Kevin-Kaiyo/open-microled-driver-asic/docs/design.md

# 单像素电路与 PWM：从教学基线到 v0.4 联合信号模型

更新：2026-10-05。当前尺寸为 mirror 20/4 µm、registered PWM。本页解释 synthetic LED 基本回归，同时指向逐级增强的模型：真实静态负载、reference/mismatch、模拟／数字physical、v0.3共同macro top，及v0.4[联合signal PEX](research/joint-pex.md)与[电气边界](research/robustness.md)。分层解释见[研究报告](research/research-report.md)，实物目标见[bench计划](research/bench-validation-plan.md)，方向见[实验方法与研究价值](research/technical-value-market.md)。

基本回归已经建立可重复执行的链：**真实RTL输出 → 电压波形桥接 → pre-layout PDK driver → synthetic LED → 波形与电流积分**。v0.4进一步用共同GDS提取的输出级／像素联合模型检查signal路径。两者仍是feed-forward coupled simulation；模拟结果没有反馈改变RTL状态。“完整链路”表示数字控制确实驱动电路，不表示feedback或双向mixed-signal co-simulation。

## v0.4 为什么用一份联合模型

实际共同GDS中，PWM从模拟macro的M3右侧接入；standalone analog RC的formal `pwm`位于左侧。若继续把右侧跨宏线接到旧左侧cut boundary，可能把同一段metal重复串联。v0.4从真实geometry重新提取末级`output12/buf_2`六MOS及像素六MOS，导出单个`output_pixel_pex`：nominal为12MOS、45 signal R、77显式C、34个邻居端口；另有四种actual RCstyle。

Post只实例化这份joint model，**不再叠加旧buf schematic、SPEF、link RC或analog RC**。输出级实际AD／AS／PD／PS交给MOS model计算junction charge；导体R/C按实际端点及重数记录。重现按端口、数值与拓扑的语义一致性判断，工具排序不同不应伪称字节一致。[提取与投影说明](research/joint-pex.md)保留完整原始网表与ledger。

该模型将所有PG／body电阻及PG-only电容投影到理想VDD/VSS，保留signal↔PG电容。邻居的stiff clamp等截断是实验条件，未包含其完整driver阻抗。因此startup源能量只覆盖声明的selected signal-path十二MOS与外部R/C假设，不是完整芯片供电、well/substrate、decap或preceding logic能量。实reference、真实LED动态／温度、实际PG与邻居仍是进入4×4前的工作。

设计参数以仓库代码为主来源：[`pixel_driver.spice`](../analog/driver/pixel_driver.spice)、[`microled.spice`](../analog/models/microled.spice)、[`pixel_pwm.v`](../rtl/pixel_pwm.v) 和 [`run_phase1.py`](../scripts/run_phase1.py)。当前运行证据见 [`summary.json`](../evidence/phase1/summary.json)，具体条件、检查及工具版本从该文件读取，不由此文档另行维护通过数量。模型适用条件、计算复核和后续研究门槛见 [全面检阅](review/README.md)。

## 教学 baseline 的系统

```mermaid
flowchart LR
    subgraph D[已实现：数字域]
        C[1 MHz clock / reset / duty / enable]
        R[Verilog 1-pixel PWM]
        E[执行 RTL 后的 edge CSV]
        C --> R --> E
    end
    subgraph B[已实现：testbench 桥接]
        P[0 / 3.3 V PWL<br/>10 ns finite edge]
        REF[外部 ideal IREF<br/>100 µA]
        SUP[ideal rails<br/>VLED 5 V / Vlogic 3.3 V]
        E --> P
    end
    subgraph A[已实现：pre-layout analog]
        G[6-MOS pixel cell<br/>GF180MCU 6 V models]
        L[Synthetic MicroLED<br/>diode / Rs / junction charge]
        I[LED branch current<br/>gate / bias / cathode voltage]
        P --> G
        REF --> G
        SUP --> G
        SUP --> L
        G --> L --> I
    end
    M[exact-window integration<br/>checks / CSV / plots / JSON]
    I --> M
```

图中的箭头表达功能依赖，电气 netlist 的电流路径为 `VLED → VSENSE → LED anode → LED cathode → MOUT → ground`。RTL edge timestamp 被保留；桥接在每个 timestamp 开始 10 ns ramp，表示数字输出电压的 testbench 抽象。此 ideal PWL voltage source 具有理想驱动能力，不是已实现的数字输出级；实际 standard-cell buffer、level shifter、IO pad、输出阻抗和电源 impedance 尚未进入该模型。

### 长期概念，尚未实现

```mermaid
flowchart LR
    H[Host] --> F[独立 FPGA controller repo]
    F --> S[独立设计的 serial interface]
    subgraph ASIC[长期 ASIC 目标]
        S --> DEC[Command decoder]
        DEC --> REG[Register bank / pixel memory]
        REG --> PWM[PWM / grayscale / frame timing]
        PWM --> PIX[Pixel driver cells]
        BIAS[On-chip reference / current programming] --> PIX
        DET[Current sense / diagnostics] -.未来反馈.-> REG
        PIX -.未来监测.-> DET
    end
    PIX --> ARR[MicroLED array<br/>1 pixel → 4×4 → 8×8 → 16×16]
```

当前单像素仍没有serial receiver、command decoder、register map、pixel memory、current DAC或阵列扫描。[方向报告](research/technical-value-market.md)中的4×4存储、packet、面积和共享reference只是可复算预算，不能称完成的阵列。后续协议由本项目按实验问题独立定义，记录电气条件、时序、事务语义和register map。FPGA与ASIC保持独立仓库，未来再共同定义接口。

## 1-Pixel 电路：逐器件解释

[`pixel_driver.spice`](../analog/driver/pixel_driver.spice) 使用原始 GF180MCU model 名 `nmos_6p0`、`pmos_6p0`，共六个 MOS。W/L 单位按原始模型以米表达，例如 `10u` 为 10 µm；不要与某些 open_pdks wrapper 的 µm 参数约定混用。模型 commit 和 SHA-256 由 [`pdk-lock.json`](../analog/models/pdk-lock.json) 固定。

| Instance | W / L | 连接与功能 |
|---|---|---|
| `XREF` | 20 µm / 4 µm | drain 与 gate 都接 `bias`，source / bulk 接 ground；diode-connected reference device 将外部 IREF 转成 VGS |
| `XOUT` | 20 µm / 4 µm | drain 接 `led_k`，gate 接 `gate`，source / bulk 接 ground；输出 current sink，与 XREF 构成 nominal 1:1 mirror |
| `XPASS` | 2 µm / 1 µm | gate 由 `pwm` 控制；PWM 高时在 `bias` 与输出 `gate` 之间建立通路 |
| `XCLAMP` | 2 µm / 1 µm | gate 由 `pwm_b` 控制；PWM 低时把输出 `gate` 接到 ground，释放 gate charge |
| `XINV_N` | 2 µm / 1 µm | CMOS inverter 的 NMOS，PWM 高时将 `pwm_b` 拉低 |
| `XINV_P` | 4 µm / 1 µm | CMOS inverter 的 PMOS，source / bulk 接 `vlogic`；PWM 低时将 `pwm_b` 拉到 3.3 V |

`IREF vlogic bias DC 100u` 是 **外部 ideal current source**，由 runner 写入 testbench；不能将其描述成已完成的片上精密电流 reference。默认 `VLED=5 V`、`Vlogic=3.3 V`，ground 也是 ideal。使用 6 V MOS model 不表示已有 6 V digital standard-cell flow，也不代表任意器件端电压和未来 pad 条件均已验证。

PWM off只关闭LED输出支路，当前IREF仍持续取用100µA；按3.3V logic rail计，reference支路供电为**330µW**，尚未计其他支路或数字动态功耗。低LED off current不等于低standby power。本页基本回归从正常DC operating point开始，rails与IREF已建立；v0.4另做[电源／reference初态探针](research/robustness.md)，仍没有实现真实reference generator或供电监测／POR，不能由这些模型探针保证系统安全上电。

PWM 高时，XINV_N 导通、XCLAMP 关断、XPASS 传递 bias，XOUT 导通。PWM 低时，XINV_P 导通、XPASS 关断、XCLAMP 把 gate 拉低，XOUT 关断。只放 XPASS 而没有 clamp 会把输出 gate 留成 charge-storage node，不能保证整个 off interval 内保持关断。

Gate selection 不在 LED 电流路径中串联额外 PWM MOS，因此保留 headroom。它仍会有 inverter delay、短暂 switch overlap、reference droop、charge injection 和 Cgd/Cgs coupling；边沿波形中的 gate、bias、`pwm_b` 与 branch current 应一起检查。实际 pass-transistor 的 bias 传递能力也依赖 `Vlogic - Vbias`、threshold 和 body effect，不能把理想 PWM high 当成完整传递任意 bias 的保证。

### 电流为什么不严格等于 IREF

Simple mirror 是低复杂度 baseline。在匹配器件、饱和区、忽略 channel-length modulation 的近似下，相同 W/L 产生相近电流；真实 PDK model 会反映输出和 reference 的 VDS 不相等等效应。这里没有 cascode、feedback amplifier 或 calibration loop，`IREF=100 µA` 不表示输出一定正好 100 µA。

LED Vf 提高会降低 XOUT 的 VDS：

```text
VDS,out = VLED - Vf(actual current)
```

VDS 足够时，current mirror 对 Vf 变化较不敏感；失去 saturation margin 后，电流会下降。本阶段既保留 5 V 的 Vf sweep，也保留 2.9 / 3.0 / 3.3 V LED supply cases。**2.9 V 是刻意的 headroom negative control**：要求电流明显下降，说明仿真能够暴露 compliance 限制，而不是只挑足够 headroom 的结果。

降低电流时 LED 的实际 Vf 也跟着改变；“synthetic Vf=2.8 V”表示在规定 reference current 上的锚定值，不能在低供电案例中把 LED 当成永远固定 2.8 V 的 voltage source。结果里的 `on_led_vf_v` 和 `on_vds_v` 给出实际工作点。

## Synthetic MicroLED 电气模型

[`microled.spice`](../analog/models/microled.spice) 使用 SPICE diode 模型。它包含 exponential I-V、串联电阻、junction charge 和 transit-time 假设；**没有拟合真实 MicroLED，也没有定义颜色、尺寸、current density 或 optical efficiency**。

| 参数 | 值 / 主来源 | 含义与限制 |
|---|---|---|
| `N` | 3 | synthetic ideality factor；教育和数值建模假设，不是器件物理提取结果 |
| `RS` | 50 Ω | 电气串联压降；没有独立 package / bond / array routing 参数 |
| `CJO` | 2 pF | 零偏置 junction-capacitance 参数；不能称 forward-bias capacitance 恒为 2 pF |
| `VJ`, `M` | 2.5 V、0.33 | junction-capacitance 模型参数 |
| `TT` | 1 ns | SPICE charge-storage / transit-time 参数，不是已验证的光学 rise time |
| `EG` | 2.6 eV | 温度方程的 synthetic 参数；未验证实际材料或颜色 |
| `TNOM` | 27 °C | diode nominal-temperature 定义 |
| `IS` | runner 的 `led_is(vf)` | 为目标 Vf 计算，每个 synthetic variant 可不同 |

在 27 °C、100 µA 上，用以下关系锚定 Vf：

```text
VT = (k/q) × 300.15 K
IS = 100 µA / expm1[(Vf_target - 100 µA × 50 Ω) / (3 × VT)]
```

默认 target Vf 为 2.8 V，另外设置 2.4 V 和 3.2 V。`calibrate_led()` 先用 **独立 100 µA DC source、无需 mirror 的 testbench**，检查 simulator 实际解出的 Vf 是否与目标一致；0.1 mV 是这一数值校准的容差。该检查能发现模型解析、极小 IS 或数值限制导致的意外结果；它不是对实物样品的 calibration。

之后在完整 driver 中检查 full-on 的实际 Vf，避免仅凭输入标签推断 LED 工作点。27 °C 的单点校准没有验证完整 I-V、reverse leakage、breakdown、自热、aging 或温度响应；0 °C / 85 °C cases 是这组 synthetic 参数下的观察，不能当成真实 MicroLED 的温度预测。

## PWM 时序与测量定义

[`pixel_pwm.v`](../rtl/pixel_pwm.v) 的 8-bit counter 每帧覆盖 256 个 clock slot。`duty[8:0]` 表示高电平 slot 数，合法值 0–256，因此有 **257 个有效 duty 状态**；增加第九位是为了表示 exact full-on，不是 9-bit 灰阶。257–511 饱和到 256。

| 请求 | 结果 |
|---|---|
| `duty=0` | exact off |
| `duty=1` | 一帧 1 个高电平 slot |
| `duty=64 / 128 / 192` | duty 25% / 50% / 75% |
| `duty=255` | 255/256，保留 1 个 off slot |
| `duty=256` | exact full-on；不会在 frame boundary 人为产生 low pulse |
| `enable=0` | 在下一个 frame boundary 提交整帧 off |

默认 clock 是 1 MHz，frame period 为 256 µs，PWM frequency 为 3906.25 Hz。`duty`、`enable` 只在 frame boundary 锁存；输入帧中变化不截断当前脉冲。`rst` 为高有效同步 reset，下一 rising edge 将输出清零；释放后的第一个 rising edge 从 slot 0 开始完整新帧。输入属于同一个 clock domain，尚未实现异步 interface 的 CDC / handshake。完整时序说明在 [`pwm.md`](pwm.md)。

v0.2 的 PWM 已改为 output flip-flop 驱动。普通 slot 注册 `next_counter < active_duty`，frame 边界注册新输入对应的 slot 0，保持原有 frame 时序。这样把 counter/comparator 路径隔在 D-input，减少组合路径直接驱动像素的毛刺风险；D-input 的 setup/hold 仍需实际 STA。exhaustive RTL、GF180 mapped gate simulation 与输出结构检查已通过，详见 [digital](digital/README.md)；实际 CTS/routing、STA 和 SDF 的范围另见 [physical](digital/physical.md)。基本 coupled regression 的 PWL 仍来自实际 RTL，10 ns slew 是电气桥接假设。

RTL testbench 实际执行后导出 `time_ns,pwm` event CSV。第一条已知输出来自 500 ns 的 reset low；桥接将该已知 low 向前延伸到 SPICE 的 0 ns，是明确的 startup assumption。之后每个切换时刻来自 RTL，Python 不另算一套理想 PWM 替代它。10 ns PWL slew 只描述桥接电压，不是数字 cell timing 的测量。

第一帧从 2500 ns 开始。跳过两帧后，测量区间严格取 **514.5–1538.5 µs，四个完整 frame**：

```text
Iavg = integral(Ibranch(t), t_start, t_end) / (t_end - t_start)
```

Runner 对 adaptive timestep 数据在边界插值，再做 trapezoidal integration；不能对样本直接取算术平均。它同时核对 testbench 报告的 frame timing 和测量窗口，避免版本变化后测量只覆盖半帧或 startup。默认 maximum timestep 为 200 ns；最小非零 duty 和 25% duty 另外与 20 ns 比较 **average-current convergence**。这不能推广为所有边沿峰值、全部角点或 PEX 都已收敛。

## Branch current 与 optical brightness

电流通过 zero-volt `VSENSE` 的 branch current 读取。它含 diode 的 conduction 与 charge/displacement 成分；有限边沿可能出现短暂 overshoot 或负电流。`peak_branch_current_uA` 和 `minimum_branch_current_uA` 是电气量，不是光强峰值。当前 runner 没有把 conduction current 从 total branch current 单独分解。

独立数值检阅支持当前 frame 平均电流的计算与稳定性，但发现小纹波随积分方法、容差和步长改变；尚不能把 peak / ripple 解释成已收敛的物理指标，也不能据此推出 bandwidth。约 3.6 pA 的 nominal off current 同样明显依赖 GMIN，应仅保留为指定数值设置下的结果；真实器件 leakage 仍未确认，详见 [数值检阅](review/numeric-audit.md)。

`on_plateau_current_uA` 使用窗口内的 on-state 样本，并排除每个 PWM edge 后 100 ns 后取 median；它帮助解释 pulse amplitude，但不能把 plateau 值代替整个 frame 积分。公开波形 CSV 的 uniform sample view 是插值后的 derived view；边沿 CSV 保留 solver 数据，完整原始输出和 testbench 保留在重新生成的 build 目录。

平均 branch current 目前仅作为 **electrical brightness proxy**。在固定 pulse amplitude、充分 settle、off leakage 很小、光电效率近似不变时，才预期相对亮度随 duty 近似线性。项目没有 optical power / EQE / spectrum / photometric measurement，因此不能把图中的电流称为真实 luminance、cd/m²、optical efficiency 或 gamma calibration。

PWM linearity check 对照的是 `measured duty × measured full-on average`，**不是** `duty × ideal 100 µA`。它证明本模型条件下的调制关系，不证明 reference accuracy。Vf regulation 和 off-current thresholds 是本阶段教育性验收标准；精确判据见 runner 与 summary，不是商业精度规格。

同理，pre/post-layout 电流变化很小，不能代替对 100 µA 目标的绝对误差检查；reference 偏差、输出 VDS、模型和 mismatch 都需要分别评估。当前 paired transient 同时包含 diffusion area / perimeter 参数变化与 wire RC 的影响，不能将全部差异归为布线寄生；评估纯 wire RC 时应先对齐两套网表的 diffusion geometry。

## 证据与尚未完成的步骤

[`evidence/phase1/summary.json`](../evidence/phase1/summary.json) 是当前 compact evidence 入口，记录 host、工具版本、PDK lock、LED 校准、case conditions、检查和结果；[`source-hashes.json`](../evidence/phase1/source-hashes.json) 将运行证据关联到源文件。结果可以结合 [`waveforms.png`](../evidence/phase1/waveforms.png)、[`duty-current.png`](../evidence/phase1/duty-current.png) 和 [`vf-current.png`](../evidence/phase1/vf-current.png) 解释。修改源文件后应重新执行验证并生成匹配证据。

本页 Phase1 baseline 证据是 **RTL + pre-layout PDK transistor simulation**；其 FF / SS 和 0 °C / 85 °C 是少量 pilot cases，统计开关关闭。独立 v0.2 研究另做了1080点 reference/PVT 与五组各256 actual RC Monte Carlo，见 [matching](research/reference-and-matching.md)。这两组证据不可混算，也不能把条件样本称为 full signoff 或 manufacturing yield。

六MOS cell已有独立analog layout／GDS／严格DRC-LVS／RC与配对仿真，见[physical summary](../evidence/layout/summary.json)。完整PDK用于配对，避免model subset与抽取结果混算。数字macro见[digital physical](digital/physical.md)；v0.3共同top的PWM／PG routing、full-GDS LVS与所声明physical checks保留原证据。v0.4增加actual output-stage junction与联合signal RC，仍没有完整PG／邻居驱动网络、pad ring／ESD／package或实物测量。真实LED公开静态曲线不建立动态／温度／光学模型；双向feedback仍需current sense／comparator改变后续RTL状态，本次replay未建立。

公开调研和 baseline trade-offs 另见 [`driver-evidence.md`](research/driver-evidence.md)；PDK 与工具选择另见 [`pdk-and-tools.md`](research/pdk-and-tools.md)。
