Kevin-Kaiyo/open-microled-driver-asic/evidence/reference-v2-audit/independent-design-review.md

# 参考源 V2 独立设计评审（中途快照）

评审日期：2026-10-24。只读审查对象为当前新目录中的 NRZ 19 MOS 参考/供电模块、首轮实际 RC、PWM 严格启动诊断。结论对应当前快照，不是最终实现验收。未修改电气或版图代理的源文件。

## 1. 首要结论：当前 AC 相位数字不能作为稳定性通过证据

`evidence/nrz-reference-v2/ac-base-r1.json` 的单电压串联注入在 TT DATA=0/1 得到不一致的低频相位分支：LDO 为约 +179.8° / −0.44°，VI 也出现同类现象。当前脚本直接以 `180 + unwrap(phase)` 报出约 357° 等数值，不具备可直接解释的相位裕量意义。

独立验证只执行四个小型 AC deck，保持原实际 RC、同一工作点/全部外部 R/C、另一个环路闭合。路径为 `build/reference-v2-audit/tian-r1/`；执行脚本保留于 `evidence/reference-v2-audit/tian-review-diagnostic.py`。这是诊断，不是所选电路的回归。

两次注入使用以下定义（必须保留方向，不能只抄公式）：

- 电压：`VLOOP regfbamp regfb DC 0 AC 1`；`Tv = -V(regfb)/V(regfbamp)`。
- 电流：`VRETURN inject regfb 0`，`VFORWARD inject regfbamp 0`，`IINJECT 0 inject DC 0 AC 1`；`Ti = I(VRETURN)/I(VFORWARD)`。
- 双注入返回比：`T = (Tv*Ti - 1)/(Tv + Ti + 2)`。

| 条件 | 双注入低频 T（1 Hz） | 首次降穿 0 dB | 交越处展开相位 | 与原单电压结果相比 |
|---|---:|---:|---:|---|
| TT / DATA=0 | −2749.45 + j8.60 | 36.162 kHz | +177.055° | 原约 20.9 MHz 二次升穿消失 |
| TT / DATA=1 | +13725.86 − j105.47 | 29.763 kHz | −179.589° | 原约 20.9 MHz 二次升穿消失 |

因此，高频第二交越确有注入端加载影响；但低频符号异常没有被双注入消除。不得把“改用 Tian”写成问题已经解决。还需检查原工作点对应的局部导数、另一个闭环影响以及 ngspice 的 AC 重新求工作点/gmin 路径。建议断开反馈输入，保留返回分压对 VREG 的真实负载，以原反馈电压及 ±1 µV 的固定输入比较 `dVREG/dVinput`，并保存源电流与工作点差异；需要对 PVT/两种负载验证稳定性。

## 2. Cc 增大不是已验证修复

`ldo-compensation-30p.json` 已显示：仅将 LDO 补偿 3 pF 改为 30 pF，100 µs 启动 VREG 峰值约 4.111 V、末值约 3.901 V；比 3 pF 反例更差。它证明当前单变量改动不满足条件，不能证明该电路只需“再增大电容”。

按原理图极性分析：REGFB 增高使对应 PMOS 差分支路电流减小，LN2 下降，第二级 NMOS 下拉变弱，LCTRL 上升，PMOS pass 电流减小；预期为负反馈。必须以工作点/导数检验确认这一推理。输入级高阻节点、第二级二极管 PMOS 负载、pass 管、10 nF 外部输出电容和两环路耦合都参与动态过程。不能单凭“有 Miller 电容”认定补偿正确，也不能在当前 AC 异常未解释前报可靠相位裕量。

## 3. 真实版图供电电阻应作为主要设计问题处理

`evidence/reference-v2-layout/nrz-summary.json` 中，VIN 端口到最远器件端的电阻约 182.86 Ω，VSS 约 171.47 Ω。外部 VIN 的 0.25 Ω 不是器件处的完整供电阻抗。

这些电阻来自实际导出网络，不能为美化结果删掉。需由物理代理辨认金属、接触、扩散或回流占比，在真实 GDS 中改善供电/体接触与路径；然后重新 DRC/LVS/PEX，并以新提取重新比较电流、启动和功耗。当前证据能说明网络导出一致，不能单独证明电源网络合理或 EM/IR 签核。

## 4. 启动钳位不等于 ready/POR

`clamp-dc-r1.json` 的三 MOS 候选中，BIAS 达到已释放状态 90% 对应 VREG：TT≈2.10 V、SS≈2.14 V、FF≈1.99 V；上/下扫一致，没有设计好的迟滞。释放电压明显早于 3.3 V 稳压输出进入 ±2% 窗口，故只能称“阈值钳位候选”，不能称“电源已准备好”。

后续至少需确认：释放后的 VI 电流尖峰、慢供电上升、VREG 阈值附近扰动、VIN 掉电但 10 nF 仍储电的快速重启、晚到的外部参考。特别是 VREG 残留电压可能使钳位保持释放，而参考环路已重新启动。现有 DC 上下扫不足以关闭这个问题。

## 5. 功耗与架构选择

同 W/L 的 LPLOAD 与 LPREG 会使控制支路电流与 pass 支路电流同量级，这是首轮 VIN 约 0.30–0.47 mA 静态取能的重要机制之一。需要用实际支路电流确认贡献，不能把新真实参考/供电能耗与旧理想 VDUMMY 的能耗直接混称“驱动器效率没有变化”。

外部 2.5 V 锚仍是独立端口模型；其端口功率已经可以积分，内部静态电流/上游损耗仍须单列。`25 µA ≈ 0.5 V / 20 kΩ` 只建立参考支路，LED 最终精度还取决于镜像、compliance、寄生压降、负载/温度和器件失配。

可供团队权衡的后备架构（**未仿真，不是推荐成品**）：电流转向的 dummy 支路主要需要足够且有界的 compliance，未必必须由独立 3.3 V LDO 供电。若原 3.3 V、28 kΩ 在 75 µA 时得到约 1.2 V dummy，可研究直接从真实 5 V 输入经约 50.7 kΩ 形成相近导通电平。这样改变供电电路而不改变 MicroLED/RX；但 DATA=1 时 dummy 可能接近 5 V，必须重测各 MOS 端压、开关瞬态、PVT、电阻容差和供电扰动。不得以这条推理替代仿真。

## 6. PWM 数值收敛边界

当前 `startup_diagnostic_strict_r10_fullmesh.json` 在 10 Ω 有限 GPIO 输出阻抗、原完整局部网格、严格容差下完成 40 µs；保持电流峰值约 20.62 pA、恢复约 100.913 µA。这是有价值的真实输入边界修正证据。

但它不是单独的“数值闭合”：仍需同一 10 Ω 物理电路在独立积分阶次/网格下满足已声明的电流/电荷一致性。不能拿有限阻抗案例与理想源案例的差异当求解器误差，也不能把原 `vpermit#branch` 错误节点当作根因已证明。原失败发生在 PERMIT 恒为零的早期，必须保留。

供电前馈 60 pF 和 1000 pF 均应根据同一阶跃、环路响应与峰值/恢复全窗口决定；不改变 MicroLED、PWM 时序或既定研究门槛来通过。受控启动对外部 START/FAULT 序列的依赖必须在报告中可见。

## 7. 证据边界与后续复审入口

- 本次独立审查未完成 NRZ 或 PWM 设计验收。
- 已读取并核对实际模块的证据范围；19 MOS 的 DRC/LVS/PEX 通过不代表整个 ASIC、封装、pad/ESD 或光学链路通过。
- 此次新 AC 诊断属于小型只读对照；没有改变任何原案例或代理源文件。
- 最终复审应使用冻结电路、真实最终集成 GDS/PEX、完整矩阵与报告源哈希，重新核对失败统计、功耗边界、相位方法和启动窗口。
