Kevin-Kaiyo/open-microled-driver-asic/docs/superpowers/specs/2026-10-25-fair-driver-v1.md

# A/B/C公平晶体管比较：执行规格

用户已明确要求按既有公平比较合同推进；本规格具体化已授权工作，不重新请求相同批准。基线5950e5816d93ed9f0a7a6b1a2242f3e8deb625c0。暂不预选架构。

## 目标与层次

比较新的SCHEM级A电压输出+真实辅助轨、B真实V-to-I参考+NRZ、C真实译码+三单位电流DAC/PAM4。全部使用同GF180模型与统一结几何估计，不混用旧A/B PEX和新C SCHEM。没有本轮layout/DRC/LVS/PEX或实际光学/硅证据。

- LED冻结：公开Lin2026 yellow20静态I–V、200fF、1Ω/0.5nH；光学代理200ps、接收LPF1GHz。静态曲线温度未知，MOS角落不代表LED热/光性能。
- 输出目标：NRZ25/100µA，C25/50/75/100µA；仅TT27°C名义校准一次，A的RH/RL、B的RSET/WTAIL、C的RSET/WUNIT各两个自由度；C中间档不另调。目标±1%初始DC，角落不得逐点重调。PVT电流目标±5%独立于RX通过。
- 共同端口：VIN5V、VDD3.3V、VREF2.5V，各含声明有限源/封装阻抗及去耦；记录三个电源、D0/D1、DISABLE端口正向/返回/净能量。A不得直接使用理想VH/VL；所有辅助MOS与片外R/C计入。外部RAW/精密基准IC自身损耗及实体Rx不在该端口边界，统一明列而不称完整光链路能耗。
- 统一输入：20ps边沿、有限100Ω数据输出；RIN8µm×1µm PDK电阻为新候选初值，58µm只作单因素控制，原旧证据保留。MOS统一AD/AS=W×0.44µm、PD/PS=2(W+0.44µm)，是原理级估计。
- 公共测试帧：64warm＋512training＋4096validation＋64tail=4736bits；η=4096/4736。净吞吐=4096有用bits/整个测试帧时间。Rline=Rnet/η；NRZ符号率Rline，PAM4为Rline/2。测试帧不是已实现产品协议/FEC。
- C Gray映射D1D0=00/01/11/10→0/1/2/3；T1=D1∨D0,T2=D1,T3=D1∧¬D0由MOS实现，不用理想温度计码源隐藏译码能耗。验证12有向转换、两bit变化和skew。
- RX：NRZ62.5µA单阈值，C37.5/62.5/87.5µA三阈值；以训练段选相位后冻结到验证，最小决策距离7.5µA、最小时序余量100ps；同时保存ps、symbolUI和bitUI。无噪声0/4096不作真实BER。等效电流Gaussian噪声仅条件敏感性，不作测量或误码认证。
- 器件筛查：03v3六端对3.63V、06v0保守6V；体结正偏单列，不用接收通过掩盖应力。启动诊断与正常已建立OP通信分开。

## 矩阵与资源

先完成DC/短瞬态和校准，再冻结输入与计划。净速率0.1/0.25/0.5/1/2Gb/s；TT27°C3.3V、SS125°C2.95V、FF−40°C3.65V，三路线共45基础瞬态。必要的独立电阻/参考容差、供电与C输入skew、数值控制选点另列，不假称全笛卡尔覆盖。失败继续定位并保留修改前版本；更改共同条件须三路线联动回归。

新增压缩raw目标≤2GiB；每次运行保留可用空间≥5GiB。只无损压缩并核对新raw后移除未压缩副本；不动旧数据。按已验证阶段Git/Release回读和小输入恢复规则交付。

## 执行后公开的方法修订（保留上方v1原合同）

原来0.5–2symbol的RX窗口对NRZ/PAM4不是相同绝对时延预算。最终v2改为所有路线0–8ns、5ps，448bits评分＋64bits训练guard，真实激励/η/能量分母不变。对所有原生波形统一重分析而不选取v1/v2较好者；原电路结果、v1算法与v2预跑均保留。详见evidence/fair-driver-v1/rx-equal-latency-v2-contract.md。

存储方案改为保留完整native时间/LED导电电流两列，能量/应力仍用全部native网格；0.5G完整B端口波形独立对照一致。初始300s计算超时只延长到900s，不改电路或精度；空间保护触发后核验并offload已备份旧成功波形、降低并发，未降低5GiB保留门槛。
