Kevin-Kaiyo/open-microled-driver-asic/evidence/driver-methods-20261111/micro-mechanisms.md

# MicroLED A/B：两种不同物理机制的有限对照

本轮保持发光器件 I–V、200 fF 负载电容、1 Ω / 0.5 nH 封装、200 ps 光学一阶响应与 1 GHz 接收器不变。A/B 的 LED 稳态目标均为 25/100 µA，所有候选先通过 ±1% DC 门槛。变化来自驱动器原理图，不来自更换接收判据。

## 1. A：在主开关动作前，补偿输出节点的反向初始跃变

电路新增 `N1 → XRF → FF → CFF → OUT`。XRF 是 PDK 高阻多晶硅电阻，4 µm × 4 µm、约一方；CFF 是 31.275 fF 的理想集总电容。N1 为第一级反相信号，CTRL 为第二级主输出控制信号。原有 20 只 MOS、RH/RL 和真实 VH/VL 供电电路保持不变。

- 数据从 0 变 1，LED 应变亮：N1 先下降，通过 CFF 把 LED 阴极 OUT 向下拉；稍后 CTRL 上升，主输出 NMOS 接通低电位轨。
- 数据从 1 变 0，LED 应变暗：N1 先上升，通过 CFF 把 OUT 向上推；稍后 CTRL 下降，主输出 PMOS 接通高电位轨。
- 串联电阻使电容充放电不再是直接的电压跳变。电容在 DC 时开路，因此两态 DC 目标没有被改变。

原版在变亮前先出现电流下冲、变暗前先出现过冲，与输出 MOS 栅漏耦合导致的反向初始跃变相符。本次没有单独关闭/提取 Cgd，因此不把改善定量归因于某一个寄生参数。可以直接确认的是：增加前馈支路后，原生 OUT 和 LED 电流的初始变化方向变得正确，完整帧电流范围由 17.19–129.89 缩小为 24.58–101.86 µA。

在相同净 1.6 Gb/s 下，时间余量由 216.92 提高到 241.15 ps，幅度余量由 17.49 变为 17.35 µAeq；E+ 从 1.05783 增加到 1.14188 pJ/bit。新增支路消耗数字驱动能量：VDD 端 +0.13541 pJ/bit，VLED 端 −0.05123 pJ/bit。平均导通电流由 64.643 降至 62.944 µA；保持的是 DC 电流目标，并非逐帧平均光子数。

以连续四个相同比特后的示意边沿为例，0→1 前 200 ps，电容 FF 极板电荷变化约 −67.62 fC；1→0 前 200 ps，约 +50.43 fC。它们与 `CLED × ΔVOUT ≈ 200 fF × 0.4 V = 80 fC` 在同一数量级。这里的电荷主要用于节点充放电，不能把它全部当成 LED 导通电流，更不能当成光子数。电荷由 `Q=CFF(VFF−VOUT)` 从原生节点数据计算；没有把数值微分的尖峰当成已验证峰值电流。

整帧 CFF 储能从 0.02373538 变为 0.02348003 pJ，变化 −0.00025535 pJ，折合 −6.23×10⁻⁸ pJ/bit。该数值远小于供能源端的变化；这只是新增 CFF 的储能审计，不代表完成全电路储能审计。

## 2. B：降低参考源和虚支路电源，同时保留顺应电压

原版 VIN=5 V，给晶体管级参考源与虚支路供电；VDD=3.3 V 负责逻辑，VLED=5 V 给发光支路。参考源仍需要外部 VREF=2.5 V，且 VREF 端能量已计入七源边界；没有新增片上带隙或把它宣称为完全自给式基准。新候选仅把 VIN 降为 3.3 V，并将理想集总虚负载电阻 RDUMMY 从 50 kΩ 改为 27.6 kΩ。仍保留两个独立的 VIN/VDD 源及各自原有 R/L/C 供电网络；没有因为电压相同就声称两条物理电源已经合并。

电阻调整来自顺应电压预算：虚支路约 75 µA，目标 DUMMY 约 1.23 V，故 `R≈(3.3−1.23)V/75µA≈27.6kΩ`。模拟得到低电平 DUMMY=1.2256 V、VX=1.0362 V、虚支路约75.16 µA，接近原版的 DUMMY=1.2397 V、VX=1.0476 V、75.20 µA。

为了区分供电与虚支路的作用，保留了只降 VIN、RDUMMY 仍为 50 kΩ 的单因素控制。它的 LED DC 两态仍达标，但低电平 DUMMY=0.3140 V、VX=0.2335 V，虚支路只有约59.72 µA，说明 LED DC 达标并不等于内部电流转向工作点正确。

| 净 1.6 Gb/s | E+ pJ/bit | 时间余量 ps | 高于时间门槛 ps | 峰值电流 µA |
|---|---:|---:|---:|---:|
| 原版 5 V / 50 kΩ | 1.09443 | 233.01 | 33.01 | 112.32 |
| 只降压 3.3 V / 50 kΩ | 0.84394 | 201.88 | 1.88 | 123.90 |
| 降压并匹配 3.3 V / 27.6 kΩ | 0.84759 | 229.80 | 29.80 | 113.36 |

主要节能来自 VIN 端，正向能量从 0.54628 降到 0.29871 pJ/bit。调整 RDUMMY 仅比只降压控制增加约0.00365 pJ/bit，却恢复约27.93 ps时间余量并抑制过冲。新候选的平均导通电流65.028 µA，原版64.676 µA；该小幅变化也已保留。

源端节能还要与电源实现分开看。以下只是由已测源端能量推算的敏感性示例，不是新增仿真或整机测量：若新增3.3 V VIN由现有5 V经过理想零静态电流LDO产生，其上游支路能量约为`0.29871×5/3.3`，总比较量从0.84759变为约1.00147 pJ/bit，较原版节省由22.55%缩小到约8.49%。若这条支路的转换效率假设为90%，对应比较量约0.88078 pJ/bit、节省19.52%。真实转换器静态电流、其他电源损耗、共享供电耦合和温度尚未验证。

在净2.0 Gb/s，低压 B 出现零错误但时间余量不足：157.52 ps <160 ps，E+=0.74203 pJ/bit。这是功耗与速率/余量的真实取舍；不能把失败点的 pJ/bit 当成已实现的可靠有效吞吐。需要最高已测试名义速度时仍应保留旧5 V候选；低压版用于较低速度的节能工作点。后续未继续扫描 VIN。

## 3. 验证与证据边界

固定候选的验证收束如下；“最高”仅指本次离散测试点与给定仿真条件，不是连续频率扫描的物理极限。

| 候选 | 最高开发帧通过点 | 下一已测失败点 | S80 | 新留出片段 |
|---|---:|---:|---|---|
| A 阻尼前馈 | 2.0 Gb/s | 2.4 Gb/s | 2.0通过 | 2.0通过：161.577 ps、10.036 µAeq |
| B 低压并匹配虚支路 | 1.8 Gb/s | 2.0 Gb/s | 1.8通过 | 1.8通过：190.812 ps、16.712 µAeq |

A 2.0的留出时间余量只比160 ps门槛多1.577 ps，因此仍是边界点；不能靠数值步长收敛就称产品余量充分。低压B 1.8在留出中比177.778 ps门槛多13.034 ps，也尚未经历PVT或PEX。

3.2 Gb/s目标诊断显示两种不同限制：A新候选完整接收650/4096错误，电气-only虽然零错误，但时间95.432 ps低于100 ps门槛，幅度仅12.029 µAeq；旧A电气-only曾有111.278 ps与24.015 µAeq。因此该前馈不是全频段提升：在低于2.0 Gb/s的改善，并未延伸到3.2，新增负载与脉冲整形的高频取舍需要重新设计；本次未将这两项贡献独立分离。B低压新候选在3.2完整接收259错，而电气-only仍以120.193 ps、29.550 µAeq通过，主要失败在加入既定光学/RX响应后出现。

两个3.2失败点的E+分别为A 0.81778、B 0.57682 pJ/尝试净载荷bit，不能把这些数当成成功实现3.2 Gb/s的能效。A的新方法有较低瞬态LED峰值与2.0以内的时序收益，也有高频电气余量变差与同速能耗增加；B降压法有同速节能，也失去原版5 V时2.0的名义通过点。应该保留按目标工作点选择的方法集合，而不是把本轮任一候选当成所有条件下的赢家。

“这帧没有错位”不是选型的充分依据。本轮 B 只降压控制在1.6 Gb/s没有错误，却只比时间门槛多1.88 ps；调好虚支路后几乎相同能量可以得到多约28 ps余量。A在2.4 Gb/s也没有错误，但幅度和时间均未过预定门槛。因此应在相同净吞吐下同时比较源端能量、幅度/时间余量、峰值/体结应力和工作点；不能把短帧零错误直接解释为产品BER很低或结构已经可靠。

- 最新逐帧结果、同点旧基线、正向/回流/净能量、端压与体结筛查、S80 半步长、留出结果和来源 SHA：`micro-summary.json`。不要只看“零错位”；同时检查幅度≥7.5 µAeq、单侧时间≥0.37 line-bit UI、器件/模型域条件。
- 留出为固定电路后的新 PRBS15 片段0x4c2d。对应全周期[27081,31817)，与开发片段[0,4736)和上一阶段留出[16749,21485)不重叠。它不是随机独立 BER 认证。
- 波形与 DC 因果数据：`micro-causal.json`、`micro-edge-extract.csv`。插值仅用于作图，完整接收、应力、能量来自全帧原生点。
- 图：`../../docs/research/driver-methods-20261111/assets/micro-a-waveforms.svg`、`micro-a-ff-nodes.svg`、`micro-b-waveforms.svg`、`micro-energy-by-source.svg`。

本轮都是新的原理图级候选，尚无新布局、DRC/LVS/PEX、启动/关断、PVT、随机失配或硬件测量。31.275 fF 只是与已记录 PDK 标称 MIM 规模对应的理想值，尚未实例化并验证真实 MIM 的电压/温度/工艺角及底板寄生；RDUMMY 仍为理想集总器件，板上或片上实现需要独立确认。A 新前馈与 B 原有 CFF 都可能在主电流源关断后仍传递数据边沿电荷，不能继承独立保护关断的结论。

进入新版图前，需要固定供电与外接/片上元件边界，实例化电阻/电容的实际选项，检查输出与前馈支路的 ESD/过压/独立关断，在相同负载与 RX 下做 PVT、供电扰动和新 PEX 回归。较低电压降低单源能量，并不自动等于系统电源效率提升：上游稳压转换器、接收器、时钟/主机、封装热设计均未计入这里的七源能量边界。
