Kevin-Kaiyo/open-microled-driver-asic/evidence/vcsel-robustness-20261029/independent-review.md

# VCSEL 参考与供电改进：独立数值复核

日期：2026-10-29。当前状态：本轮独立审查已完成。旧 baseline、中间版本、最终 r10 的非连续 NRZ 帧、三角落连续启动接帧、DC、同步启动、能量和确认控制均已复算。20 ns 快速上电端压失败和单电压注入法不能用于稳定性验收的限制均保留。完成审查不等于完成同器件电光校准、稳定性签核、物理实现或 BER 试验。

## 1．保持不变的比较契约

- 净速率 3.2 Gb/s，人工实验帧效率 4096/4736=32/37，NRZ 线路速率 3.7 Gb/s，UI=270.27027 ps，完整帧 1.28 µs。
- 训练评分位 [64,512)，保护 [512,576)，验证 [576,4672)；4096 个验证位不参与采样相位选择。
- v3 源 SHA-256 为 `1f47a36f24379b58fb3094303d17d678e0aba7328ddbd58eb601c7b966e0c962`。遍历 0–8 ns、5 ps 网格；最大化 `min(训练最小幅度距离/7.5 µAeq, 训练最小单侧时间/100 ps)`，完全并列时选最早相位。
- 固定阈值 62.5 µAeq、光学代理、3/7 mA 归一化与 5 GHz 接收极点，不通过修改门槛掩盖偏置错误。
- 功率按每个外部源端口 `−V·I` 计算，分别积分正向、回送与净能量。正向积分对每个原生功率线性段的过零点分割；其“精确”针对该分段线性功率定义，不表示真实连续模拟功率零误差。
- MOS 温度/工艺角变化时，VCSEL I–V/P–I 仍固定为 25°C 图读代理。不能把它称为真实 VCSEL 全温度验证。

## 2．旧结果的独立复算

`audit_recheck.py` 从旧原生波形重算：沿用冻结的物理光学代理，但接收极点的均匀网格递推、NRZ 阈值交叉/训练评分、原生端口功率的三角形面积积分及端子应力独立编写。三角落结果与发布值一致；见 `audit-baseline-recheck.json`。

| 原条件 | 错误/4096 | 最小幅度距离 µAeq | 单侧时间 ps | 正向 pJ/尝试 payload bit | 最大 MOS 端压 V |
|---|---:|---:|---:|---:|---:|
| TT | 0 | 35.07544 | 127.75688 | 8.55485165 | 3.47974164 |
| SS | 2061 | −4.92260 | 0 | 5.52582586 | 3.18254221 |
| FF | 0 | 20.21348 | 115.88695 | 11.95259132 | 3.82156353 |

这些是固定代理和确定性短帧结果。SS 失败点不能凭较小 pJ/bit 被称为更高有效能效；FF 的接收通过不能覆盖端压和负载模型域失败。

## 3．根因应分开表述

旧 SS 的参考电流由 TT 246.786 µA 降到 183.924 µA；高态尾电流由 3.99603 mA 降到 2.49695 mA。高态尾电流/参考比也由 16.1923 降到 13.5759，说明参考下降与输出级顺从电压/有限输出电阻两层均需调查。上述代数分解尚不能单独区分 MOS 角、温度和供电的因果贡献；需实施者的单因素对照。数据见 `audit-baseline-dc.json`。

FF 最大端压出现在 dummy 支路 XDUMP 的 VDB，而非只在缓冲栅端。其 0.35294 ns 峰值为 3.82156 V。旧波形没有直接保存本地 `vlaser` 节点，因此以 `v(vc_k)+V_IV(I_conduction)` 按同一 SPICE 代理逆关系重建，得到 3.6278231 V；从源电压减串联 R/L 压降独立重建得到 3.6278233 V。此时 GN 正在上升，dummy 比本地轨高约 193.74 mV；整个帧重建激光轨仅约 0.51 mV 摆动。这支持局部切换过冲的判断，与开关耦合一致；尚未通过独立实验分解 Cgd 馈通、沟道电荷与换流的贡献，不能指定其中一项为已证实主因。该重建仅解释既定数学模型，不提高 VCSEL 图外工作的物理可信度。见 `audit-ff-peak.json`。

## 4．新确认序列

遍历完整 PRBS15 周期，确认 32767 个非零状态唯一。新 offset16384 对应 seed `0x7B43`；完整窗口 [16384,21120)、验证 [16960,21056)，与此前 offset0、8192、30253 的完整窗口均无周期位置重叠。见 `audit-seed-window.json`。应在电路、模型和接收器冻结后用于确认；这是同一确定性周期的另一窗口，不是随机独立 BER 样本。

## 5．新实现仍须检查

新供电器件与 OTA 的 D/G/S/B 必须纳入应力清单；端口能量应覆盖参考、调节器与输入信号。外部精密 VSET 的引脚供能不等于基准内部静态耗电，未建模部分须明确列出。OP 初始状态的帧通过也不证明上电成功；需要有限斜率供电启动与控制环扰动检查，分别报告建立时间及是否有振荡/过冲。

### r6 启动检查发现的问题（保留为失败证据）

`audit-startup-r6.json` 从原生波形对照同角落、同设定的 DC 目标，同时检查电流、激光轨 VL 和缓冲轨 DR。2 µs 的 TT/FF 电流接近 7 mA，并不代表稳压器已建立：FF 末值 VL=3.60138 V、DR=3.62982 V，分别高于约 2.85 V DC 目标 26.36%/27.36%。TT 的两轨仍高约 14.32%/15.77%。SS 延长到 5 µs 后电流接近 DC，但两轨仍高约 1.83%/4.19%。这些窗口内两轨均没有进入并保持 DC 目标 ±1% 的诊断带。

FF 上电最坏端压 3.629833 V 来自缓冲器 XBN2P 的 VDS/VDB，距 3.63 V 筛查线仅 0.1667 mV。原因与“稳态内部轨已经约 2.85 V”的工作点不同；不能把稳态约 147 mV 余量用于整个上电阶段。当前启动实验数据固定为逻辑 1，不代表在稳压器未建立时已经安全承受 3.7 GBd 连续切换。实现者已收到反馈，需继续检查更长建立过程、补偿/软启动或显式发送使能条件。

上述 ±1%/±5% 是独立复核的诊断量，用于揭示尚未建立的状态；没有将它们追溯伪装为原先已冻结的通过标准。

## 6．新 runner 的 baseline 与 reference-only 对照

新 runner 保持同一 4736-bit 帧、原负载、固定 v3 接收和所有源端口能量。`audit-new-baseline-recheck.json` 确认重新运行的 baseline 复现旧结论，微小数值差不改变判定。`audit-reference-frame-recheck.json` 则从原生波形独立核对 33 个 MOS 的网表库存/端子、电流模型域、接收与六端口能量：

| 仅加入电流伺服 | 错误/4096 | 单侧时间 ps | 正向 pJ/尝试 payload bit | 最大端压 V | 联合筛查 |
|---|---:|---:|---:|---:|---|
| TT | 0 | 129.71785 | 8.61402065 | 3.52804277 | 通过 |
| SS | 0 | 121.36242 | 7.64687411 | 3.18232474 | 通过 |
| FF | 0 | 130.88409 | 9.62384775 | 3.93072786 | 未通过 |

该中间对照支持“参考/电流控制改进消除了本模型下 SS 的电流不足”，同时显示 FF 端压风险没有随电流校准自动消失。通过均指当前端口、原理图、研究代理和固定短帧的条件性筛查。

## 7．r6 稳压中间版本：端压改善不等于联合通过

`audit-regulated-r6-frame-recheck.json` 独立复算完整帧，包含全部新增 MOS、原生极值、七个源端口能量以及固定接收规则。

| r6 regulated | 错误/4096 | 单侧时间 ps | 正向 pJ/尝试 payload bit | 最大端压 V | 联合筛查 |
|---|---:|---:|---:|---:|---|
| TT | 0 | 85.44900 | 8.87265319 | 3.16003390 | 未通过 |
| SS | 0 | 39.06370 | 7.66831830 | 3.04879897 | 未通过 |
| FF | 0 | 109.86444 | 10.00551912 | 3.48445979 | 通过 |

这里的帧从已求出的 DC 工作点开始。TT/SS 时间余量未达 100 ps，即使零观测错误也不通过；FF 的帧筛查通过也不能替代前述实际启动整改。两条供电轨、驱动摆幅、参考电流与高速接收必须联合验证。

## 8．MicroLED 动态证据契约的交叉审查

`audit_microled_contract.py` 不导入提取脚本，直接按 OOXML workbook relationships 读取公开数据 ZIP。5 条曲线各 2001 点与导出 CSV 完全一致，48 行 P–I 完全一致；−3/−6 dB 截止点通过独立线性插值复核。对 `rd || C` 电路直接写节点 KCL，分别求理想电流和有源阻抗电压输入的复数传递函数，与报告的 `rd C`、`(Rs || rd) C` 公式在浮点精度内一致。见 `audit-microled-contract.json`。

新契约明确保留同像素身份、温度、相位、去嵌和大信号响应缺口；200 fF 与 50 Ω 是计算假设，整链 S21 不再次叠加已经计算过的电学和接收极点。本审查未发现需要阻止该证据章节交付的数值问题，但它不建立新的瞬态模型或 3.2 Gb/s 性能。论文文字、测量校准和许可在此仅核对现有来源账本，没有将其称为本审查重新完成的独立测量或全文核验。

## 9．r8 当前可独立确认的 DC 与有限斜率启动

`audit-dc-r8-recheck.json` 核对六个 DC 点的原生数据、sense 电阻电流、支路电流、七源端口功率及源文件哈希。TT/SS/FF 的低态为 2.999752/2.999555/2.999914 mA，高态为 6.999471/6.999021/6.999839 mA。相对目标的最大误差约 0.01482%，**仅代表理想 VSET、理想电阻和关闭失配模型时的环路误差，不是生产芯片精度**。

`audit-startup-r8-recheck.json` 从原生波形独立对照对应 DC，三组同步 100 ns 上电斜坡、逻辑 1 固定、60 µs 窗口通过电流 ±5%、两轨 ±1% 和末 20% 波动的研究筛查：

| 角落 | 电流进入 DC ±5% / µs | 两轨均进入各自 DC ±1% / µs | 启动最坏端压 / V | 距 3.63 V / mV |
|---|---:|---:|---:|---:|
| TT | 0.702 | 38.148 | 3.295727 | 334.273 |
| SS | 1.298 | 0.303 | 2.966287 | 663.713 |
| FF | 0.468 | 15.772 | 3.626759 | 3.241 |

SS 处于 dropout：DC 激光轨约 2.917624 V、缓冲轨约 2.965754 V，未达到 3.10 V 标称调节目标。因此表中的“建立”是达到该供电下实际 DC 状态，不能称为仍保持 3.10 V 稳压。FF 的 3.241 mV 启动余量很薄，也不等于充分可靠性余量。

启动经过 0–2 mA 未校准区，特别是 0–0.4 mA 为负载的人工数值延拓；这里验证控制电路在既定数学负载下能否建立，不是 VCSEL 实物启动规格。没有验证异步 VSET/VREGSET 顺序、自动 POR 或启动期间连续高速数据。连续启动后接完整帧仍待独立复核。

## 10．r8 从 DC 工作点开始的完整帧

`audit-regulated-r8-TT-SS-recheck.json` 与 `audit-regulated-r8-FF-recheck.json` 独立核对全部 MOS 库存/端子、原生负载域、七端口能量和固定 v3 训练/验证。

| r8 regulated | 错误/4096 | 最小幅度 µAeq | 单侧时间 ps | 正向 pJ/尝试 payload bit | 最大端压 V | 联合筛查 |
|---|---:|---:|---:|---:|---:|---|
| TT | 0 | 34.10440 | 130.71961 | 11.16194364 | 3.29959926 | 通过 |
| SS | 0 | 33.20511 | 115.04651 | 9.87352074 | 3.16290052 | 通过 |
| FF | 0 | 33.36931 | 133.56861 | 12.48721287 | 3.48476571 | 通过 |

这一改进有可见能耗代价。TT 相比原 baseline 的 8.55485 pJ/尝试 payload bit 上升至 11.16194；不应把更完整的电流控制和供电成本隐藏在“理想参考”外。SS 原 baseline 不通过，因此不能将其 5.52583 pJ 用作成功传输的有效能效。表中既不是完整收发链路能耗，也不是量产 BER 结论。

## 11．连续启动接帧与供电扰动控制

`audit-continuous-TT-r8-recheck.json` 直接读取完整父仿真轨迹，独立重建 60 µs 之后的帧切片。确认没有 OP 重置、帧长 1.28 µs、帧内原生最大步长约 6.76 ps，精确端点裁切原生功率，另保留 20 ns 前史传播光学和 RX 滤波状态。TT 结果为 0/4096、幅度 34.10164 µAeq、单侧时间 130.73324 ps、11.16179004 pJ/尝试 payload bit、帧最大端压 3.30063343 V，与 OP 初始化对照接近。启动能量另记，没有悄悄摊入或隐藏在该帧数值中。

`audit-control-TT-minus-r8-recheck.json` 确认 **TT −5% 供电扰动仍失败**：源电压从 537.6 ns 开始下降，588.8 ns 到低值，896 ns 开始恢复，947.2 ns 回标称。接收为 0/4096、时间 109.92510 ps、幅度 14.77874 µAeq，端压筛查也通过；但原生峰值电流 7.727009 mA 超过 P–I 可信域 7.5 mA，联合筛查失败。

失败峰在 1035.520 ns 的恢复阶段，此时原始源已为 3.3 V，VL≈3.065814 V、SBASE≈155.956 mV、STAIL≈165.629 mV，两个 sense 电压未回 150 mV 目标。此前约 900 ns 的 VL 仅约 2.514 V。这支持继续检查供电轨大信号欠冲和控制环恢复，不能仅按静态 DC 点宣称供电扰动已经解决。暂不将任一控制环的单独因果贡献视为已证明。

## 12．冻结的 r10 及供电扰动整改

`audit-r10-freeze.json` 确认冻结文件及全部声明源文件哈希。最终改动为激光轨外部输出电容 1→10 nF、对应补偿电阻 10→100 kΩ；没有采用 r9 的参考轨 RC 候选，VCSEL 负载、接收器、3/7 mA 目标和门槛保持不变。`audit-r10-ac-recheck.json` 确认六个实际 AC 网表在移除注入源后精确恢复冻结 r10 网表，并重算所保存的电压比。**后续全交越审查发现该单电压注入比不具备已验证的返回比意义，不能用其首个相角指标作稳定性验收**；该方法限制及完整数据见第 14 节，优先于早期仅列下降交越的描述。

`audit-dc-r10-recheck.json`、`audit-startup-r10-recheck.json` 核对最终六 DC 点与三组同步启动。电流达到各自 DC ±5% 的 TT/SS/FF 时间为 0.692/1.277/0.458 µs；两轨均进入各自 DC ±1% 的最晚时间为 41.334/0.513/15.792 µs。FF 启动最大端压 3.627853 V，距研究筛查线仅 2.147 mV，不能与后续稳态帧余量混用。同步排序、固定数据、人工低电流延拓等边界同前。

四组完整帧控制均经原生接收、功率与端子应力独立复核。`audit-r10-cap-energy-controls.json` 另从原生首末节点电压独立计算八只显式供电/补偿电容的 ΔU：

| r10 控制 | 错误/4096 | 单侧时间 ps | 最小幅度 µAeq | 正向端口 pJ/尝试 payload bit | 显式 ΔU/尝试 payload bit，pJ | 联合筛查 |
|---|---:|---:|---:|---:|---:|---|
| TT −5% 原始供电 | 0 | 127.07072 | 32.46016 | 10.94629203 | −0.192475 | 通过 |
| TT +5% 原始供电 | 0 | 125.35856 | 33.92821 | 11.65606773 | +0.133898 | 通过 |
| SS −2% 原始供电 | 0 | 112.16871 | 31.59091 | 9.81062603 | −0.009912 | 通过 |
| TT −5% + 输出去耦 0.5 nH ESL | 0 | 126.59016 | 32.41488 | 10.94591697 | −0.192506 | 通过 |

负 ΔU 表示电路内的部分既有储能在该窗口释放，正值表示充电。此处仅列显式电容，未覆盖 MOS 内部电荷与负载/封装储能，不是完整能量守恒校验，也没有暗中将其变成所谓“全链路修正能耗”。这是单个 1.28 µs 实验帧，不宣称长期连续多帧稳态。

TT −5% 对照的原生峰值电流由 r8 的 7.727009 降至 r10 的 7.244443 mA；激光轨最低由 2.512404 升至 2.967614 V。供电和补偿改动的组合消除了本次已观测的模型域失败，不由此推断所有频率/幅度供电扰动均已覆盖。`audit-supply-transient-r8.npz` 与 `audit-supply-transient-r10.npz` 保留每 0.5 ns 分箱各通道原生极值、全部全局极值及精确供电折点；只用于可视化，不据降采样数据重算指标。

## 13．r10 最终主帧、确认控制与仍失败的快速上电

最终三角落均经独立接收、原生端口功率、原生负载模型域、73 只 MOS 的 D/G/S/B 库存及应力复核：

| r10 主帧 | 错误/4096 | 最小幅度 µAeq | 单侧时间 ps | 正向端口 pJ/尝试 payload bit | 显式 ΔU/尝试 payload bit，pJ | 最大端压 V |
|---|---:|---:|---:|---:|---:|---:|
| TT | 0 | 34.10528 | 130.72242 | 11.16199677 | −0.038317 | 3.29963621 |
| SS | 0 | 33.20361 | 115.05570 | 9.87394590 | −0.005293 | 3.16290052 |
| FF | 0 | 33.36010 | 133.56213 | 12.48736019 | −0.021065 | 3.48477871 |

SS 的两 sense 电阻共同 +1%、FF 共同 −1% 的完整帧通过，单侧时间分别 113.94396/132.33941 ps。这两个条件不是全面独立电阻失配统计。冻结后的 `0x7B43` 非重叠周期窗口通过，时间 130.77836 ps；原生 UI/80 步长通过，130.72482 ps；光学/RX 网格 1.25 ps 通过，130.36444 ps。网格细化相对名义值约 −0.358 ps，应保留数值变化，不能称结果完全不变。

`audit-r10-cap-energy-index.json` 汇总 11 个非连续实验的完整端口能量和显式电容 ΔU，并绑定其独立复核文件哈希；这些值均来自原生波形，不来自绘图降采样。

**快速上电仍有失败。** `audit-r10-startup-peak-windows.json` 复核两个 0.5 µs 短窗：100 ns 同步供电斜坡、约 50 ps 原生步长时，最坏端压 3.627852634 V，与约 1 ns 步长相差仅 0.406 µV，确认 2.147 mV 薄余量不是粗步伪影；20 ns 更快斜坡时，XBP1 的 VGB 在 20.3155 ns 达到 3.630878890 V，越过 3.63 V 筛查线 0.878890 mV。两条短窗均不用于完整稳态建立验收。后者的端压越线需要保留，不能被主帧或 100 ns 上电通过覆盖。

当前没有实现保证供电斜率/参考排序的自主 POR 或限压措施。允许使用“指定同步 100 ns 上电条件下建立、指定 NRZ/扰动窗口通过”，不允许使用“所有快速上电和真实全温条件均已安全”。

## 14．AC 方法审查：保留全部交越，撤回相位裕量验收含义

`audit-ac-all-crossings.json` 对完整 1 Hz–1 GHz 复数数据逐段检查，未截去高频。原助手只枚举向下穿越 0 dB；最终 r10 六条曲线都还存在向上交越：

| 角落/轨 | 向下交越 MHz | 向上交越 MHz | 向上交越主值相角约 ° |
|---|---:|---:|---:|
| TT / L | 0.101513 | 8.832630 | +94.828 |
| TT / D | 1.227807 | 9.023443 | +100.942 |
| SS / L | 无 | 10.447765 | +81.269 |
| SS / D | 无 | 10.332515 | +81.891 |
| FF / L | 0.854250 | 9.222518 | +100.418 |
| FF / D | 1.956504 | 9.421222 | +106.006 |

1 GHz 处该比值约 +40 dB，相角主值约 +87°。这是需要解释的数据，不能隐藏。现在计算的是 `−Vfb/Vgate`，注入点的一侧是有限阻抗分压器，另一侧是具有电容和反向耦合的 MOS 输入。电压注入近似需要相应阻抗条件；通用电路还需处理反向传输，不能只因节点在低频近似高阻就推断全频成立。[Middlebrook 1975，pp.489/498](https://www.venableinstruments.com/hubfs/Middlebrook_Measurement%20of%20loop%20gain%20in%20feedback%20systems.pdf)、[Tian 等 2001，pp.31–32及两端口方法](https://kenkundert.com/docs/cd2001-01.pdf)。

本审查另给出不需要晶体管仿真的反例：完全移除有源反馈，只保留反馈侧 `Rth` 对交流地、输入侧 `Cin` 对地，以及两侧之间的串联测试源。由超节点 KCL，`Vfb/Rth + s Cin Vgate = 0`，同一测量比仍为 `−Vfb/Vgate = s Rth Cin`。取分压器示意 `Rth=85kΩ||10kΩ≈8.947kΩ`、**仅作反例而非器件提取的** `Cin=2pF`，没有任何有源环路，也会在约 8.894 MHz 向上跨 0 dB。这证明此电压比本身不是一般适用的稳定性量；实际高频形状与电容加载项一致，但本审查未唯一分解实际 MOS 网络中的各项贡献。

因此，先前的 82.44°、136.45°等数值只是在首个下降交越处执行 `180°+相角` 的算术结果，近似的阻抗/单向条件尚未建立，不能称为独立验证的相位裕量。也不能反向由高频上升交越就宣称芯片一定振荡。当前两路电压数据不足以完成 Nyquist 环绕判定或闭环极点证明。

报告建议措辞：**“电压注入曲线用于补偿调试，但尚未得到可用于稳定性判定的返回比。本轮稳定性只保留指定启动和扰动窗口的瞬态证据；下一步需采用验证过的双注入/两端口或器件增益归零方法，并检查全部相关回路、工作点与负载状态。”** 有限瞬态通过仍不等于无条件稳定。

## 15．最终连续轨迹复核与本轮结论

`audit-r10-continuous-index.json` 汇总三组独立复核；每组从未经裁切的父原生波形重新构建帧，核验 60 µs 同步启动后直接接入 4736-bit 帧，期间没有重新求 OP。精确帧端点功率积分、20 ns 滤波前史、帧内原生最大步长、模型域及端子应力均与保存结果吻合。

| 连续启动后 r10 帧 | 错误/4096 | 最小幅度 µAeq | 单侧时间 ps | 正向端口 pJ/尝试 payload bit | 显式 ΔU/尝试 payload bit，pJ | 帧最大端压 V |
|---|---:|---:|---:|---:|---:|---:|
| TT | 0 | 34.11194 | 130.73378 | 11.15936290 | −0.040838 | 3.30235199 |
| SS | 0 | 33.20396 | 115.08041 | 9.87377911 | −0.005197 | 3.16292751 |
| FF | 0 | 33.35621 | 133.56239 | 12.48728565 | −0.021064 | 3.48477994 |

源端能量与显式电容能量逐项列于各角落的 `audit-continuous-*-r10-cap-energy.json`。原 360 s 执行超时保留为执行失败证据；恢复实验延长执行时限并另建 case，未改变电路或电学条件。`audit-r10-stimulus-freeze-check.json` 另外独立重生成 14 组最终实验各 4736 个 PRBS 位，并核对冻结网表；唯一明确电路差分为预先标注的输出去耦 0.5 nH ESL 控制。

本轮可交付的结论是：**在冻结的 25°C VCSEL 图读代理、指定 MOS 角/供电、固定 5 GHz 接收器和人工帧规则下，r10 通过已列 NRZ 主帧、连续启动接帧和供电/电阻/数值确认窗口；旧慢热电流不足与指定供电恢复过冲得到了可复算的改善。** 这一结论有明确端口能耗成本，也不把有限帧零观测错误提升为 BER 资格。

仍需持续研究的三个优先事项是：

1. 修复或在硬件中约束 20 ns 快速上电、参考时序和负向 sense 节点，补上自主保护/使能；当前 100 ns 同步上电通过不能覆盖该失败。
2. 建立可用于稳定性判定的返回比/闭环分析，覆盖真实负载和供电范围；保留高频交越，不能使用首个“PM”算术值签核。
3. 获取同器件复数电学/电光和温度数据，补齐真实参考源内部功耗、长帧/噪声/抖动、器件失配及版图/封装寄生。MicroLED 的新幅频证据也须按正确参考面联合拟合，暂不据这些研究代理预选技术路线。

以上为本轮独立审查的最终状态。历史失败、方法限制和原生证据均予保留。
