Kevin-Kaiyo/open-microled-driver-asic/evidence/reference-v2-audit/review-final.md

# 最终独立复审

2026-10-24。本轮只读工程源、报告和已冻结波形；仅写本审计目录，没有调用
ngspice、占用仿真锁、修改电路或修改验收门槛。物理 123 文件由父级另行
独立复核；本审计不把物理实现者自己的结果当作新的独立物理验收。

**结论：最终 PWM 15 nF 的 27 个选定案例、144 个明确限定复用的 DC 点和
3 个局部 AC 工作点，来源身份与独立数值复算一致；本轮限定判据通过。
NRZ 的 112 DC、11 启动、5 慢响应、10 通信、7 AC 及 6 个 DC 功耗诊断
也已完成独立回读，报告与原始证据一致，但保留 4 个电流精度失败、
early-release 的 ready/03v3 过压失败，以及残余供电重启的体结正偏风险。
这是一轮证据与限定实验的复核完成，不是全条件电气、可靠性或流片签核。**

## 一、冻结 NRZ 数据与来源身份

独立脚本 `review-final-nrz-check.py` 不导入工程 runner/analyzer。它核对
manifest 的全部输入 SHA、计划与实际 case、实际 runner 源字节、deck、日志、
候选 RC 身份、分析器身份及 result 绑定；逐条解压并验证原始波形 SHA/长度，
从波形重新计算电流、六对 MOS 端差、保持、ready、晚期波动和慢时标指标。
机器可读结果为 `review-final-nrz-check.json`。

- 112 + 11 + 5 = **128** 个冻结案例均完成深度压缩回读和来源身份核对。
  runner `3d1c6a296af7dd813540a97aceb20436b2802cdf93f4ae4dbb2949c30d0f5dec`
  与该 manifest 的 `pipeline/run.py` 相等；计划源与冻结 `final_v2.py` 相等。
- 全部使用最终 21-MOS/RIN RC
  `925b0e98ede116b7d3dc0c0f326aa1704fd08b84dd8cabe39cf03ae4ac4f3d6a`。
  不混用 19-MOS LDO、20-MOS 恒定 keeper 或 pre-layout 结果。
- 7 AC 保存的 executed vi_loop 源与冻结 pipeline 相等；三份实际 core/deck/log
  SHA 均匹配，closed core 除空白外与最终 RC 完全一致。独立从电压/电流注入
  原始复数数据重算返回比、全频率升穿/降穿和 OP 差异。AC 保存的是自身
  executed vi_loop 与实际 deck 身份，并未给 helper run.py 另存执行 SHA 字段；
  本审计不将其表述为超出实际留存范围的完整 Python 运行时追踪。
- 通信阶段发生资源预算修订；旧 manifest runner 与新 budget runner 的
  差异没有误称电气改变。最终 10 点、`budget-amendment.json` 与行政中断
  记录的独立复核已完成，见第四节。

## 二、工程判据的独立结果

| 冻结阶段 | 独立复算 | 实际失败 |
|---|---:|---|
| DC | 112/112；器件端压全部通过 | 电流 ±5% 目标 4 项失败 |
| 启动/重启 | 11/11 | early-release 负控同时 ready 和 03v3 过压失败；其余 10 项通过 |
| 慢响应 | 5/5 | 无；采用各转换后 2 µs blanking 的声明窗口 |
| 局部双注入 AC | 7/7 | 均为单次下降交越，未发现漏报上穿 |

DC 电流失败为：

| 条件 | 相对目标误差 |
|---|---:|
| FF，RSET −1%、+100 ppm/°C，bit1 | +5.074739% |
| TT，RSET −5%，bit0 负控制 | +5.840797% |
| TT，RSET −5%，bit1 负控制 | +5.594171% |
| FF 宽容差联合条件，bit1 | +5.246549% |

不能把这四项端压通过写成电流精度通过。名义 TT/SS/FF 的 I0 为
25.15410 / 25.06540 / 25.26136 µA；I1 为 100.39516 / 97.44752 /
103.37196 µA。20 个 precision 选型相关 DC 点误差范围 −3.19556% 至
+3.81115%，均在 ±5% 内。这仍是有限确定性条件，非统计良率或任意联合容差。

正常启动的最大导电峰值 103.83501 µA、最大保持峰值 1.290107 µA；最慢
release-to-last-outside 为 93.5905 ns，最小型号端压余量 0.997903 V。
“last outside” 是最后一个带外采样时刻，不是插值后的精确连续时间交越。
这里明确是非零保持电流与外部 DISABLE 时序合同，不是显示 PWM 的 1 nA
关断要求，也不是自主 POR。

**early-release 最终负控必须完整保留：**anchor 30 µs 才开始，而 20 µs 已
释放 DISABLE；到约 33.52971 µs 才最后离开带外区，释放后延迟 13.52971 µs。
同时提取 MOS `x11`（原 `XC_BASE`）最大栅端差 **4.86194088 V**，相对
03v3 的 3.63 V 项目筛查超出 **1.23194088 V**。提取网表 D/S 对调，因此
该量在提取器命名为 VGS、在原 BASE 对应栅漏差；不可据名称误定位原源端。
峰值电流仍只有 100.39519 µA，进一步证明峰流正常不能替代端压筛查。

局部 AC：TT 约 450.414–450.416 kHz / 72.956°；SS 约
283.489 kHz / 78.335°；FF 约 668.674–668.676 kHz / 66.250°。
FF bit1 加补偿脚 1 Ω/5 nH/0.5 Ω 后约 668.671 kHz / 66.305°。
最大闭环/注入 OP 差约 3.60e−11 V。公式与第二轮审查一致，只支持相应工作点
的 Middlebrook 型局部双注入估计，不升级为 Tian 全多环路或硅上稳定性签核。

## 三、报告与图的发现

1. **需在最终发布前修正：**审计时 NRZ `electrical-notes.md:53` 仍写
   early-release “没有峰流或端压失败”，这是旧阶段结论。最终实际 RC 已有
   上述 ready + 03v3 栅端过压双失败。已立即通知父级；最终文本应区分历史
   pre-layout 控制与实际 21-MOS RC，并更新重启等阶段性数字。
   **核心发现已关闭：**回读该文件第 55–57 行，旧恒定 keeper 无端压失败
   已明确限于 11-MOS pre-layout；最终 21-MOS 的 4.86194 V / 13.5297 µs
   已另列。后续回读确认旧重启 104.355 µA / 85.54 ns 也已明确属于旧
   11-MOS pre-layout 恒定 keeper 阶段，不再与最终 21-MOS 混用。
2. **需同步图像副本：**审计时 PWM `external-network.svg` 与 manifest 已是
   47 nF + 10 Ω 阻尼，而同名 PNG 仍画 100 nF、无 10 Ω。正文引用 SVG，
   当前 SVG 逻辑正确；最终打包需重生 PNG 或明确其历史身份。
   **本阶段已关闭：**父级重新生成后，已只读复核
   `schematic-raster-identity.json` 的全部 7 组 SVG/PNG SHA，均与当前文件
   一致。最终若再次改 SVG，仍需相应刷新这份配对身份。
3. `review-final-figures-check.py/json` 核对 7 份 SVG 与 manifest / 来源
   SHA；另外独立解析 SPICE，核对 NRZ 10 个 VI 器件和总图 7 个核心/保护
   器件的 D/G/S/B 元数据，全部一致。总图省略的四只反相器 MOS明确注明；
   MK 受 DISABLE 控制、RKEEP OUT→KRET、VIN/VDD 分离和 150 pF 板地返回
   均与冻结连接一致。元数据检查不冒充完整图形连接提取，另已目视查看总图。
4. 物理草稿正确区分同一 10-MOS 供电布线对照与不同 19/21-MOS 电路；面积
   使用 macro bounding box，明确外部元件、pad/ESD、衬底场解与片内 bandgap
   未完成。物理通过没有被用于替代电气接受。
5. 早期 PWM 文档曾夹有“固定候选 100 nF”及“最终 47 nF”描述。
   **已关闭：**最终报告明确选定 15 nF，并保留 100 nF 慢角启动失败及
   47 nF 两项恢复超时，诊断图明确标注历史阶段，见第七节。
6. 报告术语统一采用“电压基准”。NRZ 工作记录仍有“电压锚/锚的输出端”，
   已通知作者修正；后续回读确认该两处已关闭。代码中的 `anchor` 和历史
   文件名保持身份不变。

### 汇总生成器补查

只读审查 `scripts/reference_v2_report/summarize_nrz.py`，本次 SHA 为
`5898dcd877d90f5784f4fc83dc40bafbe9cabab582b0f5ad6cda9a666b507f06`。
生成器要求 112/11/5/10 完整记录，独立计算 DC ±5% 误差，不用端压布尔值
代替电流精度；通信计数采用接收/端压联合字段。能量对照使用同 corner、
temperature、VDD，且保留首版 LDO 启动失败身份。旧高电流范围
−8.0553%～+7.7141% 与原结果一致。新正文已明确写 4.862 V、13.53 µs 与
4 个 DC 精度失败。本审计未执行生成器；最终生成报告的独立核对见第六节。

NRZ 预算修订前后的 executed runner 已逐行比较，唯一差异是
`MAX_INCREMENTAL_BYTES` 从 2 GiB 改为 3.5 GiB，未改 deck、模型、接收
判据或数值设置；其正式新执行身份已逐条绑定，见第四节。

## 四、最终 NRZ 通信和功耗独立回读

`review-final-nrz-communication-check.py/json` 不导入工程 runner/analyzer，
不运行 SPICE。10 个 case 均核对计划、实际 executed runner、模型、最终
RC、deck/log、result/analysis 的 SHA；对压缩波形及解压字节 SHA/长度做完整
回读。结果为 **10/10 已完成，缺失 0**。3 条使用原冻结 runner，7 条使用
获准的 3.5 GiB 预算 runner；两份源逐字比较仅预算常数不同。保留的等待锁
行政中断记录与预算修订的 SHA 一致，不混算为电路求解失败。

独立重算包含：两级 PWL 一阶响应、仅用 249 个有效训练位选择固定采样点、
511 位验证、129 点时序诊断、全部 21 MOS 六对端压，以及五个电源和 DATA
端口的实际 `−v(t)i(t)`。正负能量使用各线性区间的三角形/梯形解析面积，
与工程分析器插入零交越的实现分开。所有原始指标与汇总一致；10 条都通过
既有接收与型号端压联合筛查。0/511 是有限确定性观察，不能升级为 BER。

名义 TT/SS/FF 的全端口正向能量分别为 **2.688271 / 2.519358 /
2.917437 pJ/bit**。FF RAW 脉冲行正向/返还/净能量分别为
**786.670185 / 741.947590 / 44.722595 pJ/bit**。该行重复给 100 nF
输入去耦充放电，不能当正常通信能耗；理想源端口的返还也不等于上游可免费
回收。当前汇总生成器对此有明确说明。

FF 数值对照用 trap、80 steps/UI、reltol=2e−6 对比原 Gear、40 steps/UI、
reltol=1e−5，电气连接不变：阈值归一化余量变化 −0.0000858820，时序余量
均为 0.3203125 UI，正向能量相对差约 7.246e−6，均保持 0/511。该有限
对照不证明所有角点和波形的数值误差已有界。

六个功耗诊断的实际 deck 在 `.control` 之前与原名义 DC deck 完全相同，
LED 电流逐点差 0 A；原实例到实际提取 MOS 的映射及 D/S 互换均核对。
源端口电流减去 dummy 得到 VI 总预算，模型通道电流分配后的剩余为
**17.883–34.156 nA（0.0894–0.1708 µW）**，明确留在数据中。
这支持 DC 电源预算分配，不是各 MOS 热耗散，也不代表高速瞬态分支功率。
旧 `power-dc-r1` 的 10 nA 强制闭合假设失败保留，没有修改电路验收条件。

最终 compact 数据发布后，`review-final-summary-check.py/json` 已将全部
**138 条**结果和分析 SHA 与独立 raw 审计记录逐条关联，再核对四阶段摘要
与最终 summary 的所有共享字段。计数为 112 DC、11 启动、5 慢响应、10
通信；4 个电流失败、1 个端压/启动负控失败以及 1 个行政中断均保留。
最新 summary 的 `qualification_limits` 也明确记录 0.746649 V 正向体结边界。

## 五、残余电源重启的体结正向偏置边界

`review-final-body-bias-check.py/json` 独立读取已存 11 条启动波形，按型号
计算有方向的扩散区—体电压：PMOS 为 diffusion−body，NMOS 为
body−diffusion。0.5/0.7 V 仅用作描述性探针，未新增或放宽判据。

11 条中只有残余 LED/基准供电重启出现超过 0.5 V 的正向差。最坏为实际
`x7`，映射到原 `XR_IPD2`：因提取 D/S 互换，它是提取源端、原电路漏端，
在 **21.173660 µs**，扩散区约 **0.749006 V**、nwell 约
**0.002357 V**，正向差 **0.746648765 V**。超过 0.7 V 的已保存样点从
21.035148 µs 到 22.431684 µs；此为样点时间范围，不声称连续交越精度。

因此该重启的“功能和六对绝对端压筛查通过”不能扩写成无体注入、可靠性
闭合、任意掉电安全。这里没有独立量测体电流、注入电荷、衬底扩散或 latch-up，
也不能仅凭电压宣称已经发生击穿或锁存。最终报告应与 early-release 负控
的 03v3 过压分开保留这一风险；该发现已通知父级与电气作者。

## 六、NRZ 当前报告与中文实际版图图复审

按父级明确授权，仅修订 `render_power_comparison.py`、`render_joint.py`
及公共字体辅助脚本的读者说明。两图使用中文，保留 MOS、VIN、VSS、VSET、
IOUT/BIAS、M5 等实际标识；原“copper/vias”改为“金属与通孔”，不据金属
颜色暗示 GF180 的材料。两图均从原 GDS 读取原多边形，没有改几何、电路
或冻结物理摘要。19/21-MOS 的不同电路明确不能作为纯布线面积优化对照。

PNG 与 SVG 使用同一 Noto Sans CJK SC 字体；SVG 字形轮廓化，避免读者系统
缺字。87 / 52 个实际可见文本对象均在画布内，两张 PNG 已目视检查，没有
缺字、裁切或说明覆盖。绘图源、字体、GDS、图像和画布检查身份保存在
`evidence/reference-v2-layout/visuals/presentation-identity.json`。
`nrz-switched-keeper-delivery-manifest.json` 仅更新四个已有视觉条目，并增加
字体辅助脚本依赖；其余原条目 SHA/字节数逐项保持且校验通过。前后修订审计
为 `layout-visual-revision-20261024.json`。

`review-final-nrz-report-visual-check.json` 核对当前正文的 10 条通信表、11
条启动表和 4 个保留 DC 精度失败；引用数据与生成器 SHA 一致。报告显著区分
原功能/绝对端压满足、early-release 过压失败、残余供电重启体结尚未闭合，
并分开正常通信能量与 RAW 脉冲充放电能量。未发现把这些边界隐藏为全通过。

新增体结图与实际映射一致：IN2.t1 为原 IPD2 漏端、提取源端，p+ 为 PN 结
阳极，VIN.t6 的 nwell 为阴极；150 pF 支路是局部等效解释。图中箭头明确
写为可能路径，未当作已经量测的结电流。峰值节点电压与前述独立 raw 审计
完全一致；另从其源 CSV 独立分段线性计算，超过 0.7 V 的时长为
**1.400133973 µs**，和正文一致。该阈值仅描述波形，不是新验收门槛。

体结 PNG 先前“ΔV”缺字的展示项已关闭：最新 PNG 已改为“结压”，目视
确认文字完整。`review-final-report-check.py/json` 核对两个报告全部输入、
图像、完整 Markdown/HTML 及生成器 SHA，均与当前 provenance 一致；
14 组 SVG/PNG 配对身份也全部通过。本审计未修改父级报告源。

## 七、最终 PWM 15 nF 的独立审计

`review-final-pwm-check.py/json` 不导入工程 runner、analyzer 或报告生成器，
未调用 SPICE。它核对不可变 manifest、实际 executed runner、冻结 PDK 输入、
deck/log/result 绑定，并逐条解压验证原始波形 SHA 与字节数。共 **178 份**
raw：27 个最终选定案例、144 个历史 DC 复用案例、4 个历史控制及 3 个
DC 等效对应控制。三个最终 `frozen2` 双注入工作点另行从原始复数表重算。

最终芯片仍为原 39 MOS / 345 R / 288 C 实际 PEX，DUT SHA 为
`d6ebc340c5f2096c43e1358b851d68590fefddbf47b5cc6e746ffc3c12851424`。
变化属于外部网络：100 Ω / 15 nF、N2 到板地 150 pF、引脚 1 Ω/5 nH、
0.5 Ω ESR 与 10 Ω 阻尼，以及 VRAW/VFAULT/VPERMIT 各 10 Ω 输出阻抗。
未新增片内 MOS，未把这些板级器件计入 GDS 或片内 PEX。

27 个最终案例全部完成且满足原声明判据：7 个核心/DC/阶跃/故障/PWM/AC
案例、4 个启动案例、4 个 DC 等效/外部基准控制和 12 个动态容差案例。
其中一般 AC case 的有限数值通过不替代反馈稳定性结论；局部双注入单独列出。
最终 summary SHA 为
`a5300ce2b6e1d7a55ffa000d789d2b8cf3525b45296085b2163d107c5be16049`，
validation SHA 为
`3226fd1e88de301860ee6459c2048a51c3c2a1056654e08d7cf46337f45e4072`。

### 来源与历史排除

最终主执行 runner 为 `dca36f92884d3c6ab335c9b44d2c0a00f7c0dbb0ab63ce992b404b6af301b668`；
启动使用保留的 `72bcca9dadd58ad4cfc9c5c69d1d85450a788aa6cf701c1d6c4ac694270794b2`。
二者差别仅为 CLI 选择/案例调度，建模和分析函数未改变；每个结果均与其
实际 runner 和对应不可变 manifest 绑定，未要求旧结果冒认后来源文件。
局部 AC 的实际 loop.py 及 helper run.py 身份也与冻结记录一致。

两个旧 manifest 索引关联异常原样保留，且均不参与最终验收：
`pcb150_board100n_ac` 和 `startup_diagnostic_strict_r10_gear1_fullmesh`。
实际执行源、deck/log/input 身份仍可核对；后者属于超时诊断记录。
最终 27 个案例及 3 个局部 AC 不包含这两个异常，没有用改写旧身份消除问题。

### 完整窗口与数值一致性

| 指标 | 独立复算 |
|---|---:|
| TT 名义 DC | 99.7335114 µA；−0.266489% |
| TT 10%/10 ns 阶跃，完整 100 µs | 最大偏差 0.74564399%；恢复 2.28456649 µs |
| 12 个动态角落 | 最大偏差 8.87333947%；最长恢复 2.52041558 µs |
| TT Gear2 / trapezoidal 启动保持峰 | 46.387927 / 46.457928 pA |
| FF 快角启动保持峰 | 58.763649 pA |
| SS 慢热启动 30–40 µs 平均 | 96.7972815 µA |
| 独立故障到安全 | 205.776802 ns |
| 故障第一微秒正 / 负电荷 | +0.504896 / −7.363469 pC |
| 最低 PWM 码，258.5–514.5 µs 完整帧 | 99.6332535 pC；相对匹配 DC 电流×1 µs 为 −0.1005258% |

恢复判定使用末尾 5 µs 平均值的 ±0.5% 带，返回最后带外样点之后的第一个
保存点；没有把采样精度升级为连续时间精确交越。TT 前后基线在数值上相等。
故障于 50.125 µs 施加，时钟 47.7 µs 已停止；正负电荷分别积分，未省略
负脉冲或只按脉冲宽度验收最低码。

严格启动完整覆盖 0–40 µs，Gear2 最大步长 2 ns 与 trapezoidal 1 ns；
电源边沿的 0.1 ps PWL 细网格完整性已逐段核对。两方法保持峰差
**0.0700012 pA**、保持电荷最大差 **1.32665e−19 C**、恢复电流相对差
**8.46608e−11**，均满足既定数值一致性预算。阶跃 2 ns/1 ns 对照的极值
相对差 1.04431e−8、正负扰动电荷相对差 4.22339e−7、恢复时刻差
0.84002 ns。没有延长窗口或放宽容差来隐藏历史失败。

这里的 pA 是模拟支路数值，不是 pA 硅片漏电预测。安全、缓冲及 LED 电源
预先建立，仅参考轨按 100 ns 上升；FAULT 在 20 µs 释放、PERMIT 在
21.5 µs 建立。这支持该外部时序合同，不是自主 POR 或任意同时上电安全。
所有 39 MOS 的 234 条六对端差表达式在指定阶跃/故障日志中与冻结端子映射
核对；紧凑 raw 没有保存全部内部节点，因此本审计不声称从波形重新算过
每只 MOS 的端压极值，也不将留存端差峰值当作 foundry 可靠性判定。

### DC 复用与局部 AC 的范围

144 点覆盖 3 MOS 角 × 3 温度 × 16 个独立电阻顶点，独立读取原始 DC
波形后误差范围为 **−4.436141%～+1.985125%**。电容 DC 开路，孤立补偿
串联支路无 DC 电流；名义及两极端 deck 去除这些支路后其余文本完全一致。
重新测得的极值差仅约 −1.69e−14 A / +4.18e−14 A。因而复用有明确等效
依据，但不称为 144 个新的 15 nF 瞬态案例。外部 VSET ±0.2% / 100 Ω
源阻抗两控制为 −4.596651% / +2.187454%，不代表指定商业基准芯片验证。

三个最终局部双注入工作点全部只有一个下降交越、没有漏报上穿：

| 工作点 | 交越频率 | 局部相位裕量 |
|---|---:|---:|
| TT，150 pF / 15 nF / 100 Ω | 158.407829 kHz | 79.261023° |
| SS，165 pF / 16.5 nF / 105 Ω | 86.511422 kHz | 84.059666° |
| FF，135 pF / 13.5 nF / 95 Ω | 244.558303 kHz | 73.645637° |

闭环与注入 OP 最大差约 8.31e−11 V。采用既定 Middlebrook 型双注入关系，
不扩写为 Tian 全多环路或硅上稳定性签核。

### 历史失败和最终报告

独立复算保留 100 nF 慢角启动恢复 **91.7024 µA** 失败，以及 47 nF
SS 快/慢 RC 恢复 **8.056972 / 10.988932 µs** 超时。47 nF 慢角启动
96.7453 µA 虽通过，不抵消其动态失败。报告明确标出 100→47 nF 图属于
历史单因素诊断，最终选型为 15 nF。

`review-final-report-check.py/json` 将正文 15 个显示数值与独立 raw 复算
逐项核对；主表已明确 TT 名义供电、TT 名义恢复和 TT 名义保持窗，避免把
46.458 pA 误作全矩阵最大值。已目视查看最终外部网络、100 µs 阶跃对照、
40 µs 启动及 NRZ 体结 PNG，文字可读且无裁切，图中没有隐藏负脉冲。

## 八、交付状态

本轮独立审计已完成，所有发现的身份、显示数值和图像同步问题均已核对关闭；
工程失败和资格边界继续显式保留。未新增仿真、改写旧电路证据或改变门槛。
审计者停止写入工程和审计输出，无自身 EDA/仿真/审计写入进程继续运行。

`review-final-report-check.json` 记录本次审查时两个报告的完整 provenance
快照；本文件随后更新属于预期的最后依赖变化。父级最终打包应重建报告一次，
使 provenance 绑定本审计最终 SHA。该机械刷新不应修改已冻结电气、物理或
视觉证据，也不需要重新运行仿真矩阵。
