Kevin-Kaiyo/open-microled-driver-asic/evidence/reference-v2-audit/review-round2.md

# 第二轮独立审查：方法、统计窗口与来源身份

2026-10-24；开发中快照，不是最终回归验收。未运行新的 SPICE 仿真，未修改电气/版图代理文件。补充机器可读结果：`review-round2-pwm-identities.json`、`review-round2-crossings.json`。

## 1. 局部双注入公式与名称

现有 `vi_loop.py` 和 PWM `loop.py` 计算：

- 电压注入：`Tv = -V(return)/V(forward)`。
- 电流注入：INJECT 节点向两侧各经 0 V 电流探针，注入源方向为 GND→INJECT；`Ti = I(return_probe)/I(forward_probe)`。
- `T_est = (Tv*Ti - 1)/(Tv + Ti + 2)`。

在上述探针方向下，公式实现一致，可称 **Middlebrook 型局部双注入返回比估计**。不得直接称为“严格 Tian 全多环路稳定性验证”。Tian 等人的原文区分单向与双向传输，并以四个参数构建 Eq. (30)；其环路法也需要能够切断相关返回环的关键导线。本项目的 MOS 内部寄生反馈、供电/体回路并未由单个 SENSE gate 断点全部切断。[原始论文，pp.34–36、Eq.(30)](https://kenkundert.com/docs/cd2001-01.pdf)，DOI 10.1109/101.900125。

第一轮独立诊断目录历史命名 `tian-r1` 和脚本名 `tian-review-diagnostic.py` 仅是旧路径标识；实际执行的是上面的 Tv/Ti 公式，不应根据文件名升级方法证据。既有文件和 SHA 保留不动，本文作为明确勘误。

闭环与注入后的 DC 工作点一致是必要检查，但不是全部小信号极点、反向传输或时变系统稳定性证明。现有相位裕量宜写“该工作点的局部估计”。在 DC 相位不在预期分支、存在多次交越或未知开环右半平面极点时，不能只用 `180 + phase` 判稳定。

## 2. 新 VI 曲线复算

直接读取原 loop.csv，全频范围查找所有升穿和降穿，不运行仿真：

| FF / −40°C / DATA=1 | 降穿频率 | 局部相位裕量估计 | 所有交越 |
|---|---:|---:|---|
| Miller 3 pF | 4.616418 MHz | −0.225684° | 1 次降穿 |
| N2 对地 15 pF | 3.386560 MHz | −3.088569° | 1 次降穿 |
| N2 对地 150 pF | 0.676813 MHz | 66.312870° | 1 次降穿 |

与报告 JSON 一致，未发现被下穿筛选器漏掉的上穿；但源代码目前仅输出下穿，后续建议保留所有交越方向，避免其他条件出现漏报。150 pF 工作点一致性约 1.29e−11 V 支持该次注入没有显著改变所观察 DC 节点。它不替代最终真实 PEX、其他角落/负载、补偿容差和非线性启动验证。

PWM 已有局部曲线同样只有一个降穿。原 PCB150 版本约 79.12° 的局部估计尚未包含新 N2 引脚 1 Ω/5 nH 及 0.5 Ω ESR。评审通知后代理已加入 `--n2rl`；最终应引用新冻结结果，而非沿用旧曲线作为最终封装证据。

## 3. 来源身份：存在两个已知关联异常

本轮快照独立核对了 **180 个 PWM result**：

- 180 个对应 manifest 均存在，manifest 内容 SHA 与 result 记录一致。
- 所有被引用的冻结输入、executed runner 源文件和 testbench 内容 SHA 均匹配。
- 其中 **2 个 result 内的 executed_runner_sha256 与其 manifest 所列 runner 不一致**：

| 案例 | 状态 | case runner 前缀 | manifest runner 前缀 |
|---|---|---|---|
| `startup_diagnostic_strict_r10_gear1_fullmesh` | timeout / 未通过 | `5ca1b92d` | `02a3a3b8` |
| `pcb150_board100n_ac` | 有限 AC 运算通过 | `a76dca9f` | `d0f3225f` |

因此不能只声明“一个失败案例有身份异常”。第二项为通过案例。旧源码、deck 和 raw 尚在，允许诊断但应排除出最终无异常证据集合，或用新身份重跑；不得改写旧 result 使其看起来原本一致。代理已确认保留第二项并在最终 `n2rl_ac` 使用新 immutable manifest。

重建早期 manifest 的精确 SHA 命中说明可以恢复原记录字节，不能单独证明原执行时 runner/index 关联本来正确。`manifest-recovery-audit.json` 的恢复过程与本次关联检查承担不同职责。最终备份还需包含所有实际使用的 executed source、manifest、deck 和 raw；本轮没有重新读取全部大波形验证其内容。

## 4. PWM 统计窗口检查

现有源代码与实际 PWL 一致：

- 启动保持总支路电流检查为 0–20 µs；20–21.5 µs 另外检查 **导电电流**，不等于该段总支路电流已满足 1 nA。
- 恢复用 30–40 µs 平均电流与 100 µA 比较。应表述为这一窗口的恢复结果；峰值和残余振铃需另读全波形/稳定时刻。
- Fault 在 50.125 µs 开始，10 ns 输入沿。关断稳定时间观察到 +3 µs，正负电荷观察前 1 µs，保持电流观察 +1 至 +2 µs。故障释放而时钟仍停的导电电流检查 +3 至 +5 µs。实际 PWL 的 FAULT/PERMIT/RAW 时序符合这些窗口。
- duty=1 电荷使用 258.5–514.5 µs 的完整 256 µs 帧，分母为匹配 DC 电流×1 µs。实际 RAW 的相邻起始沿正是 258.5 和 514.5 µs；未看到截取只保留有利半脉冲的问题。结果是电气支路电荷代理，不能改称测得光学亮度。
- 供电阶跃恢复采用回落沿结束 25.01 µs 起、相对最后 5 µs 平均电流的 ±0.5% 带宽，并检查至完整 100 µs 末端。`settle_s=0` 代表回落后一直在此容差带内，不代表物理电路具有零响应时间。

当前新 N2 引脚模型的启动粗/细网格验证正在执行，不能把旧理想 GPIO 与新有限阻抗的差异当作同电路数值误差。只有最终相同物理条件的独立数值配置才能建立一致性。

## 5. NRZ 启动判定仍需补齐名称/窗口

当前 `direct_raw.analyze_start` 的 `startup_passed` 仅要求全程导电峰值≤125 µA、100 µs 末值 95–105 µA、最后 10 µs 波动<1 µA以及端压筛查。它没有把 DISABLE 释放前漏电、释放后恢复期限纳入这个布尔值。

新增 10 MΩ OUT keeper 是真实 LED 电流路径，不能称“完全关断”。应保存释放前导电峰/均值和释放到稳定的时间，明确 NRZ 自己的保持电流预算；不强行套用显示 PWM 的 1 nA 标准。原 20 µs 启动失败也应继续保留，不能因 100 µs 末值通过而称其已在 20 µs 内完成启动。以上建议已发 NRZ 代理。

DISABLE 为外部 3.3 V GPIO 时序输入；实际预充电、掉电、anchor 晚到及外部控制失序必须分别记录。真实 NMOS 钳位不等于已经实现自主 POR 或掉电检测。最终实际 PEX 证据还未冻结，11 MOS 参考/钳位不能提前按版图通过宣传。

## 6. 最终复审所需资料

最终物理冻结后的所有计划身份、完成/失败/缺失统计、DC 与稳态 NRZ 波形、启动与控制失序负控、数值一致性、补偿/电阻容差、所有实际电源端口能量、最终 GDS/DRC/LVS/PEX 以及完整来源哈希。报告应分别呈现 PWM 与 NRZ，不将一支的通过条件迁移到另一支。

### 代理反馈（本轮结束时，尚未独立复算）

NRZ 代理通知其后续 `clamped-r2` 使用了 **1.8 MΩ keeper**，并从已保存波形量测保持峰约 1.278–1.291 µA；拟在最终计划预声明保持≤2 µA及释放后 2 µs 内进入 95–105 µA并持续。提前释放、晚到 anchor 的负控将按 ready 期限失败保留。本文第5节审查的 10 MΩ 是较早 `clamped-r1` 源码，不能与新版混用；这些反馈数值留待第三轮冻结后的独立验证。
