Kevin-Kaiyo/open-microled-driver-asic/analog/circuits/vcsel_robustness_20261029/engineering-notes.md

# VCSEL 参考与供电实验：电路解释及证据边界

> 历史 r8 阶段说明。当前候选为 r10，见[最终工程说明](../../../evidence/vcsel-robustness-20261029/engineer-notes.md)和[研究报告](../../../docs/research/vcsel-reference-microled-dynamics-20261029/index.html)。下文 r8 数值保留其原条件；AC 方法的稳定性解释已被后续独立审查撤回，不能作为最终验证结论。

本轮只验证晶体管级研究电路，不涉及实测激光器、接收芯片、版图寄生、工艺签核或产品架构选型。输入仍为单通道 NRZ，线速 3.7 GBd，4736 bit 帧中有 4096 bit 人工有效载荷，对应 3.2 Gb/s 净吞吐。

## 参考电流为什么不再直接依赖电阻馈电的二极管 MOS

旧电路中，电源减去二极管连接 MOS 的栅源电压后，剩余电压落在参考电阻上。MOS 的阈值、迁移率、供电及温度变化，都会改变参考电流；输出镜像还受到漏源电压和顺从电压影响。单一镜像尺寸比不能消除两种误差。

新电路使用两条独立源极电阻感测伺服。真实 PMOS 输入两级运放比较源极感测电压与外部 VSET，并驱动实际 NMOS 栅极。误差增加时栅压按负反馈方向改变，使感测电压接近 VSET：

- 基础支路：Ibase ≈ VSET / 50 Ω = 3 mA。
- 调制尾支路：Itail ≈ VSET / 37.5 Ω = 4 mA。
- NRZ 为 1 时，转向管把 Itail 接到 VCSEL 阴极，发光支路约 7 mA；为 0 时，尾电流流入 dummy 电阻支路，VCSEL 保留约 3 mA 基础偏置。

这些近似依赖有限开环增益、输出摆幅和 NMOS 顺从电压。电阻误差直接变成电流误差：一阶近似 ΔI/I ≈ ΔVSET/VSET − ΔR/R。匹配的标称 BSIM 仿真中出现的几十至几百 nA 误差，不能当作硅片绝对精度。运放失调、1/f 噪声、随机失配、实际电阻温漂和外部基准误差尚未统计验证。

早期单级 OTA 的输出摆幅不足；加入第二增益级后基础支路恢复，但 SS 下尾源顺从仍不足。后续把尾管 L 从 1 µm 改为 0.28 µm，并把转向对宽度从 20 µm 增至 40 µm，才使三组标称 DC 电流均接近 3/7 mA。各版失败及网表均保留，不能把这些变化归功于一个笼统的“高精度电流镜”。

## 快冷过压的来源

旧 FF 最大约 3.82156 V 发生在 dummy 节点对应 MOS 的 VDB。该瞬间实际激光供电约 3.62782 V，dummy 高出本地轨约 193.74 mV，并伴随 GN 上升。这支持局部切换过冲、与开关耦合一致的解释；尚未独立分解 Cgd 馈通、沟道电荷及换流贡献，不能指定其中一种为已证实主因。激光供电轨本身并未出现约 0.2 V 的振铃。缓冲器中间节点的过冲还会提高后级 VGS。只限制一个输出节点或只看供电波形都不够。

新电路把激光轨 VL 与缓冲轨 DR 经过各自实际 PMOS 通过管和反馈运放。外部 VREGSET = 3.1 / 9.5 V，85 kΩ / 10 kΩ 分压，目标约 3.10 V。SS 的原始 2.97 V 输入不足以维持 3.10 V，因此明确处于 dropout：DC 激光轨约 2.91762 V，缓冲轨约 2.96575 V。这里没有声称 SS 仍稳压到 3.10 V。

输入源 D/DB 电压仍随原始电源变化。原有 50 Ω 源阻抗之后加入 200 Ω 串联电阻和 2.5 kΩ 下拉，形成实际衰减并计入静态功耗，不假设免费电平转换。高电平引脚耗电约 Vraw² / 2750 Ω；差分 NRZ 中通常有一条为高电平。

## 为什么 r6 被保留为失败版本

r6 把内部轨设为 2.85 V。虽然它消除了稳态 FF 应力超限，却损失了 SS 顺从电压和缓冲速度。完整帧 TT/SS 的固定接收时间余量约 85.45/39.06 ps，低于 100 ps 门槛。此外，静态逻辑上电中，电流可先稳定而两条电源轨尚未建立；FF 30 µs 的激光轨仍有约 0.638 V 峰峰变化。

不能用“电流进入自己的最终值 ±5%”代替启动验证。新的启动验收对照独立 DC 目标：电流 ±5%、两条轨各 ±1%，并检查末段峰峰变化和所有 MOS 的六种端压。

## r8 的补偿和能耗代价

冻结 r8 采用同一组跨角落参数：

- 激光 LDO：Miller 电容 30 pF，串联零点电阻 10 kΩ。
- 缓冲 LDO：Miller 电容 30 pF，串联零点电阻 100 kΩ。
- 两路输出各有 1 nF / 0.1 Ω 去耦和 5 kΩ 最小负载。
- 两个电流伺服的 Miller 电容仍各为 5 pF；基础/尾管和转向尺寸沿用 r6。

恒定逻辑时缓冲器动态负载几乎消失，和约 7 mA 的激光/转向负载不同。最小负载避免缓冲轨仅靠很小分压电流泄放；串联电阻调整 Miller 补偿零点。两路不必使用相同补偿。

历史脚本以反馈 MOS 栅端串联电压注入比 −Vfb/Vfb_test 的第一个下降交越计算 180°+相角，得到 r8 TT 激光/缓冲约 92.84°/79.34°，FF 约 66.85°/74.19°。**后续方法审查已撤回将这些算术量解释为已验证相位裕量的结论**：完整频段还有输入电容加载造成的向上交越，尚未证明该比值满足环路返回比的适用条件。SS dropout 没有下降交越也不能表示稳定。详见[独立审查 §14](../../../evidence/vcsel-robustness-20261029/independent-review.md)；不能据此做 Nyquist、无条件稳定或工艺签核判断。

5 kΩ 最小负载在 3.10 V 时每条耗散约 1.922 mW，两条合计约 3.844 mW。仅这个输出功耗折算到 3.2 Gb/s 就约 1.20 pJ/bit，原始供电端实际代价还包含通过管压差。电流精度与耐压改善有明确能耗代价；后续可以研究受控泄放、动态偏置或更快的通过管驱动，不能把这版作为能耗最优方案。

## 必须保留的边界

1. VSET、VREGSET 是带 100 Ω 源电阻的外部理想精密电压端口，不是已经实现的 bandgap。七个外部端口的正向、回流和净能量全部统计；外部参考芯片内部静态耗电未知，未包含。若外部器件另耗 1 mW，应额外加约 0.3125 pJ/bit。
2. 电阻、电容、封装 R/L 和 VCSEL 曲线代理保持明确理想/简化边界。VCSEL 模型固定 25 °C；SS/FF 是 MOS、电源、仿真温度角，不能声称完整激光器光电温度验证。
3. r8 从零上电至电流和两轨建立的数值检查通过规定的同步斜坡，但 FF 20 ns 快斜坡最大端压约 3.62944 V，仅低于 3.63 V 筛查线约 0.561 mV。该近满额端压出现在参考 OTA 的 VGB，需要下一步限制原始参考电源、验证时序或使用合适耐压器件；不是宽裕的上电耐压设计。
4. 启动会经过 0–2 mA，使用了负载模型低电流人工延拓，所以启动时间不是实测 VCSEL 上电规格。完整通信帧另检查原生电流极值位于 2–7.5 mA 的证据域。
5. 连续启动接帧采用明确的外部 60 µs 等待，尚未实现片上 POR/PGOOD。启动与等待能量 J、通信帧 pJ/bit 分开，不把 60 µs 总能量只除 4096 伪装成通信能效。
6. 0/4096 是有限确定性序列结果，不是实测 BER；输入、VCSEL、光路、接收器、时钟恢复及长时间数据负载仍需扩大验证。最终网表没有新版图/DRC/LVS/PEX。
