Kevin-Kaiyo/open-microled-driver-asic/docs/research/nrz-b-reference-power-20261024/architecture.md

## 从数据到光：本轮改的是偏置与供电

数据通路仍然是 **DATA → 反相器及缓冲 → 两只转向 MOS → LED / dummy 支路**。尾电流决定高、低电平的差，基础电流使 LED 在低电平时仍有电流。数据每 2 ns 换一位，这是本轮的 0.5 Gb/s 测试点；不是 PWM 显示的灰度周期。

本轮保持 Lin 等 2026 年公开数据中的 20 µm 方形黄色 InGaN MicroLED 静态 I–V 曲线（Zenodo `10.5281/zenodo.20034288`，`I-V.xlsx` 的 Sheet1 A3:B102）。其测量温度未注明；100 µA 附近约 3.77 V。200 fF 电容、200 ps 光学一阶时间常数和接收器仍是另行声明的假设。SS/125°C、FF/−40°C 是所扫 MOS/电路条件，不能据此声称已验证该 LED 的温度相关光电性能。启动时低于首个实测点的模型延伸也不当作测量证据。

参考源不需要逐位跟随数据。它要在较慢时间尺度上稳定电流，并在启动、供电变化和温度改变时保持受控。稳压器同样不能用“一个微秒内接收正确”证明稳定：输出电容和反馈环路的变化可以持续几十至几百微秒。因此本轮把通信测试与长时间启动、负载阶跃测试分开，分别判定。

通信窗口从已经建立的工作点运行；100 µs 启动测试使用固定数据电平。两者通过不等于已经在同一条全晶体管波形中验证“上电→第一包数据→接收重新训练”，该联动应随实际 ready 控制一起补齐。

### 1. 电压基准如何变成参考电流

外部 2.5 V 精密电压输入经过 200 kΩ / 50 kΩ 分压，得到约 0.5 V 的 VSET。误差放大器比较 VSET 与 SENSE，调节 PMOS IPREG 的栅极，使 RSET 上的电压逼近 VSET。

> ISET ≈ VSENSE / RSET ≈ 0.5 V / 20 kΩ = 25 µA。

这里的 25 µA 是设计目标，不是写进理想电流源的保证。差分对失调、有限环路增益、RSET 误差都会改变它。IPOUT 与 IPREG 同尺寸、同栅极，把电流送到原 B 核心的 BIAS 二极管连接 MOS；两支路漏源电压不同，又会产生镜像误差。之后原核心再按镜像比例建立基础电流和转向电流。**稳定了 ISET，也必须重新测量 LED 的实际高低电流。**

<figure><a href="figures/vi-servo-selected.svg">参考电流反馈及镜像的十只 MOS 原理图</a><figcaption>选定电路的 10 MOS 电流参考部分。器件连接、W/L 与源网表逐只对应；新增两只保护 MOS 在前面的总图展开。图中同名网络相连，PMOS 体端接 VIN，NMOS 体端接 VSS。</figcaption></figure>

正常负反馈可以逐步理解：SENSE 升高 → 右侧 PMOS 输入支路电流减小 → IN2 降低 → INSTAGE 下拉减弱 → ICTRL 升高 → IPREG 的 VSG 减小 → 电流下降。这个方向检查是必要条件；是否振铃，还取决于每一级的增益、寄生电容和补偿。

### 2. 第一版 LDO 为什么需要单独验证

原设计由理想 3.3 V 的 VDUMMY 同时供给 RREF 和 RDUMMY。它能瞬间提供或吸收仿真需要的电流，但没有稳压器的静态损耗、充电时间和输出阻抗。本轮首先尝试独立的 5 V VIN，经 9 MOS 误差放大器及 PMOS 调整管产生 VREG，给 RDUMMY 供电。这一方案后来因启动和长时间振铃未通过而未被采用，保留为设计对照。逻辑 VDD 继续采用原来的 TT 3.3 V、慢热 2.95 V、快冷 3.65 V。

反馈电阻是 56 kΩ / 10 kΩ，因此目标为 `VREG ≈ VSET × (1 + 56/10) = 3.3 V`。给 LDO 独立 5 V 输入，是为了保留调节压差；没有假定 2.95 V 电源能经过普通 LDO 产生 3.3 V。

<figure><a href="figures/ldo-r1.svg">Dummy 电源九只 MOS 低压差稳压电路</a><figcaption>第一版 LDO 的实际 MOS 连接。输出电容、ESR 和补偿值按各实验网表记录，不能把初版电路图当成最终启动或稳定性验收。</figcaption></figure>

输出 10 nF 电容升到 3.3 V，需要充入 `Q = CΔV = 33 nC`。如果要求在 20 µs 内建立，仅电容充电就需要平均 1.65 mA，还没有加负载电流。这个计算解释了为什么需要明确启动预算，并不能代替对调整管瞬态电流的仿真。

### 3. “真实参考源”的完成边界

<figure><a href="figures/board-power-circuit.svg">高速参考源的实际片外供电去耦分压补偿和启动控制连接</a><figcaption>供电与基准分压按最终 TT 网表逐项核对。RAW、2.5 V 电压基准、GPIO 仍是外部接口；“真实参考”指宏内的晶体管反馈与电流镜，未包含完整电源 IC。</figcaption></figure>

本轮的 MOS 放大器、电流镜和禁止 MOS 是所选电路的晶体管实现；早期 LDO 也完成过独立版图提取，但未满足电气验收。外部精密电压输入仍是带明确误差条件的端口模型。没有完成片内 bandgap，也没有把这个通用电压输入称为某款产品的验证过的 SPICE 宏模型。

RSET、参考分压、LDO 分压、偏置电阻和补偿/去耦电容目前按片外器件建模。它们可以支持电路方法验证，但不是“已经全部集成到 ASIC”。最终整片面积还需要 pad、ESD、供电、测试及物理集成约束。

## 电阻容差为什么必须独立检查

对于单一电阻，`ΔI/I ≈ ΔVSET/VSET − ΔRSET/RSET` 是一阶估计。对分压器，设 VSET = VREF × Rbottom / (Rtop + Rbottom)，则分压误差不仅由电阻的绝对值决定，还由上下两只的相对误差决定。同向变化可能抵消，相反方向变化会放大误差。因此不能让所有电阻共用一个比例系数，就声称覆盖了参考电阻容差。

本轮将 RSET、RDUMMY、参考分压及偏置电阻区分；失败 LDO 的稳压分压只属于历史对照。独立工艺角与板级容差也不是同一件事。确定性 ±1% / ±100 ppm/°C 扫描用于暴露敏感性，±5% 是较大的偏差对照。最终选定 RSET 的研究规格收紧为 **±0.1% / ±25 ppm/°C**，标称仍为 20 kΩ，没有为不同工艺角逐点调值。它们不是统计良率或量产保证，也不代替实际器件规格和匹配数据。

## 能耗如何算，才不会把新增电路的代价漏掉

对全部电源和 DATA 驱动端口计算实际 `v(t) × i(t)`。正向取能与净取能分别保留；再除以相同统计窗口内发送的 gross bits。静态参考与稳压器持续耗电，速率降低时摊到每位的能耗会升高。DATA 端口的驱动功耗也不能忽略。

外部电压参考端口对电路交付的能量已经可以积分，但参考芯片内部的静态电流及其上游转换损耗没有包含在通用理想端口内，必须另外列预算。这里不把“晶体管电路输入端口能耗”冒充完整光链路的系统能耗；接收器、时钟、编码及光学效率仍有独立边界。
