Kevin-Kaiyo/open-microled-driver-asic/docs/research/nrz-b-reference-power-20261024/report-complete.md

# 高速 MicroLED B 路线：真实参考、电源与启动保护

<p class="lead">这轮把理想偏置边界换成可检查的晶体管参考与供电网络。高速数据路径、MicroLED 负载和接收算法保持；新增电路必须同时回答启动是否受控、参考电阻误差怎样传到 LED，以及增加了多少功耗。</p>

## 本轮结论与决策

**晶体管参考、受控启动和真实联通版图已经接上原 B 数据通路。** 0.5 Gb/s 是本轮固定验证点；本轮没有重新搜索最大速率。采用 10 MOS 电流反馈参考、两只受外部 DISABLE 控制的保护管与 RAW 5 V dummy 供电。外部精密电压基准尚未片内实现。

112 个 DC 点全部求解，器件端压筛查全部通过，但 **4 个电流精度点失败**，包括宽容差联合角和 ±5% 负控制。11 个启动/重启点中 10 个满足原功能与绝对端压条件；其中残余电源重启仍有 **0.747 V 体结正向偏置，尚未闭合**。提前解除关断负控制同时违反准备时间与 03v3 端压条件；5 个慢时标控制通过。10 个固定速率通信测试点中 **10 个通过** 接收与端压联合筛查。详细数据如下，失败没有从分母中删除。

目前的工程决策是：保留 RAW 供电与 150 pF 补偿作为正常启动及通信研究基线，RSET 采用 ±0.1% / ±25 ppm/°C 的研究规格，外部控制必须在参考建立后才解除 DISABLE。下一步优先实现参考就绪检测、掉电时内部补偿节点的复位/隔离并检查结电流；当前不能宣布残余电源重启已经可靠。

[TOC]

## 先读当前采用的连接

<figure><a href="figures/selected-b-circuit.svg">真实参考加禁止MOS及raw5V电流转向输出电路</a><figcaption>10 MOS 电流参考加 MDIS、MK，与原 9 MOS 高速核心连接。MDIS 钳位 BIAS，MK 使 RKEEP 仅在禁止期间泄放；正常通信时断开该支路。两者解决不同问题，泄漏及寄生仍在完整模型中。</figcaption></figure>

主供电 VIN 为 5 V，经有限供电阻抗与去耦进入电路，RDUMMY 改为 50 kΩ。原来理想 3.3 V VDUMMY 的任务是提供 dummy 支路的电压余量；它不是接收器规定的电平，也不是必须保留的片内稳压电源。本轮先尝试过真实 LDO，但长时间稳定性未通过，因此改用更直接的供电路径，并重新检查 5 V 带来的器件端压。

原核心的[四 MOS 数字缓冲、输入电阻及转向管详细原理图](../driver-robustness-20261024/figures/steering-schematic.svg)可作连接说明；其中旧 RREF / VDUMMY 部分已由本报告新参考电路替代，不能同时接入。

## 从数据到光：本轮改的是偏置与供电

数据通路仍然是 **DATA → 反相器及缓冲 → 两只转向 MOS → LED / dummy 支路**。尾电流决定高、低电平的差，基础电流使 LED 在低电平时仍有电流。数据每 2 ns 换一位，这是本轮的 0.5 Gb/s 测试点；不是 PWM 显示的灰度周期。

本轮保持 Lin 等 2026 年公开数据中的 20 µm 方形黄色 InGaN MicroLED 静态 I–V 曲线（Zenodo `10.5281/zenodo.20034288`，`I-V.xlsx` 的 Sheet1 A3:B102）。其测量温度未注明；100 µA 附近约 3.77 V。200 fF 电容、200 ps 光学一阶时间常数和接收器仍是另行声明的假设。SS/125°C、FF/−40°C 是所扫 MOS/电路条件，不能据此声称已验证该 LED 的温度相关光电性能。启动时低于首个实测点的模型延伸也不当作测量证据。

参考源不需要逐位跟随数据。它要在较慢时间尺度上稳定电流，并在启动、供电变化和温度改变时保持受控。稳压器同样不能用“一个微秒内接收正确”证明稳定：输出电容和反馈环路的变化可以持续几十至几百微秒。因此本轮把通信测试与长时间启动、负载阶跃测试分开，分别判定。

通信窗口从已经建立的工作点运行；100 µs 启动测试使用固定数据电平。两者通过不等于已经在同一条全晶体管波形中验证“上电→第一包数据→接收重新训练”，该联动应随实际 ready 控制一起补齐。

### 1. 电压基准如何变成参考电流

外部 2.5 V 精密电压输入经过 200 kΩ / 50 kΩ 分压，得到约 0.5 V 的 VSET。误差放大器比较 VSET 与 SENSE，调节 PMOS IPREG 的栅极，使 RSET 上的电压逼近 VSET。

> ISET ≈ VSENSE / RSET ≈ 0.5 V / 20 kΩ = 25 µA。

这里的 25 µA 是设计目标，不是写进理想电流源的保证。差分对失调、有限环路增益、RSET 误差都会改变它。IPOUT 与 IPREG 同尺寸、同栅极，把电流送到原 B 核心的 BIAS 二极管连接 MOS；两支路漏源电压不同，又会产生镜像误差。之后原核心再按镜像比例建立基础电流和转向电流。**稳定了 ISET，也必须重新测量 LED 的实际高低电流。**

<figure><a href="figures/vi-servo-selected.svg">参考电流反馈及镜像的十只 MOS 原理图</a><figcaption>选定电路的 10 MOS 电流参考部分。器件连接、W/L 与源网表逐只对应；新增两只保护 MOS 在前面的总图展开。图中同名网络相连，PMOS 体端接 VIN，NMOS 体端接 VSS。</figcaption></figure>

正常负反馈可以逐步理解：SENSE 升高 → 右侧 PMOS 输入支路电流减小 → IN2 降低 → INSTAGE 下拉减弱 → ICTRL 升高 → IPREG 的 VSG 减小 → 电流下降。这个方向检查是必要条件；是否振铃，还取决于每一级的增益、寄生电容和补偿。

### 2. 第一版 LDO 为什么需要单独验证

原设计由理想 3.3 V 的 VDUMMY 同时供给 RREF 和 RDUMMY。它能瞬间提供或吸收仿真需要的电流，但没有稳压器的静态损耗、充电时间和输出阻抗。本轮首先尝试独立的 5 V VIN，经 9 MOS 误差放大器及 PMOS 调整管产生 VREG，给 RDUMMY 供电。这一方案后来因启动和长时间振铃未通过而未被采用，保留为设计对照。逻辑 VDD 继续采用原来的 TT 3.3 V、慢热 2.95 V、快冷 3.65 V。

反馈电阻是 56 kΩ / 10 kΩ，因此目标为 `VREG ≈ VSET × (1 + 56/10) = 3.3 V`。给 LDO 独立 5 V 输入，是为了保留调节压差；没有假定 2.95 V 电源能经过普通 LDO 产生 3.3 V。

<figure><a href="figures/ldo-r1.svg">Dummy 电源九只 MOS 低压差稳压电路</a><figcaption>第一版 LDO 的实际 MOS 连接。输出电容、ESR 和补偿值按各实验网表记录，不能把初版电路图当成最终启动或稳定性验收。</figcaption></figure>

输出 10 nF 电容升到 3.3 V，需要充入 `Q = CΔV = 33 nC`。如果要求在 20 µs 内建立，仅电容充电就需要平均 1.65 mA，还没有加负载电流。这个计算解释了为什么需要明确启动预算，并不能代替对调整管瞬态电流的仿真。

### 3. “真实参考源”的完成边界

<figure><a href="figures/board-power-circuit.svg">高速参考源的实际片外供电去耦分压补偿和启动控制连接</a><figcaption>供电与基准分压按最终 TT 网表逐项核对。RAW、2.5 V 电压基准、GPIO 仍是外部接口；“真实参考”指宏内的晶体管反馈与电流镜，未包含完整电源 IC。</figcaption></figure>

本轮的 MOS 放大器、电流镜和禁止 MOS 是所选电路的晶体管实现；早期 LDO 也完成过独立版图提取，但未满足电气验收。外部精密电压输入仍是带明确误差条件的端口模型。没有完成片内 bandgap，也没有把这个通用电压输入称为某款产品的验证过的 SPICE 宏模型。

RSET、参考分压、LDO 分压、偏置电阻和补偿/去耦电容目前按片外器件建模。它们可以支持电路方法验证，但不是“已经全部集成到 ASIC”。最终整片面积还需要 pad、ESD、供电、测试及物理集成约束。

## 电阻容差为什么必须独立检查

对于单一电阻，`ΔI/I ≈ ΔVSET/VSET − ΔRSET/RSET` 是一阶估计。对分压器，设 VSET = VREF × Rbottom / (Rtop + Rbottom)，则分压误差不仅由电阻的绝对值决定，还由上下两只的相对误差决定。同向变化可能抵消，相反方向变化会放大误差。因此不能让所有电阻共用一个比例系数，就声称覆盖了参考电阻容差。

本轮将 RSET、RDUMMY、参考分压及偏置电阻区分；失败 LDO 的稳压分压只属于历史对照。独立工艺角与板级容差也不是同一件事。确定性 ±1% / ±100 ppm/°C 扫描用于暴露敏感性，±5% 是较大的偏差对照。最终选定 RSET 的研究规格收紧为 **±0.1% / ±25 ppm/°C**，标称仍为 20 kΩ，没有为不同工艺角逐点调值。它们不是统计良率或量产保证，也不代替实际器件规格和匹配数据。

## 能耗如何算，才不会把新增电路的代价漏掉

对全部电源和 DATA 驱动端口计算实际 `v(t) × i(t)`。正向取能与净取能分别保留；再除以相同统计窗口内发送的 gross bits。静态参考与稳压器持续耗电，速率降低时摊到每位的能耗会升高。DATA 端口的驱动功耗也不能忽略。

外部电压参考端口对电路交付的能量已经可以积分，但参考芯片内部的静态电流及其上游转换损耗没有包含在通用理想端口内，必须另外列预算。这里不把“晶体管电路输入端口能耗”冒充完整光链路的系统能耗；接收器、时钟、编码及光学效率仍有独立边界。

## DC：电阻规格如何改变实际 LED 电流

先看参考架构修改的实际收益：旧参考电阻从理想 3.3 V 供电，电流随 BIAS MOS 的 VGS 改变；新参考对 RSET 电压闭环控制。下面保持对应 MOS 角、温度、数字电源与 LED 负载。三条件下，高电流的误差范围由约 −8.06%～+7.71%，缩小到 −2.55%～+3.37%，代价是后文所列真实参考静态功耗。

| 同条件 | 旧理想 VDUMMY + RREF，I0 / I1 µA | 新实际参考，I0 / I1 µA |
|---|---|---|
| TT | 24.986 / 99.707 | 25.154 / 100.395 |
| SS | 23.656 / 91.945 | 25.065 / 97.448 |
| FF | 26.343 / 107.714 | 25.261 / 103.372 |

目标 I0/I1 为 25/100 µA，误差预算均为 ±5%。联合条件同时改变 RSET、RDUMMY、外部基准与 RAW；SS/FF 是指定组合，不是完整笛卡尔积。VSET 分压误差、100 Ω 源阻抗等另作独立控制，未声称全部极值已经同时叠加。

| 条件 | I0 µA | I1 µA | 相对目标误差 I0 / I1 | ±5% 判定 |
|---|---|---|---|---|
| TT / 27°C | 25.154 | 100.395 | +0.616% / +0.395% | 通过 |
| SS / 125°C | 25.065 | 97.448 | +0.262% / -2.552% | 通过 |
| FF / −40°C | 25.261 | 103.372 | +1.045% / +3.372% | 通过 |
| SS 宽容差联合 | 24.504 | 95.263 | -1.985% / -4.737% | 通过 |
| FF 宽容差联合 | 25.725 | 105.247 | +2.900% / +5.247% | 未通过 |
| SS 精密 RSET 联合 | 24.900 | 96.804 | -0.400% / -3.196% | 通过 |
| FF 精密 RSET 联合 | 25.370 | 103.811 | +1.480% / +3.811% | 通过 |

<figure><a href="figures/rset-tolerance.svg">精密与宽容差设定电阻下的高低电流误差</a><figcaption>阴影是 ±5% 研究预算。FF 宽容差联合点越界；收紧 RSET 后回到预算内。各角点使用同一标称 20 kΩ，没有逐点校准。</figcaption></figure>

<details><summary>查看全部 4 个未通过电流精度的 DC 点</summary>

| 失败 DC 条件 | 逻辑位 | 电流误差 |
|---|---|---|
| DC_FF_RSET_-0.01_100 | 1 | +5.0747% |
| DC_NEG5_RSET_-0.05 | 0 | +5.8408% |
| DC_NEG5_RSET_-0.05 | 1 | +5.5942% |
| DC_FF_joint | 1 | +5.2465% |

</details>

完整数据：[112 点 DC](../../../evidence/nrz-reference-v2/selected-final-r2-dc.json)。旧分析字段 `combined_screen_passed` 在 DC 中只代表器件端压；本报告另算电流误差，避免把两个判据混淆。

## 启动：保护作用、代价与失败边界

DISABLE 高时，MDIS 把 BIAS 钳到地，MK 接通 1.8 MΩ 泄放，避免 OUT 悬空；低时，两管关闭，正常低电平不再附加约 1 µA 的 keeper 电流。启动保持仍有约 1.3 µA 电流，合同为 ≤2 µA，**不是零电流关断**。正常释放后须在 2 µs 内进入 100 µA ±5%，完整峰值须 ≤125 µA。

正常冷启动：外部电源与参考用 1 µs 斜坡建立，20 µs 后释放。迟到参考在 30 µs 开始时，释放也推迟到 50 µs。若仍在 20 µs 提前释放，实际 21 MOS PEX 中最大 03v3 端差约 **4.862 V**，超过 3.63 V 项目筛查，并延迟约 13.53 µs 才进入目标带。这是尚未实现自主 POR/ready 检测的实际风险，不能写成任意上电顺序安全。

| 启动条件 | 保持峰值 µA | 完整峰值 µA | 释放到稳定 ns | 型号端压余量 V | 原判据及补充检查 |
|---|---|---|---|---|---|
| TT 正常启动 | 1.2765 | 100.670 | 89.06 | 0.9995 | 原判据通过 |
| SS 正常启动 | 1.2753 | 97.657 | 93.59 | 0.9998 | 原判据通过 |
| FF 正常启动 | 1.2901 | 103.710 | 88.75 | 0.9993 | 原判据通过 |
| 基准迟到，正确延迟释放 | 1.2764 | 100.670 | 89.05 | 0.9995 | 原判据通过 |
| 基准迟到，错误提前释放 | 1.2764 | 100.395 | 13529.71 | -1.2319 | 失败：负控制 |
| FF：补偿 -20% | 1.2901 | 103.752 | 88.83 | 0.9991 | 原判据通过 |
| FF：补偿 +20% | 1.2901 | 103.680 | 88.87 | 0.9994 | 原判据通过 |
| FF：去耦与 keeper 应力 | 1.2705 | 103.709 | 88.80 | 0.9993 | 原判据通过 |
| FF：保留 LED 电源的重启 | 1.2681 | 103.835 | 88.78 | 0.9979 | 功能/绝对端压满足，体结未闭合 |
| FF：更紧数值配置 | 1.2891 | 103.708 | 88.88 | 0.9993 | 原判据通过 |
| FF：补偿外引 R/L | 1.2900 | 103.709 | 88.79 | 0.9993 | 原判据通过 |

<figure>最终21MOS实际PEX的三个角点完整启动及释放局部波形<figcaption>上图为 100 µs 完整窗口，下图放大释放附近。波形来自全分辨率结果；本轮的 20 µs 外部等待是一项明确接口条件。</figcaption></figure>

<figure>参考迟到时正确延迟释放和错误提前释放的端电压及电流<figcaption>左：参考 30 µs 到、50 µs 释放；右：参考仍在 30 µs 到，却提前于 20 µs 释放。右图 OUT 悬空期间 03v3 端压越界。图中 anchor 为外部电压基准，DISABLE 为外部禁止信号；这两种时序故意不同。</figcaption></figure>

最后两行分别检查更紧数值配置、补偿外引 1 Ω / 5 nH 与 0.5 Ω ESR；不能外推为全部启动与通信矩阵都覆盖了补偿引脚寄生。完整数据：[启动/重启](../../../evidence/nrz-reference-v2/selected-final-r2-startup.json)。
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
