Kevin-Kaiyo/open-microled-driver-asic/docs/research/pwm-reference-startup-20261024/architecture.md

## 先把显示 PWM 与高速通信分开

显示 PWM 的问题是：在每个灰度周期内，LED 打开时的电流是否准确，最短脉冲的电荷是否准确，关闭和故障时能否及时停止。本轮仍保持单像素 100 µA、1 MHz 时钟、256 µs 帧周期和原来的 MicroLED 合成模型。

该显示负载在 27°C 以约 2.8 V / 100 µA 校准，理想因子 N=3、串联电阻 50 Ω、CJO=2 pF、TT=1 ns，属于教学合成模型。PWM、FAULT、PERMIT 来自实际执行的 RTL 事件回放；模拟宏内的缓冲和保护按晶体管建模，但本轮未把完整数字许可宏全部替换为晶体管后与启动同仿。

高速 B 的问题则是：在每个 2 ns 的数据位内，高低电平是否能被固定接收器区分。它有基础电流和转向电流，低电平仍然耗电；不能把显示 PWM 的关断标准、合成 LED 或灰度积分结果直接换成它的接收条件。[高速参考与供电报告](../nrz-b-reference-power-20261024/index.html)单独记录这条路线。

## 参考电流怎样控制 LED

显示路径的电压设定为 VSET = 0.5 V，检测电阻为 RSET = 5 kΩ，因此参考目标约为 `ISET = VSET / RSET = 100 µA`。误差放大器调节 PMOS 栅极，使检测电压跟随 VSET；镜像和输出开关再把电流传到 LED 支路。实际 LED 电流仍受镜像误差、输出压差、温度、供电和寄生参数影响。
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
