Kevin-Kaiyo/open-microled-driver-asic/docs/research/blender-layout-20261018/02-device.png

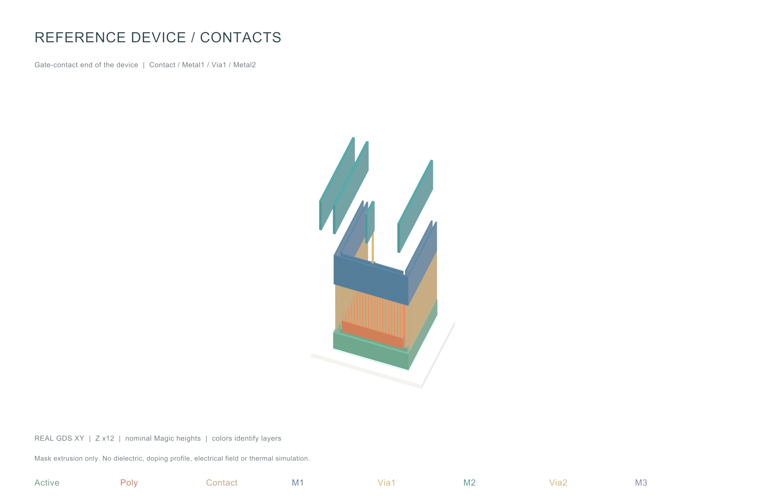
docs/research/blender-layout-20261018/02-device.png
