Kevin-Kaiyo/open-microled-driver-asic/docs/research/blender-layout-20261018/03-vias.png

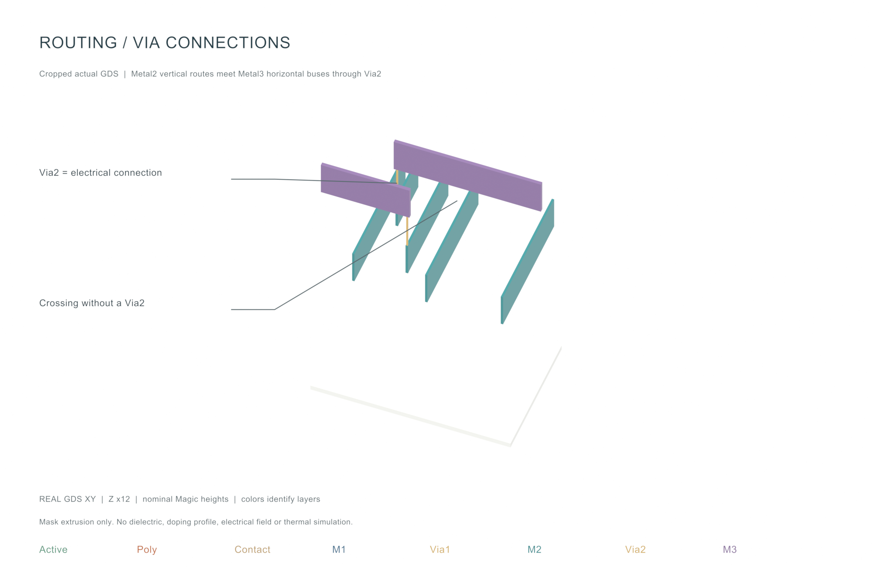
docs/research/blender-layout-20261018/03-vias.png
