Kevin-Kaiyo/open-microled-driver-asic/docs/research/blender-pwm-animation-20261018/figures/pwm-low.png

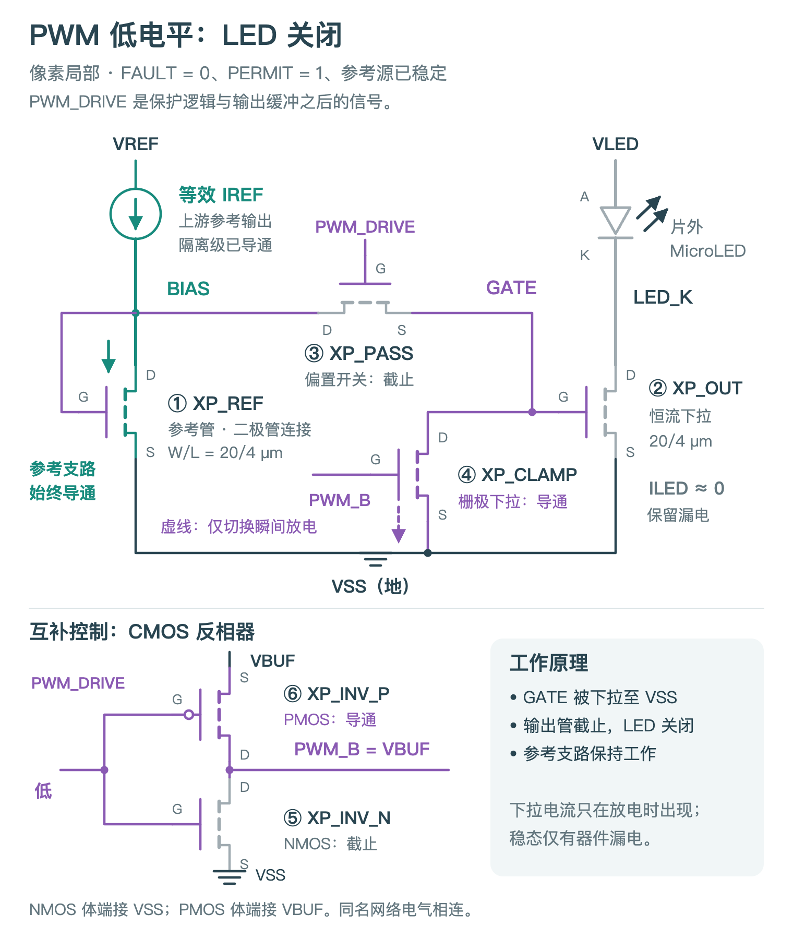
docs/research/blender-pwm-animation-20261018/figures/pwm-low.png
