Kevin-Kaiyo/open-microled-driver-asic/docs/research/blue-emitter-speed-review-20261110/assets/load-envelope.png

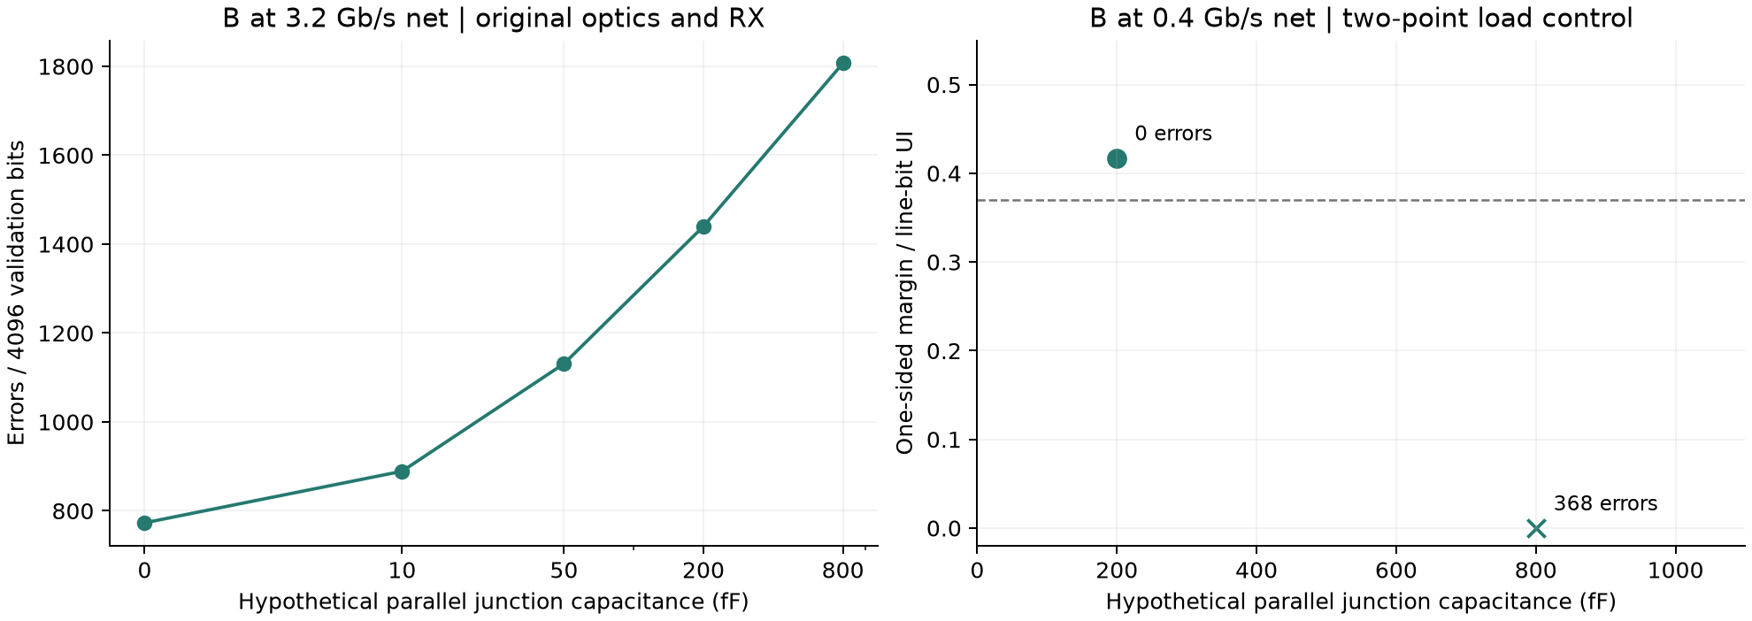
docs/research/blue-emitter-speed-review-20261110/assets/load-envelope.png
