Kevin-Kaiyo/open-microled-driver-asic/docs/research/driver-improvement-20261111/assets/vcsel-causal-bars.png

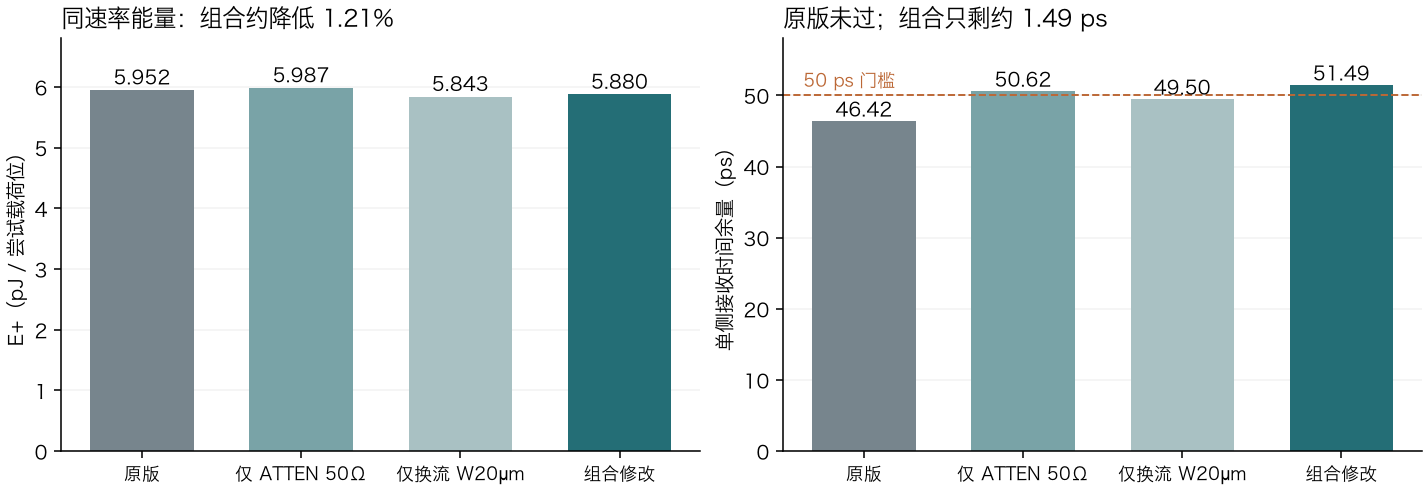
docs/research/driver-improvement-20261111/assets/vcsel-causal-bars.png
