Kevin-Kaiyo/open-microled-driver-asic/docs/research/driver-methods-20261111/assets/micro-energy-by-source.png

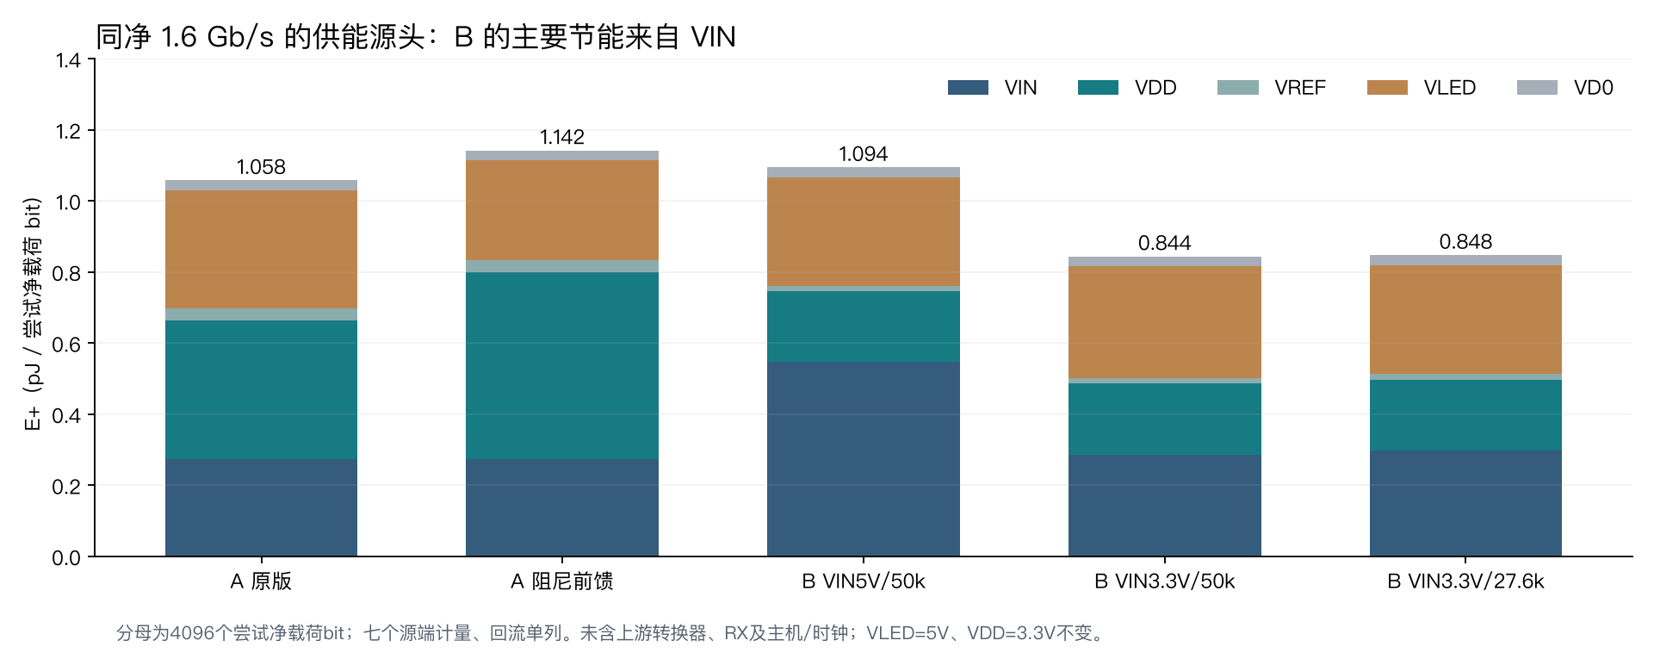
docs/research/driver-methods-20261111/assets/micro-energy-by-source.png
