Kevin-Kaiyo/open-microled-driver-asic/docs/research/driver-robustness-20261024/figures/nrz-common-energy.png

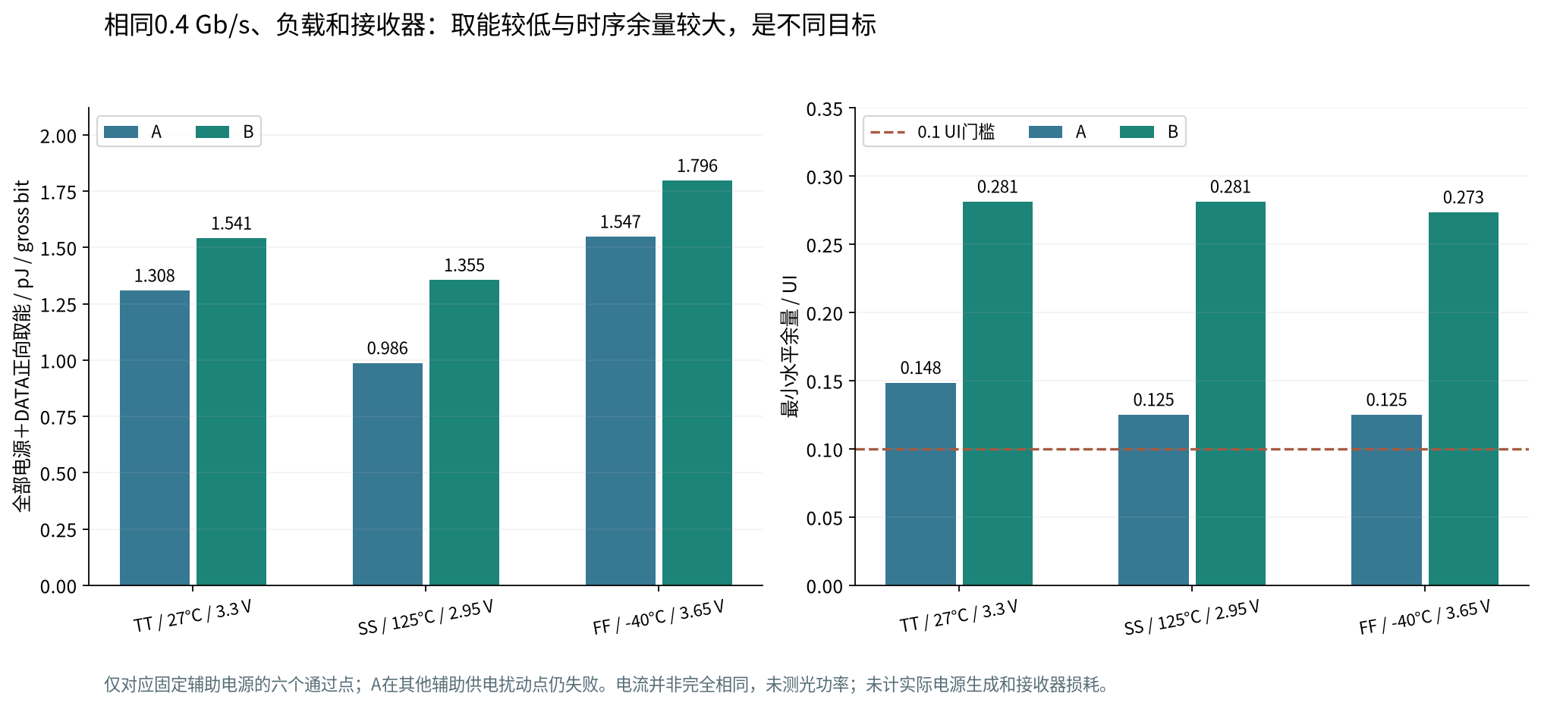
docs/research/driver-robustness-20261024/figures/nrz-common-energy.png
