Kevin-Kaiyo/open-microled-driver-asic/docs/research/driver-robustness-20261024/figures/nrz-voltage-budget.png

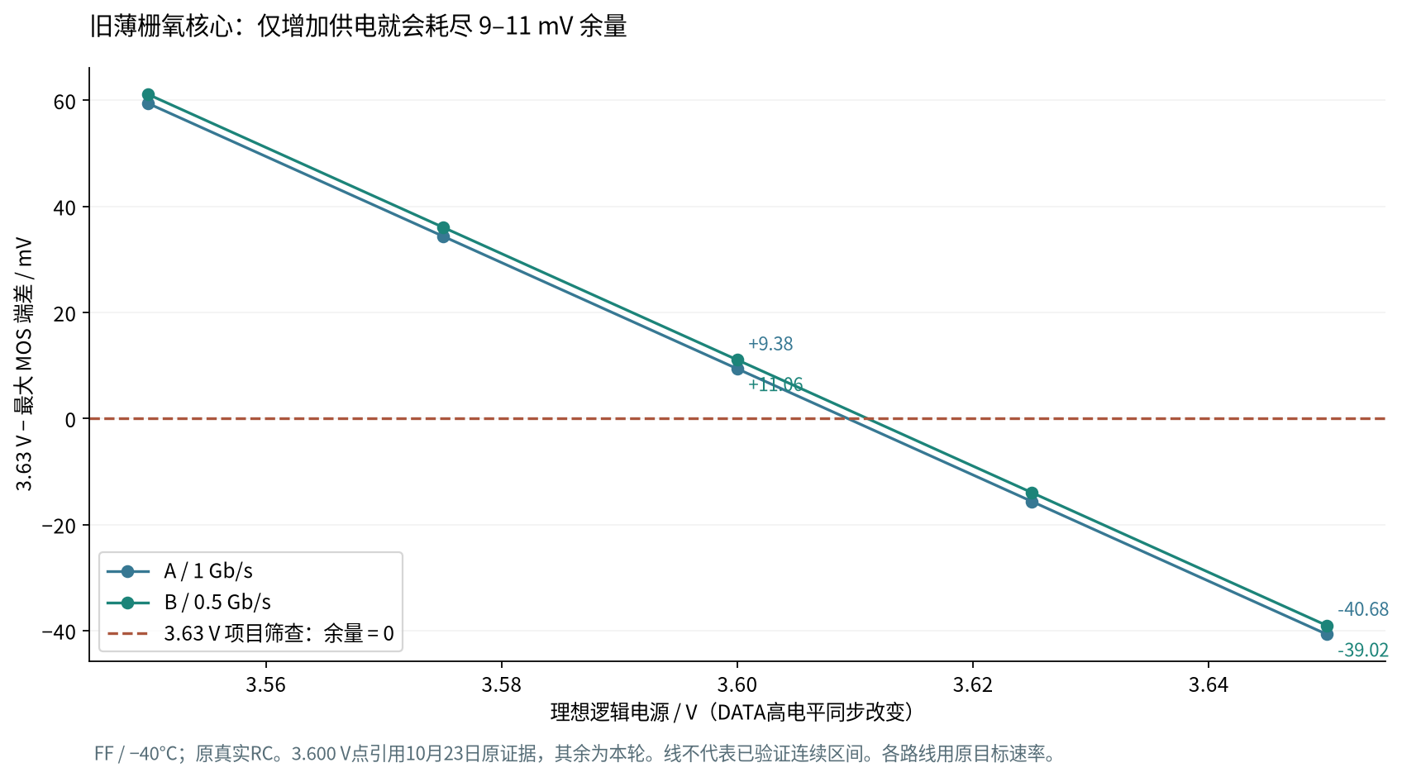
docs/research/driver-robustness-20261024/figures/nrz-voltage-budget.png
