Kevin-Kaiyo/open-microled-driver-asic/docs/research/driver-robustness-20261024/figures/sampler-discrete-points.png

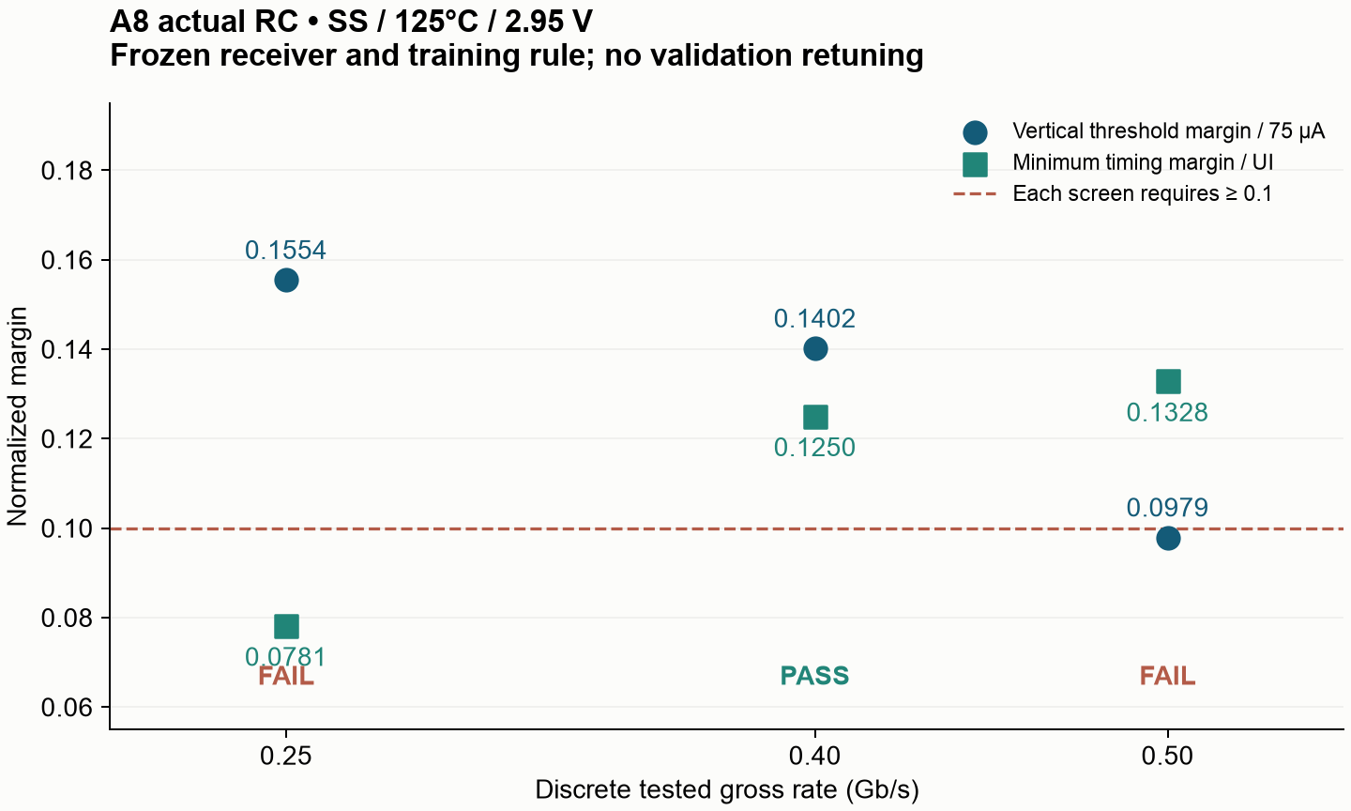
docs/research/driver-robustness-20261024/figures/sampler-discrete-points.png
