Kevin-Kaiyo/open-microled-driver-asic/docs/research/driver-robustness-20261024/figures/steering-schematic.png

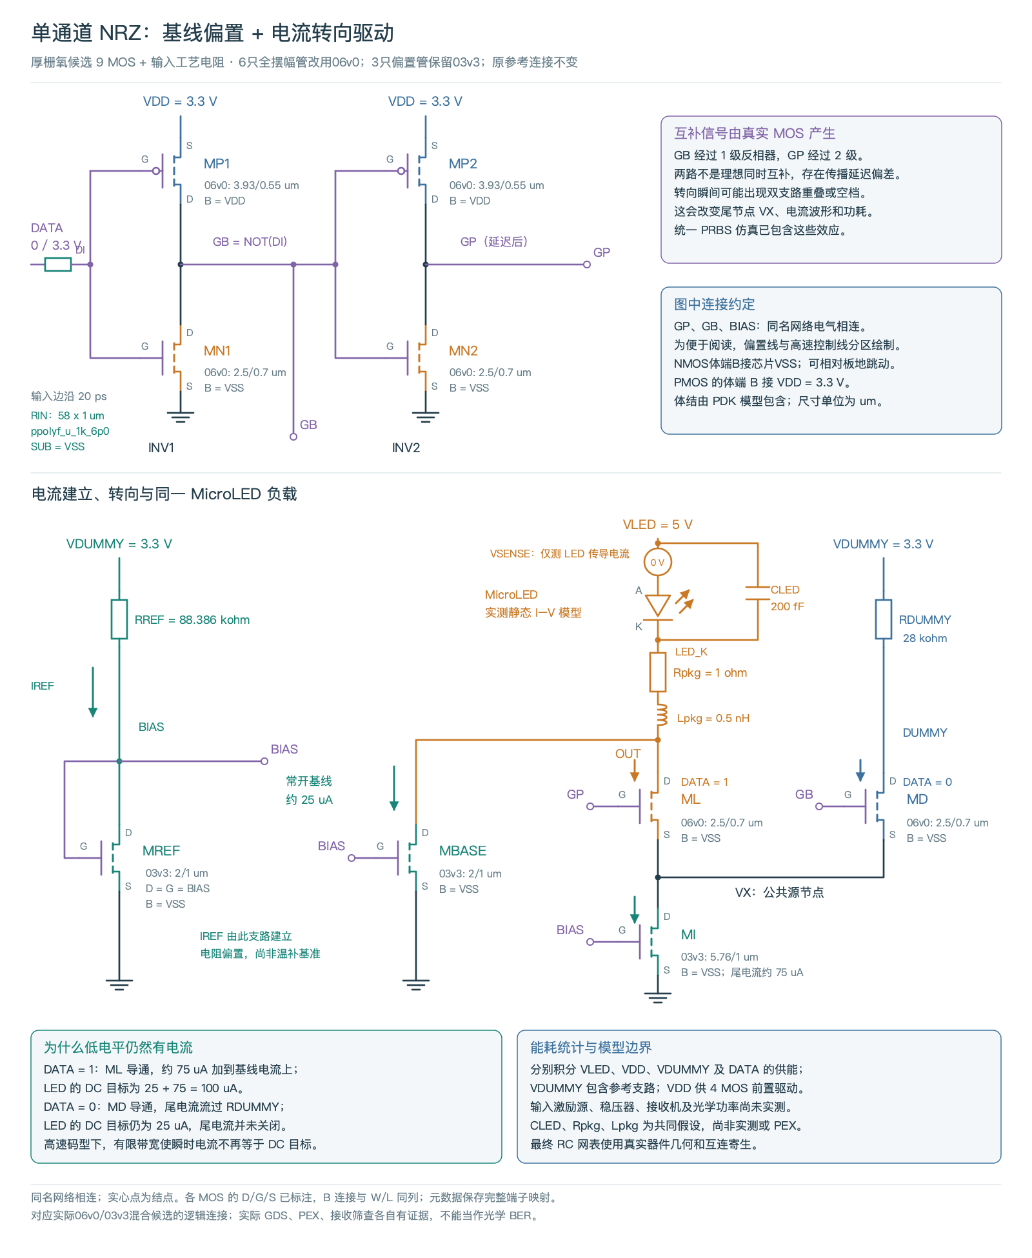
docs/research/driver-robustness-20261024/figures/steering-schematic.png
