Kevin-Kaiyo/open-microled-driver-asic/docs/research/driver-robustness-20261024/figures/supply-return-circuit.png

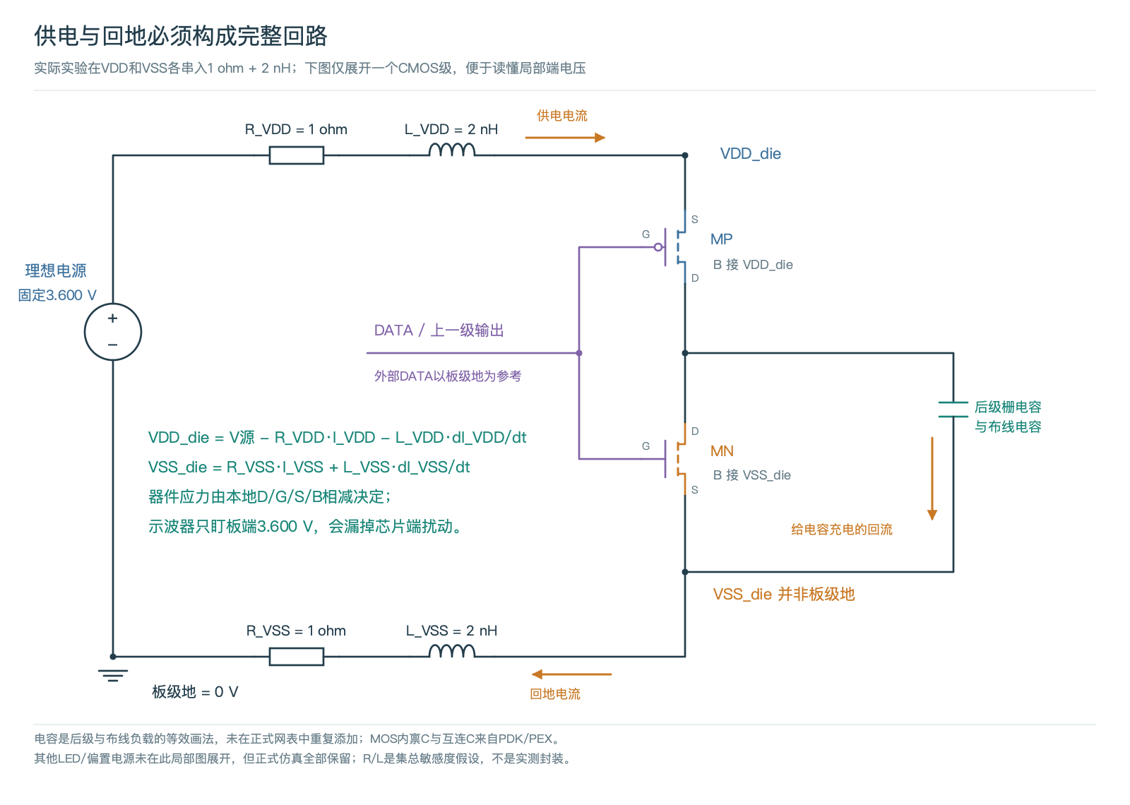
docs/research/driver-robustness-20261024/figures/supply-return-circuit.png
