Kevin-Kaiyo/open-microled-driver-asic/docs/research/driver-robustness-20261024/pwm-figures/pwm-independent-resistor.png

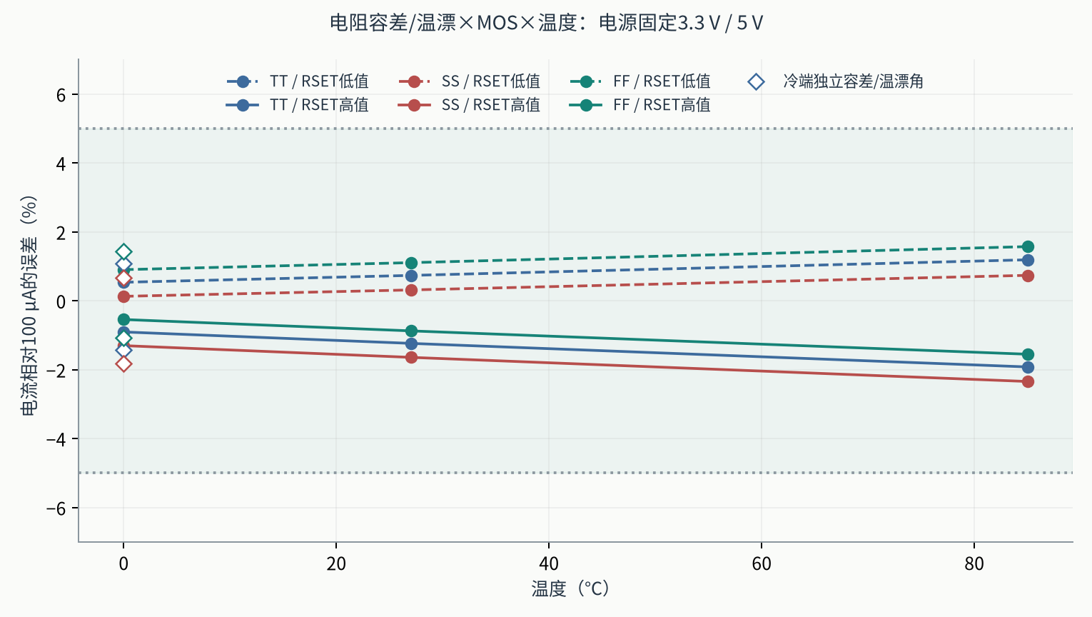
docs/research/driver-robustness-20261024/pwm-figures/pwm-independent-resistor.png
