Kevin-Kaiyo/open-microled-driver-asic/docs/research/fair-driver-comparison-20261025/figures/a-rails.png

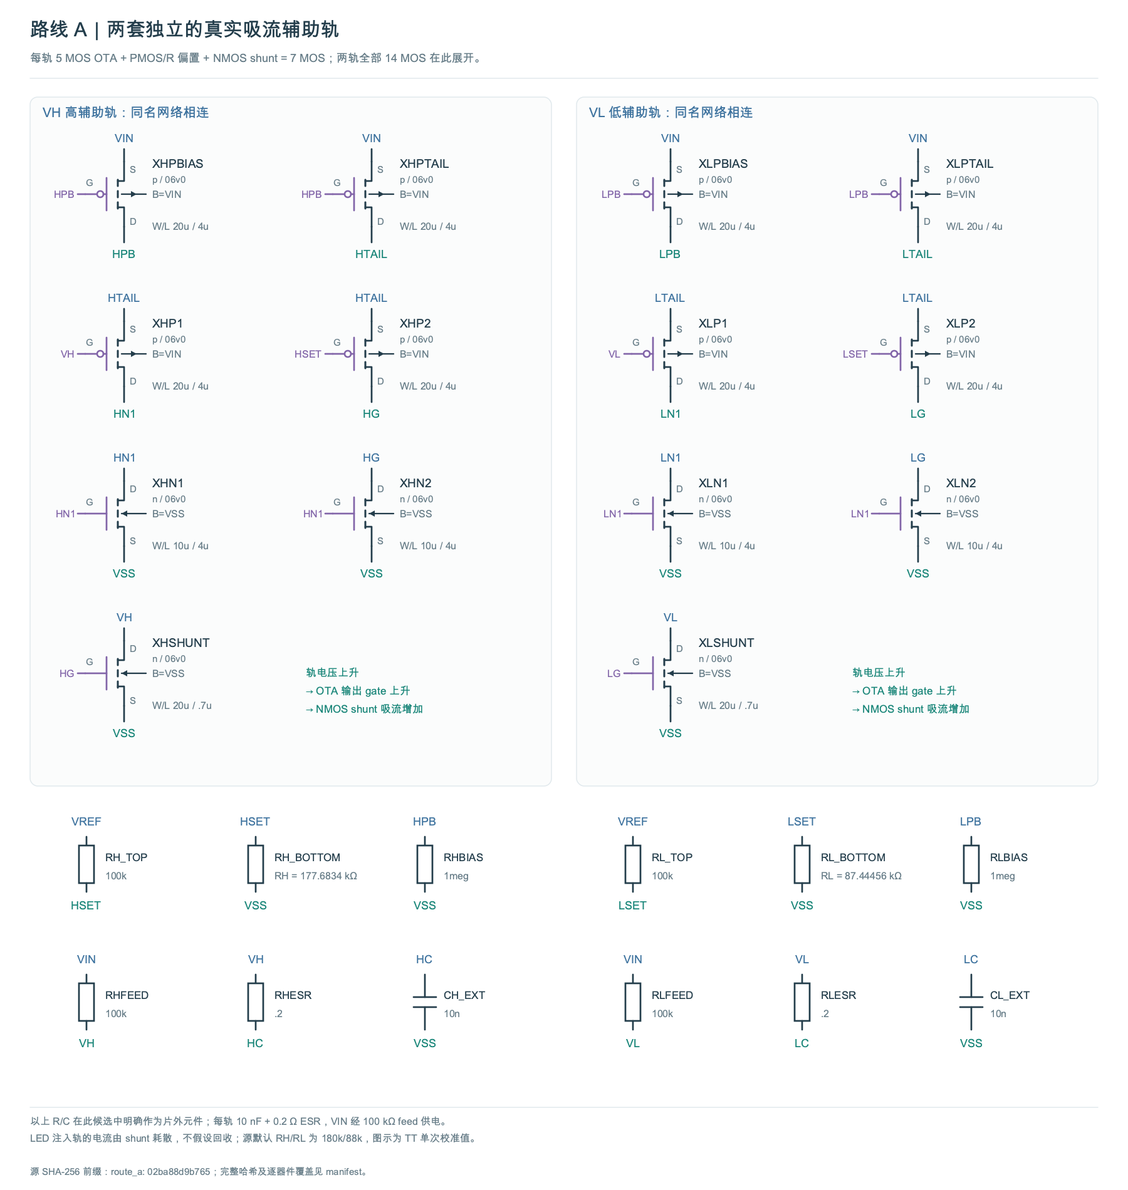
docs/research/fair-driver-comparison-20261025/figures/a-rails.png
