Kevin-Kaiyo/open-microled-driver-asic/docs/research/fair-driver-comparison-20261025/figures/energy-ports.png

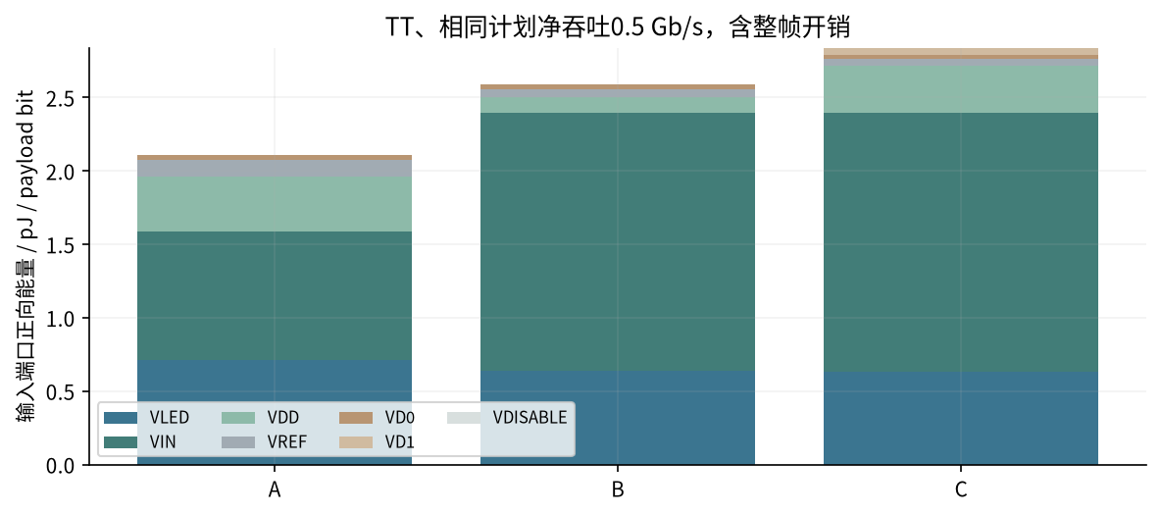
docs/research/fair-driver-comparison-20261025/figures/energy-ports.png
