Kevin-Kaiyo/open-microled-driver-asic/docs/research/fair-driver-comparison-20261025/figures/eyes-tt-0p5G.png

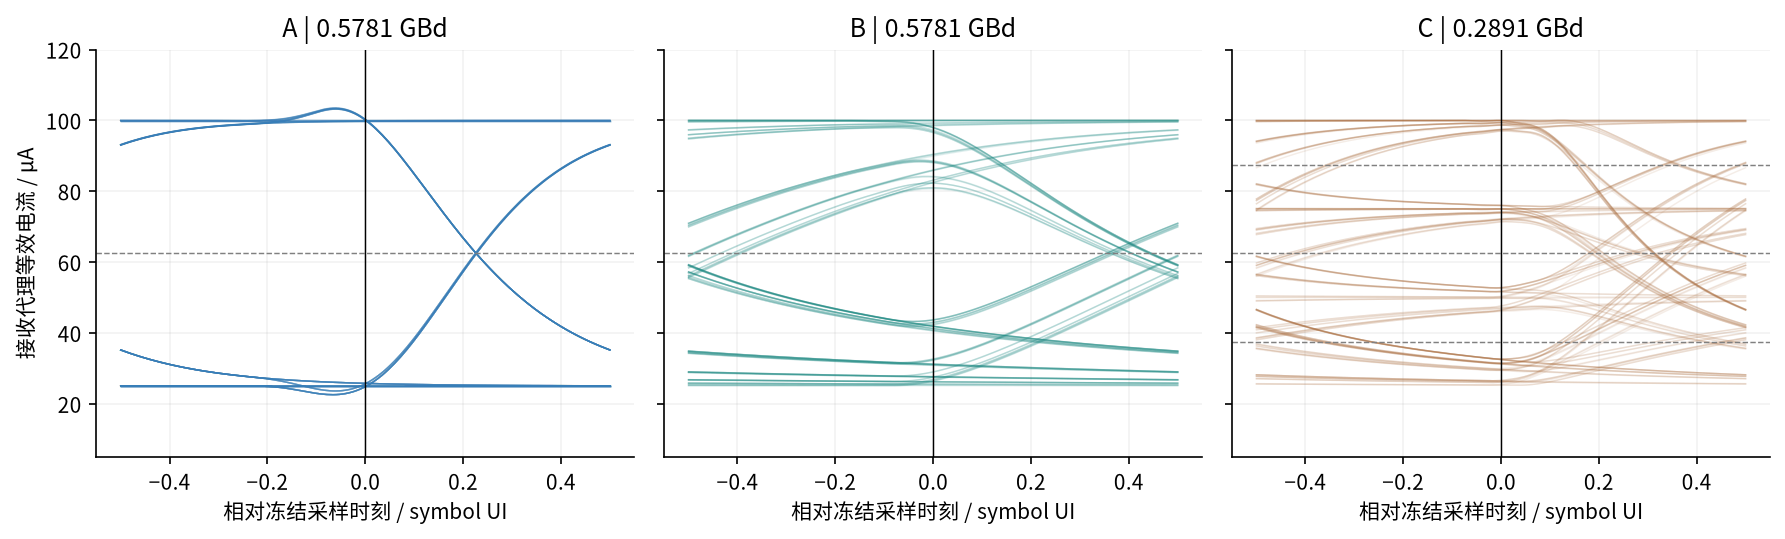
docs/research/fair-driver-comparison-20261025/figures/eyes-tt-0p5G.png
