Kevin-Kaiyo/open-microled-driver-asic/docs/research/highspeed-driver-routes-20261019/figures/package-concept.png

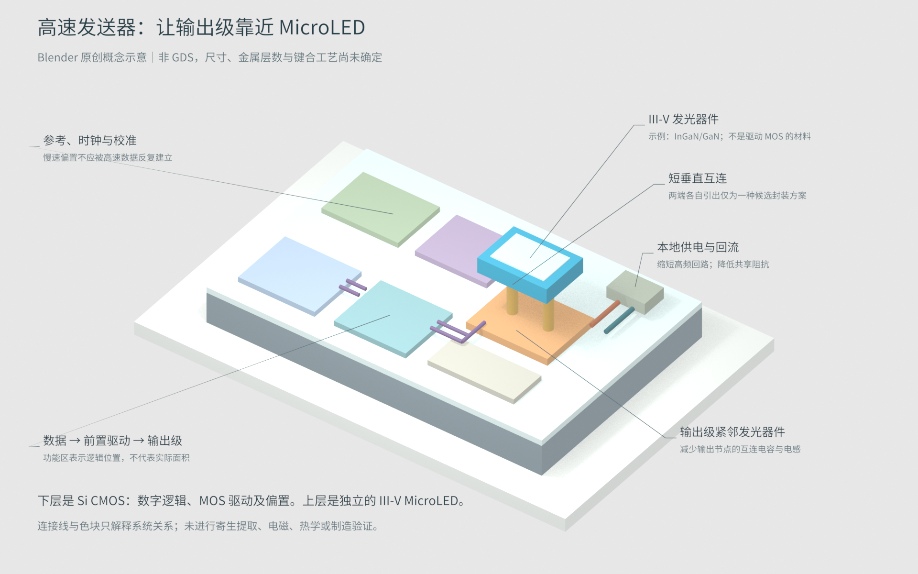
docs/research/highspeed-driver-routes-20261019/figures/package-concept.png
