Kevin-Kaiyo/open-microled-driver-asic/docs/research/highspeed-driver-routes-20261019/figures/route-a.png

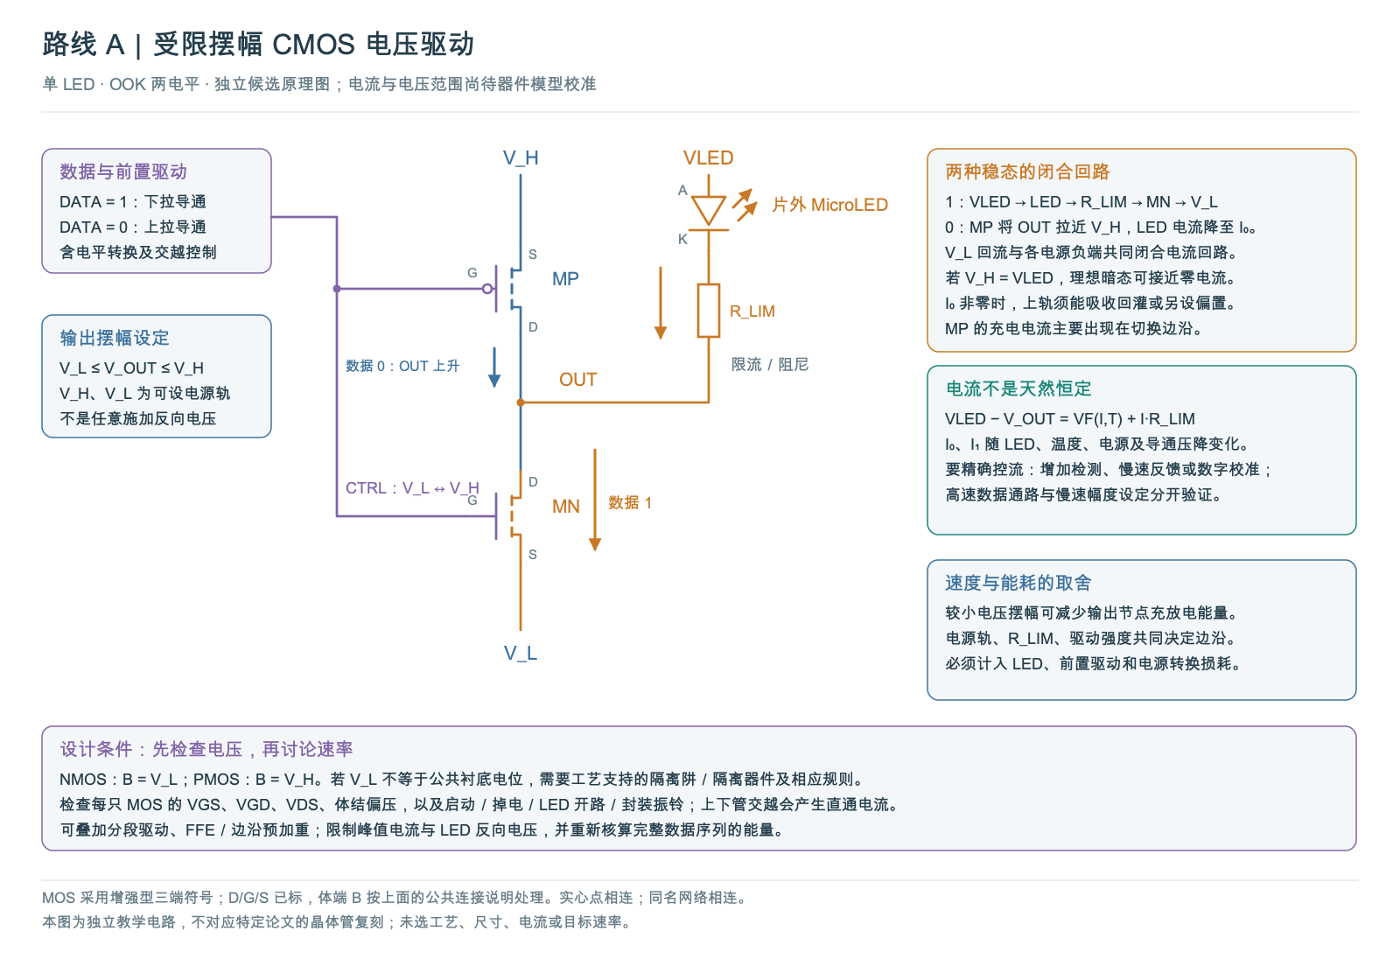
docs/research/highspeed-driver-routes-20261019/figures/route-a.png
