Kevin-Kaiyo/open-microled-driver-asic/docs/research/highspeed-driver-routes-20261019/figures/route-b.png

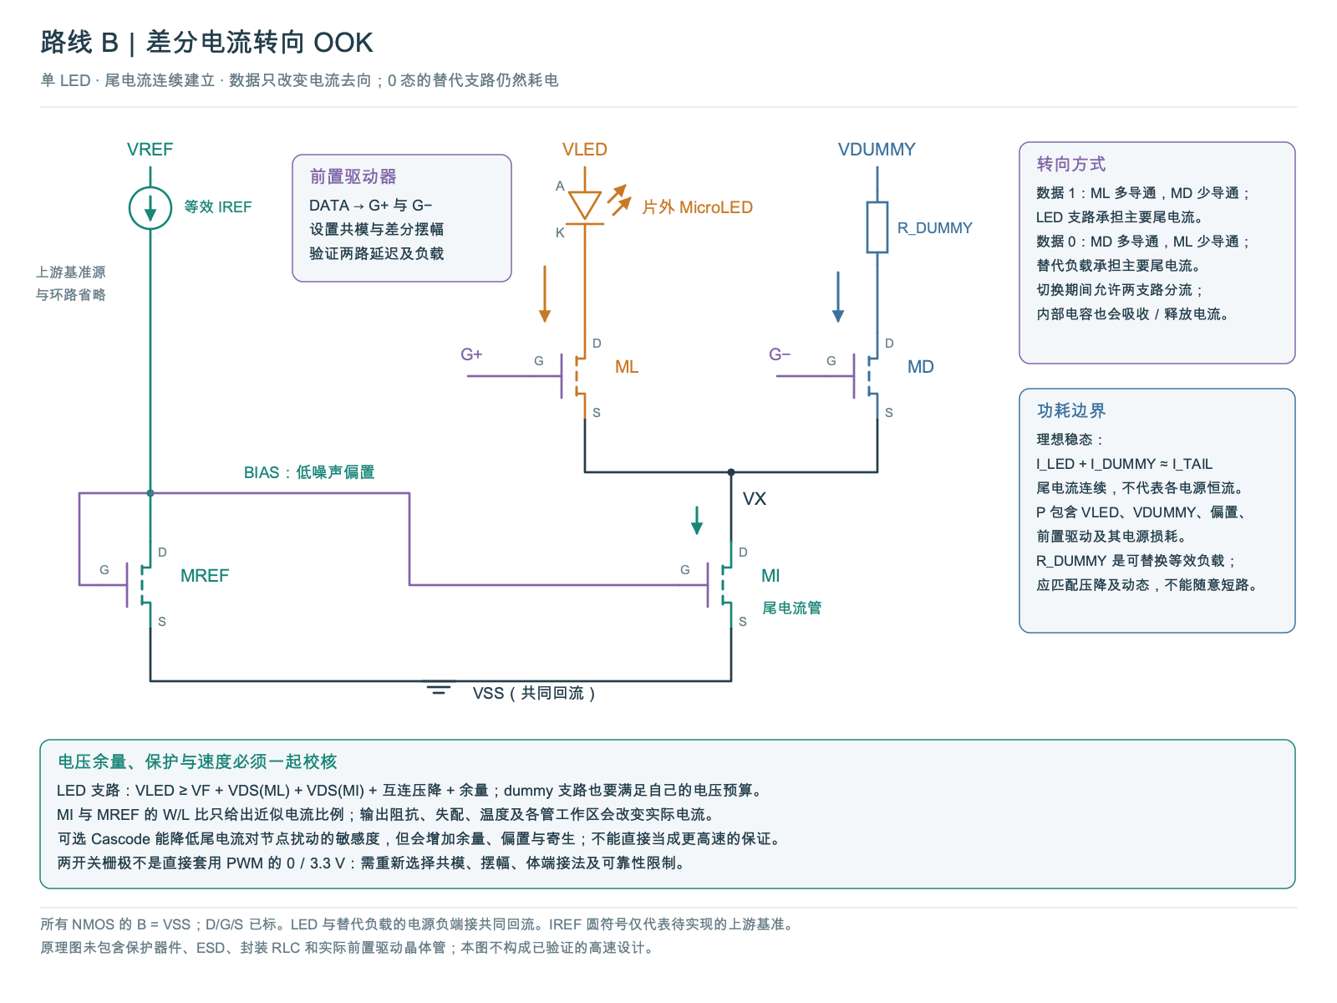
docs/research/highspeed-driver-routes-20261019/figures/route-b.png
