Kevin-Kaiyo/open-microled-driver-asic/docs/research/highspeed-nrz-20261019/figures/capacitance.png

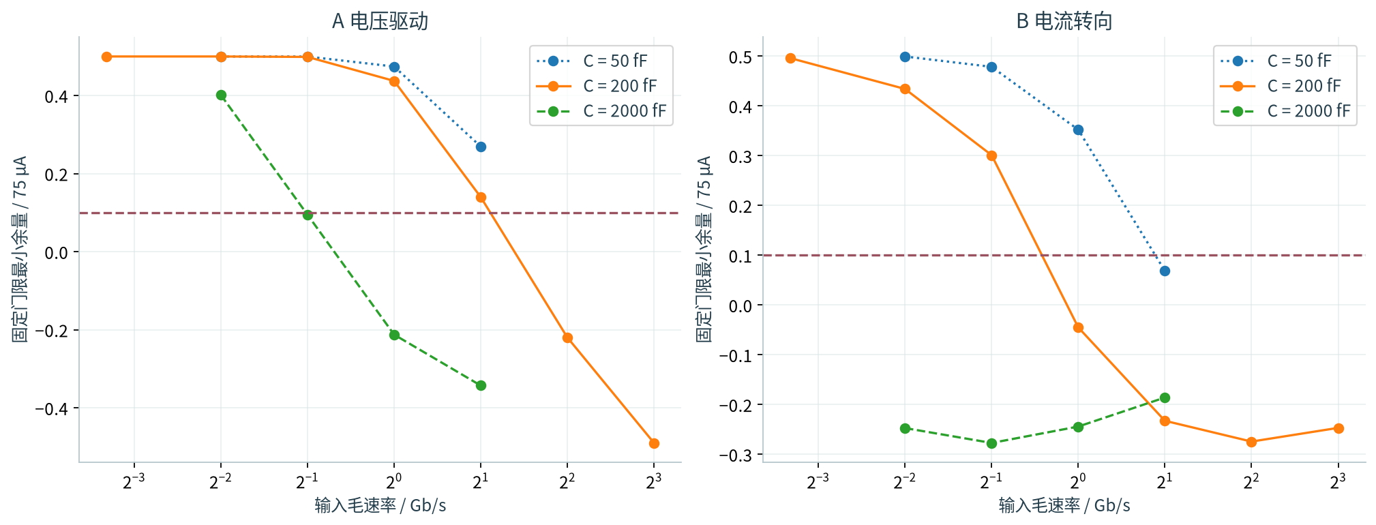
docs/research/highspeed-nrz-20261019/figures/capacitance.png
