Kevin-Kaiyo/open-microled-driver-asic/docs/research/highspeed-nrz-20261019/figures/energy-ports.png

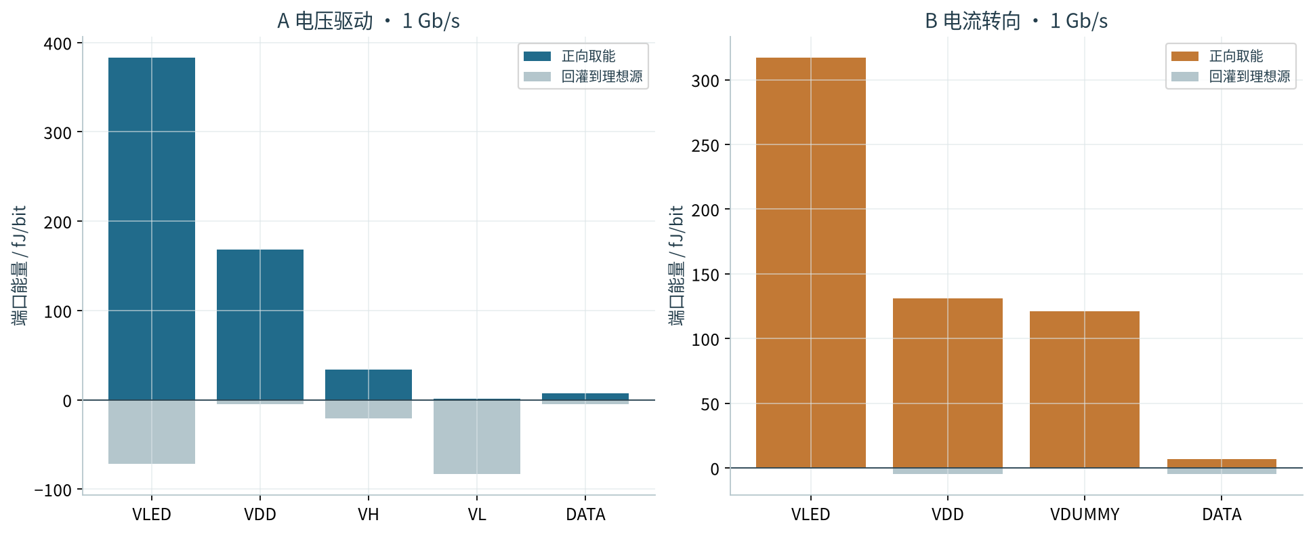
docs/research/highspeed-nrz-20261019/figures/energy-ports.png
