Kevin-Kaiyo/open-microled-driver-asic/docs/research/highspeed-nrz-20261019/figures/eyes.png

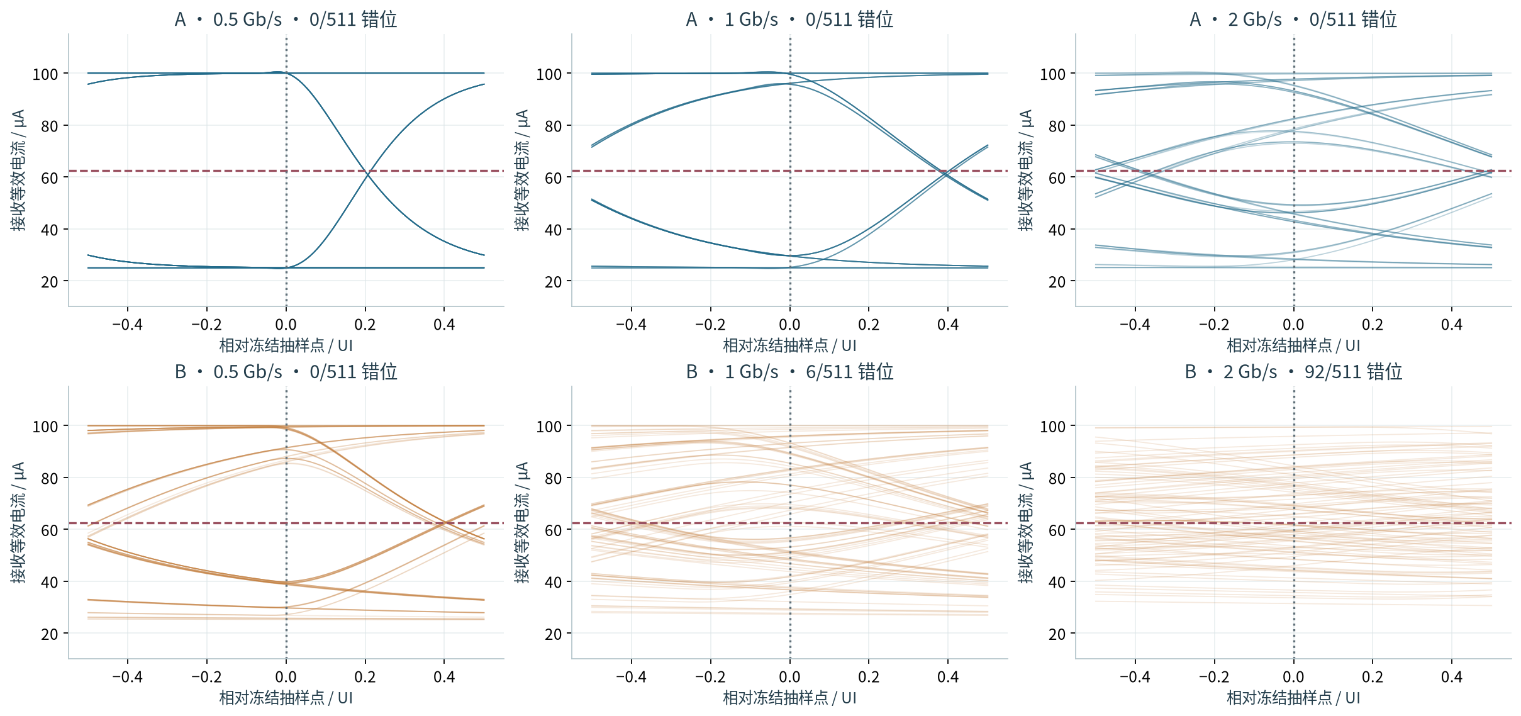
docs/research/highspeed-nrz-20261019/figures/eyes.png
