Kevin-Kaiyo/open-microled-driver-asic/docs/research/highspeed-nrz-20261019/figures/receiver-sensitivity.png

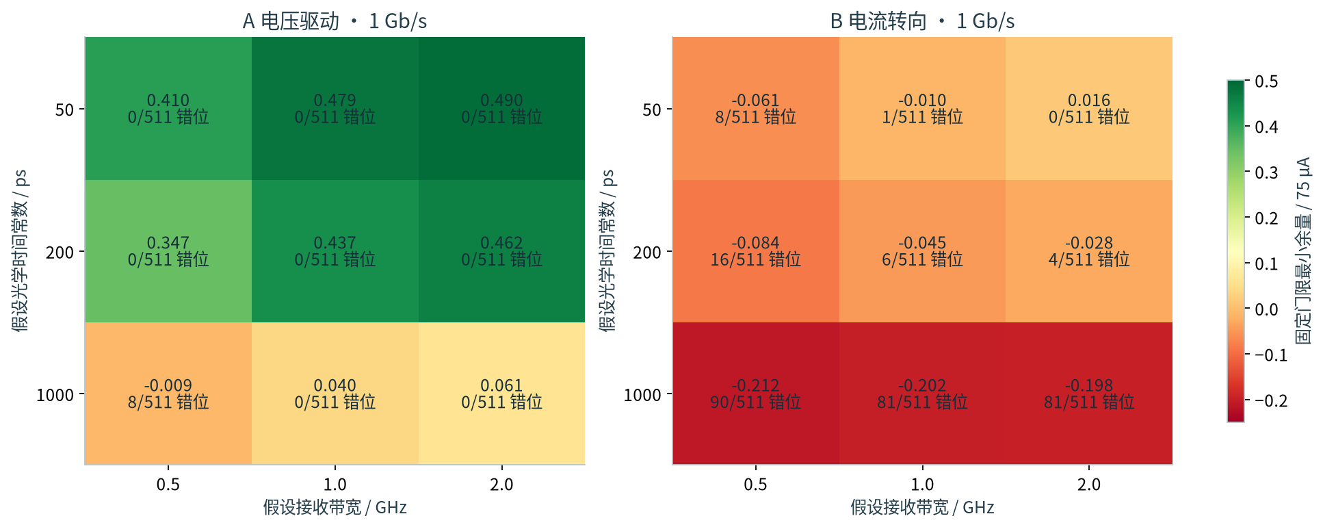
docs/research/highspeed-nrz-20261019/figures/receiver-sensitivity.png
