Kevin-Kaiyo/open-microled-driver-asic/docs/research/highspeed-nrz-20261019/figures/waveforms-1G.png

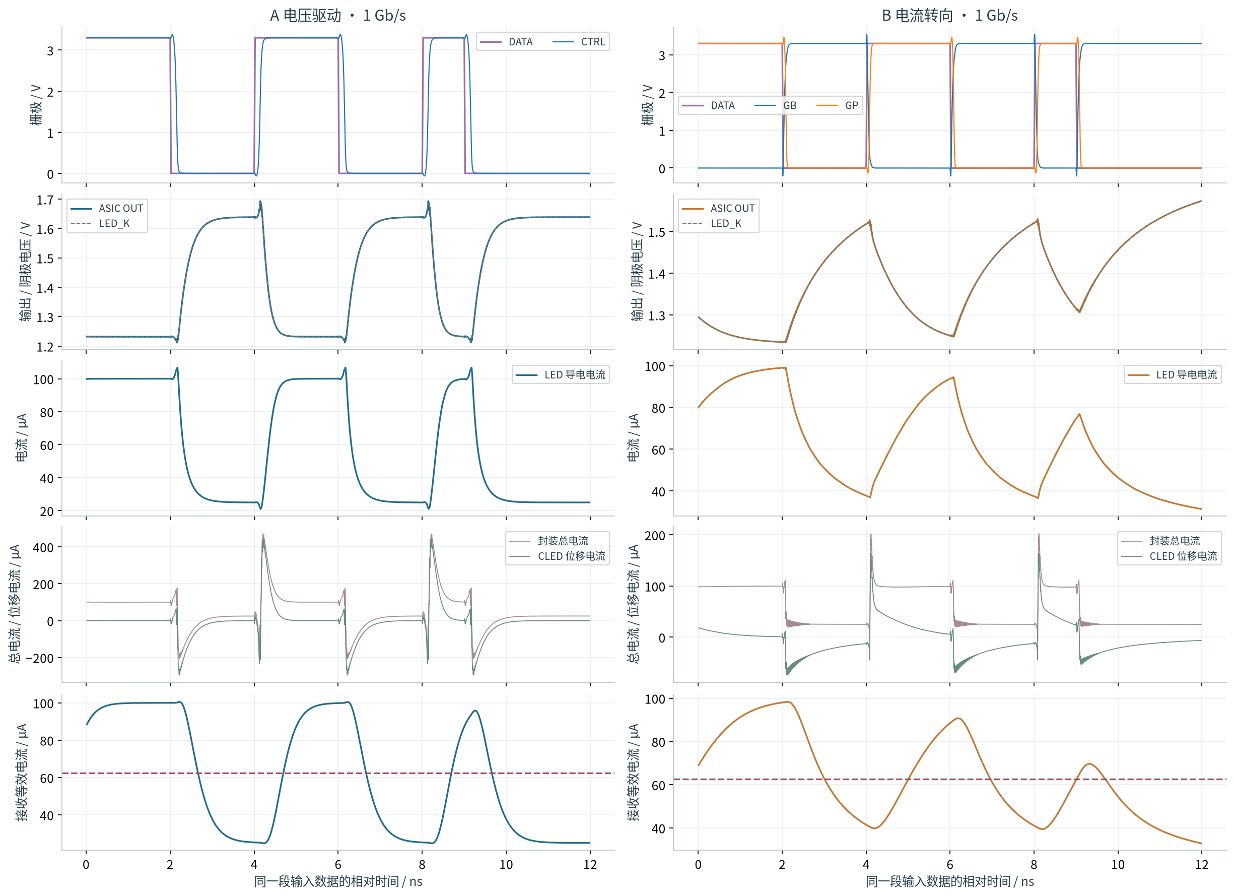
docs/research/highspeed-nrz-20261019/figures/waveforms-1G.png
