Kevin-Kaiyo/open-microled-driver-asic/docs/research/highspeed-nrz-20261019/figures/waveforms-2G.png

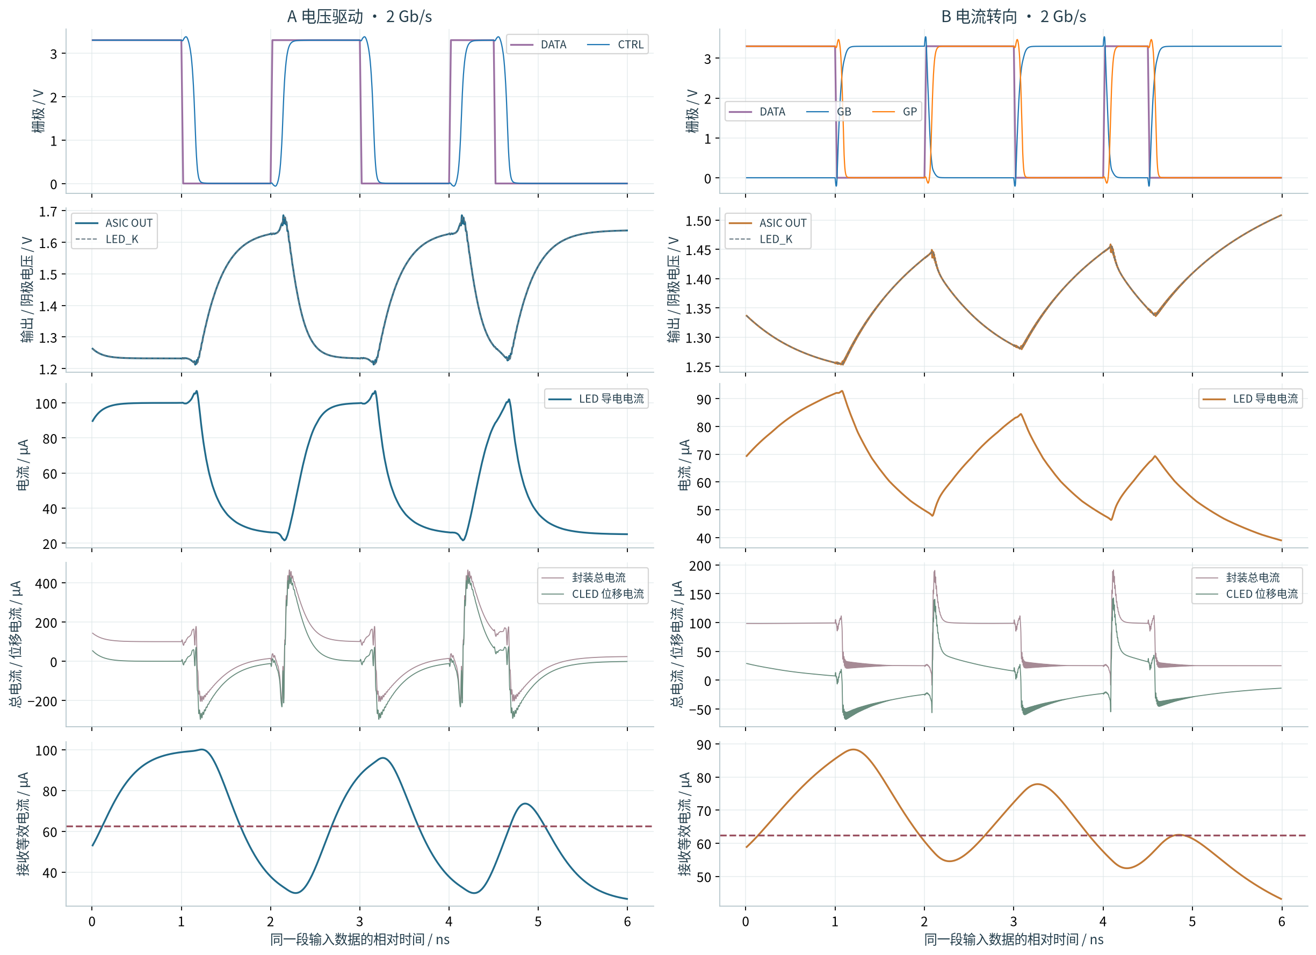
docs/research/highspeed-nrz-20261019/figures/waveforms-2G.png
