Kevin-Kaiyo/open-microled-driver-asic/docs/research/highspeed-nrz-pex-20261020/figures/energy-ports-rc.png

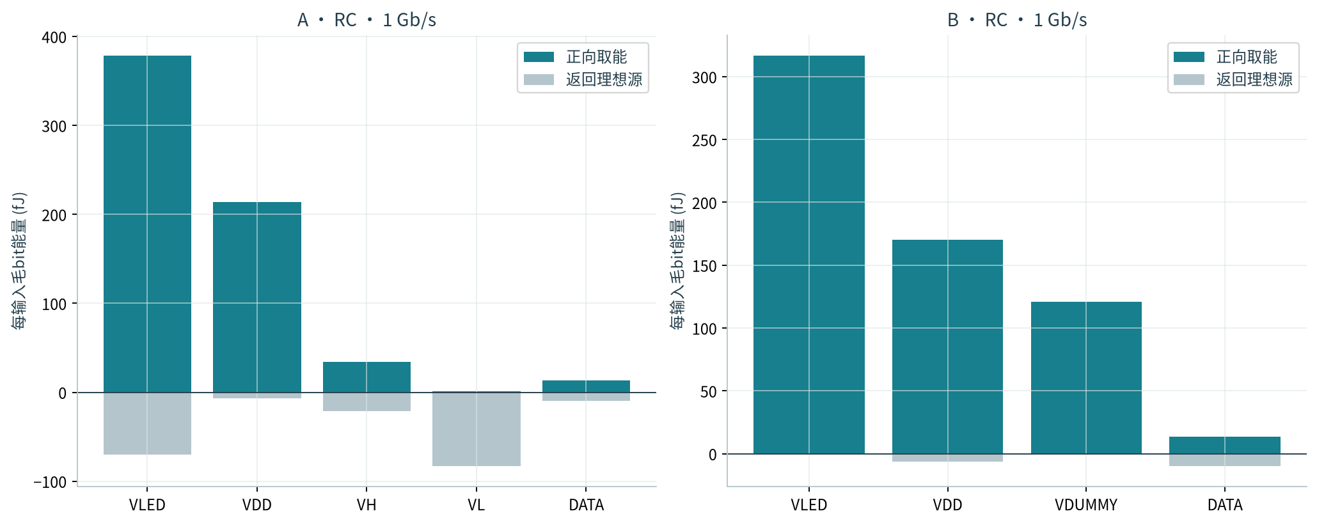
docs/research/highspeed-nrz-pex-20261020/figures/energy-ports-rc.png
