Kevin-Kaiyo/open-microled-driver-asic/docs/research/highspeed-nrz-pex-20261020/figures/rate-energy.png

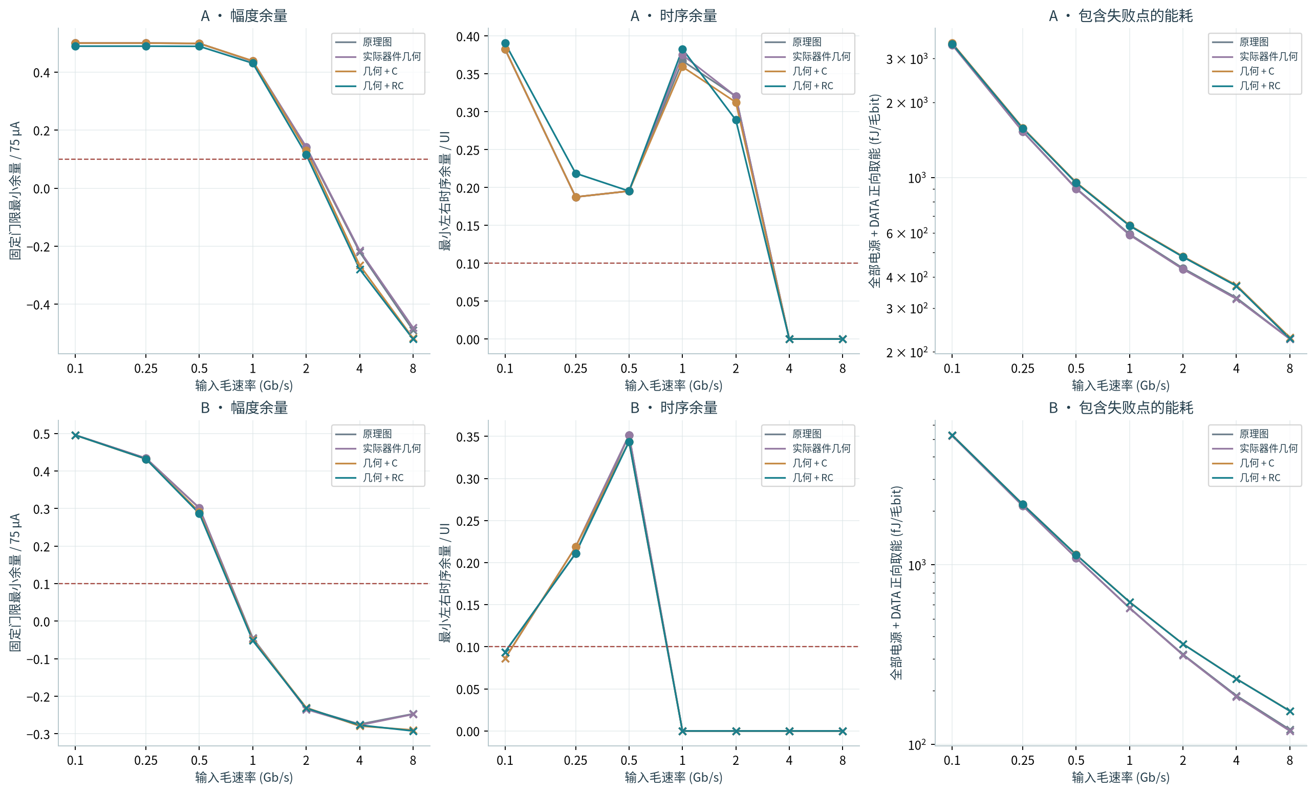
docs/research/highspeed-nrz-pex-20261020/figures/rate-energy.png
