Kevin-Kaiyo/open-microled-driver-asic/docs/research/highspeed-nrz-pex-20261020/figures/waveforms-0.5G.png

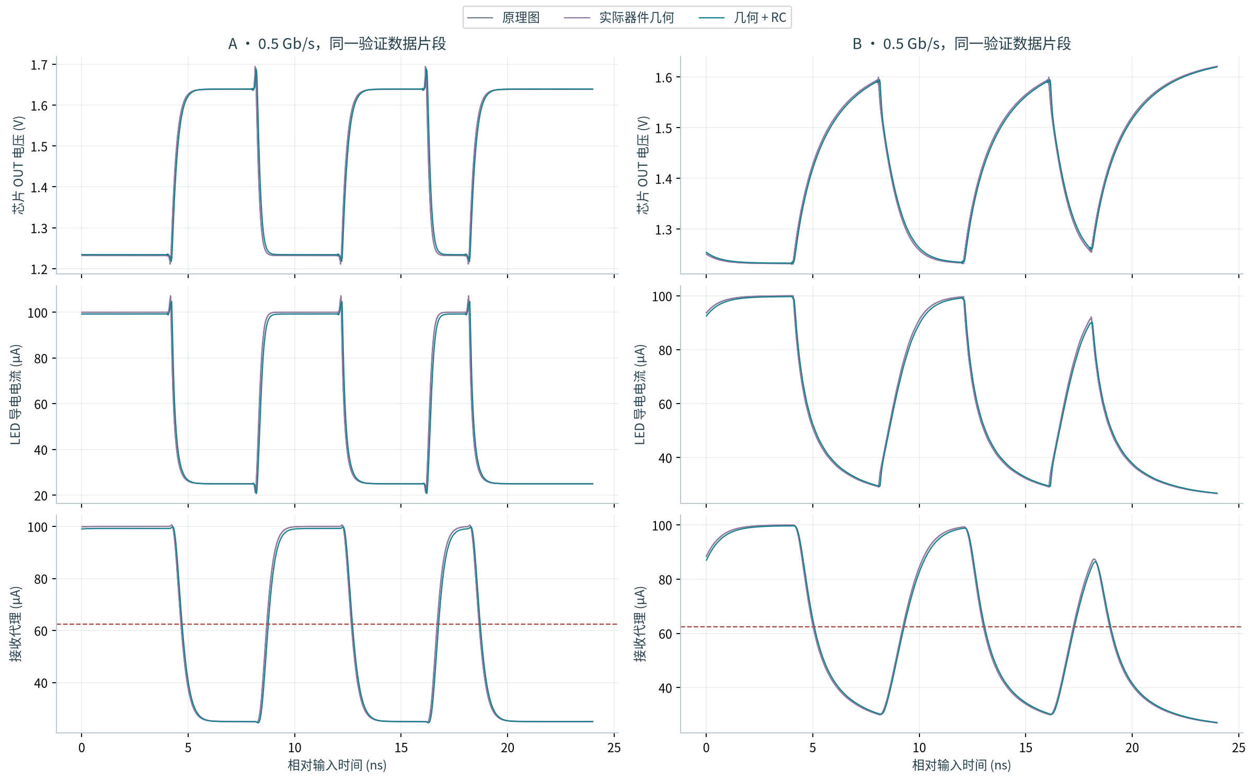
docs/research/highspeed-nrz-pex-20261020/figures/waveforms-0.5G.png
