Kevin-Kaiyo/open-microled-driver-asic/docs/research/highspeed-nrz-pex-20261020/figures/waveforms-2G.png

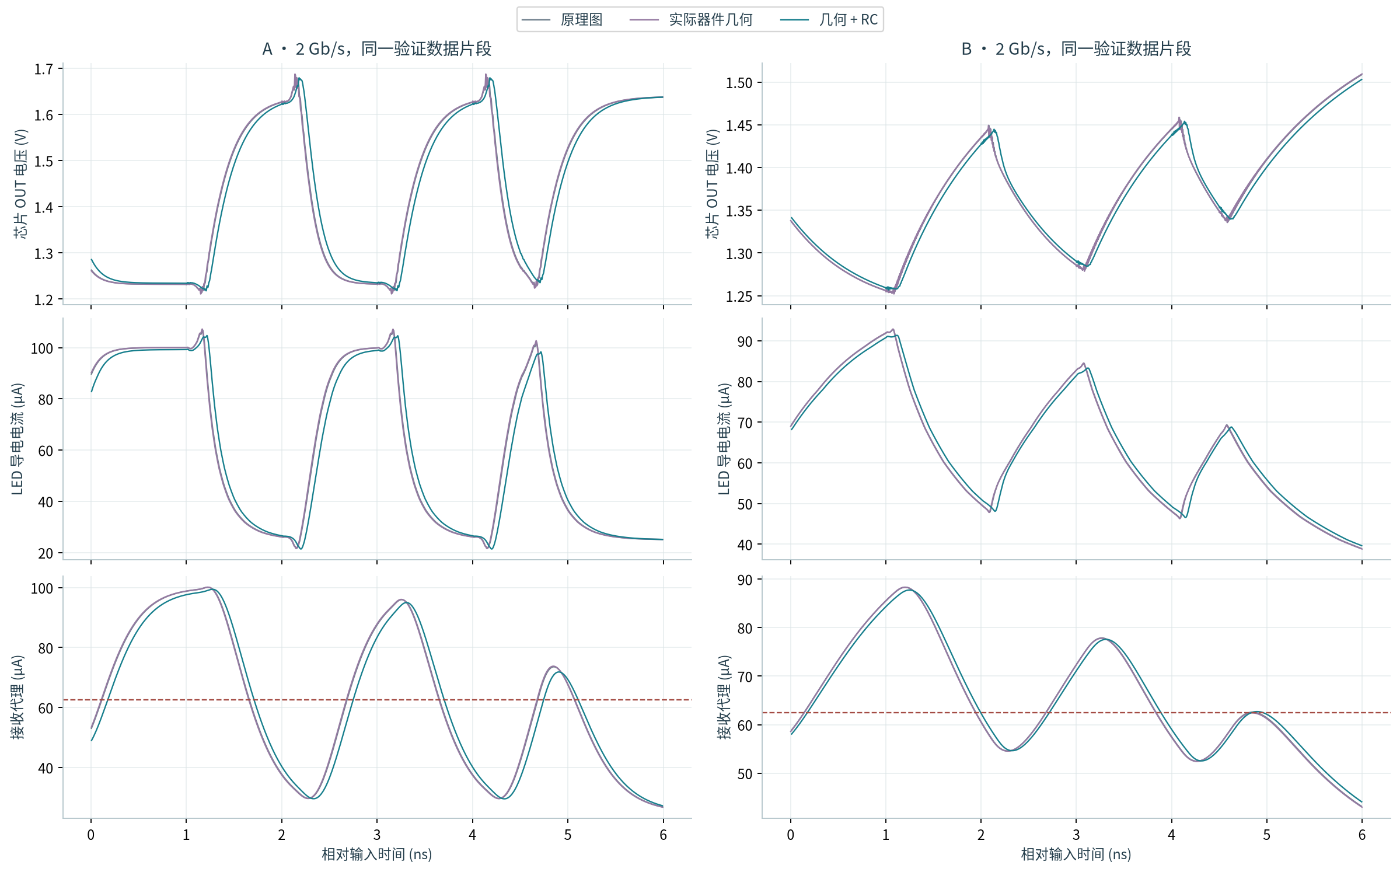
docs/research/highspeed-nrz-pex-20261020/figures/waveforms-2G.png
