Kevin-Kaiyo/open-microled-driver-asic/docs/research/highspeed-nrz-pvt-20261023/figures/baseline-fast-cold-feedthrough.png

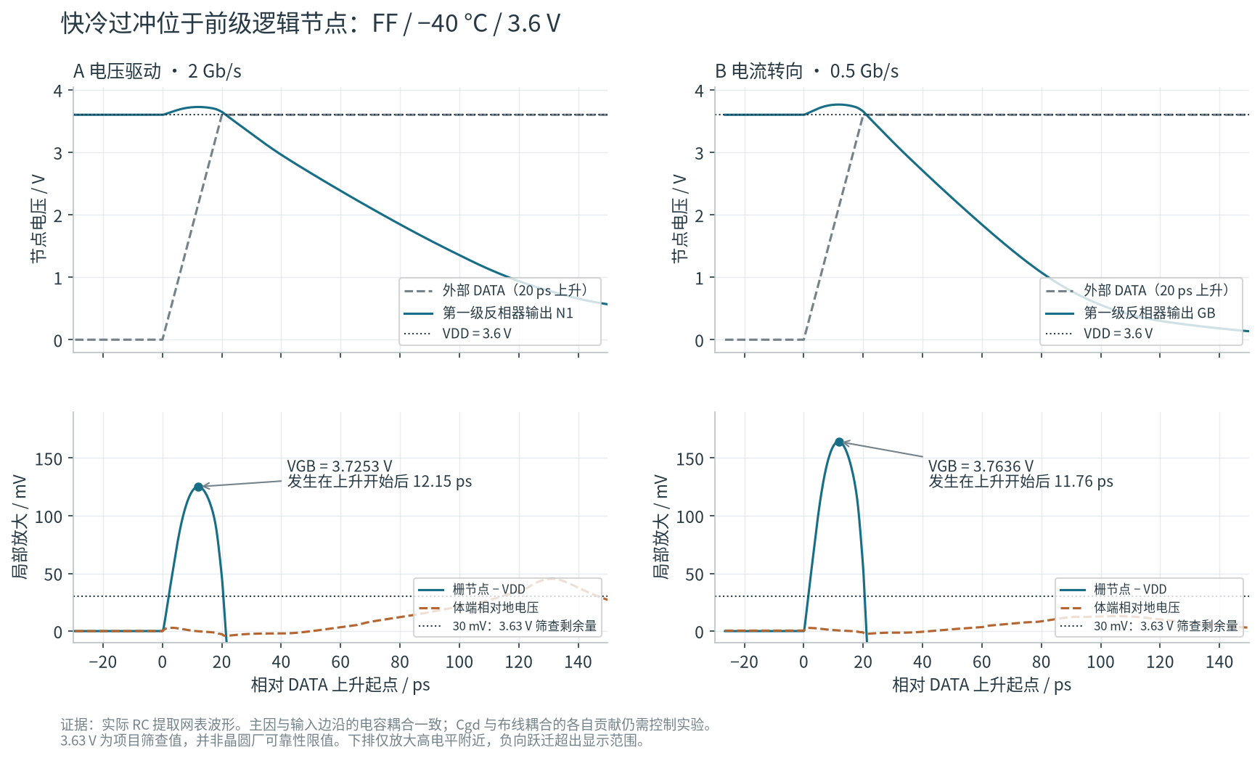
docs/research/highspeed-nrz-pvt-20261023/figures/baseline-fast-cold-feedthrough.png
