Kevin-Kaiyo/open-microled-driver-asic/docs/research/highspeed-nrz-pvt-20261023/figures/baseline-slow-hot-isolated-one.png

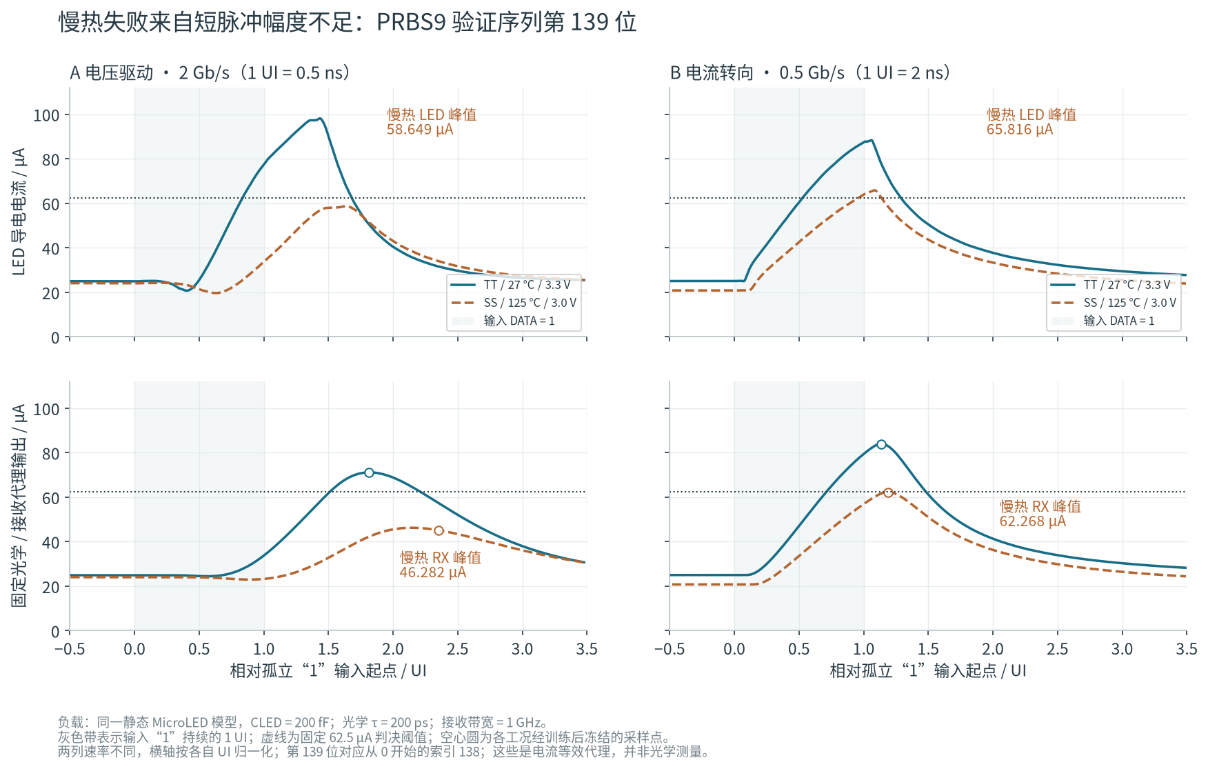
docs/research/highspeed-nrz-pvt-20261023/figures/baseline-slow-hot-isolated-one.png
