Kevin-Kaiyo/open-microled-driver-asic/docs/research/highspeed-nrz-pvt-20261023/figures/layout-B.png

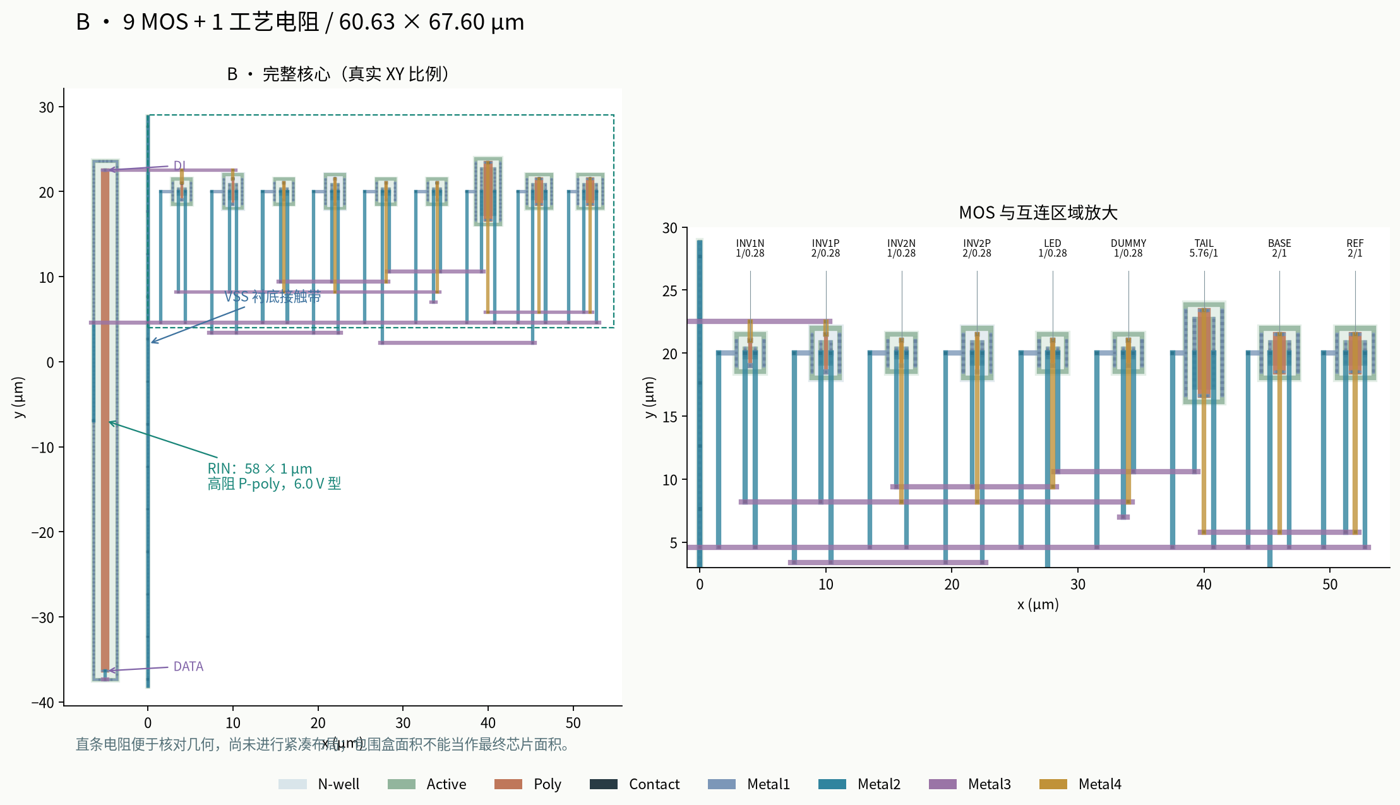
docs/research/highspeed-nrz-pvt-20261023/figures/layout-B.png
