Kevin-Kaiyo/open-microled-driver-asic/docs/research/highspeed-nrz-pvt-20261023/figures/layout-r1-body-bounce.png

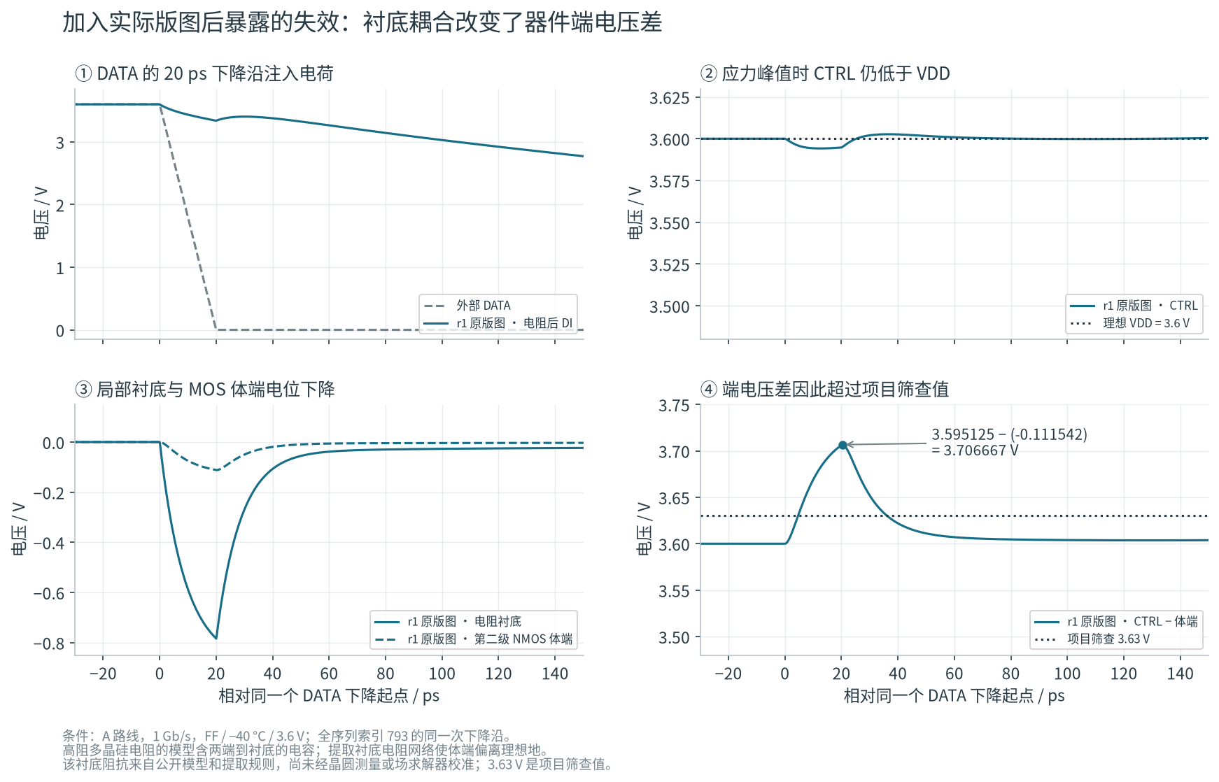
docs/research/highspeed-nrz-pvt-20261023/figures/layout-r1-body-bounce.png
