Kevin-Kaiyo/open-microled-driver-asic/docs/research/highspeed-nrz-pvt-20261023/figures/same-rate-comparison.png

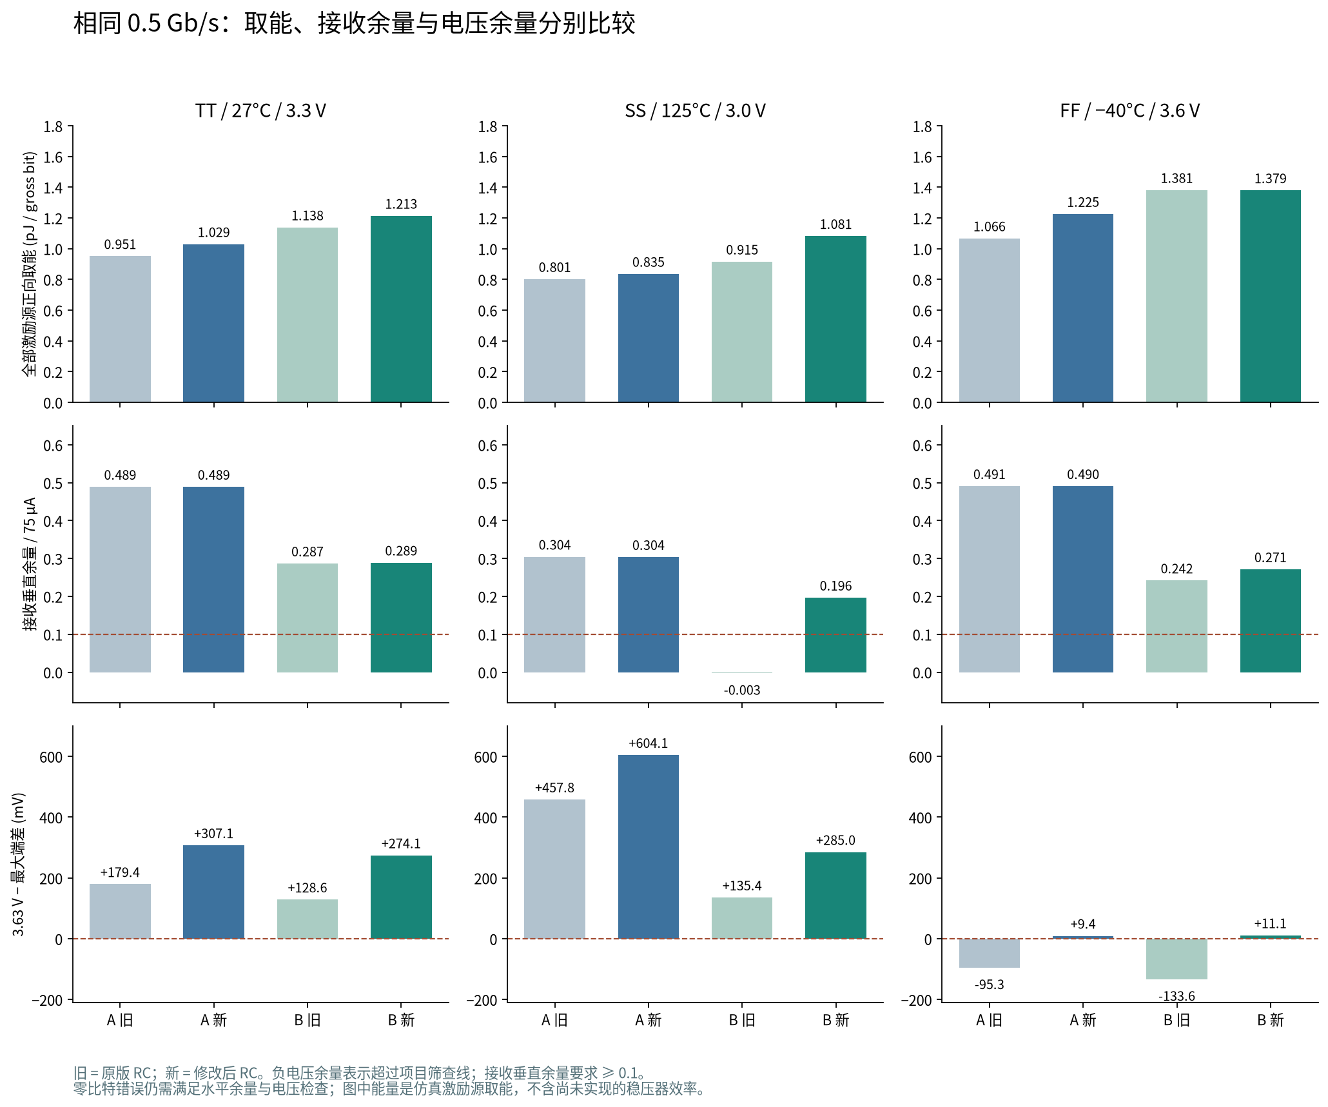
docs/research/highspeed-nrz-pvt-20261023/figures/same-rate-comparison.png
