Kevin-Kaiyo/open-microled-driver-asic/docs/research/highspeed-workbench-20261110/microled-error-controls.png

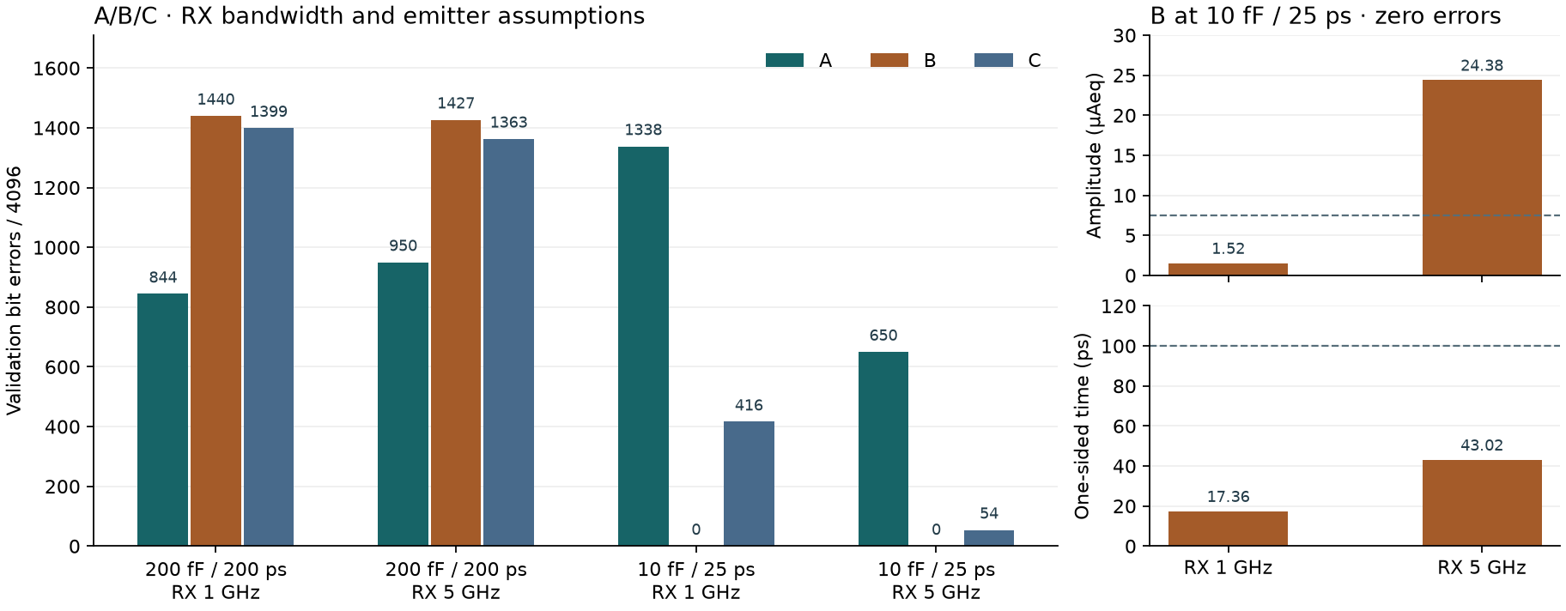
docs/research/highspeed-workbench-20261110/microled-error-controls.png
