Kevin-Kaiyo/open-microled-driver-asic/docs/research/highspeed-workbench-20261110/physical/core-a-3d.png

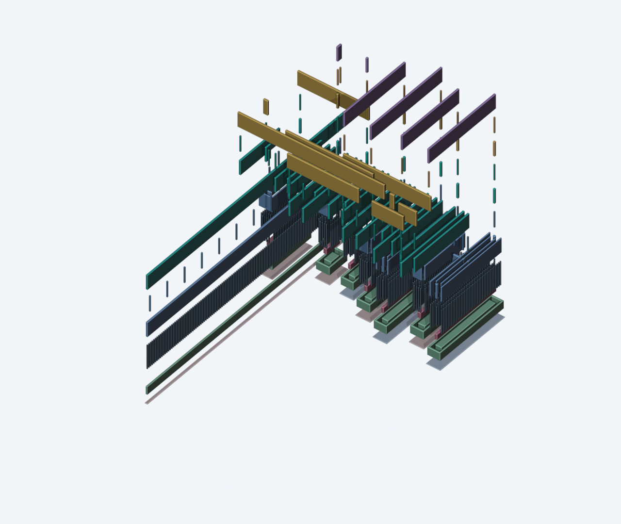
docs/research/highspeed-workbench-20261110/physical/core-a-3d.png
