Kevin-Kaiyo/open-microled-driver-asic/docs/research/highspeed-workbench-20261110/predriver-waveforms.png

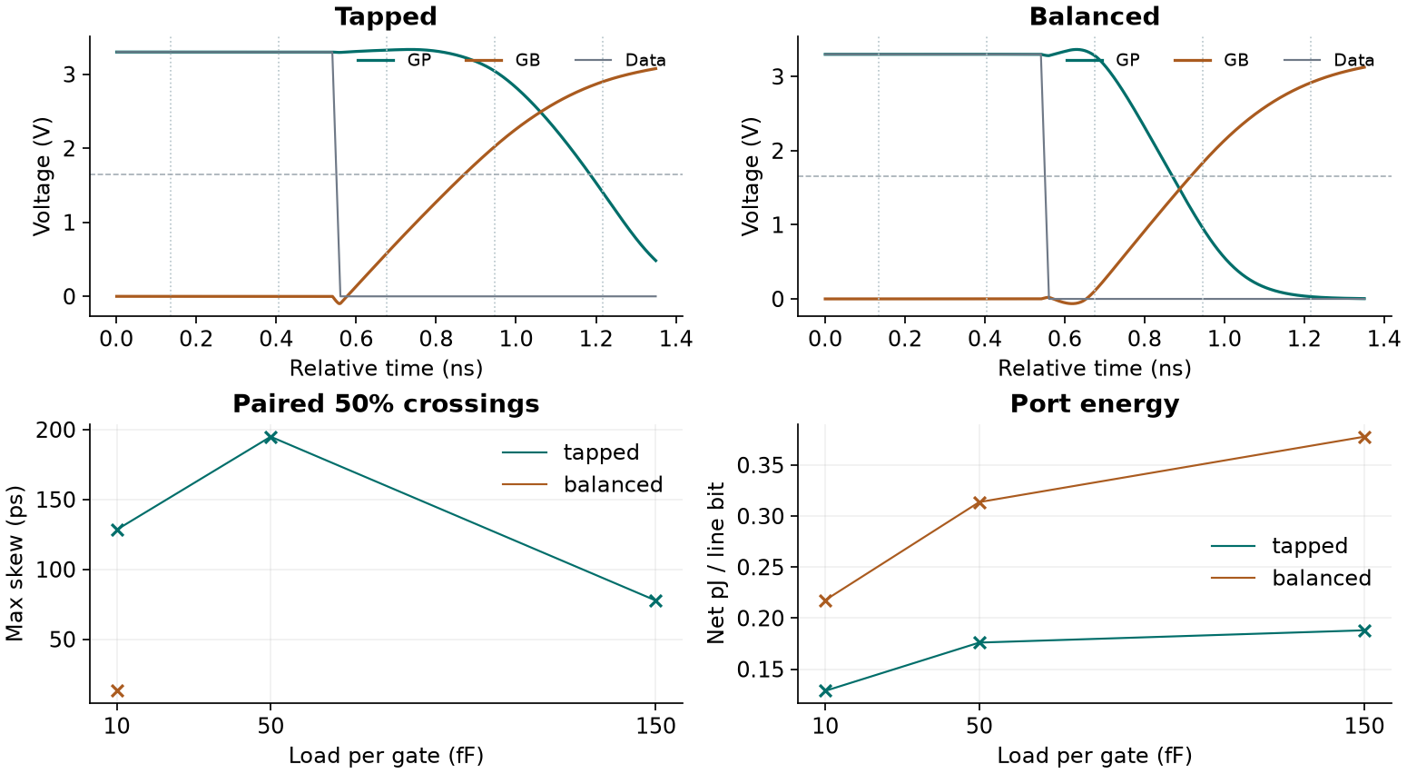
docs/research/highspeed-workbench-20261110/predriver-waveforms.png
