Kevin-Kaiyo/open-microled-driver-asic/docs/research/highspeed-workbench-20261110/vcsel-x10-waveforms.png

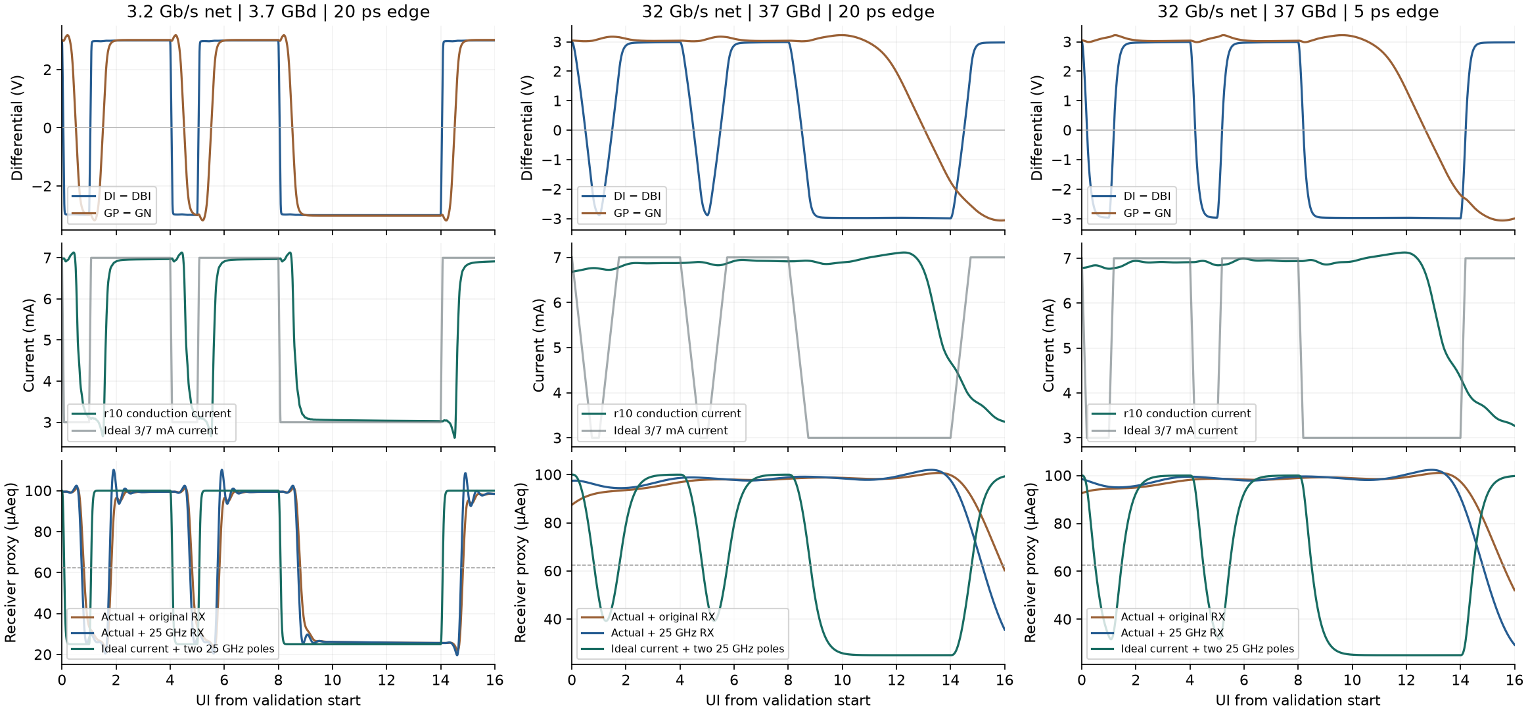
docs/research/highspeed-workbench-20261110/vcsel-x10-waveforms.png
