Kevin-Kaiyo/open-microled-driver-asic/docs/research/microled-device-codesign-20261029/figures/01-device-cross-section.png

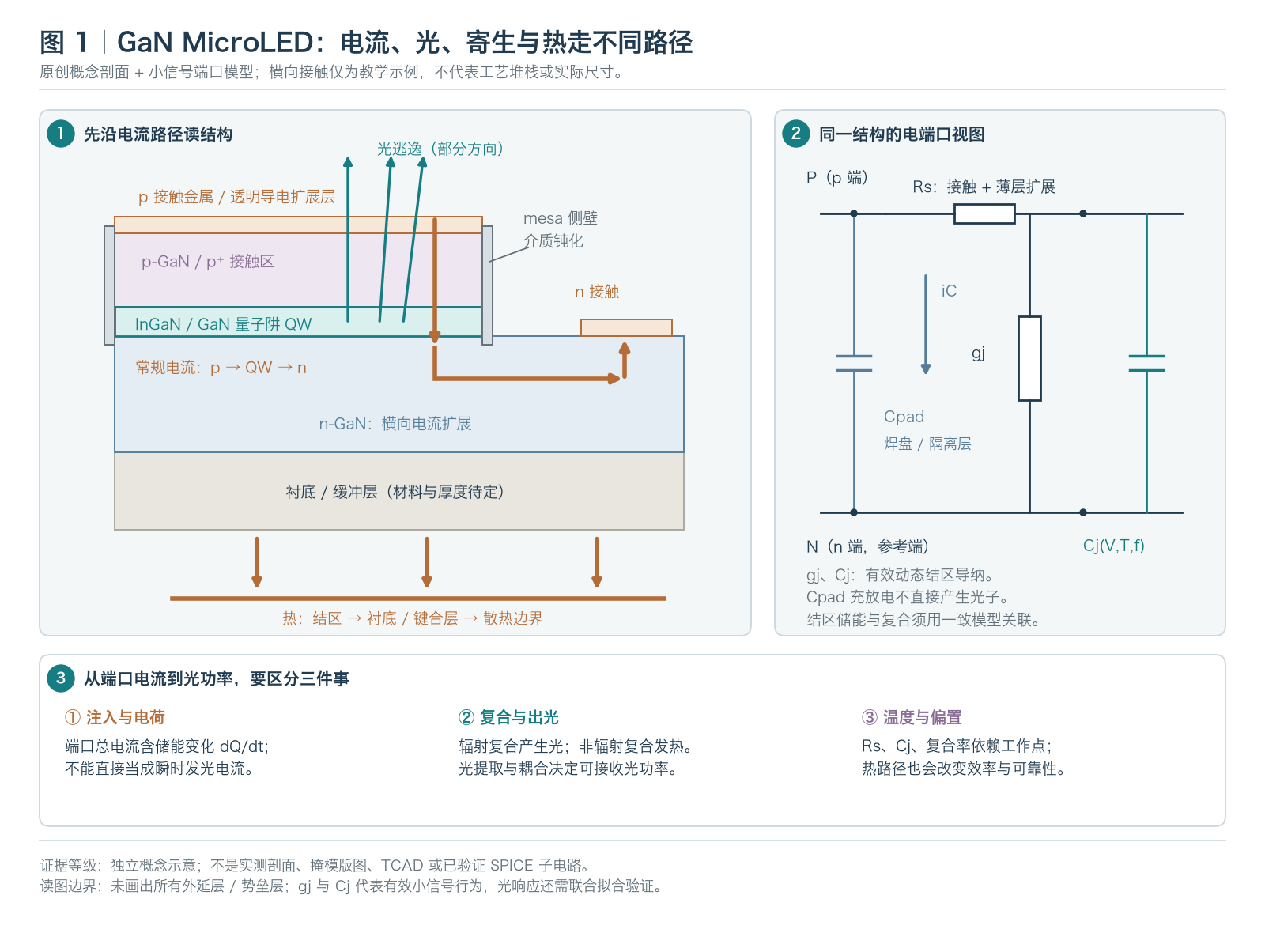
docs/research/microled-device-codesign-20261029/figures/01-device-cross-section.png
