Kevin-Kaiyo/open-microled-driver-asic/docs/research/microled-device-codesign-20261029/figures/02-orientation-quantum-wells.png

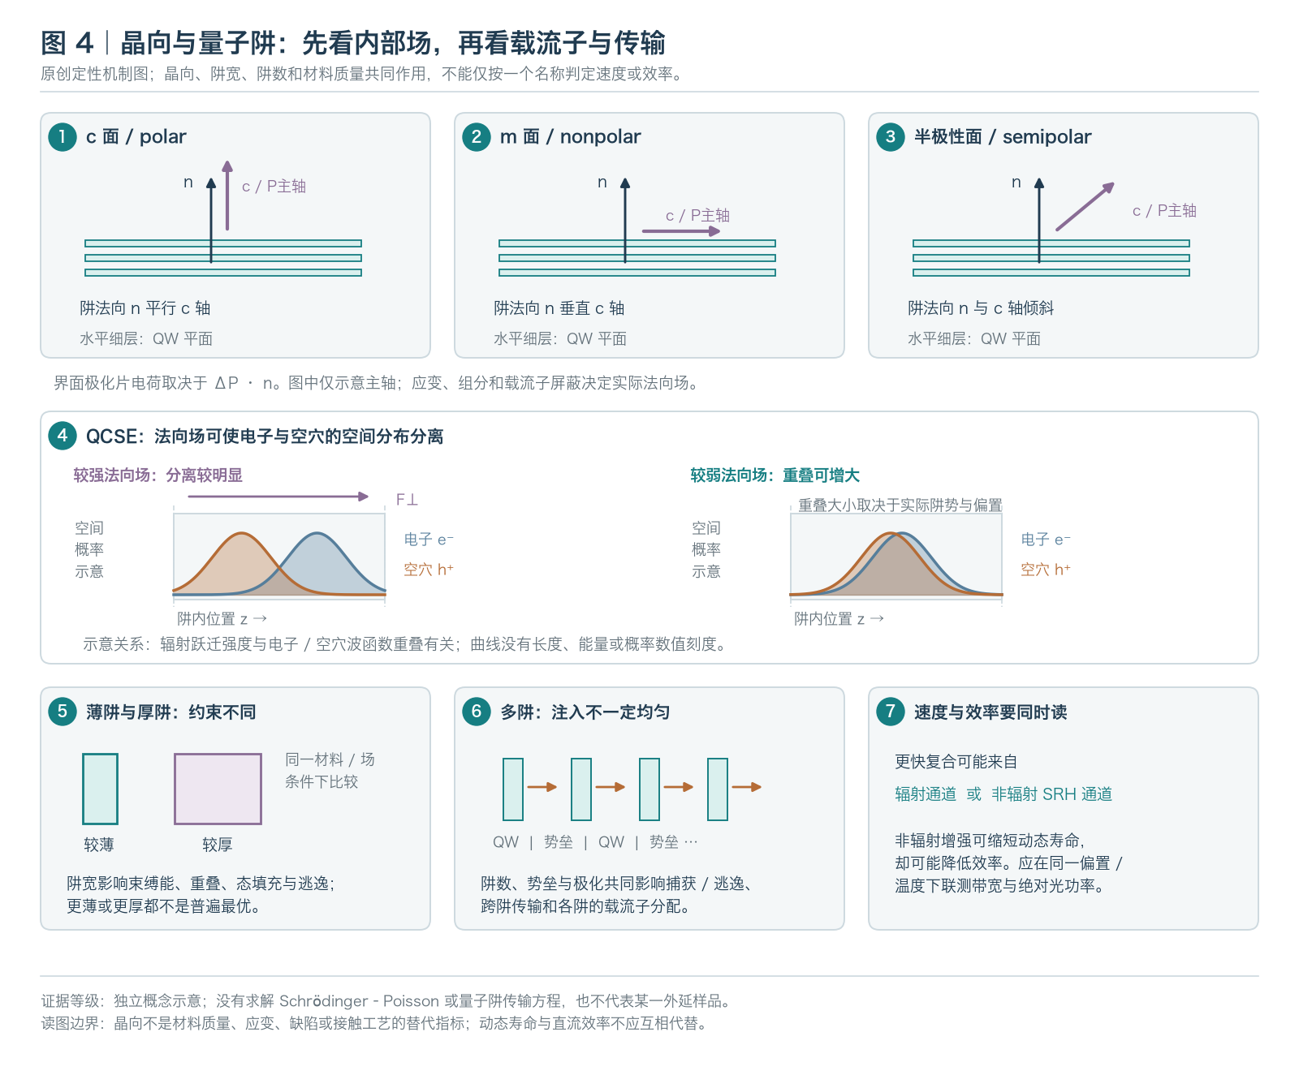
docs/research/microled-device-codesign-20261029/figures/02-orientation-quantum-wells.png
