Kevin-Kaiyo/open-microled-driver-asic/docs/research/microled-device-codesign-20261029/figures/03-size-electrode-tradeoffs.png

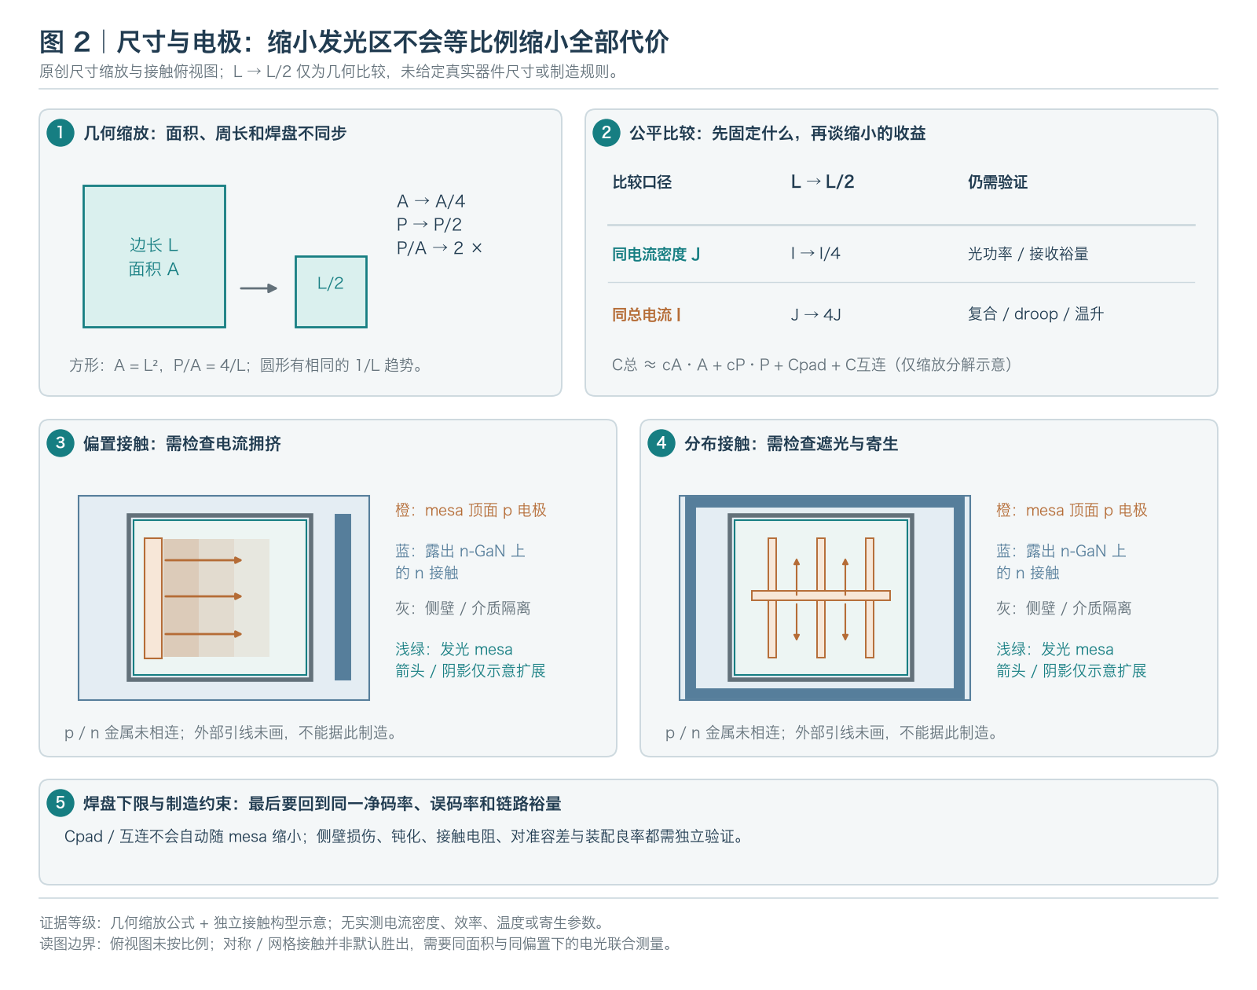
docs/research/microled-device-codesign-20261029/figures/03-size-electrode-tradeoffs.png
