Kevin-Kaiyo/open-microled-driver-asic/docs/research/microled-device-codesign-20261029/figures/04-codesign-reference-planes.png

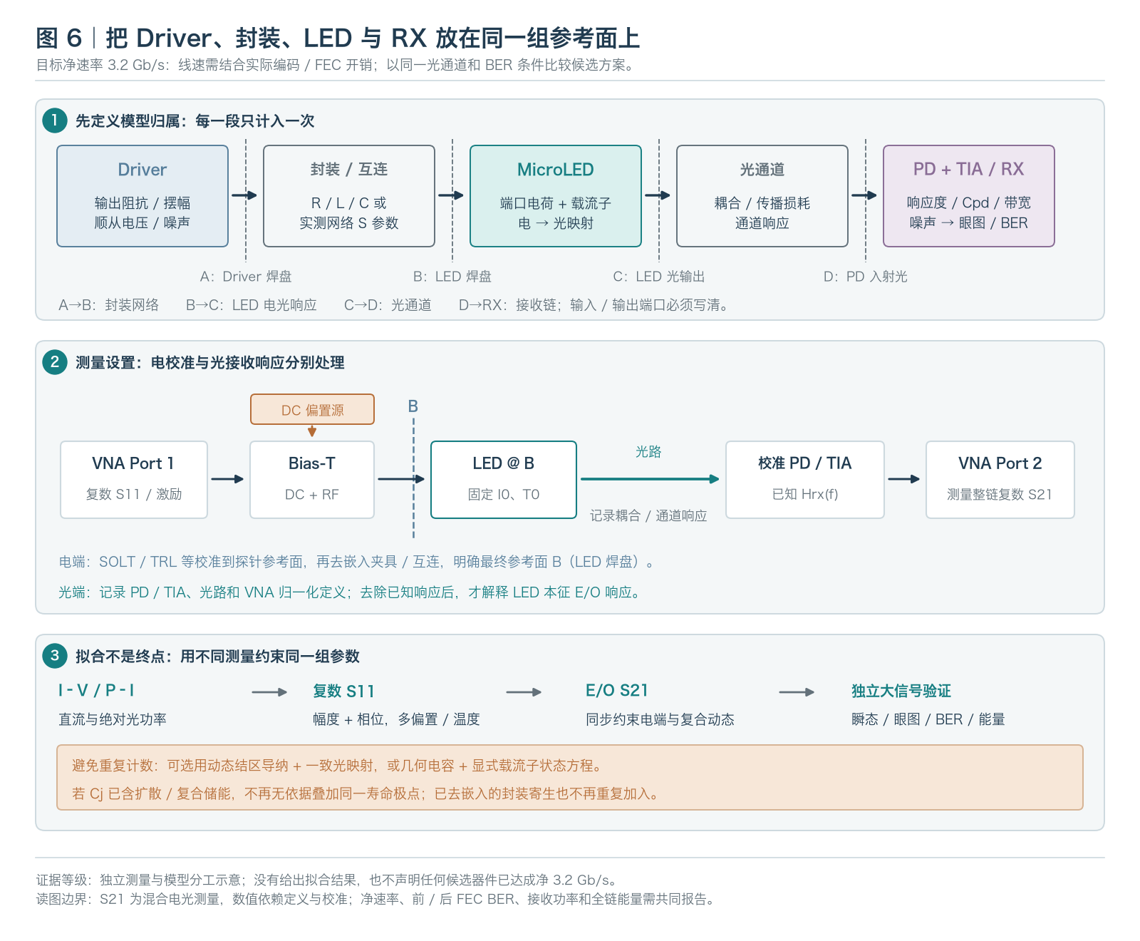
docs/research/microled-device-codesign-20261029/figures/04-codesign-reference-planes.png
