Kevin-Kaiyo/open-microled-driver-asic/docs/research/microled-device-codesign-20261029/figures/05-within-study-bandwidth.png

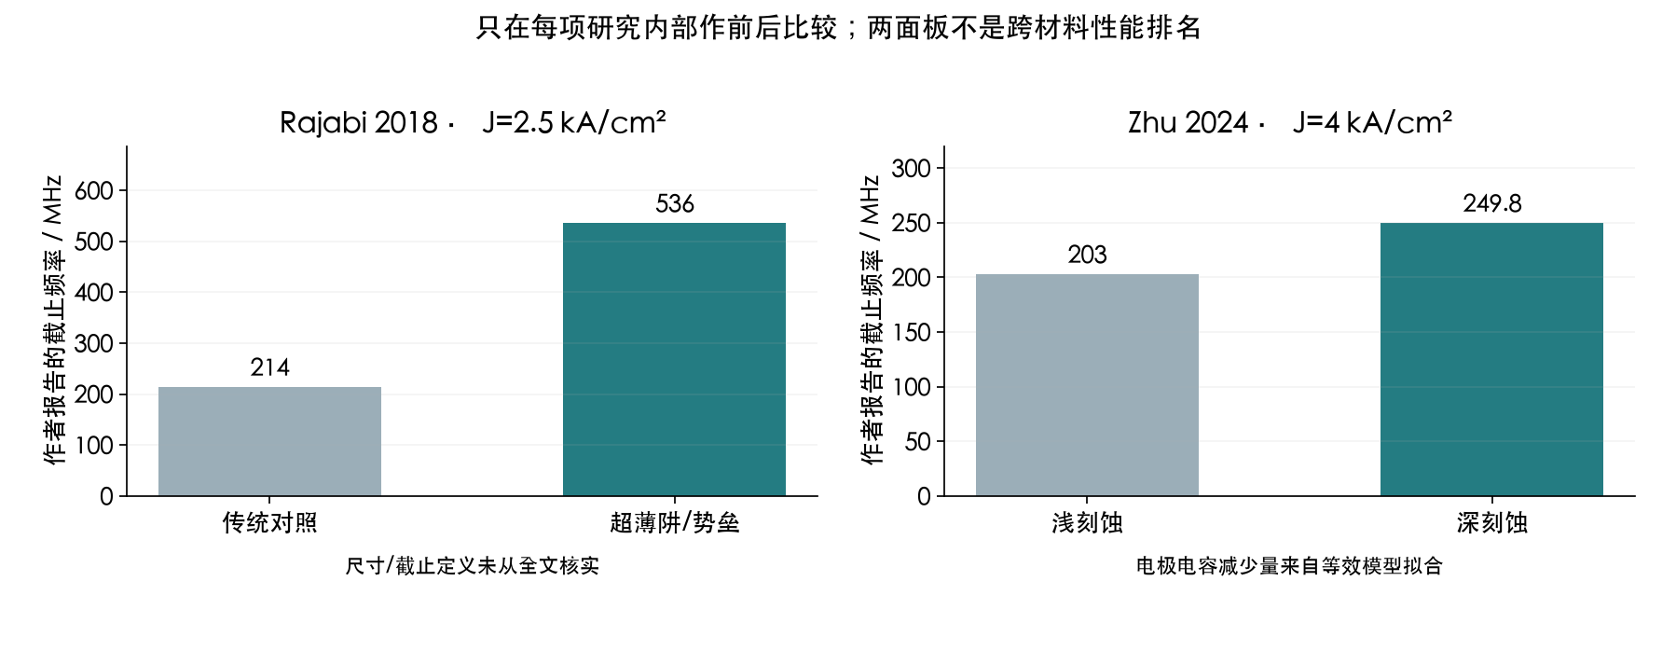
docs/research/microled-device-codesign-20261029/figures/05-within-study-bandwidth.png
