Kevin-Kaiyo/open-microled-driver-asic/docs/research/microled-device-codesign-20261029/figures/06-size-rc-illustration.png

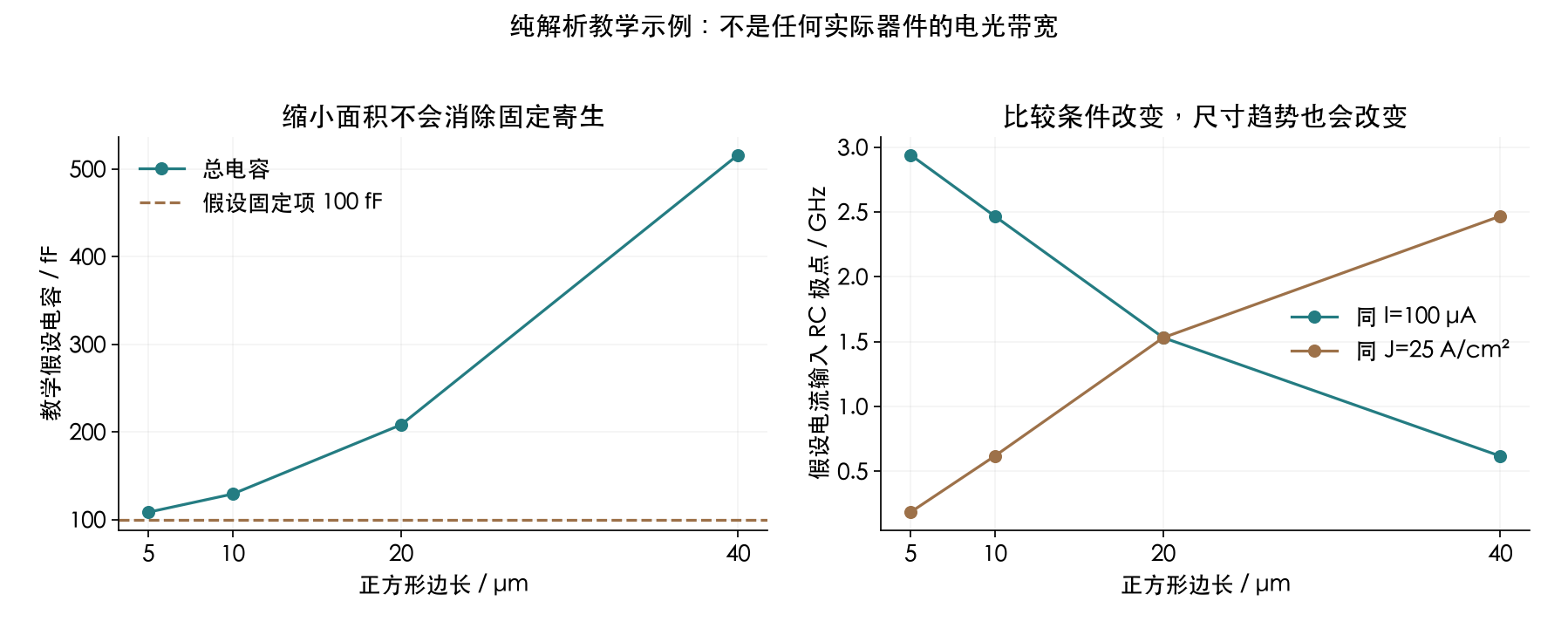
docs/research/microled-device-codesign-20261029/figures/06-size-rc-illustration.png
