Kevin-Kaiyo/open-microled-driver-asic/docs/research/nrz-b-reference-power-20261024/electrical-figures/selected-startup.png

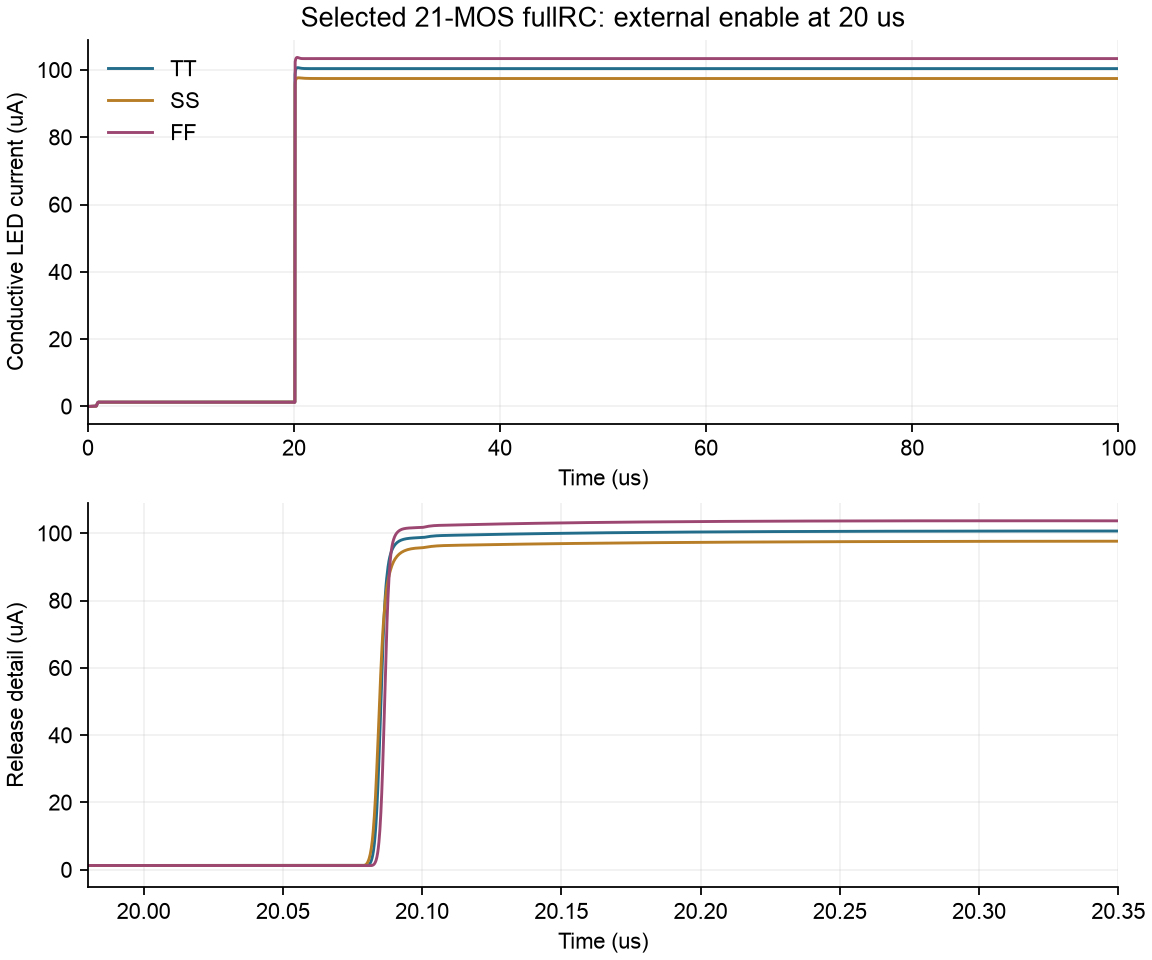
docs/research/nrz-b-reference-power-20261024/electrical-figures/selected-startup.png
