Kevin-Kaiyo/open-microled-driver-asic/docs/research/nrz-b-reference-power-20261024/figures/board-power-circuit.png

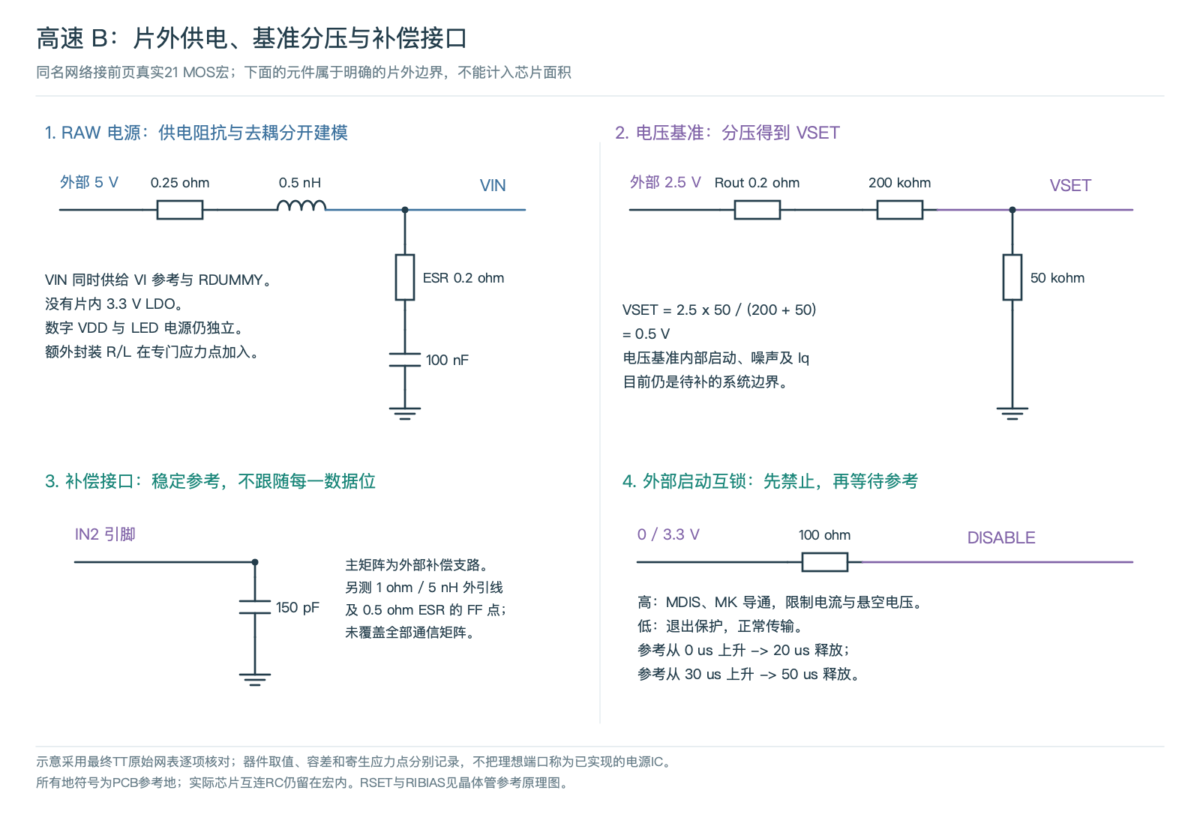
docs/research/nrz-b-reference-power-20261024/figures/board-power-circuit.png
