Kevin-Kaiyo/open-microled-driver-asic/docs/research/nrz-b-reference-power-20261024/figures/body-junction-powerdown.png

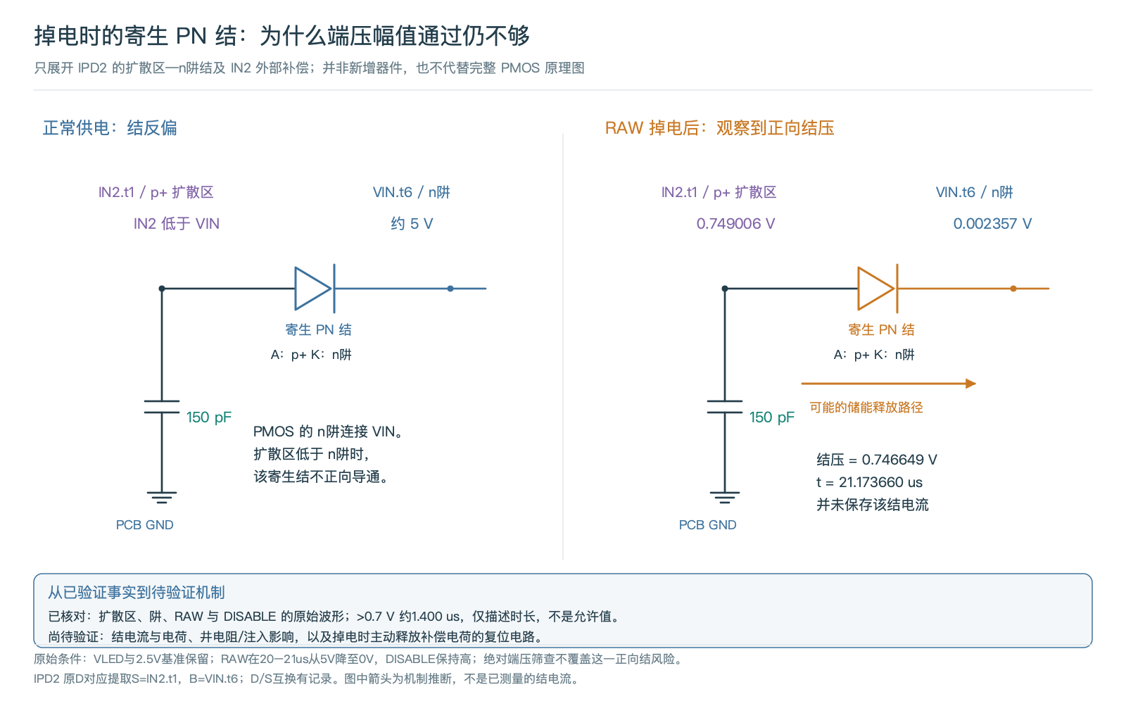
docs/research/nrz-b-reference-power-20261024/figures/body-junction-powerdown.png
