Kevin-Kaiyo/open-microled-driver-asic/docs/research/nrz-b-reference-power-20261024/figures/nrz-r1-comparison.png

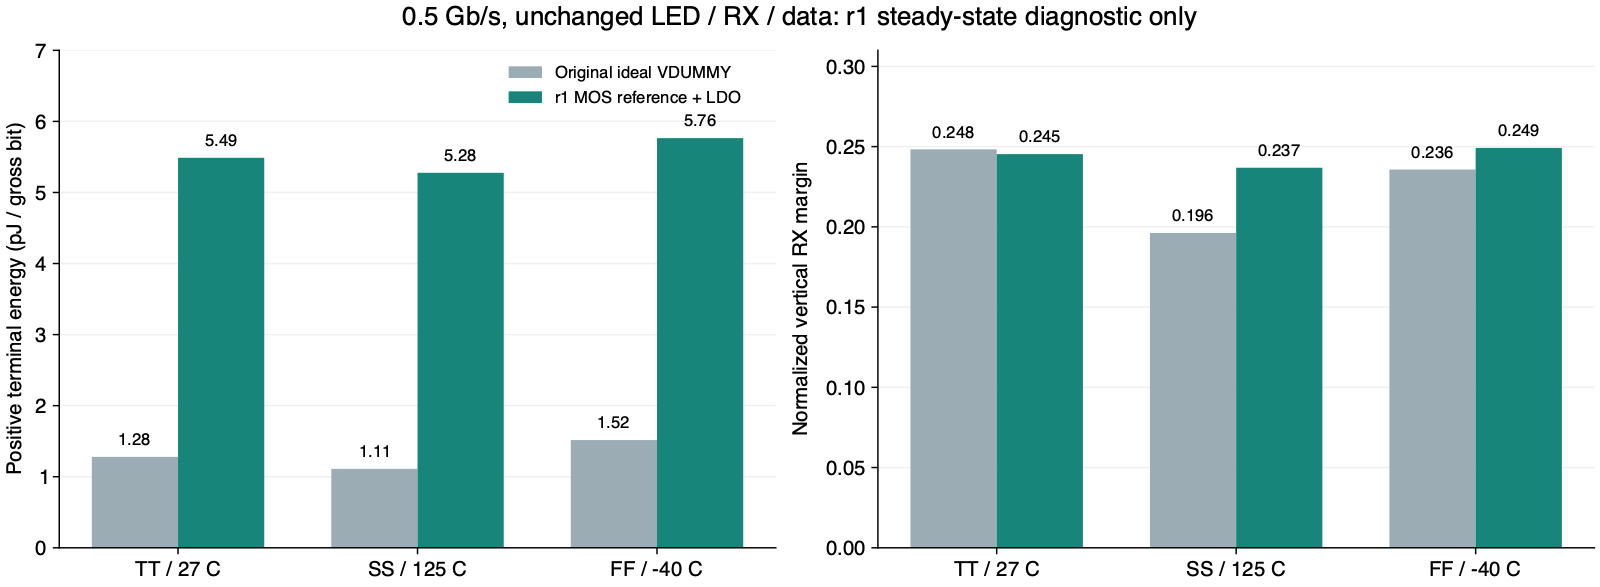
docs/research/nrz-b-reference-power-20261024/figures/nrz-r1-comparison.png
