Kevin-Kaiyo/open-microled-driver-asic/docs/research/nrz-b-reference-power-20261024/figures/rset-tolerance.png

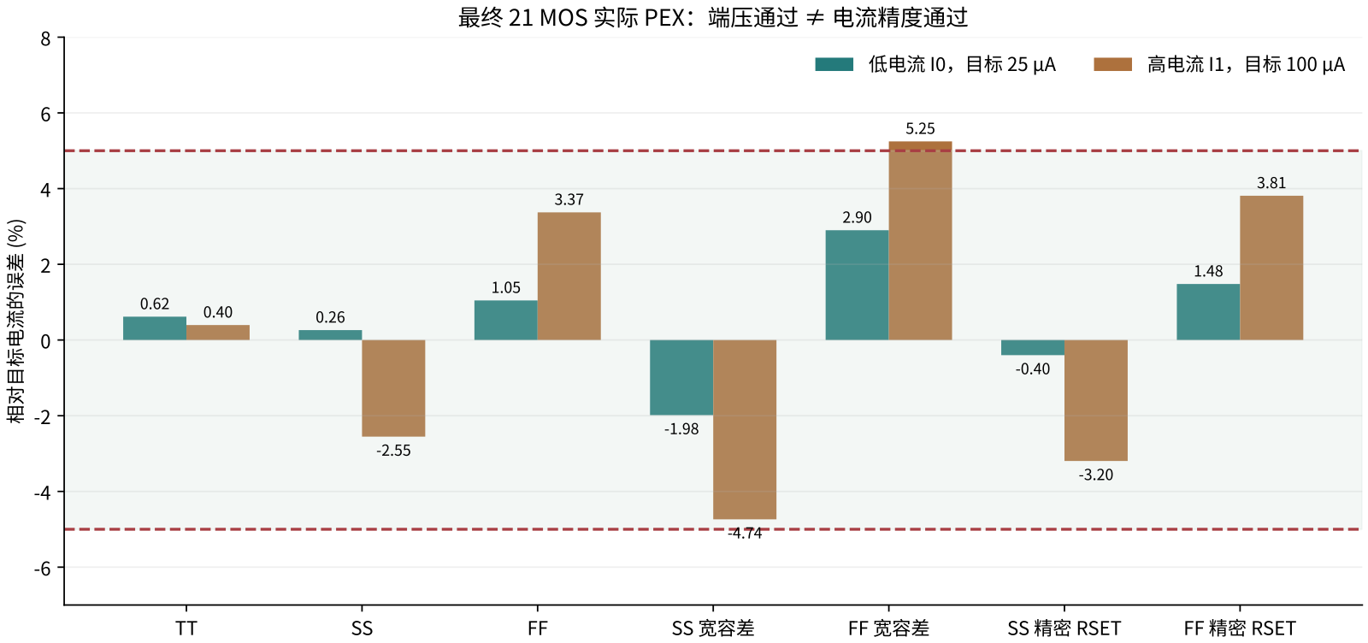
docs/research/nrz-b-reference-power-20261024/figures/rset-tolerance.png
