Kevin-Kaiyo/open-microled-driver-asic/docs/research/nrz-b-reference-power-20261024/figures/vi-servo-r1.png

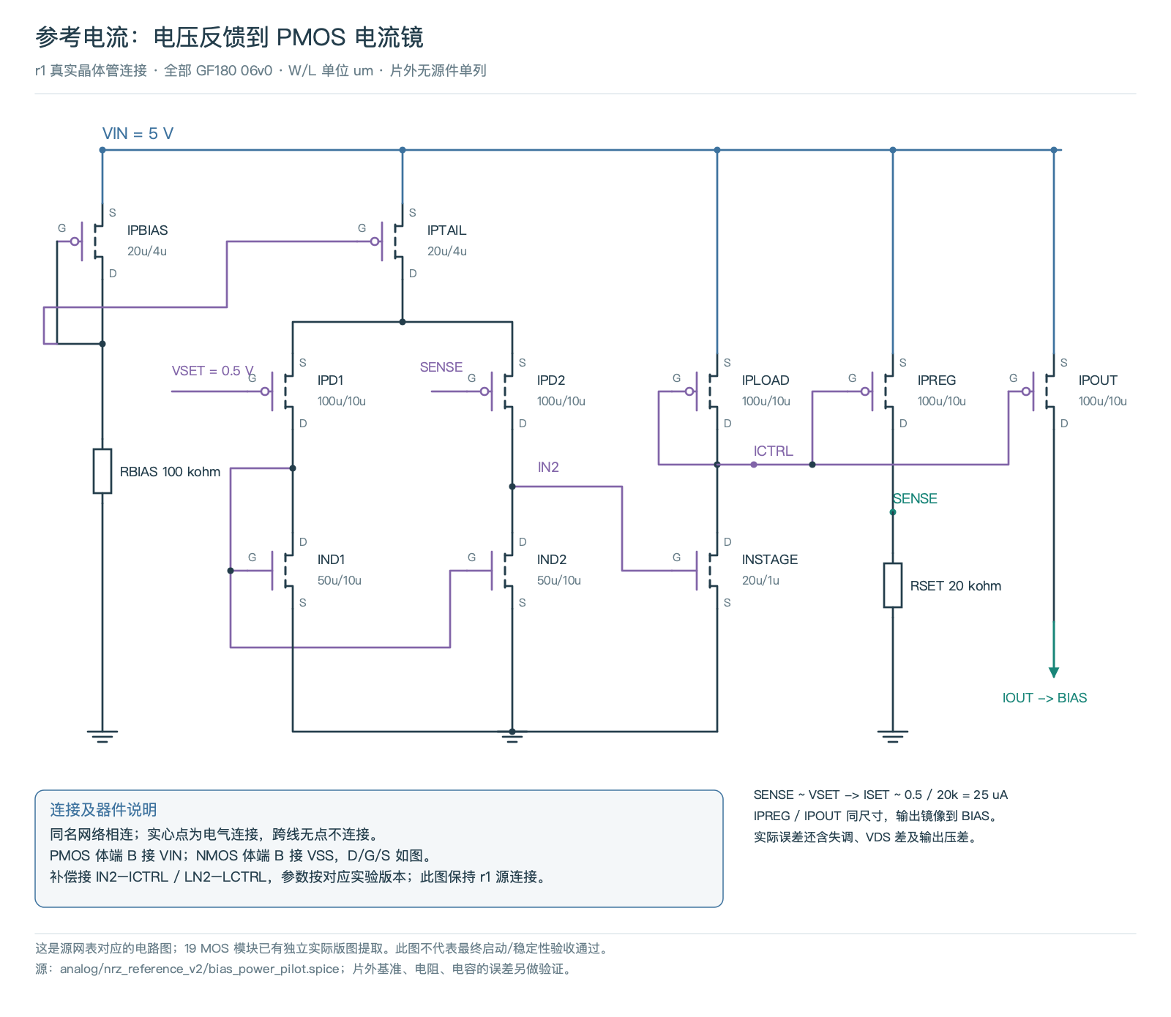
docs/research/nrz-b-reference-power-20261024/figures/vi-servo-r1.png
