Kevin-Kaiyo/open-microled-driver-asic/docs/research/product-framework-20261014/figures/highspeed-bandwidth.png

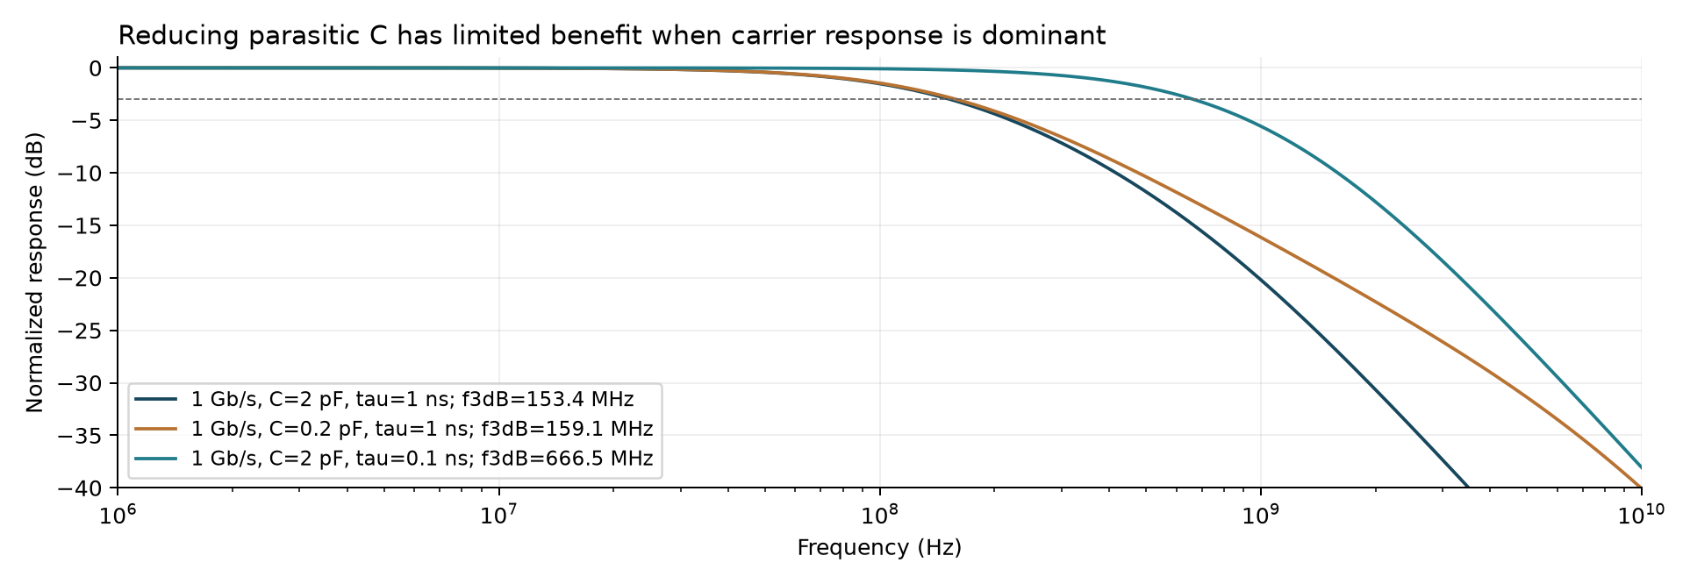
docs/research/product-framework-20261014/figures/highspeed-bandwidth.png
