Kevin-Kaiyo/open-microled-driver-asic/docs/research/product-framework-20261014/layout/pixel-3d-projection.png

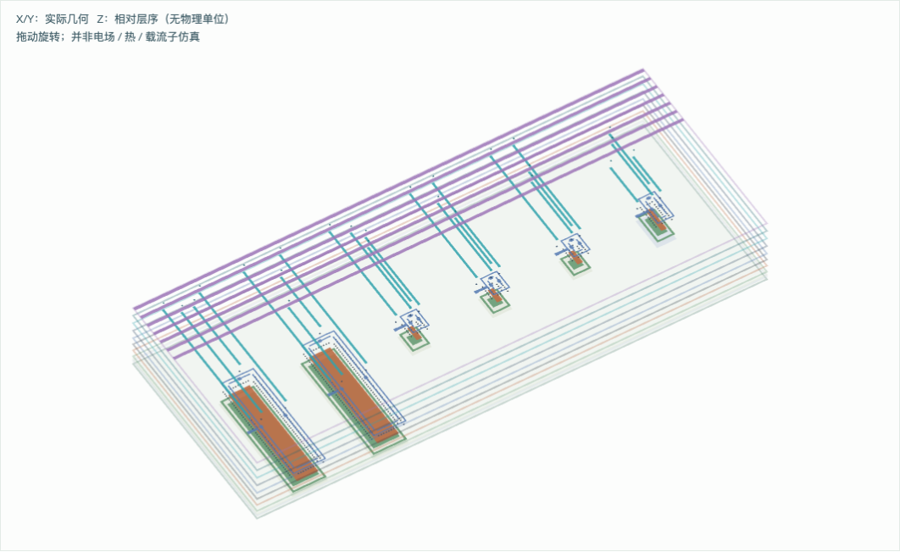
docs/research/product-framework-20261014/layout/pixel-3d-projection.png
