Kevin-Kaiyo/open-microled-driver-asic/docs/research/product-framework-20261014/layout/viewer-3d.png

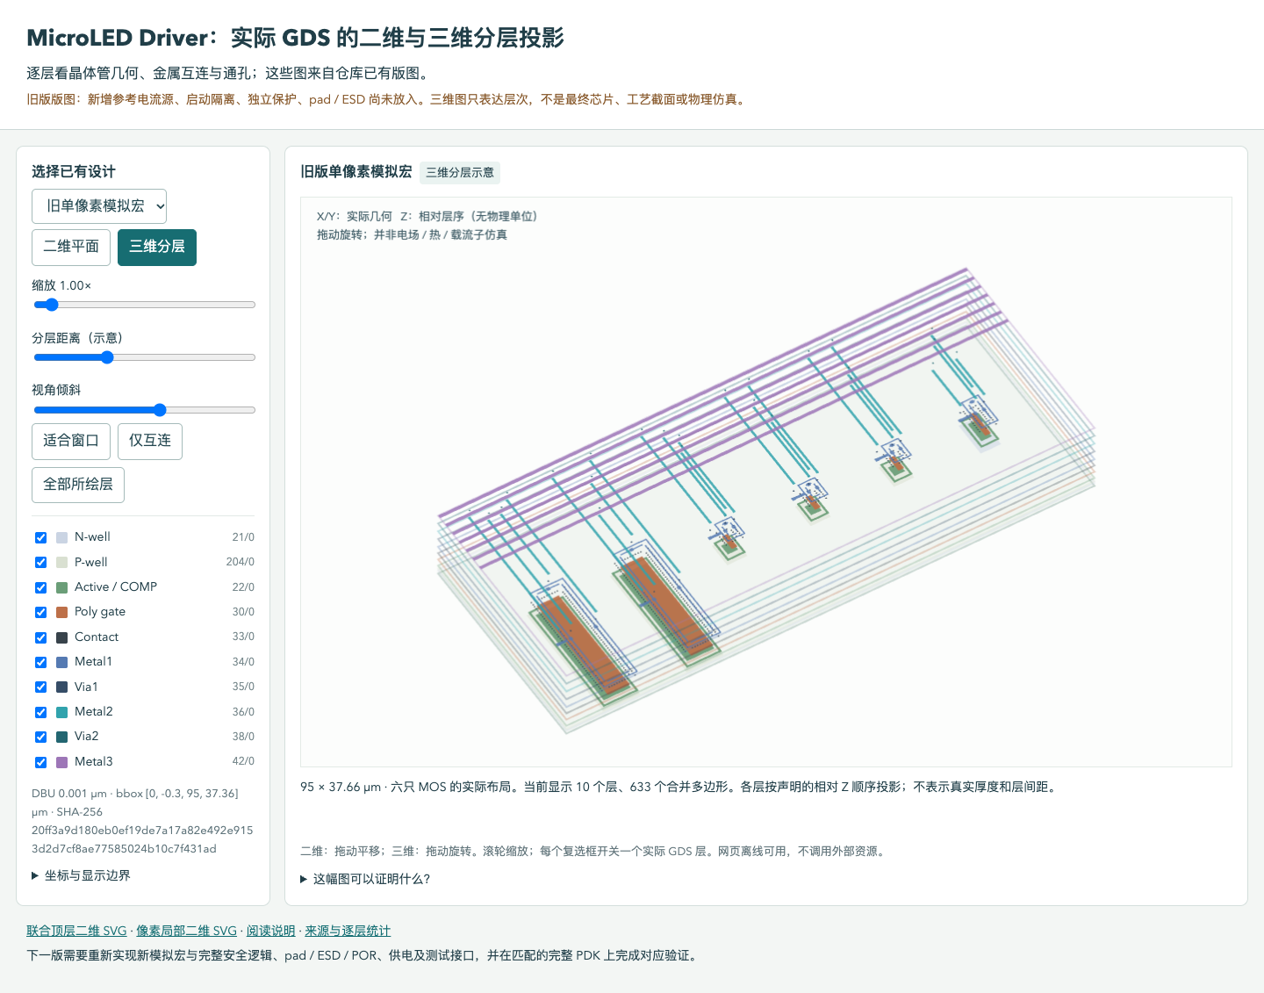
docs/research/product-framework-20261014/layout/viewer-3d.png
