Kevin-Kaiyo/open-microled-driver-asic/docs/research/product-framework-20261014/layout/viewer-mobile.png

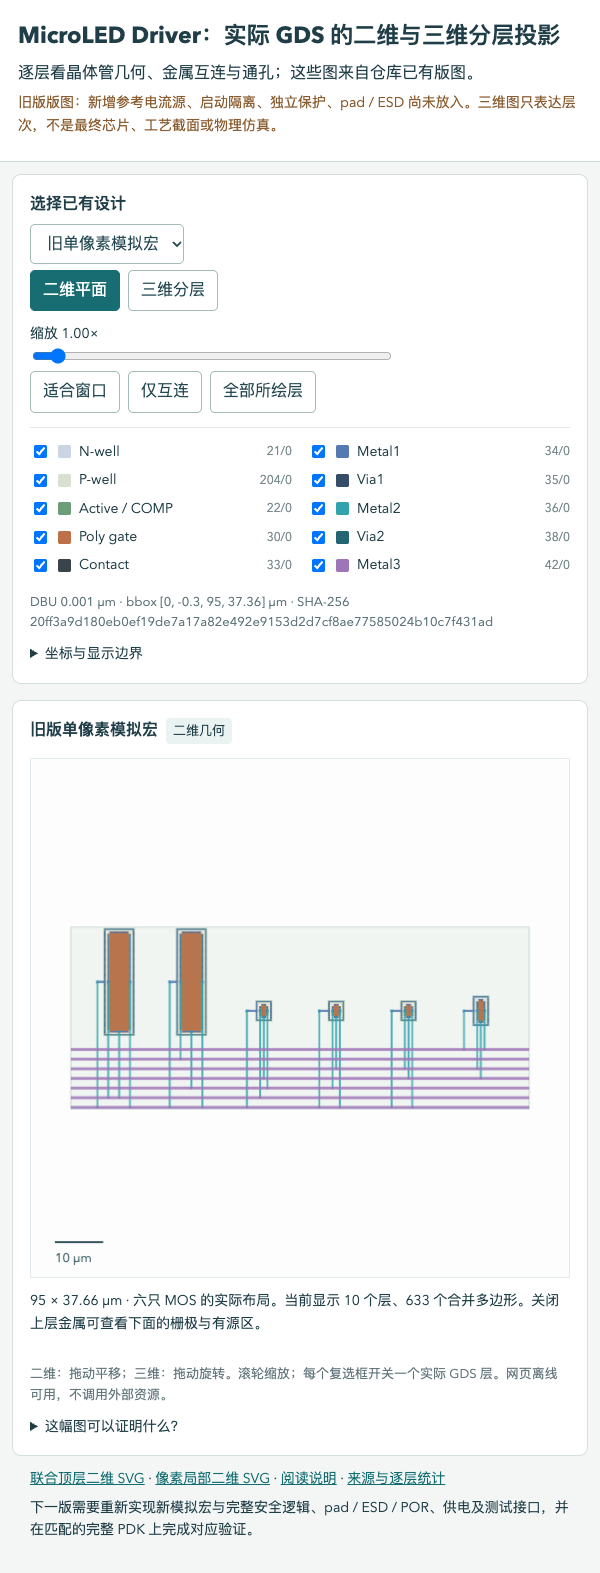
docs/research/product-framework-20261014/layout/viewer-mobile.png
