Kevin-Kaiyo/open-microled-driver-asic/docs/research/pwm-reference-startup-20261024/electrical-figures/供电动态容差.png

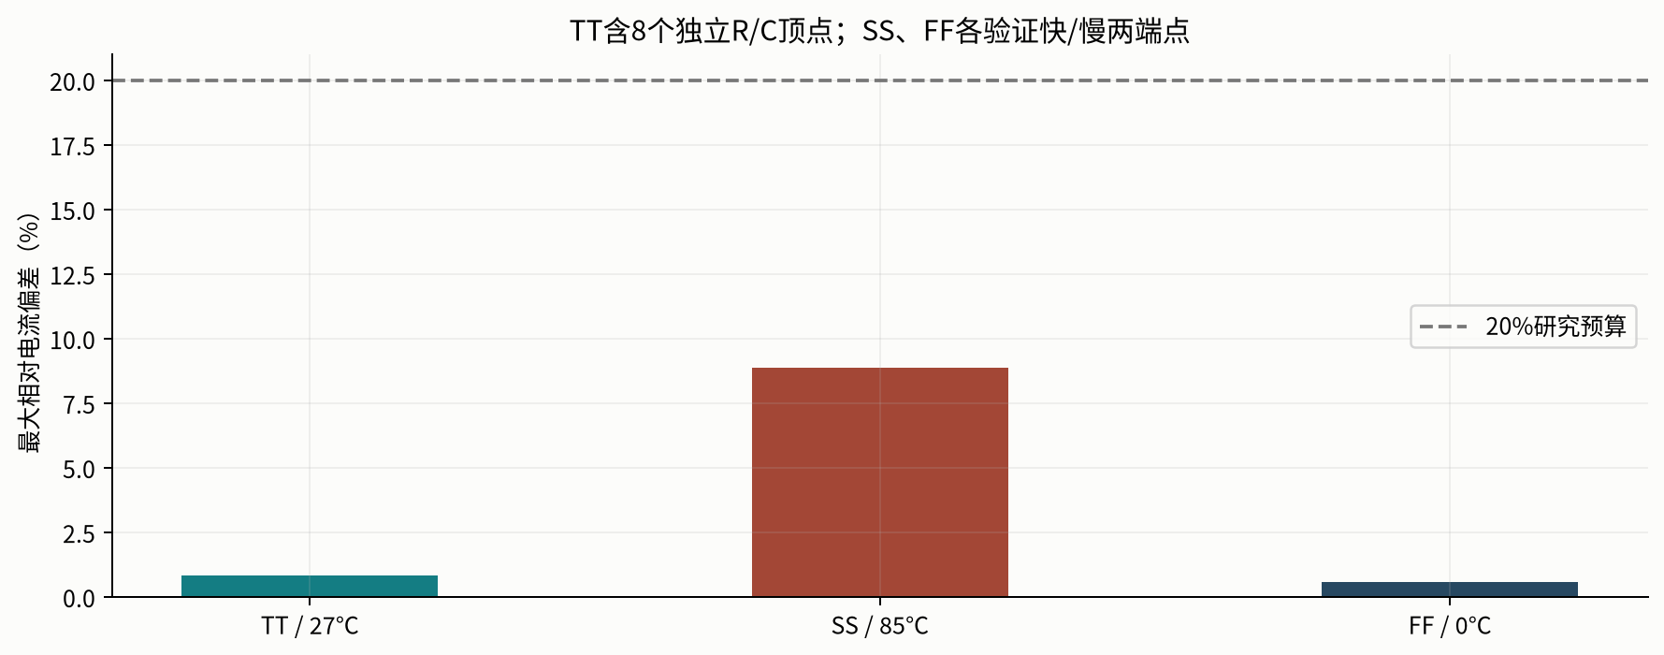
docs/research/pwm-reference-startup-20261024/electrical-figures/供电动态容差.png
