Kevin-Kaiyo/open-microled-driver-asic/docs/research/pwm-reference-startup-20261024/electrical-figures/供电阶跃与恢复.png

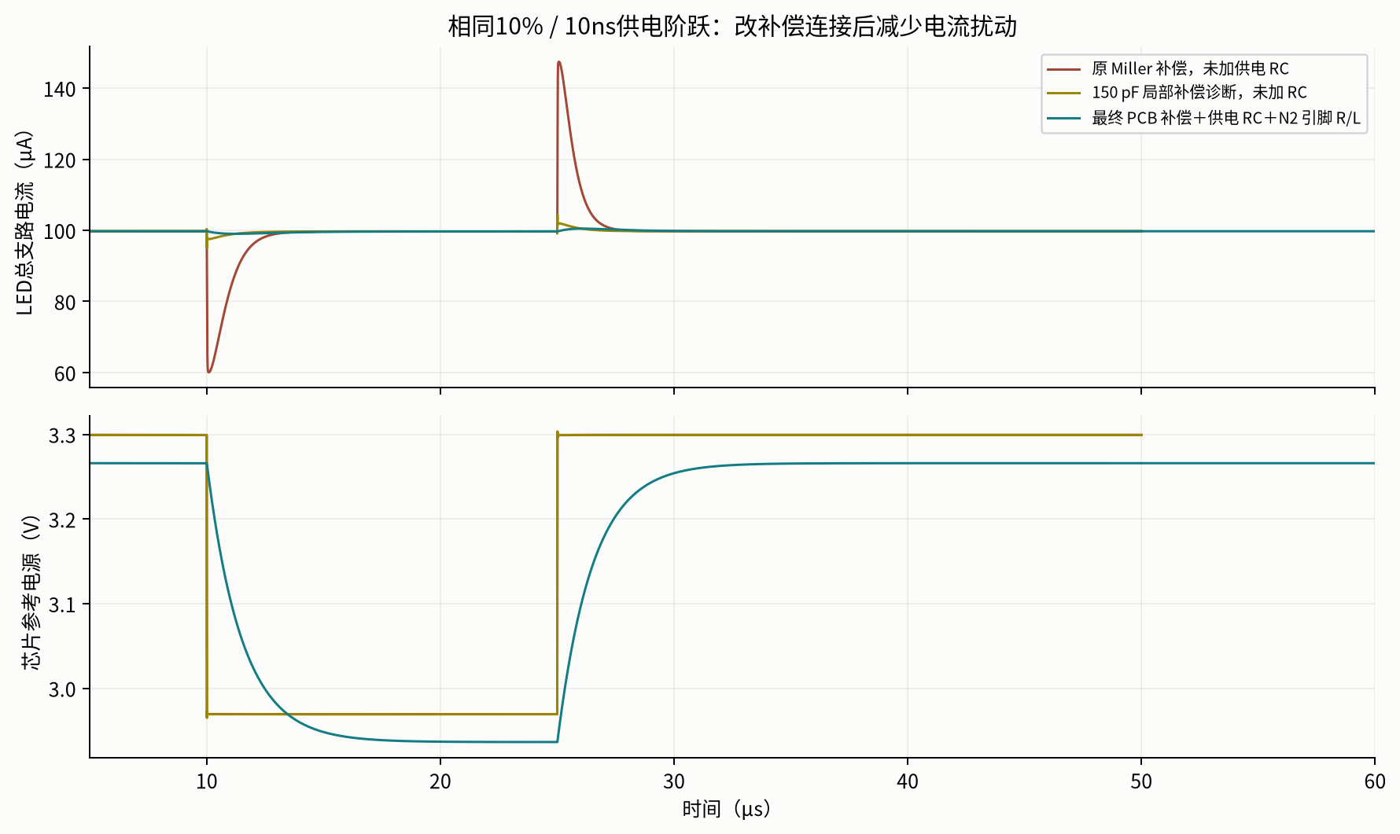
docs/research/pwm-reference-startup-20261024/electrical-figures/供电阶跃与恢复.png
