Kevin-Kaiyo/open-microled-driver-asic/docs/research/pwm-reference-startup-20261024/electrical-figures/启动保持与许可.png

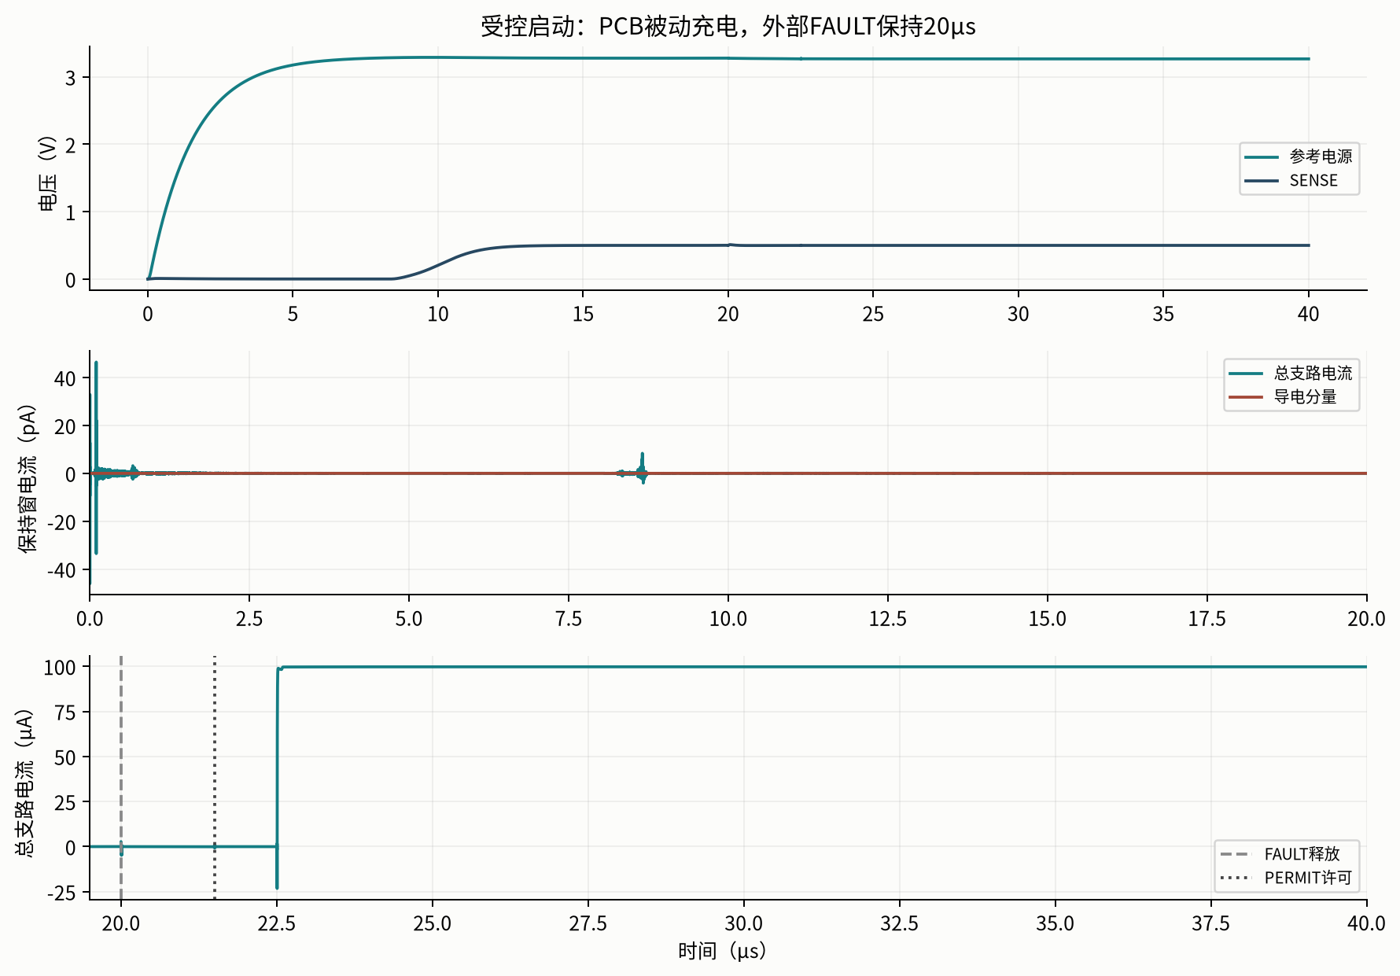
docs/research/pwm-reference-startup-20261024/electrical-figures/启动保持与许可.png
