Kevin-Kaiyo/open-microled-driver-asic/docs/research/pwm-reference-startup-20261024/electrical-figures/局部环路对照.png

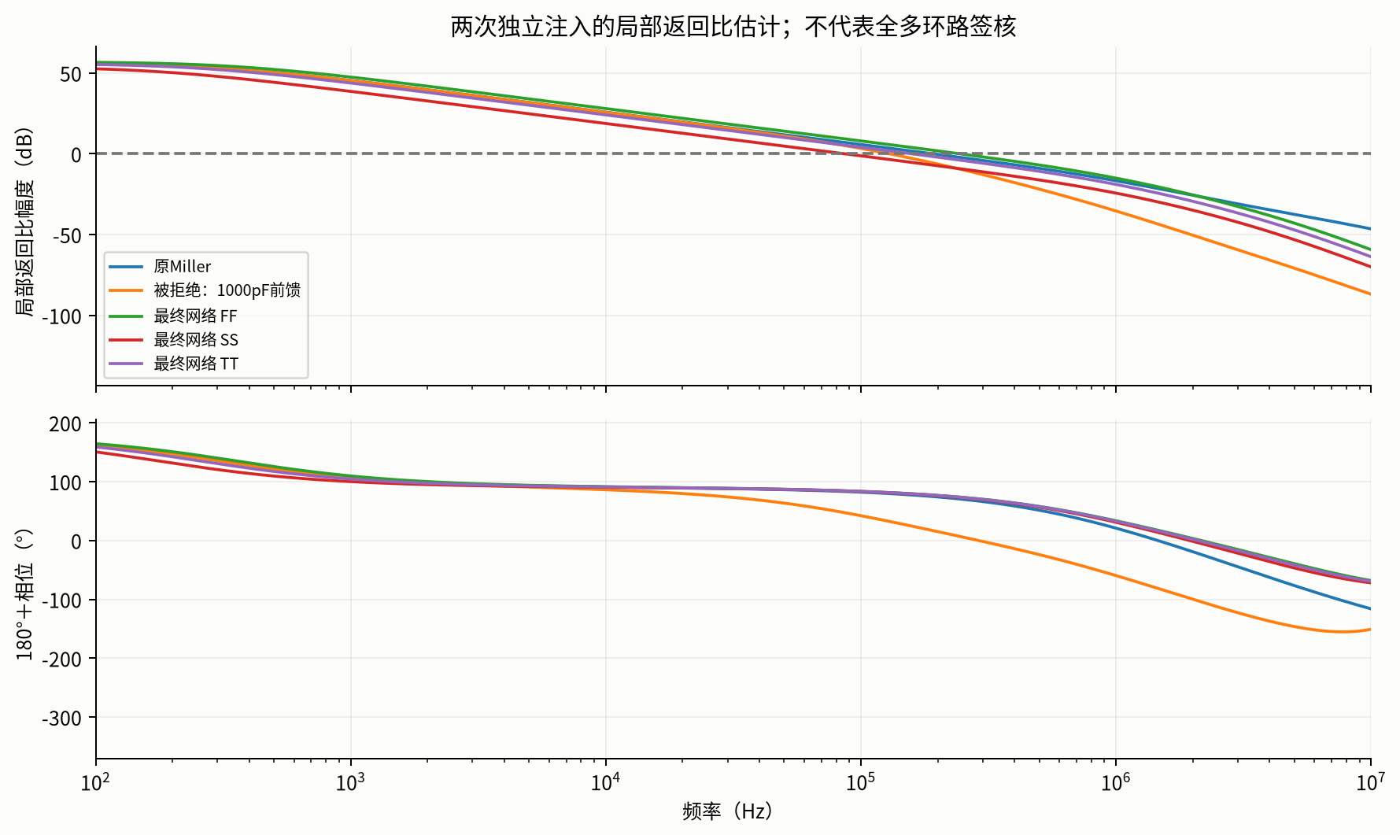
docs/research/pwm-reference-startup-20261024/electrical-figures/局部环路对照.png
