Kevin-Kaiyo/open-microled-driver-asic/docs/research/pwm-reference-startup-20261024/electrical-figures/直流PVT与独立电阻角落.png

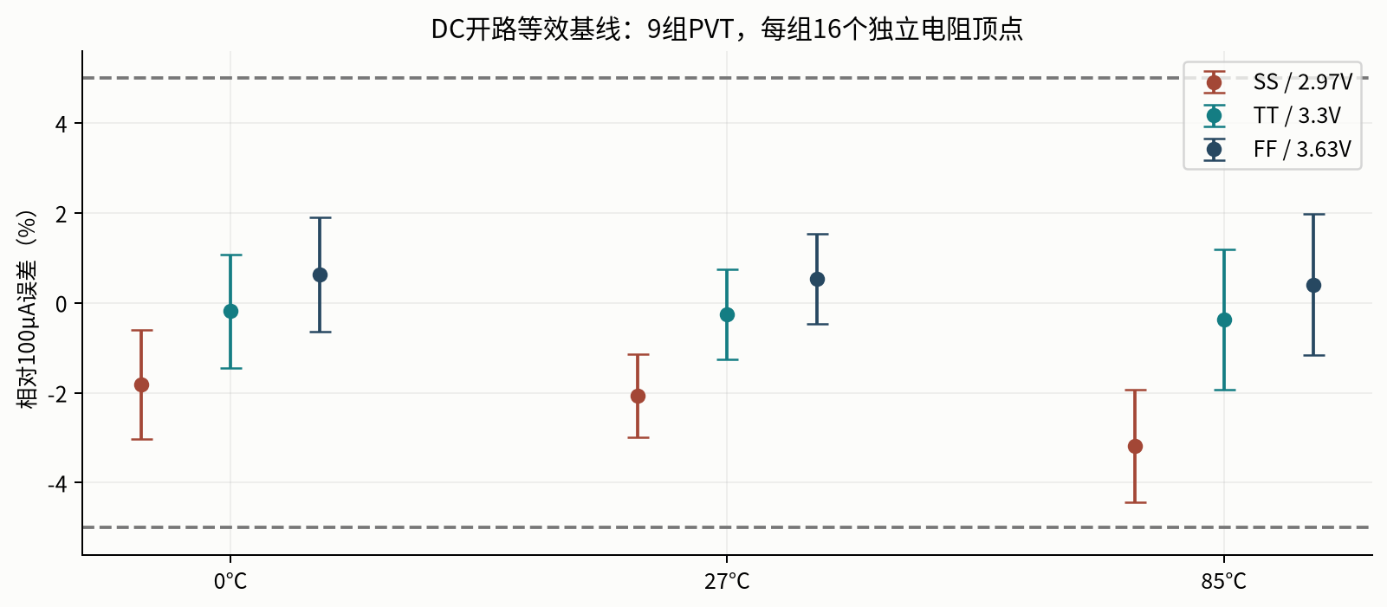
docs/research/pwm-reference-startup-20261024/electrical-figures/直流PVT与独立电阻角落.png
