Kevin-Kaiyo/open-microled-driver-asic/docs/research/pwm-reference-startup-20261024/figures/slow-start-filter-control.png

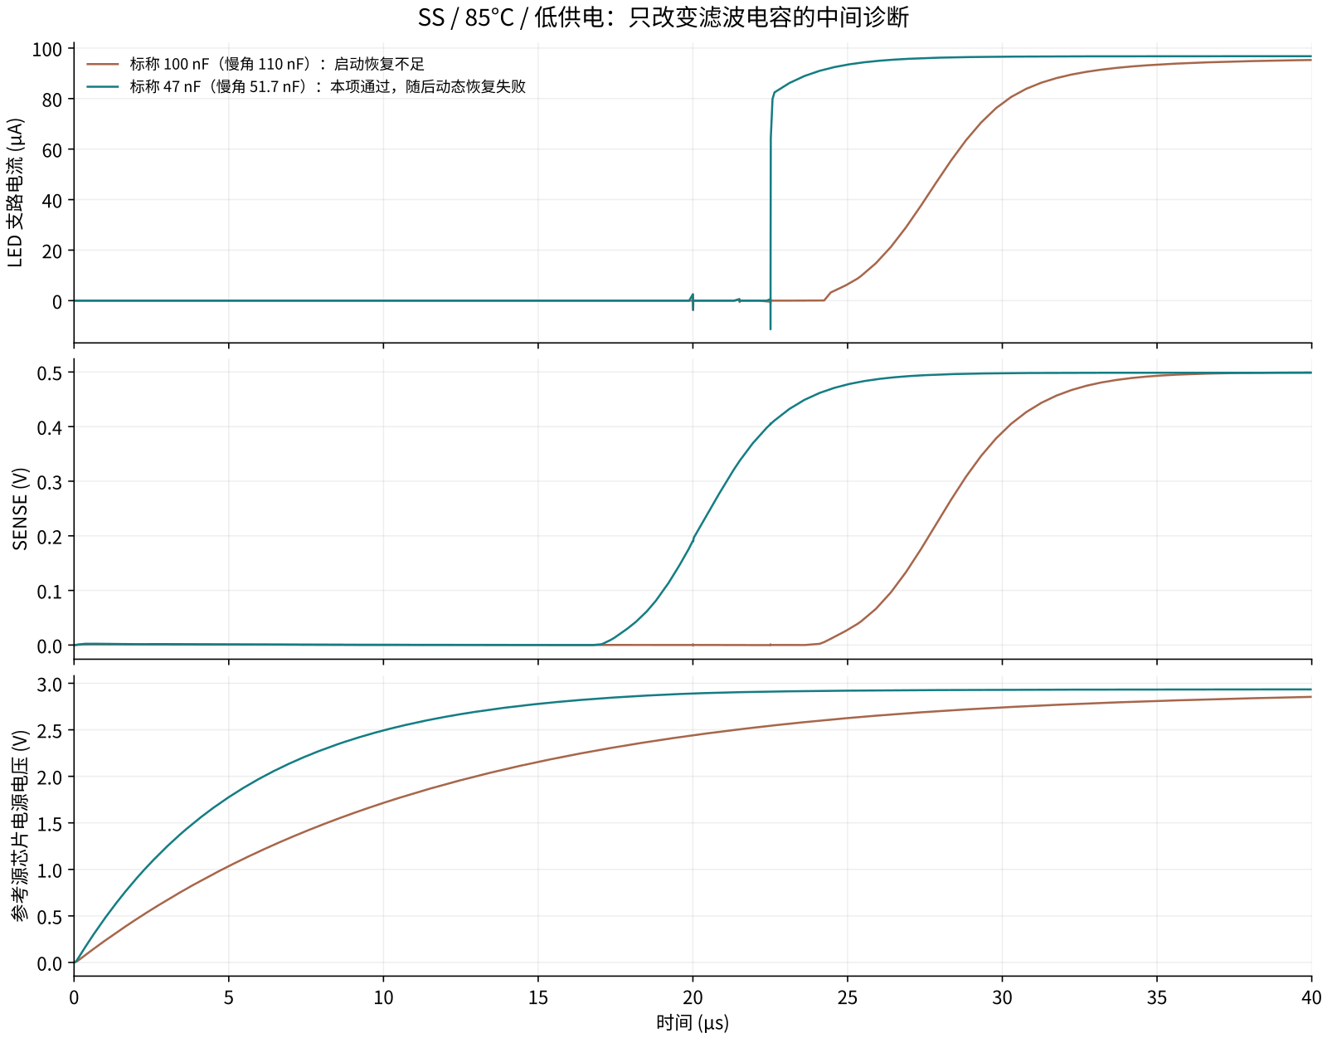
docs/research/pwm-reference-startup-20261024/figures/slow-start-filter-control.png
