Kevin-Kaiyo/open-microled-driver-asic/docs/research/pwm-reference-startup-20261024/figures/softstart-v1.png

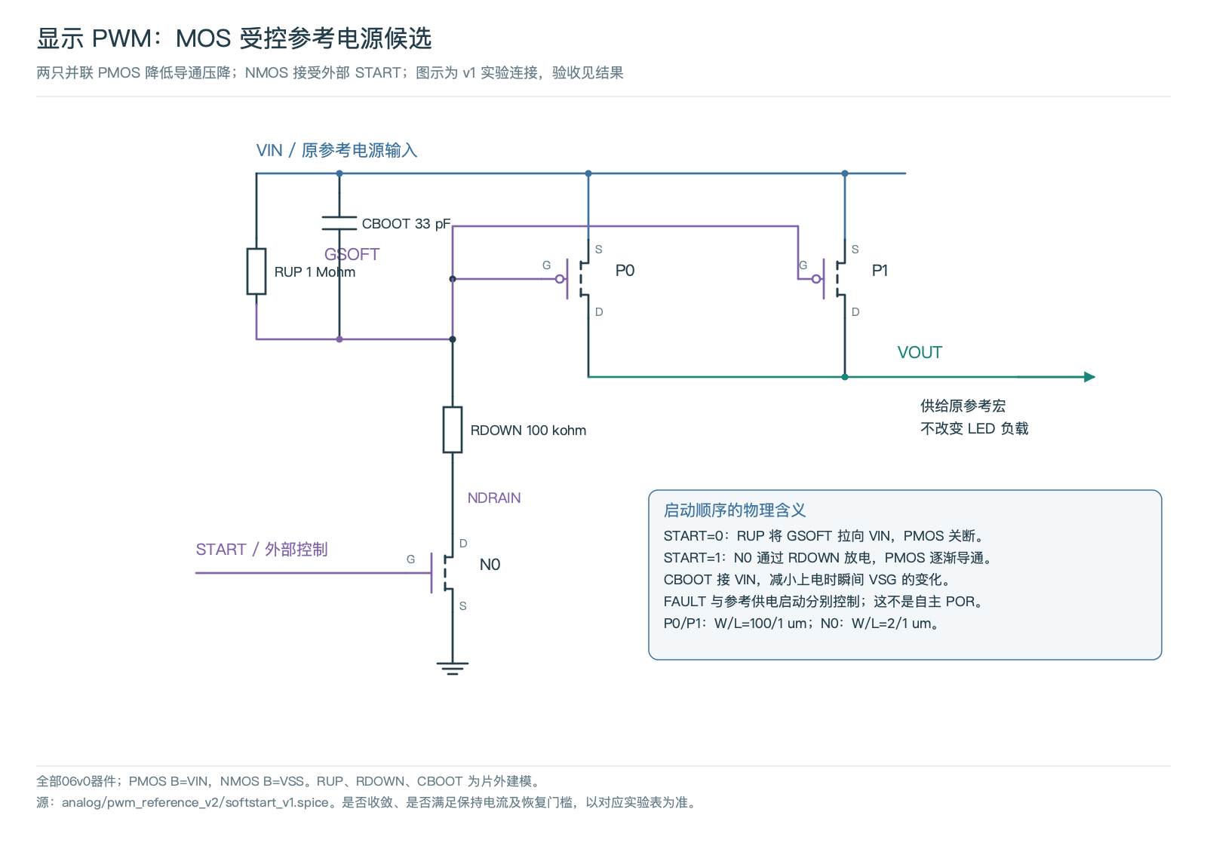
docs/research/pwm-reference-startup-20261024/figures/softstart-v1.png
