Kevin-Kaiyo/open-microled-driver-asic/docs/research/readable-audit/boundaries.png

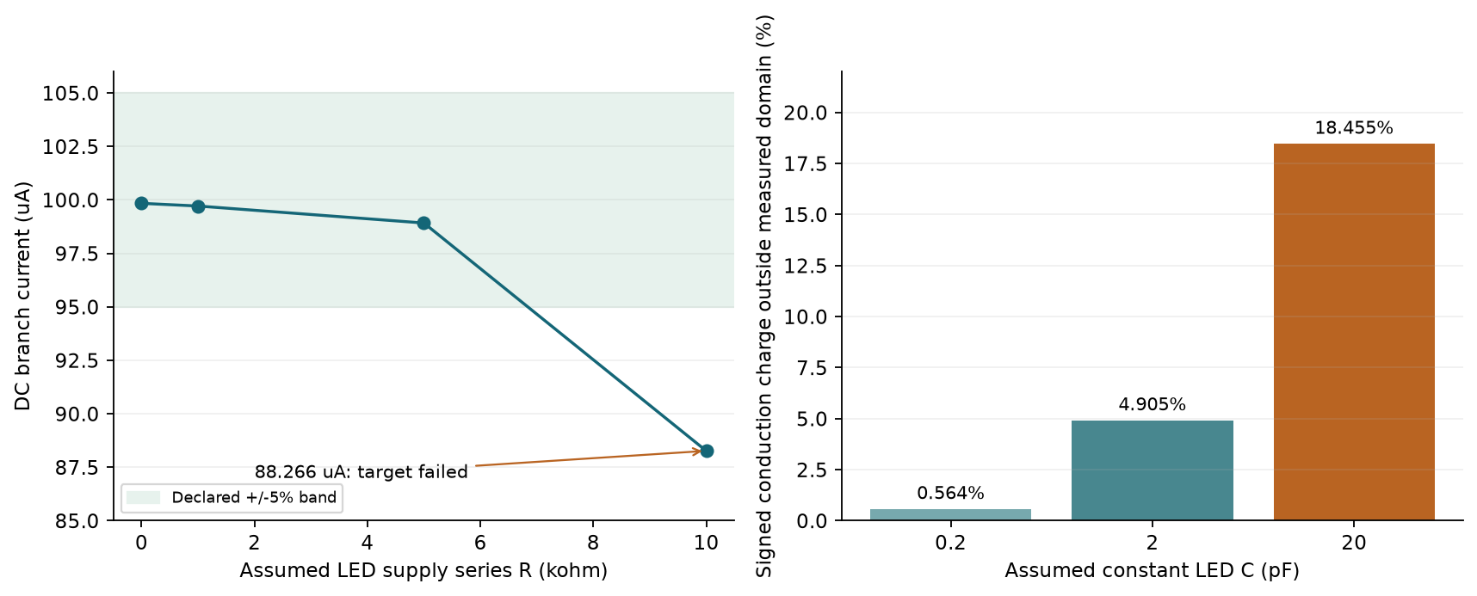
docs/research/readable-audit/boundaries.png
