Kevin-Kaiyo/open-microled-driver-asic/docs/research/readable-audit/circuit.png

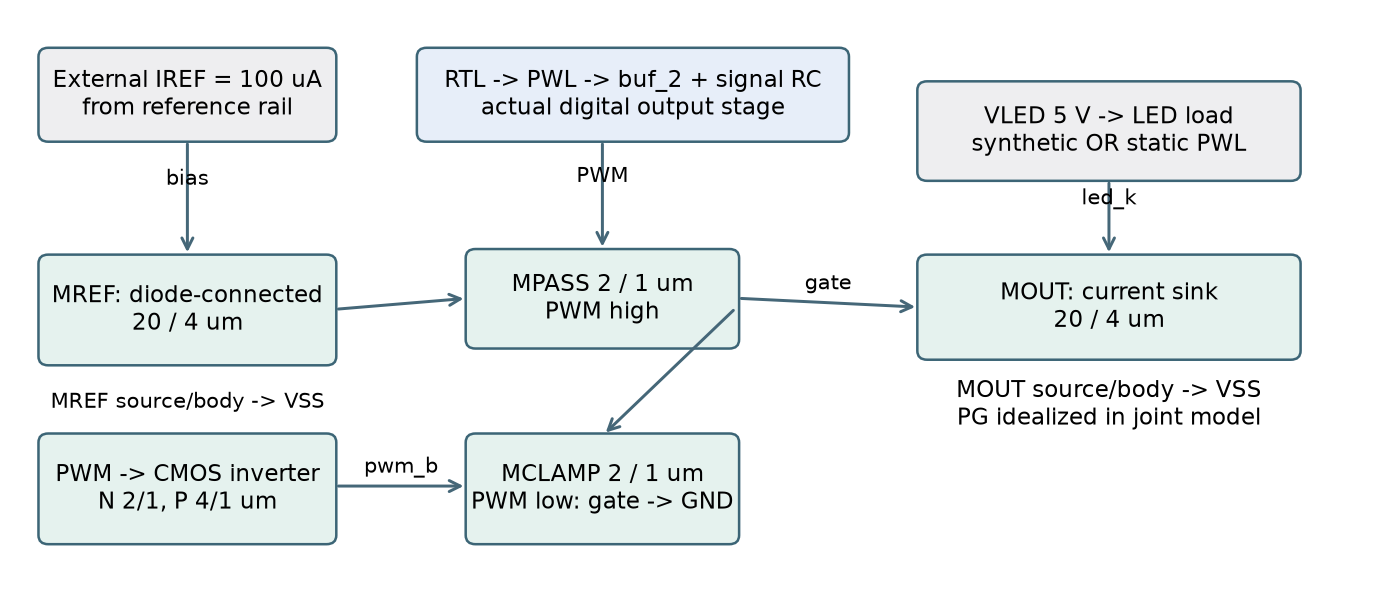
docs/research/readable-audit/circuit.png
