Kevin-Kaiyo/open-microled-driver-asic/docs/research/readable-audit/iv.png

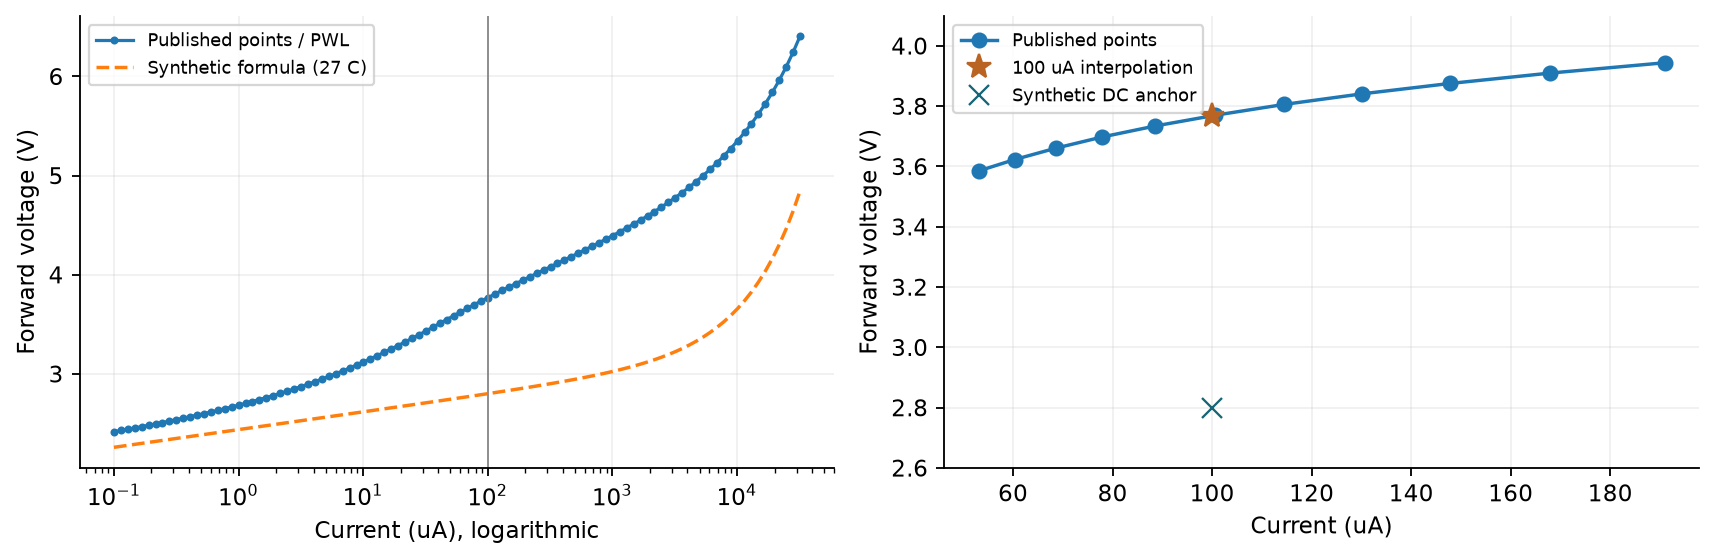
docs/research/readable-audit/iv.png
