Kevin-Kaiyo/open-microled-driver-asic/docs/research/readable-audit/scope.png

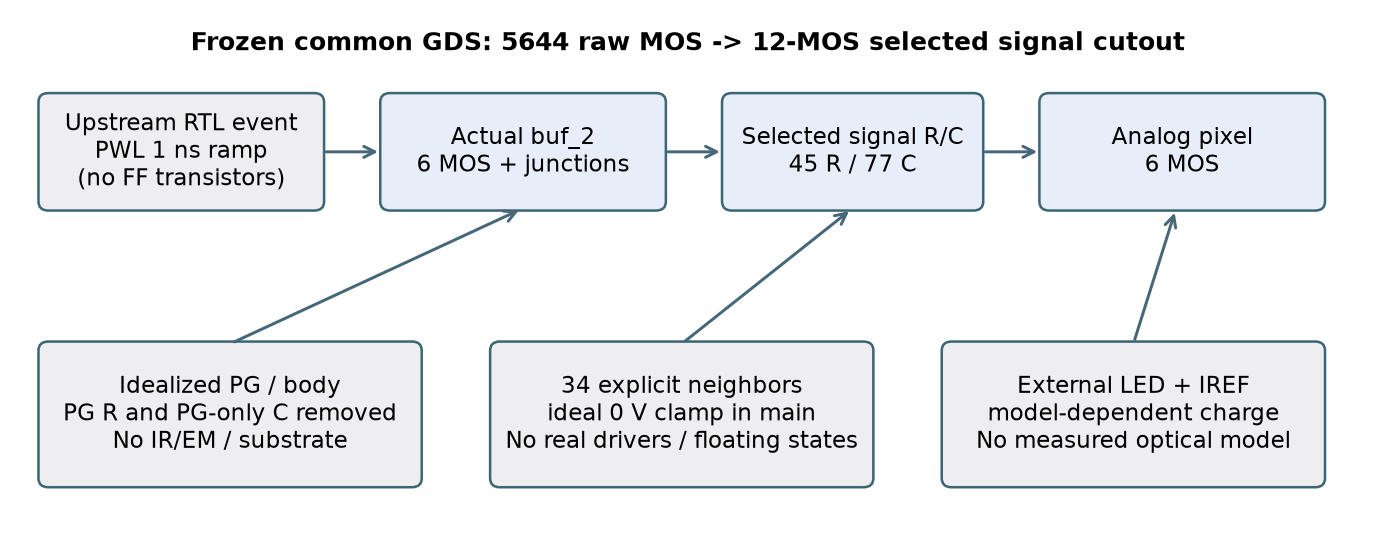
docs/research/readable-audit/scope.png
