Kevin-Kaiyo/open-microled-driver-asic/docs/research/readable-audit/waveform.png

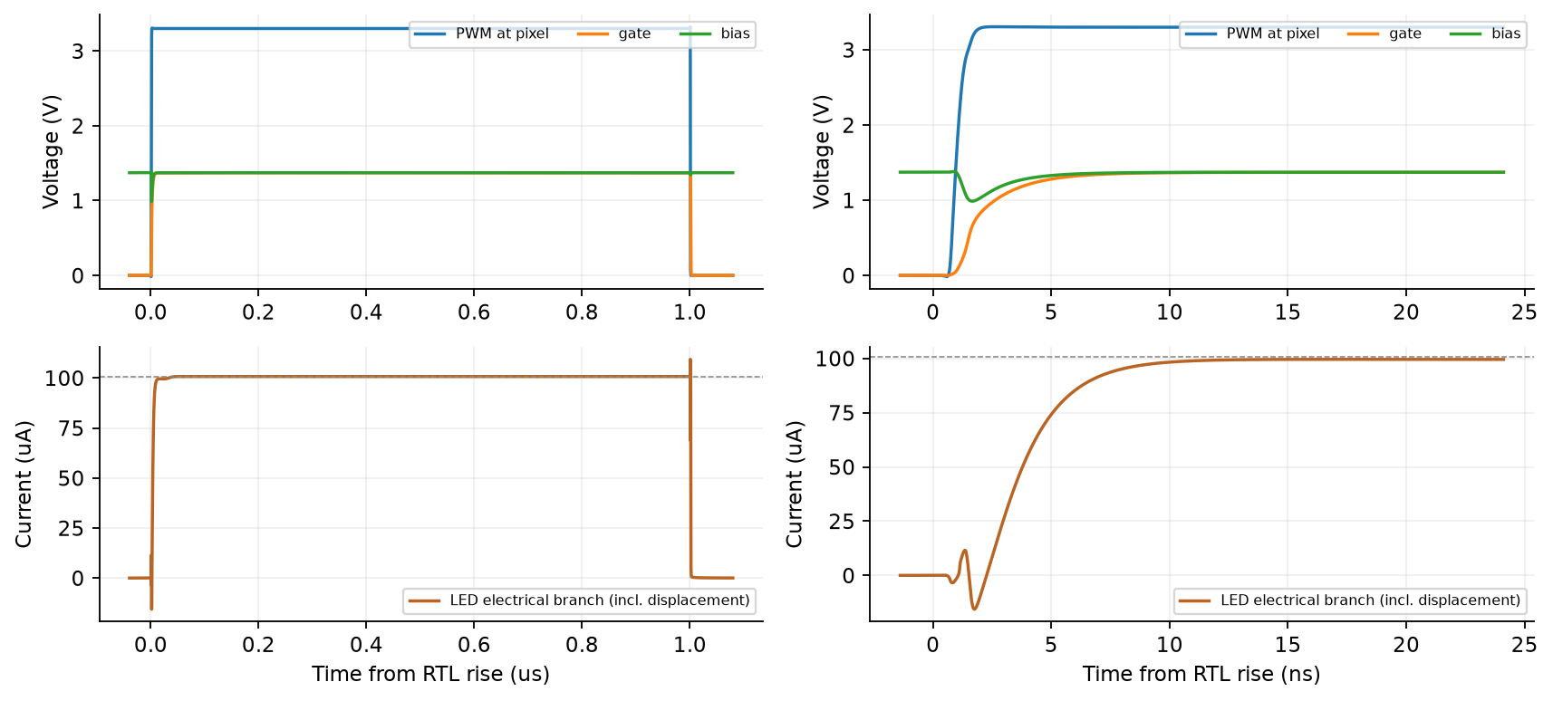
docs/research/readable-audit/waveform.png
