Kevin-Kaiyo/open-microled-driver-asic/docs/research/single-pixel-closure-20261015/figures/loop-margin.png

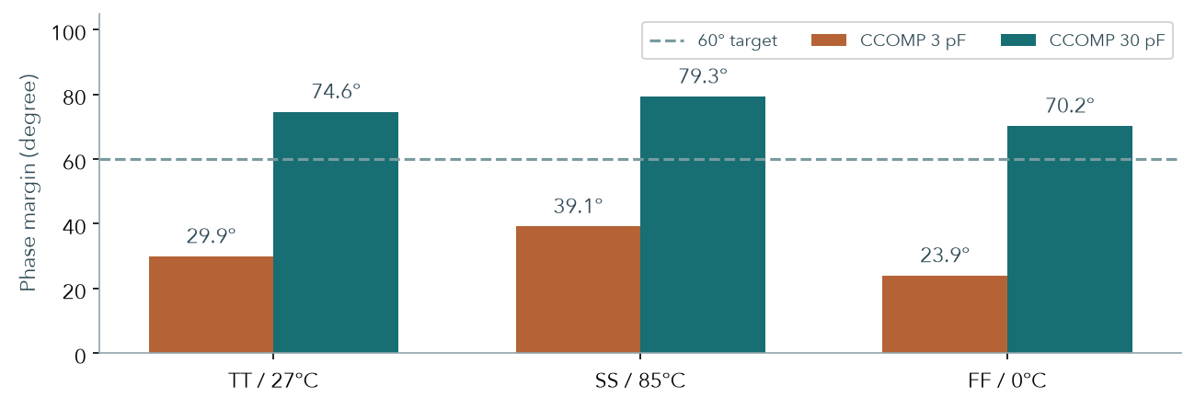
docs/research/single-pixel-closure-20261015/figures/loop-margin.png
