Kevin-Kaiyo/open-microled-driver-asic/docs/research/single-pixel-closure-20261015/figures/startup-comparison.png

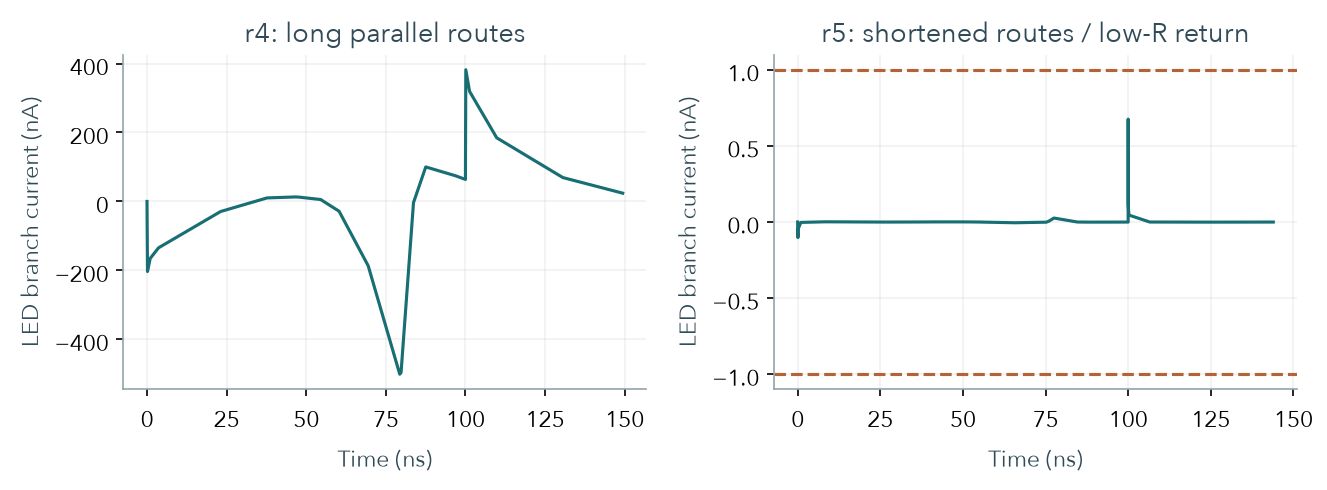
docs/research/single-pixel-closure-20261015/figures/startup-comparison.png
