Kevin-Kaiyo/open-microled-driver-asic/docs/research/three-gbps-vcsel-20261027/figures/proxy-bandwidth.png

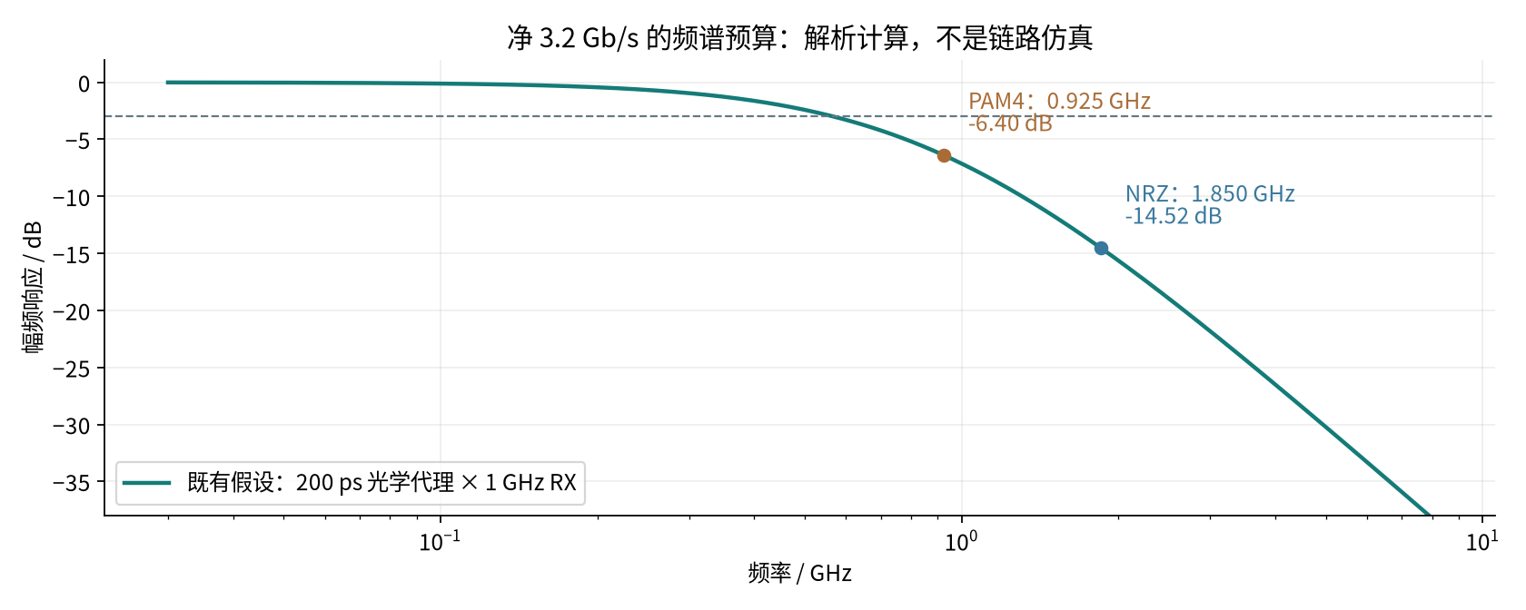
docs/research/three-gbps-vcsel-20261027/figures/proxy-bandwidth.png
