Kevin-Kaiyo/open-microled-driver-asic/docs/research/three-gbps-vcsel-20261027/figures/vcsel-current-states.png

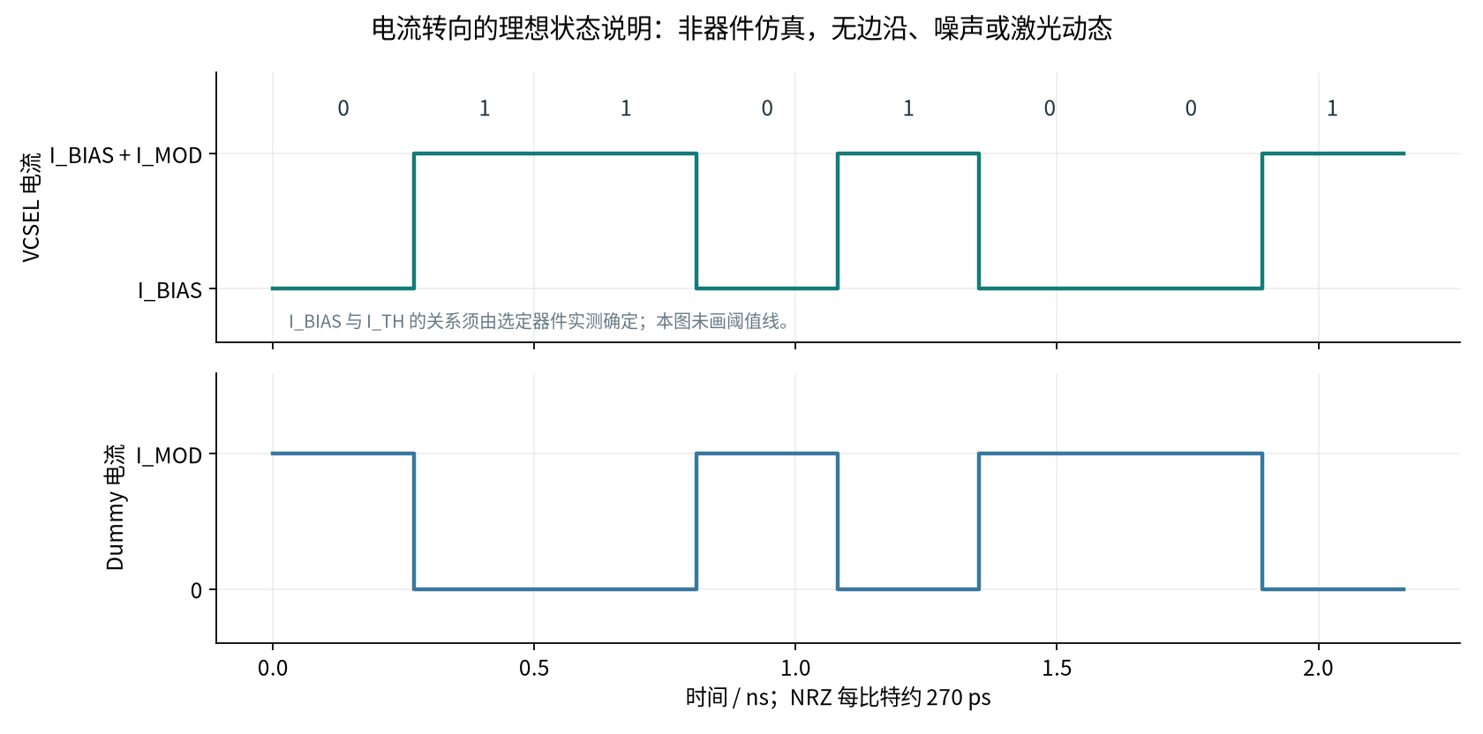
docs/research/three-gbps-vcsel-20261027/figures/vcsel-current-states.png
