Kevin-Kaiyo/open-microled-driver-asic/evidence/architecture-review-20261025/visual-review/route-comparison-page.png

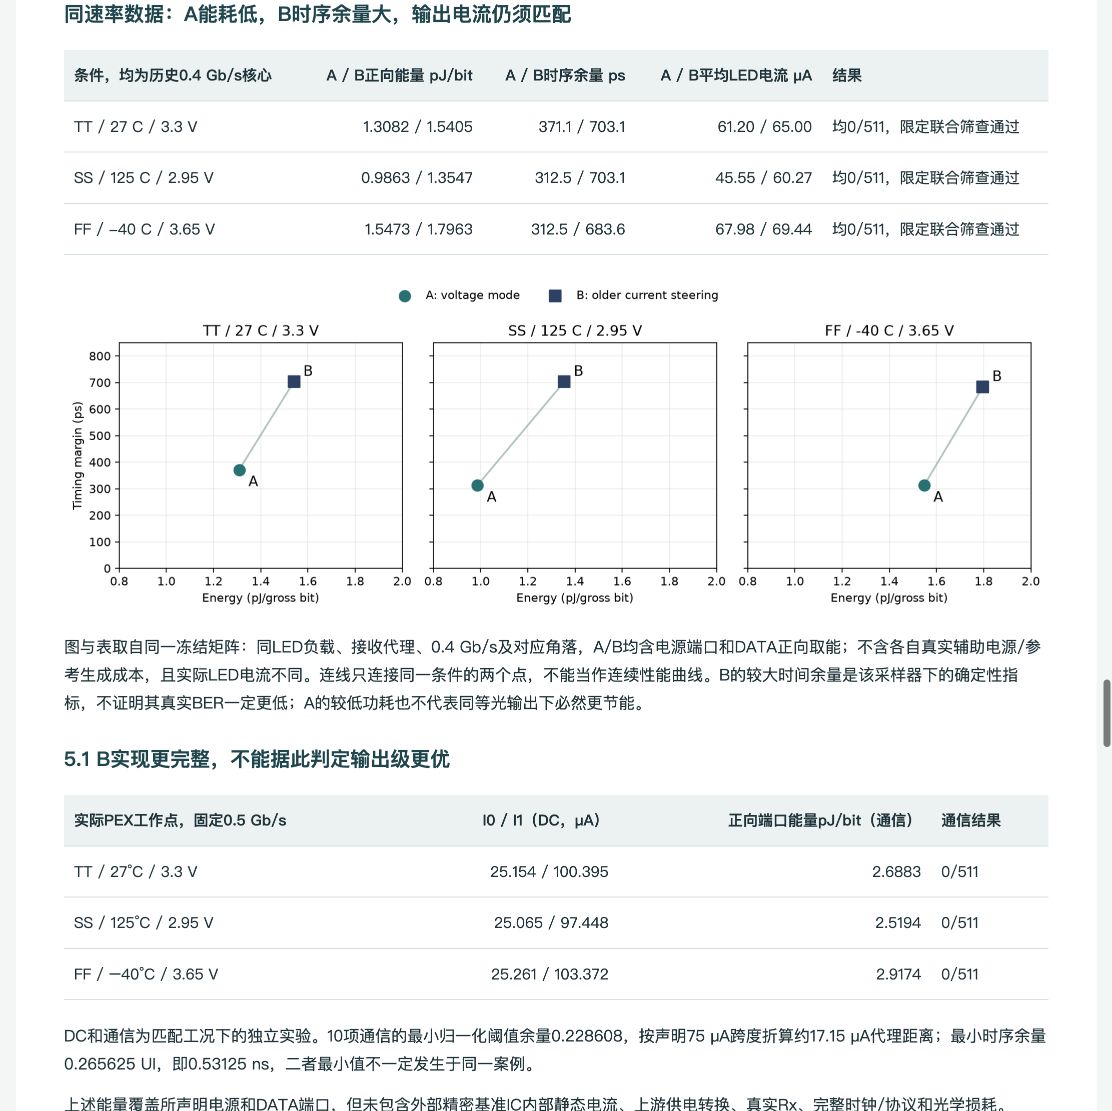
evidence/architecture-review-20261025/visual-review/route-comparison-page.png
