Kevin-Kaiyo/open-microled-driver-asic/evidence/driver-methods-20261111/vcsel-dr65-native.png

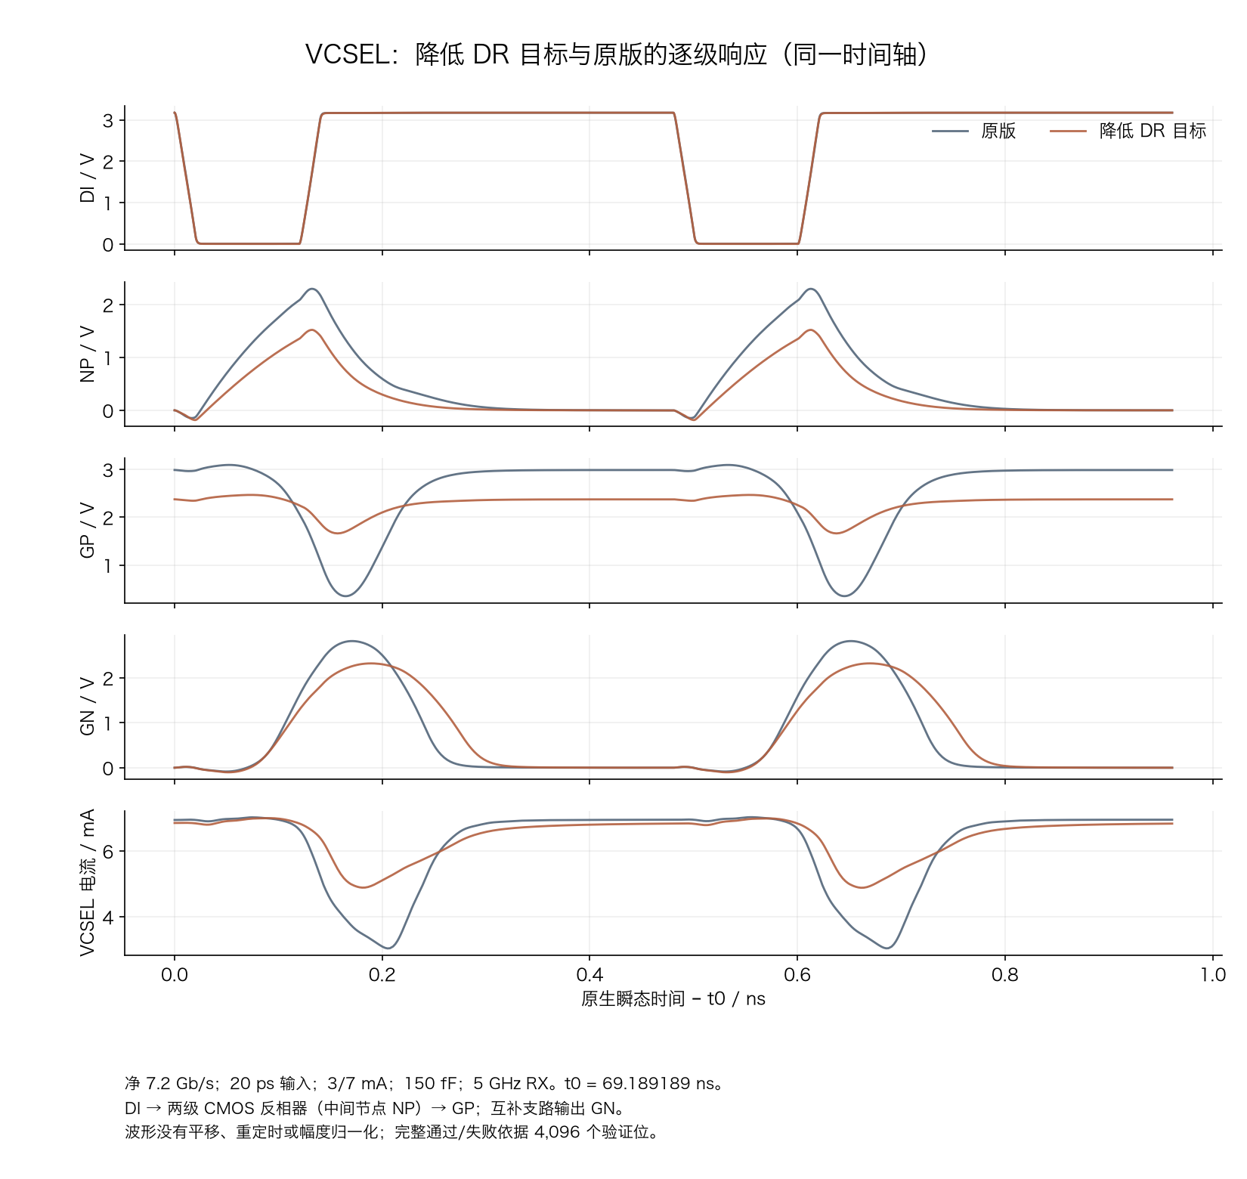
evidence/driver-methods-20261111/vcsel-dr65-native.png
