Kevin-Kaiyo/open-microled-driver-asic/evidence/highspeed-nrz-robustness-layout/visuals-A8-ties/figures/layout-A.png

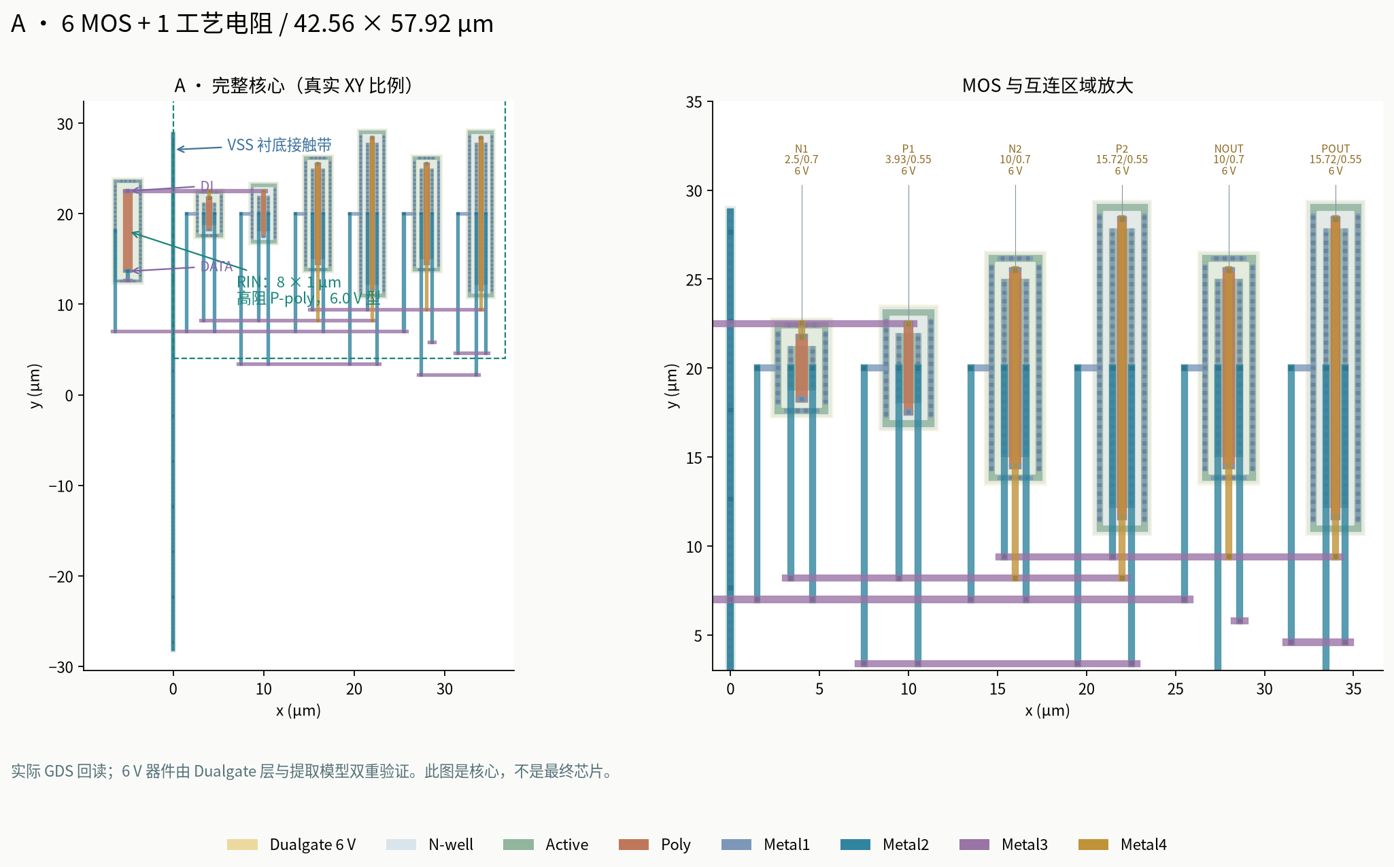
evidence/highspeed-nrz-robustness-layout/visuals-A8-ties/figures/layout-A.png
