Kevin-Kaiyo/open-microled-driver-asic/evidence/highspeed-nrz-robustness-layout/visuals-final/figures/layout-A.png

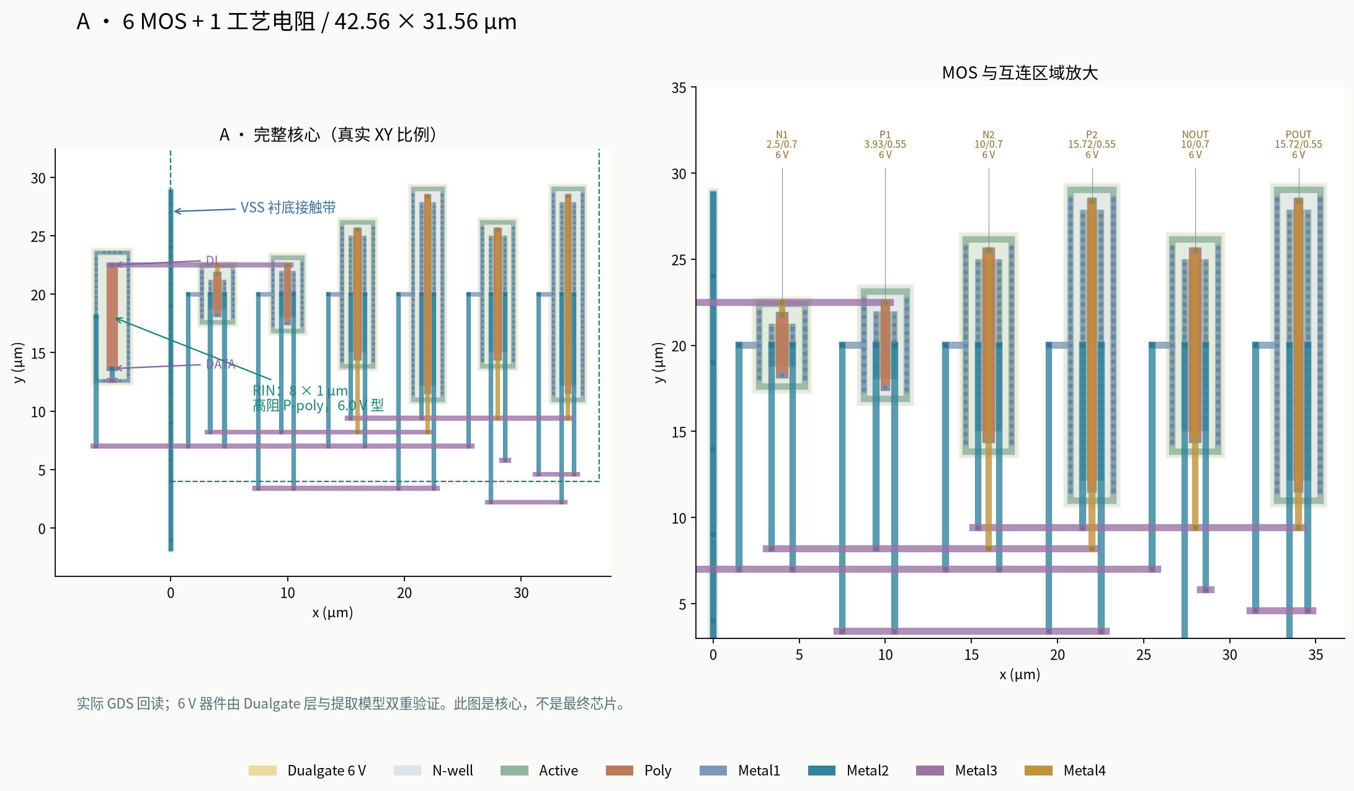
evidence/highspeed-nrz-robustness-layout/visuals-final/figures/layout-A.png
