Kevin-Kaiyo/open-microled-driver-asic/evidence/highspeed-nrz-robustness-layout/visuals/figures/layout-B.png

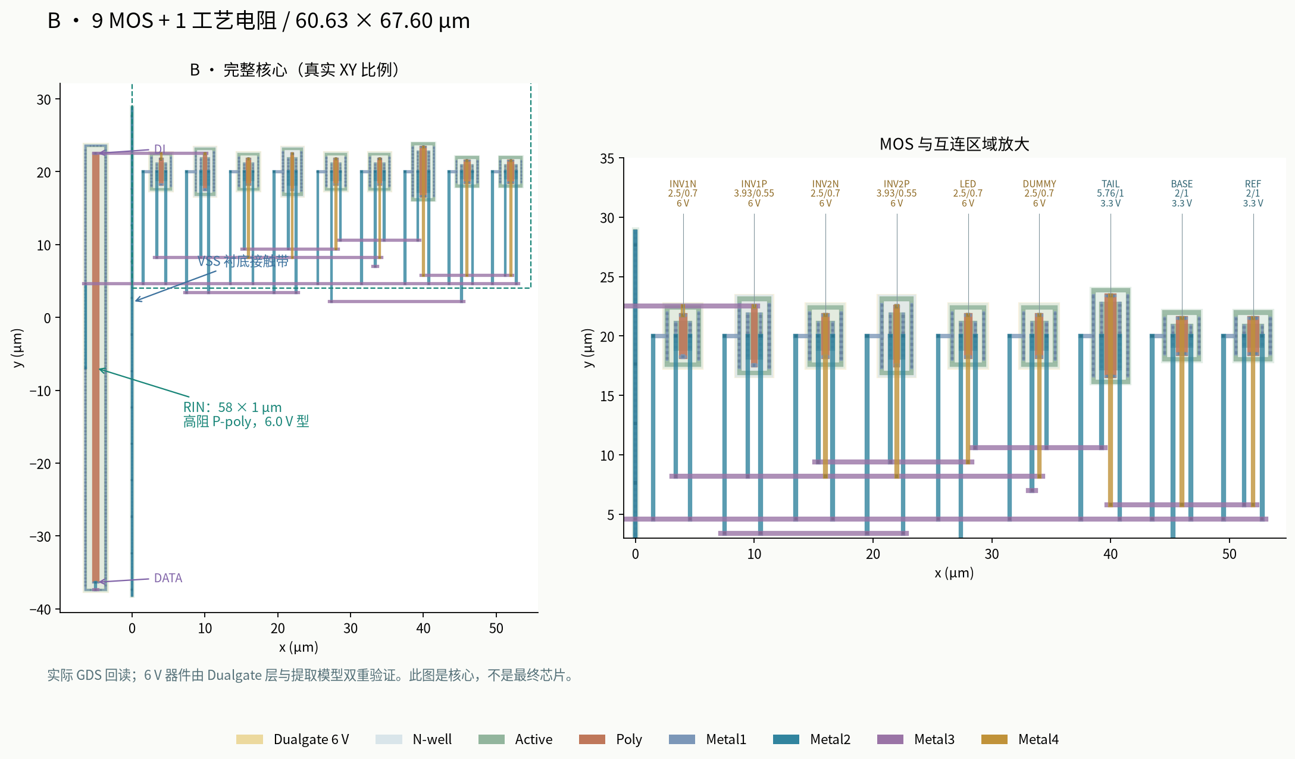
evidence/highspeed-nrz-robustness-layout/visuals/figures/layout-B.png
