Kevin-Kaiyo/open-microled-driver-asic/evidence/layout-v3/joint-r2/overview.png

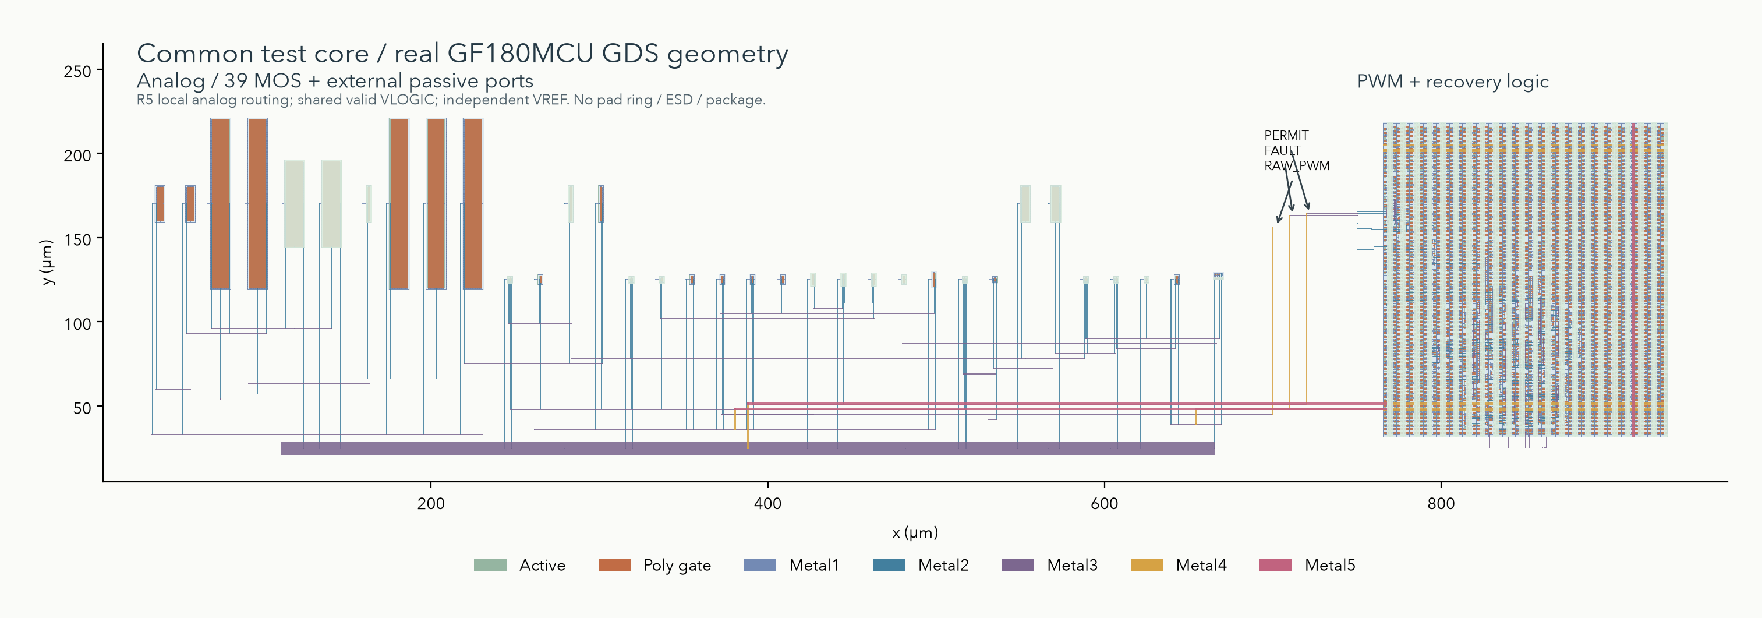
evidence/layout-v3/joint-r2/overview.png
