Kevin-Kaiyo/open-microled-driver-asic/evidence/layout-v3/r4/fault-buffer-detail.png

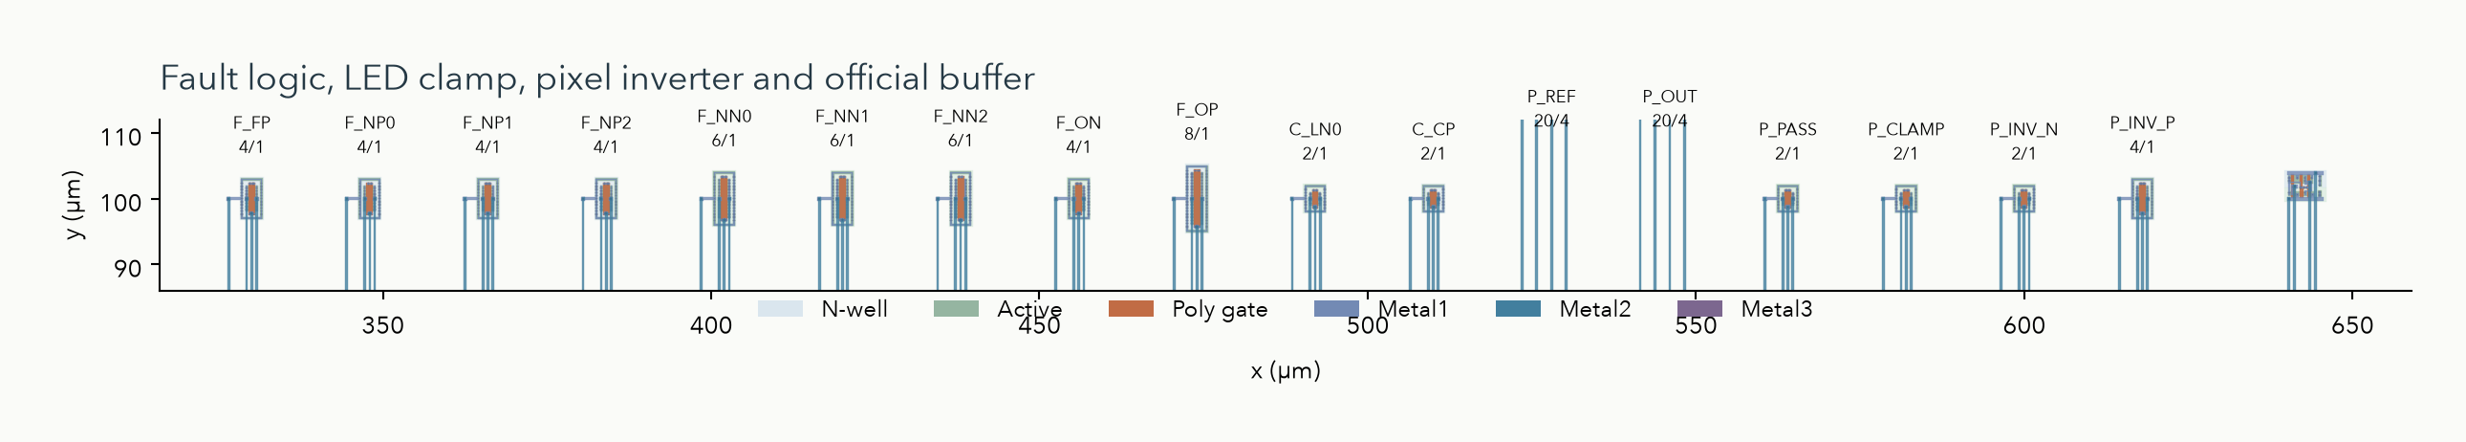
evidence/layout-v3/r4/fault-buffer-detail.png
