Kevin-Kaiyo/open-microled-driver-asic/evidence/layout-v3/r4/isolation-detail.png

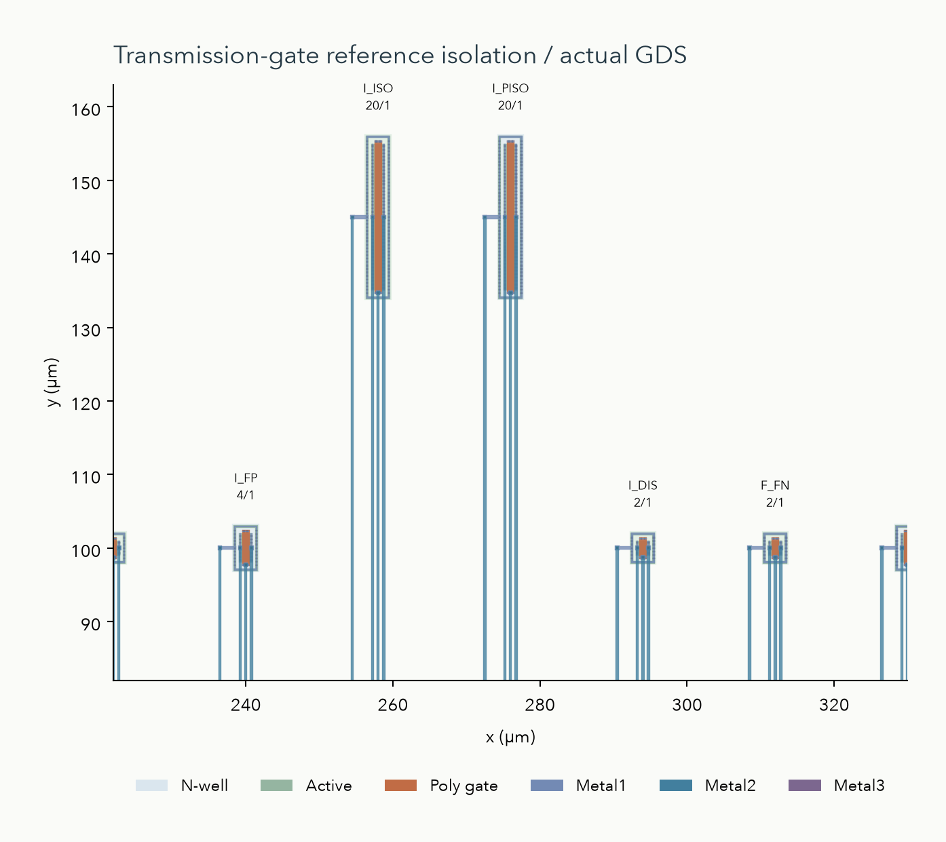
evidence/layout-v3/r4/isolation-detail.png
