Kevin-Kaiyo/open-microled-driver-asic/evidence/layout-v3/r5/overview.png

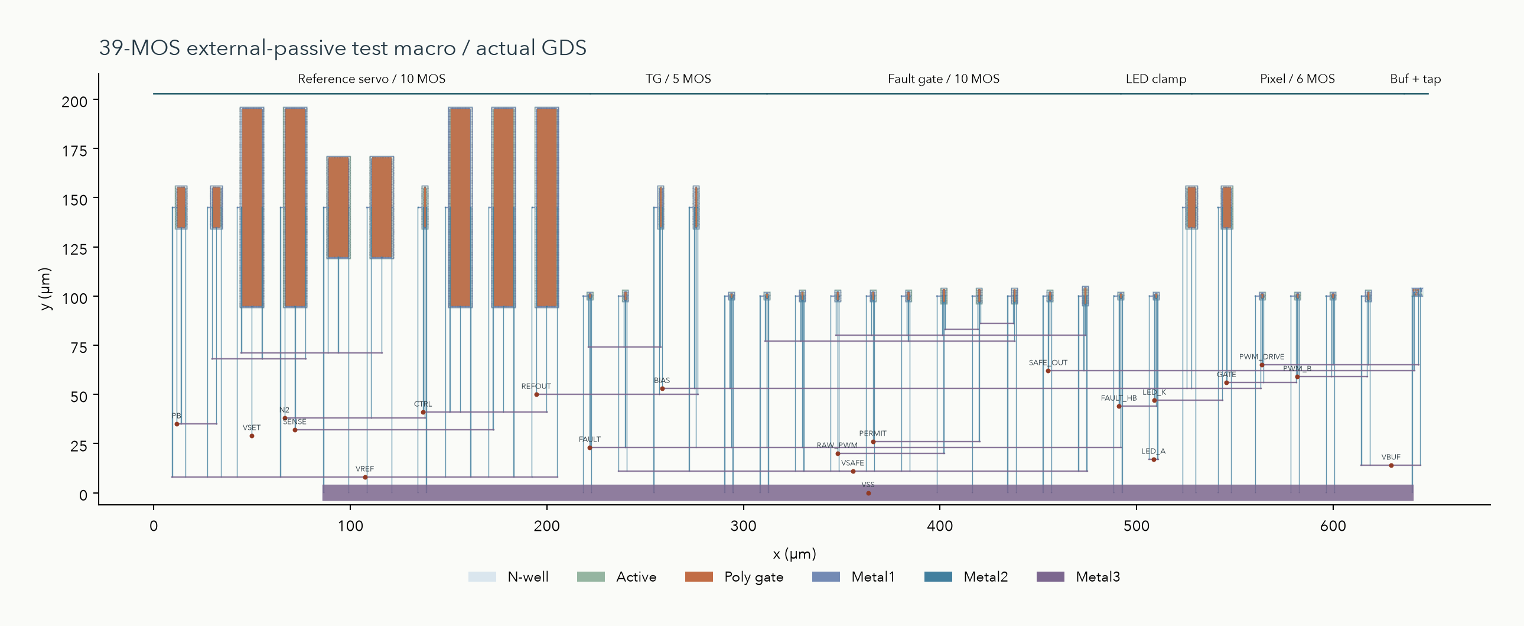
evidence/layout-v3/r5/overview.png
