Kevin-Kaiyo/open-microled-driver-asic/evidence/layout-v3/r5/reference-detail.png

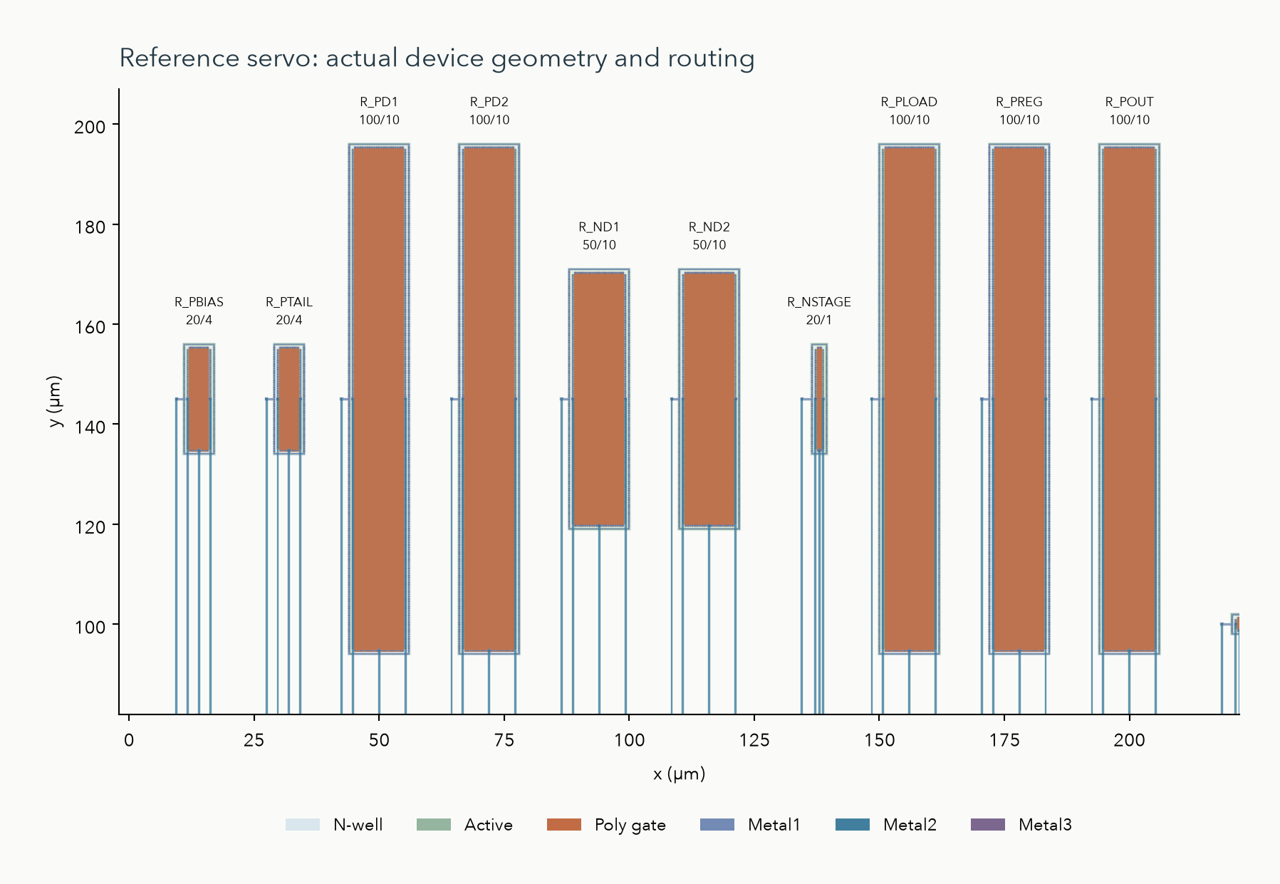
evidence/layout-v3/r5/reference-detail.png
