Kevin-Kaiyo/open-microled-driver-asic/evidence/layout-v3/r5/welltap-detail.png

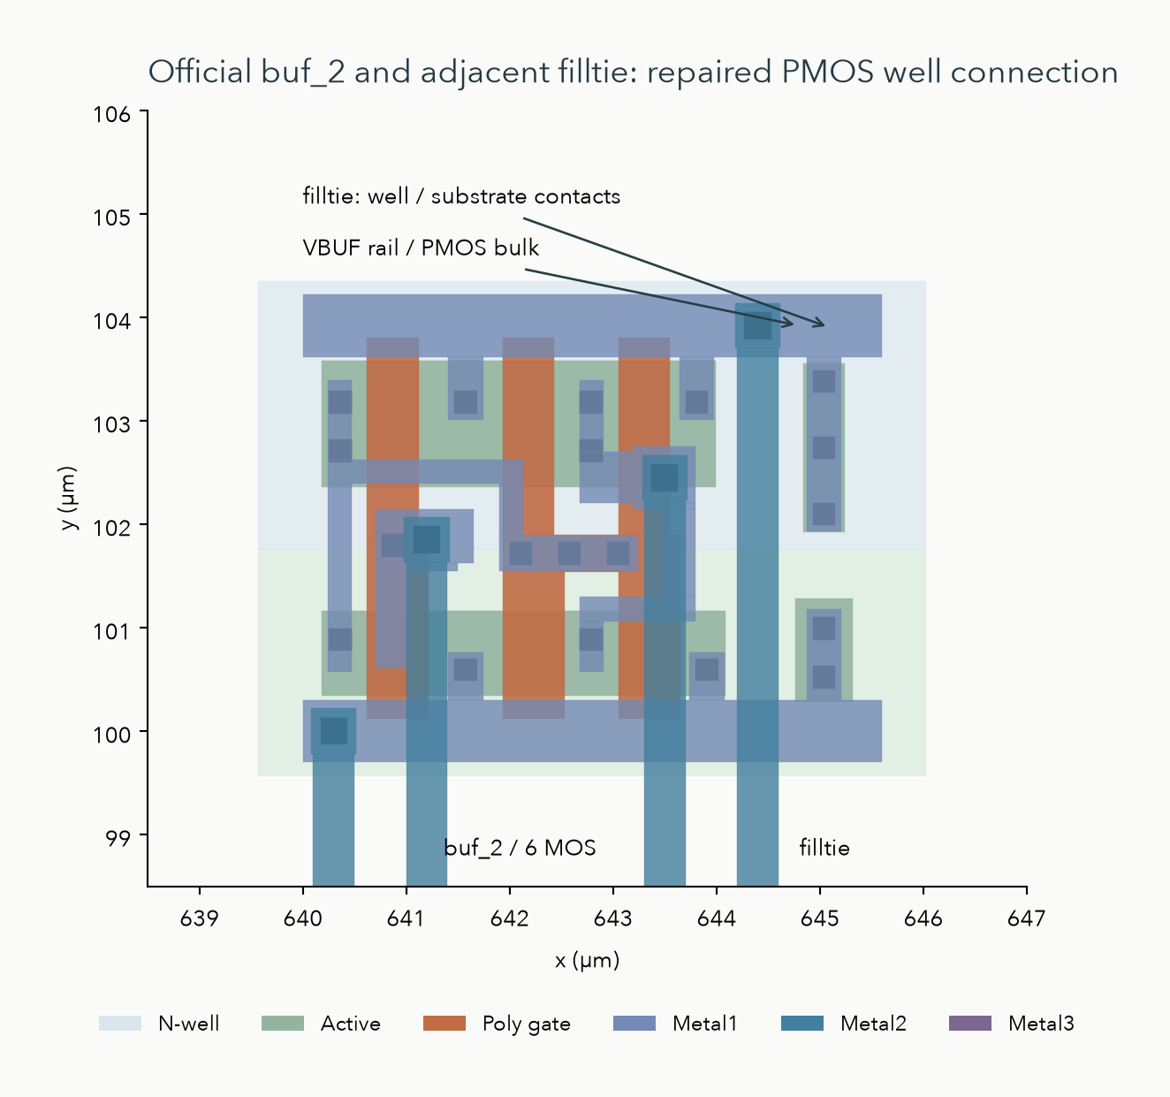
evidence/layout-v3/r5/welltap-detail.png
