Kevin-Kaiyo/open-microled-driver-asic/evidence/microled-dynamic-20261029/reference-plane-response.png

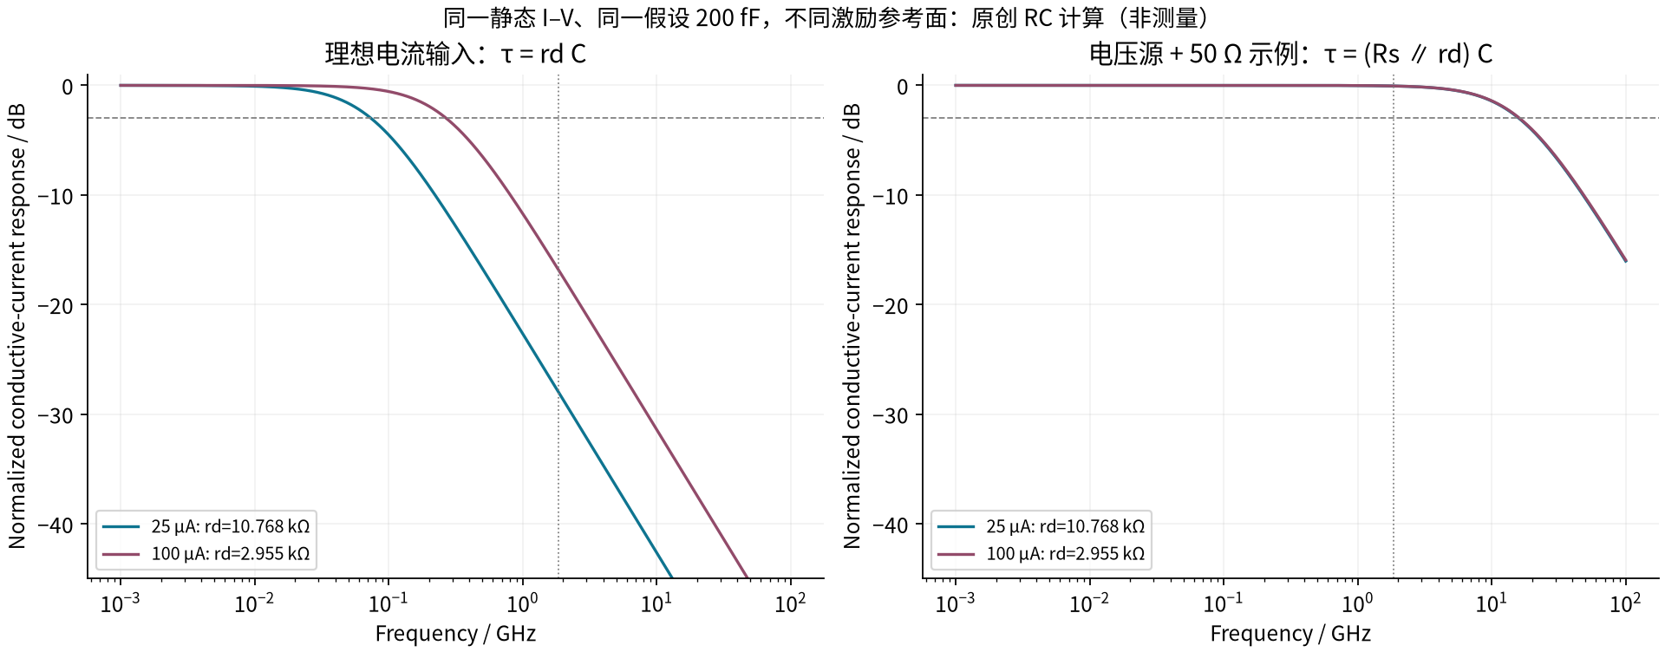
evidence/microled-dynamic-20261029/reference-plane-response.png
