Kevin-Kaiyo/open-microled-driver-asic/evidence/microled-dynamic-20261029/reference-planes.png

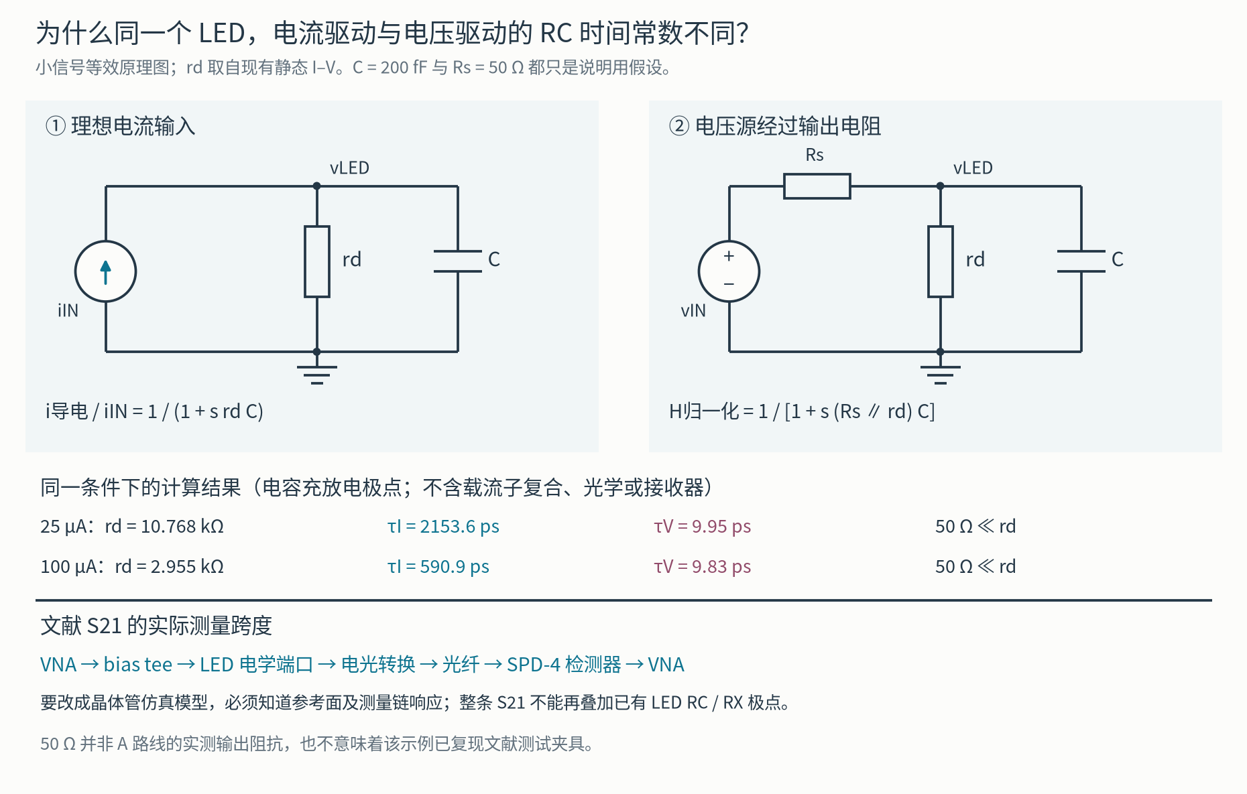
evidence/microled-dynamic-20261029/reference-planes.png
