Kevin-Kaiyo/open-microled-driver-asic/evidence/phase1/duty-current.png

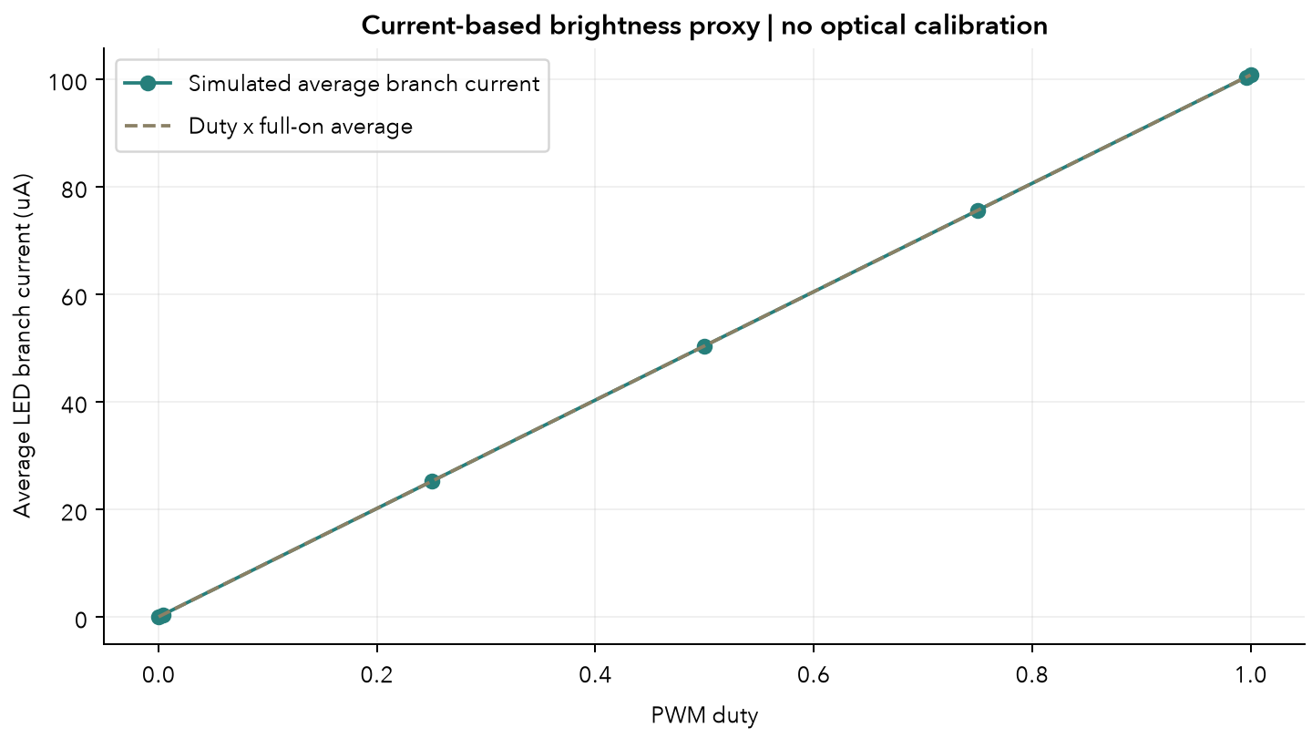
evidence/phase1/duty-current.png
