Kevin-Kaiyo/open-microled-driver-asic/evidence/phase1/vf-current.png

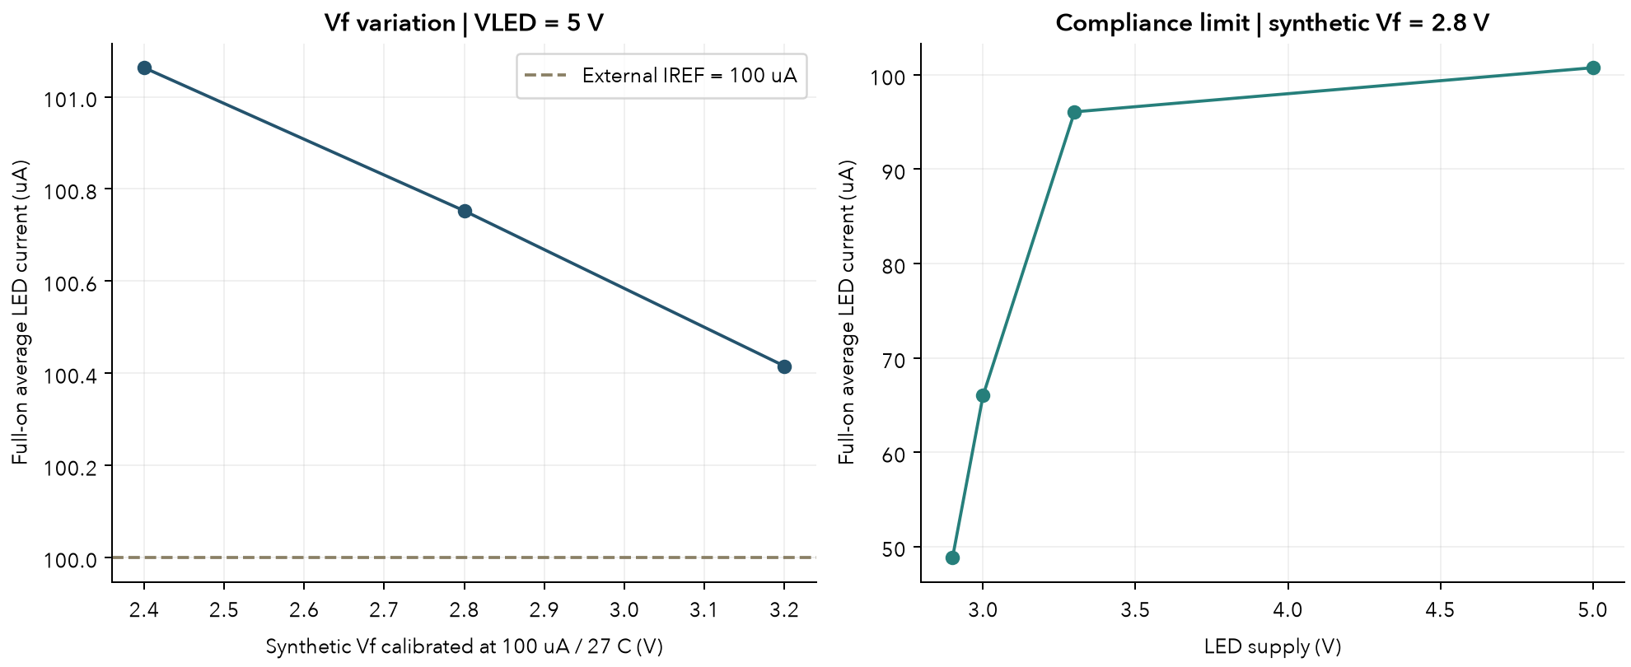
evidence/phase1/vf-current.png
