Kevin-Kaiyo/open-microled-driver-asic/evidence/phase1/waveforms.png

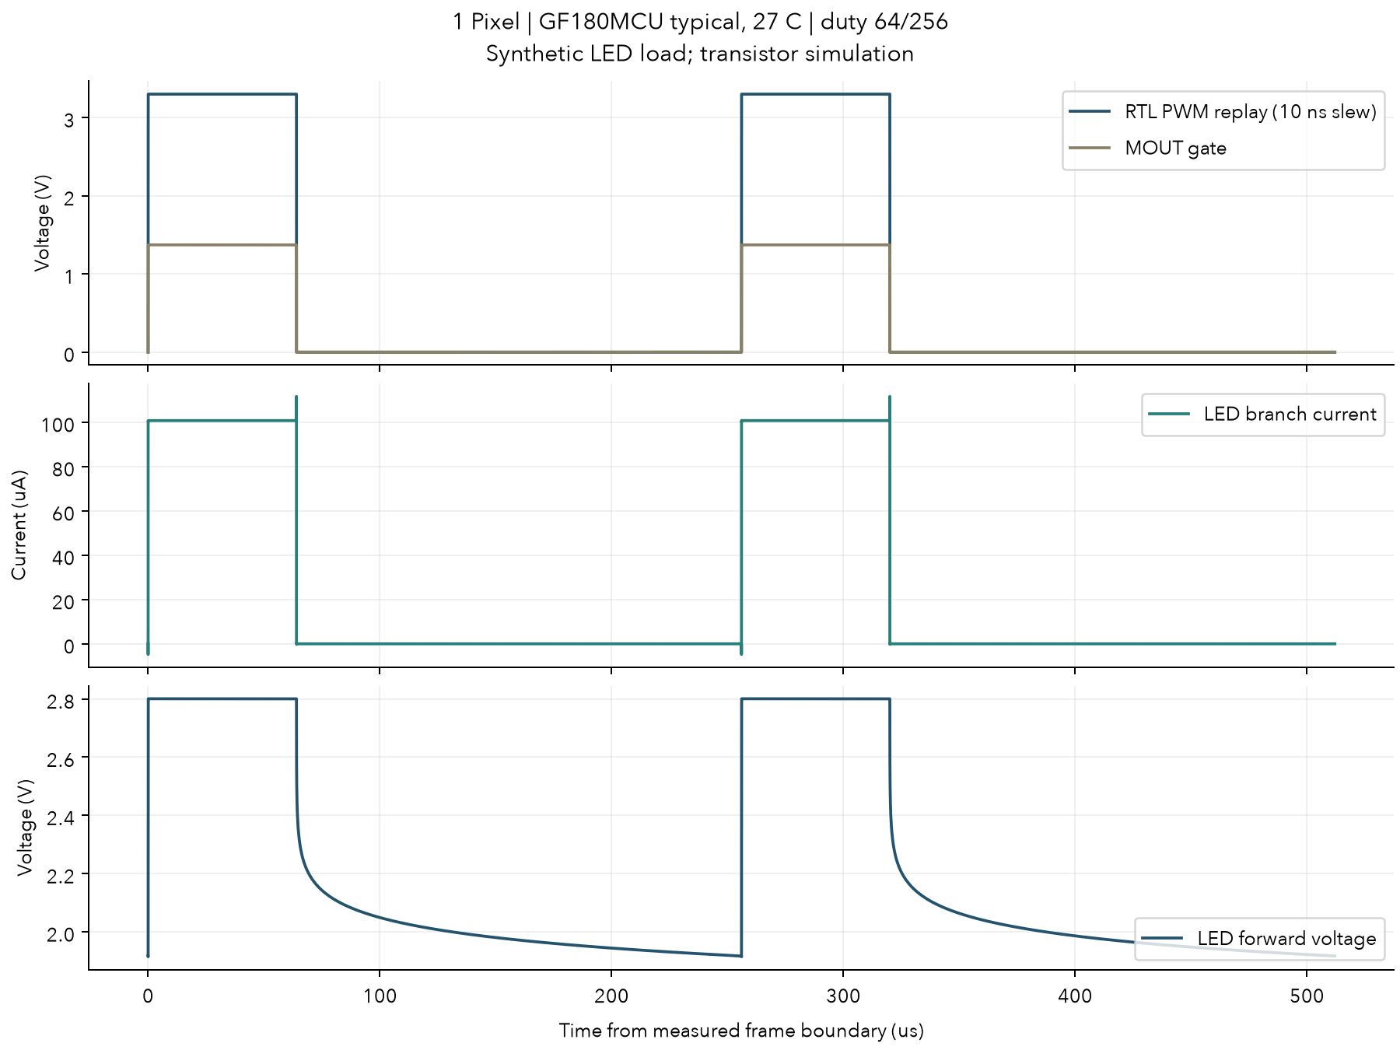
evidence/phase1/waveforms.png
