Kevin-Kaiyo/open-microled-driver-asic/evidence/reference-v2-audit/visual-review/nrz-circuit-page.png

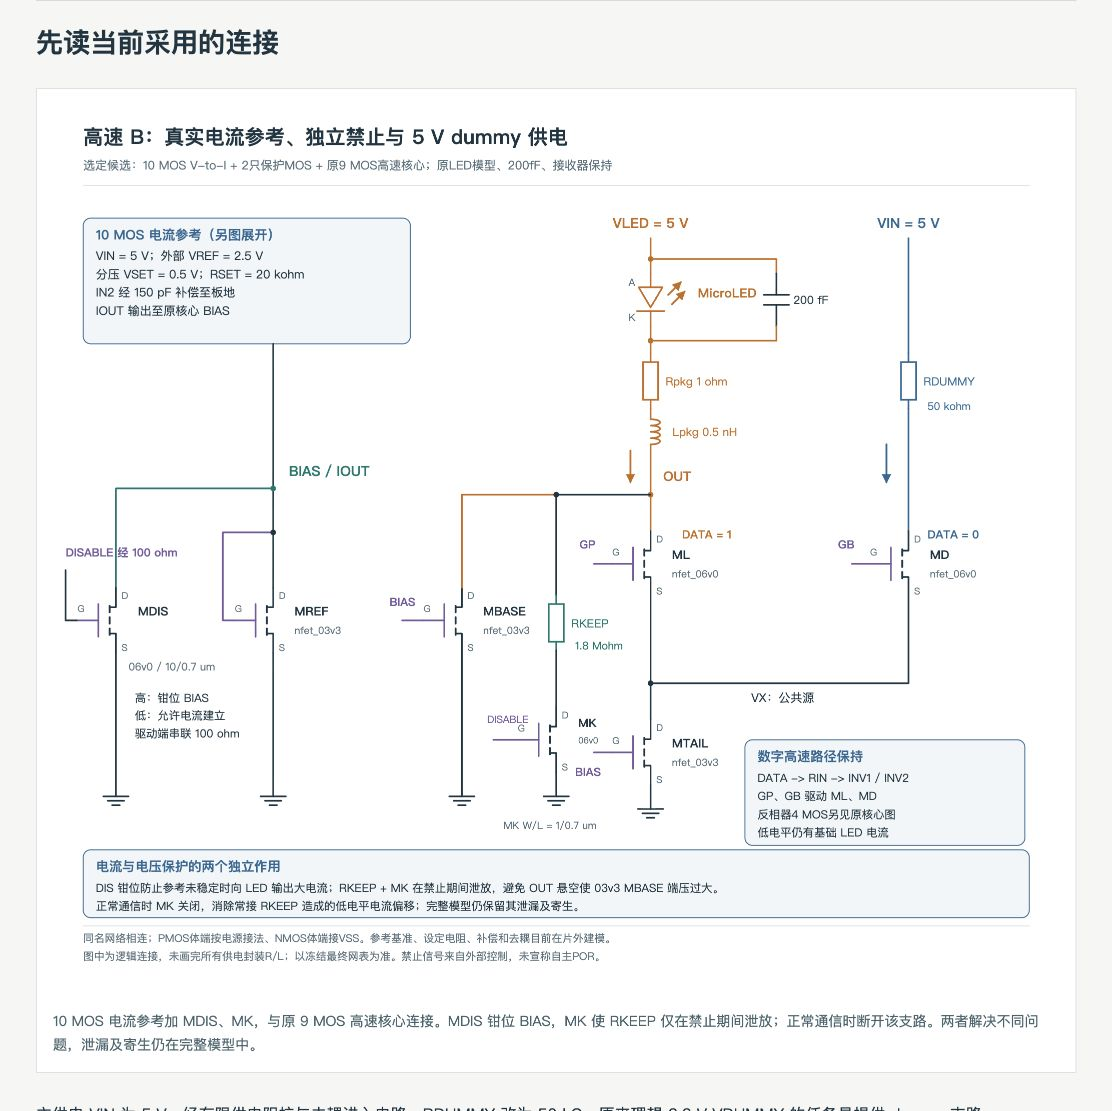
evidence/reference-v2-audit/visual-review/nrz-circuit-page.png
