Kevin-Kaiyo/open-microled-driver-asic/evidence/reference-v2-audit/visual-review/pwm-page.png

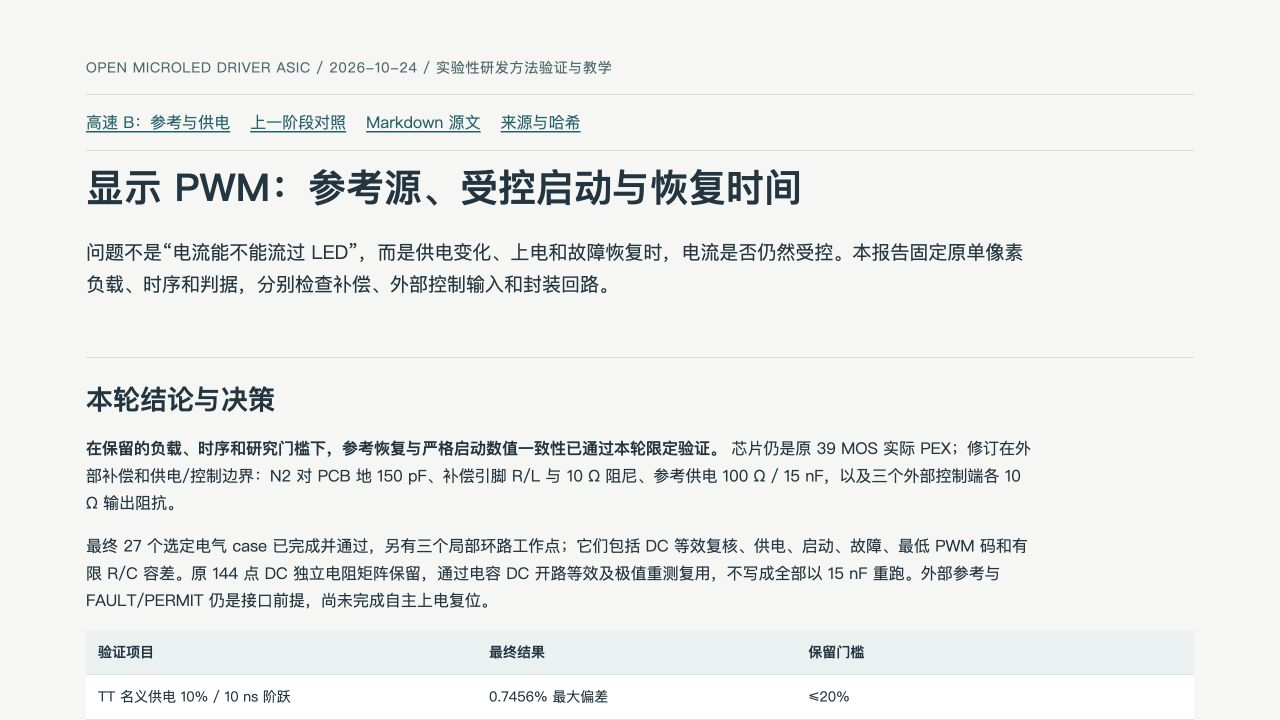
evidence/reference-v2-audit/visual-review/pwm-page.png
