Kevin-Kaiyo/open-microled-driver-asic/evidence/reference-v2-layout/visuals/N-layout.png

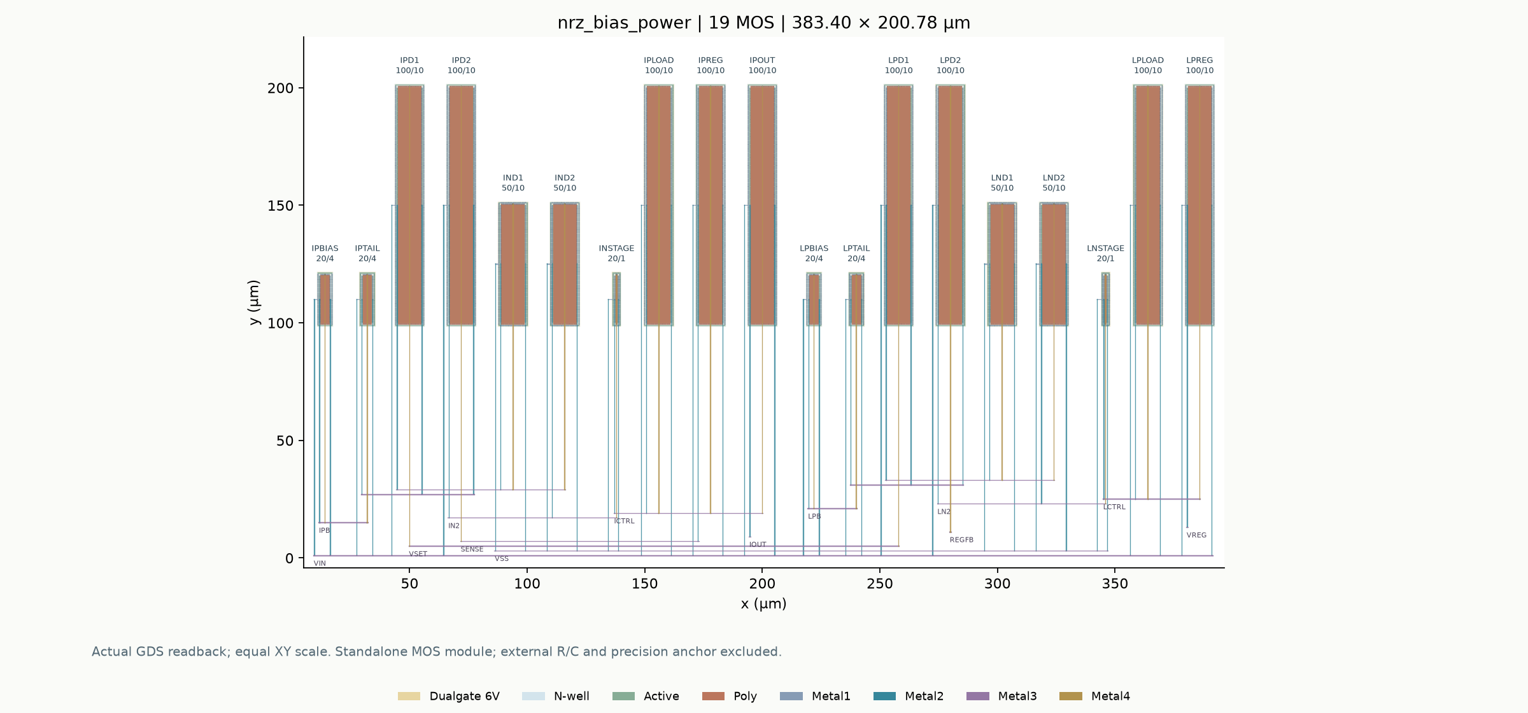
evidence/reference-v2-layout/visuals/N-layout.png
