Kevin-Kaiyo/open-microled-driver-asic/evidence/reference-v2-layout/visuals/nrz-joint-r1c.png

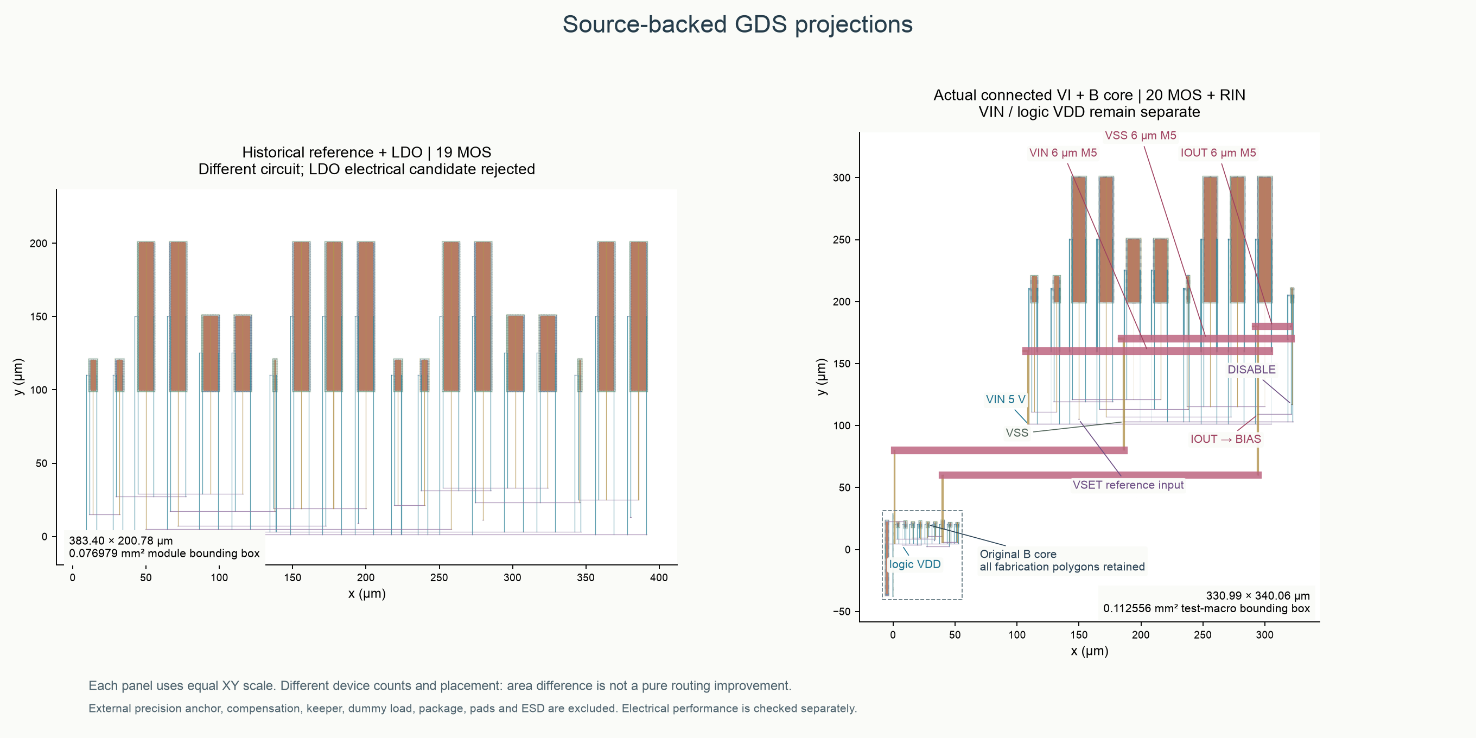
evidence/reference-v2-layout/visuals/nrz-joint-r1c.png
