Kevin-Kaiyo/open-microled-driver-asic/evidence/reference-v2-layout/visuals/nrz-switched-keeper-joint-r1.png

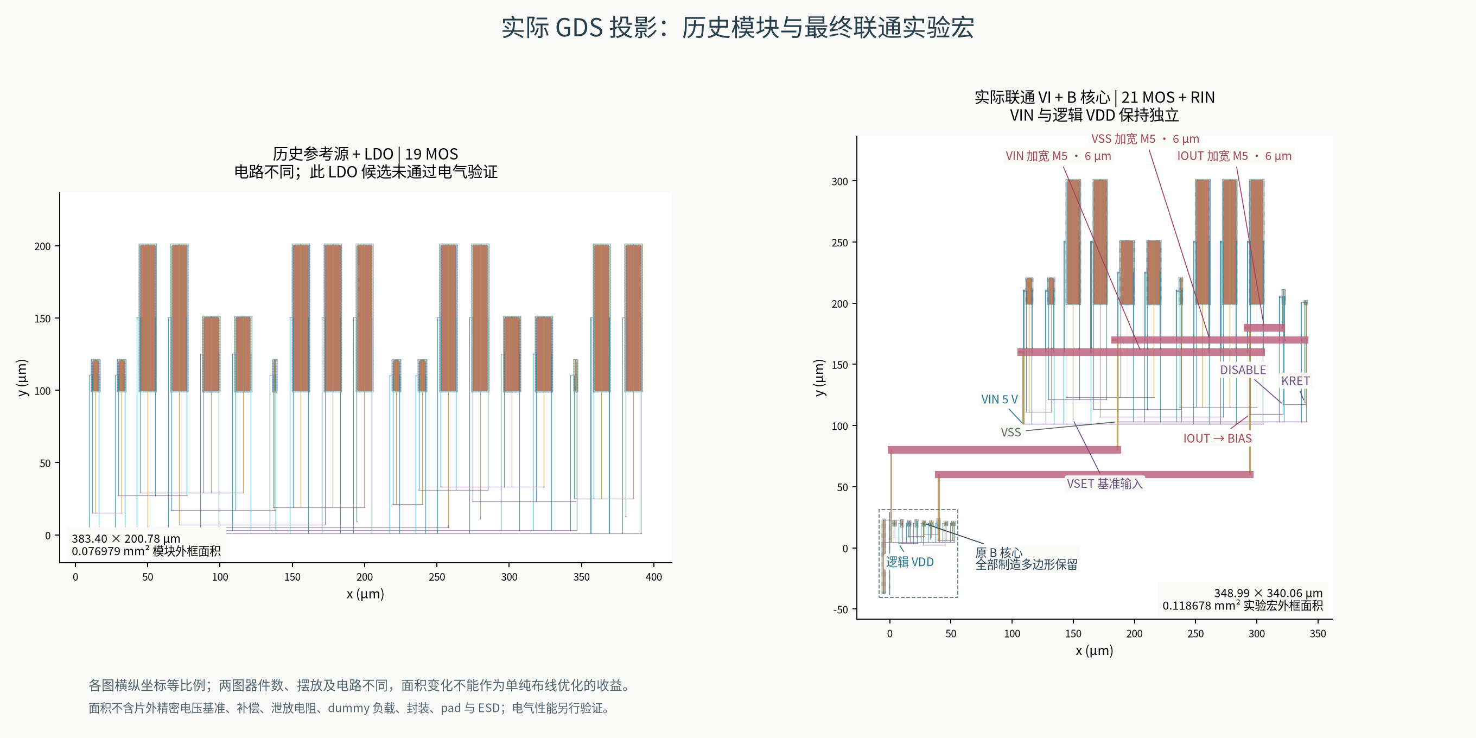
evidence/reference-v2-layout/visuals/nrz-switched-keeper-joint-r1.png
