Kevin-Kaiyo/open-microled-driver-asic/evidence/reference-v2-layout/visuals/vi-power-comparison.png

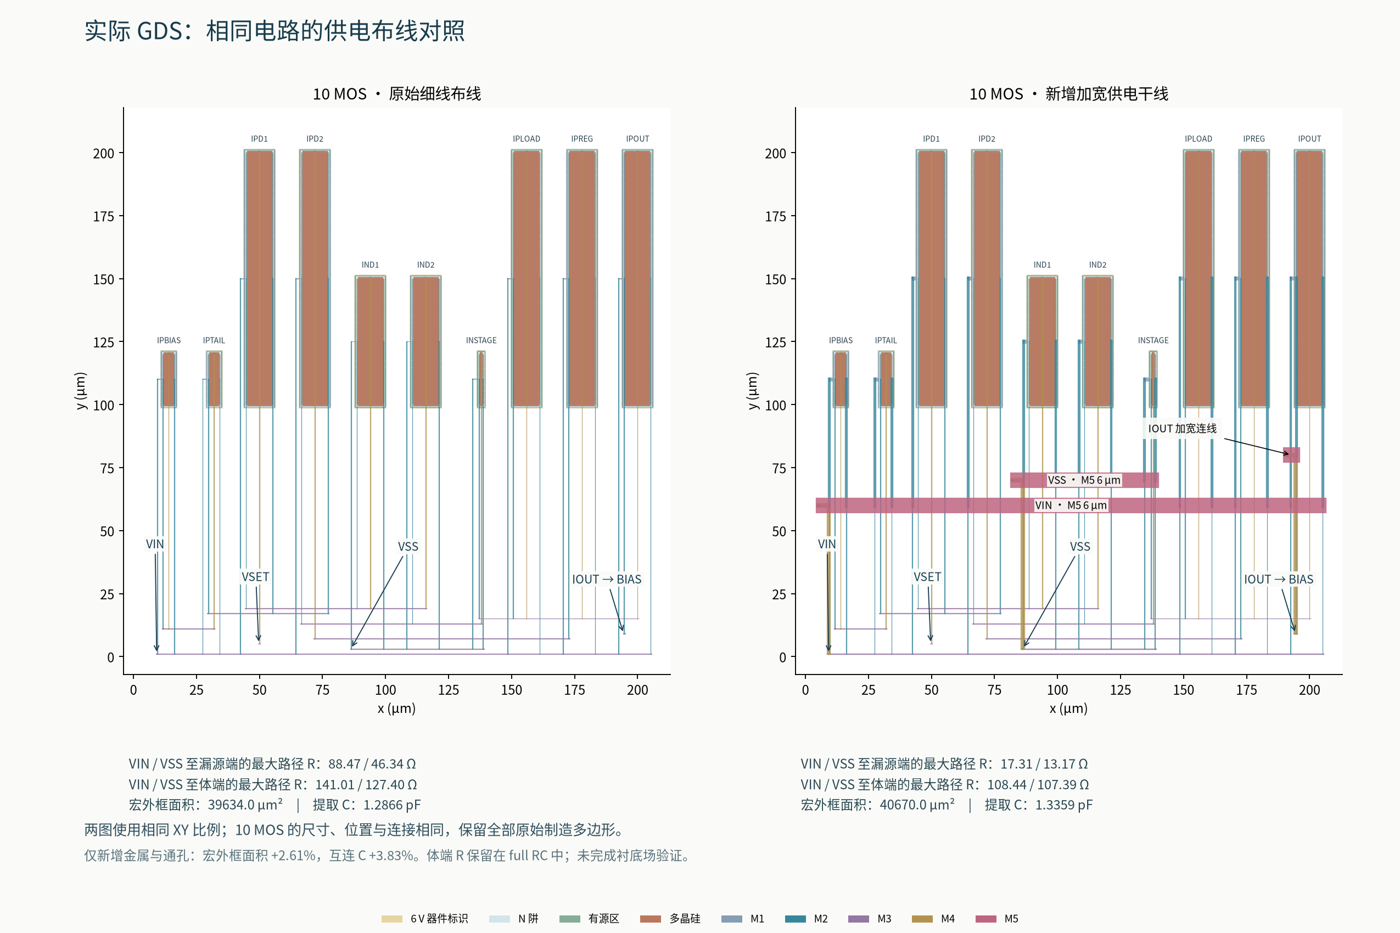
evidence/reference-v2-layout/visuals/vi-power-comparison.png
