Kevin-Kaiyo/open-microled-driver-asic/evidence/startup-v3/numerical/figures/pex-ff-initial-corner.png

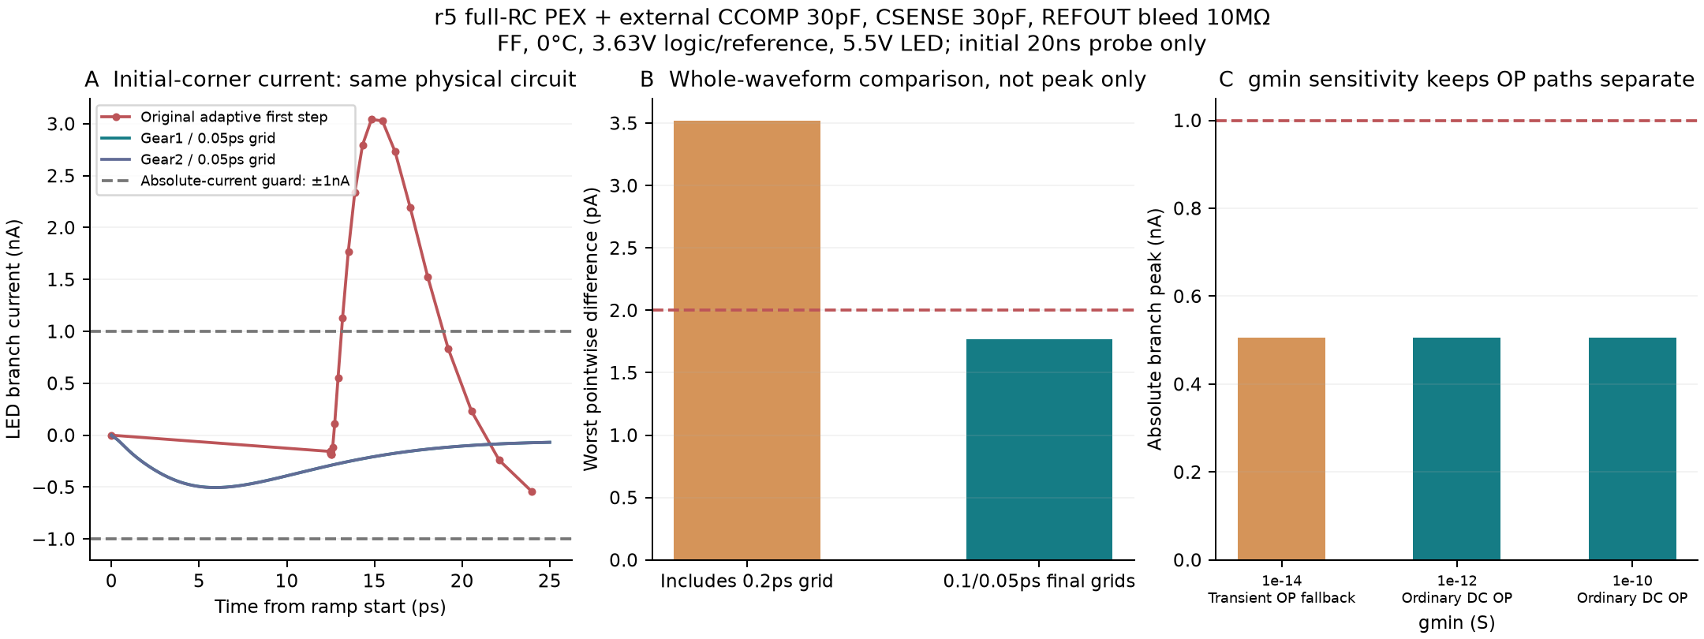
evidence/startup-v3/numerical/figures/pex-ff-initial-corner.png
