Kevin-Kaiyo/open-microled-driver-asic/evidence/startup-v3/numerical/figures/startup-numerical-convergence.png

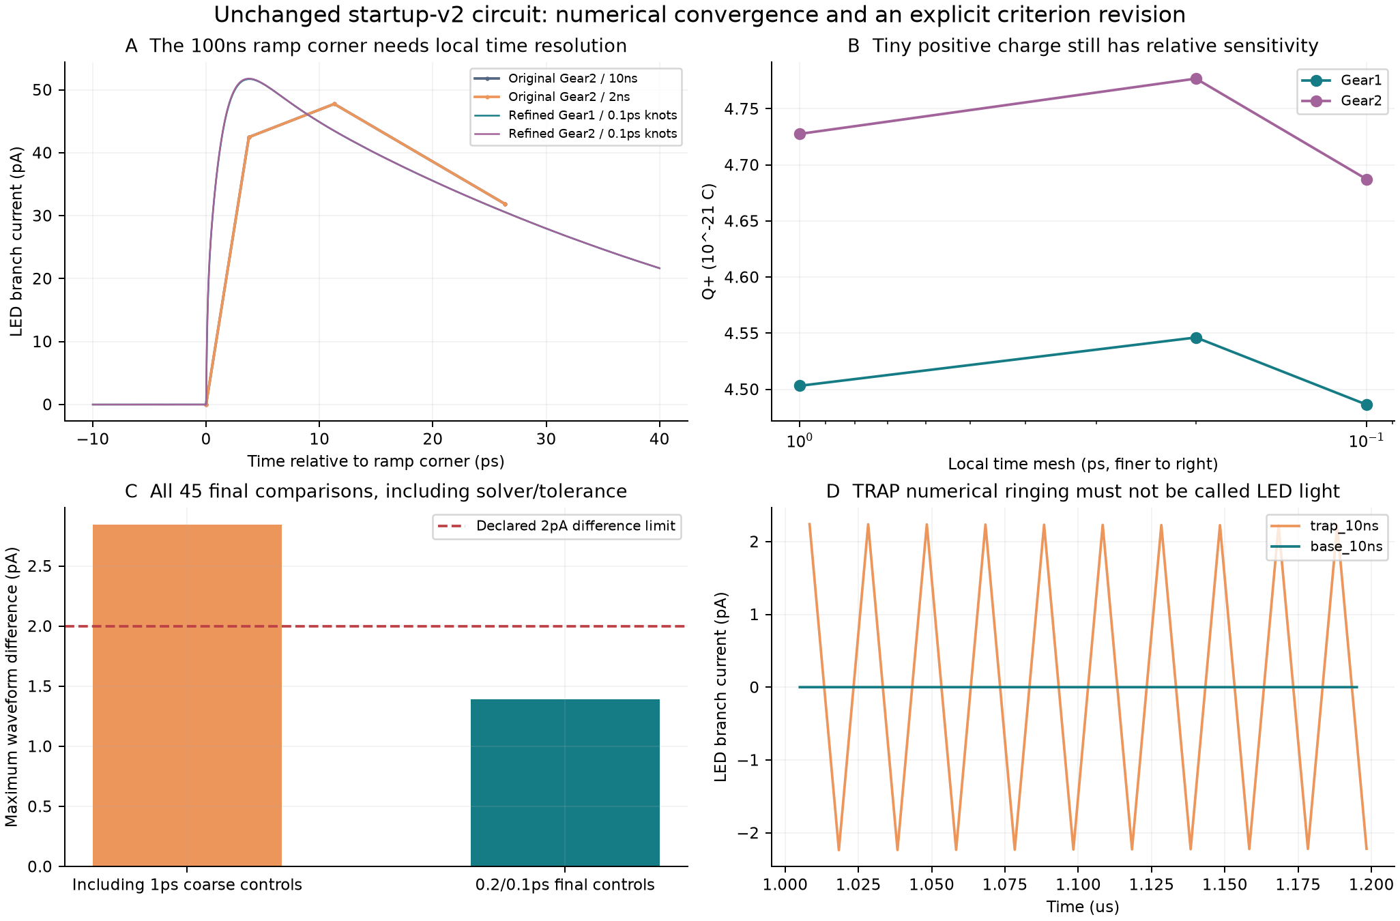
evidence/startup-v3/numerical/figures/startup-numerical-convergence.png
