Kevin-Kaiyo/open-microled-driver-asic/evidence/highspeed-nrz-pvt/summary.csv

name | route | kind | rate_Gbps | corner | temp_C | vdd_V | cap_F | r_pkg | l_pkg | edge_s | steps_per_ui | method | reltol | simulation_ok | analysis_ok | max_abs_terminal_V | above_3p63V_screen | maximum_body_forward_V | dc_bit | LED_current_A | LED_current_error_percent | rail_net_power_W | variant | result_json | analysis_json | errors | validation_bits | eye_normalized | threshold_margin_normalized | timing_min_margin_ui | sample_delay_ui | comparison_screen_passed | rail_net_fJ_per_gross_bit | rail_positive_draw_fJ_per_gross_bit | rail_returned_fJ_per_gross_bit | ideal_DATA_positive_draw_fJ_per_gross_bit | ideal_DATA_net_fJ_per_gross_bit | rail_plus_DATA_positive_draw_fJ_per_gross_bit | LED_mean_current_A | combined_screen_passed
AFTER-A-dc-1G-ff--40C-3.6V-C200-L0.5-e20-s40-bit0 | A | dc | 1 | ff | -40 | 3.6 | 2e-13 | 1.0 | 5e-10 | 2e-11 | 40 | gear | 1e-05 | True | True | 3.599999999999139 | False | 0.02008034668166303 | 0 | 2.566279998619026e-05 | 2.651199944761037 | 8.697061442628293e-05 | AFTER | build/highspeed-nrz-pvt/final-r4/cases/AFTER-A-dc-1G-ff--40C-3.6V-C200-L0.5-e20-s40-bit0/result.json | build/highspeed-nrz-pvt/final-r4/cases/AFTER-A-dc-1G-ff--40C-3.6V-C200-L0.5-e20-s40-bit0/analysis.json
AFTER-A-dc-1G-ff--40C-3.6V-C200-L0.5-e20-s40-bit1 | A | dc | 1 | ff | -40 | 3.6 | 2e-13 | 1.0 | 5e-10 | 2e-11 | 40 | gear | 1e-05 | True | True | 3.5999999999939485 | False | 6.553174241274969e-10 | 1 | 0.0001064841787881255 | 6.484178788125499 | 0.00040760503602308264 | AFTER | build/highspeed-nrz-pvt/final-r4/cases/AFTER-A-dc-1G-ff--40C-3.6V-C200-L0.5-e20-s40-bit1/result.json | build/highspeed-nrz-pvt/final-r4/cases/AFTER-A-dc-1G-ff--40C-3.6V-C200-L0.5-e20-s40-bit1/analysis.json
AFTER-A-dc-1G-ss-125C-3V-C200-L0.5-e20-s40-bit0 | A | dc | 1 | ss | 125 | 3.0 | 2e-13 | 1.0 | 5e-10 | 2e-11 | 40 | gear | 1e-05 | True | True | 2.999999999997434 | False | 0.03825899855977011 | 0 | 2.405618056616057e-05 | -3.775277735357726 | 8.152587401530418e-05 | AFTER | build/highspeed-nrz-pvt/final-r4/cases/AFTER-A-dc-1G-ss-125C-3V-C200-L0.5-e20-s40-bit0/result.json | build/highspeed-nrz-pvt/final-r4/cases/AFTER-A-dc-1G-ss-125C-3V-C200-L0.5-e20-s40-bit0/analysis.json
AFTER-A-dc-1G-ss-125C-3V-C200-L0.5-e20-s40-bit1 | A | dc | 1 | ss | 125 | 3.0 | 2e-13 | 1.0 | 5e-10 | 2e-11 | 40 | gear | 1e-05 | True | True | 3.000000000051052 | False | 3.9593484046918093e-10 | 1 | 8.560174682666579e-05 | -14.398253173334219 | 0.0003276705474465403 | AFTER | build/highspeed-nrz-pvt/final-r4/cases/AFTER-A-dc-1G-ss-125C-3V-C200-L0.5-e20-s40-bit1/result.json | build/highspeed-nrz-pvt/final-r4/cases/AFTER-A-dc-1G-ss-125C-3V-C200-L0.5-e20-s40-bit1/analysis.json
AFTER-A-dc-1G-typical-27C-3.3V-C200-L0.5-e20-s40-bit0 | A | dc | 1 | typical | 27 | 3.3 | 2e-13 | 1.0 | 5e-10 | 2e-11 | 40 | gear | 1e-05 | True | True | 3.299999999999296 | False | 0.027877480704214808 | 0 | 2.493978122134692e-05 | -0.24087511461232416 | 8.452031366657425e-05 | AFTER | build/highspeed-nrz-pvt/final-r4/cases/AFTER-A-dc-1G-typical-27C-3.3V-C200-L0.5-e20-s40-bit0/result.json | build/highspeed-nrz-pvt/final-r4/cases/AFTER-A-dc-1G-typical-27C-3.3V-C200-L0.5-e20-s40-bit0/analysis.json
AFTER-A-dc-1G-typical-27C-3.3V-C200-L0.5-e20-s40-bit1 | A | dc | 1 | typical | 27 | 3.3 | 2e-13 | 1.0 | 5e-10 | 2e-11 | 40 | gear | 1e-05 | True | True | 3.3000000001108867 | False | 5.725134115662891e-10 | 1 | 9.92069018226795e-05 | -0.7930981773204983 | 0.0003797487467996152 | AFTER | build/highspeed-nrz-pvt/final-r4/cases/AFTER-A-dc-1G-typical-27C-3.3V-C200-L0.5-e20-s40-bit1/result.json | build/highspeed-nrz-pvt/final-r4/cases/AFTER-A-dc-1G-typical-27C-3.3V-C200-L0.5-e20-s40-bit1/analysis.json
AFTER-A-fast_cold-0.1G-ff--40C-3.6V-C200-L0.5-e20-s40 | A | fast_cold | 0.1 | ff | -40 | 3.6 | 2e-13 | 1.0 | 5e-10 | 2e-11 | 40 | gear | 1e-05 | True | True | 3.620623097234341 | False | 0.05766265768966505 |  |  |  | 0.0002893334686126092 | AFTER | build/highspeed-nrz-pvt/final-r4/cases/AFTER-A-fast_cold-0.1G-ff--40C-3.6V-C200-L0.5-e20-s40/result.json | build/highspeed-nrz-pvt/final-r4/cases/AFTER-A-fast_cold-0.1G-ff--40C-3.6V-C200-L0.5-e20-s40/analysis.json | 0 | 511 | 1.0776183840218143 | 0.49116266684726995 | 0.390625 | 0.703125 | True | 2893.3346861260916 | 3837.9079047245655 | 944.5732185984727 | 33.50947094756851 | 29.17561395180298 | 3871.417375672134 | 6.624201651765398e-05 | True
AFTER-A-fast_cold-0.25G-ff--40C-3.6V-C200-L0.5-e20-s40 | A | fast_cold | 0.25 | ff | -40 | 3.6 | 2e-13 | 1.0 | 5e-10 | 2e-11 | 40 | gear | 1e-05 | True | True | 3.620623093216508 | False | 0.05766155160902109 |  |  |  | 0.0003519315064661359 | AFTER | build/highspeed-nrz-pvt/final-r4/cases/AFTER-A-fast_cold-0.25G-ff--40C-3.6V-C200-L0.5-e20-s40/result.json | build/highspeed-nrz-pvt/final-r4/cases/AFTER-A-fast_cold-0.25G-ff--40C-3.6V-C200-L0.5-e20-s40/analysis.json | 0 | 511 | 1.0776174313987081 | 0.49116203388108143 | 0.2265625 | 1.0078125 | True | 1407.7260258645438 | 1853.3317144649811 | 445.6056886004375 | 33.51156286279384 | 29.13619124232182 | 1886.843277327775 | 6.637622259978118e-05 | True
AFTER-A-fast_cold-0.5G-ff--40C-3.6V-C200-L0.5-e20-s40 | A | fast_cold | 0.5 | ff | -40 | 3.6 | 2e-13 | 1.0 | 5e-10 | 2e-11 | 40 | gear | 1e-05 | True | True | 3.6206227598504577 | False | 0.057655703228945976 |  |  |  | 0.0004562759357074634 | AFTER | build/highspeed-nrz-pvt/final-r4/cases/AFTER-A-fast_cold-0.5G-ff--40C-3.6V-C200-L0.5-e20-s40/result.json | build/highspeed-nrz-pvt/final-r4/cases/AFTER-A-fast_cold-0.5G-ff--40C-3.6V-C200-L0.5-e20-s40/analysis.json | 0 | 511 | 1.0765493731697926 | 0.49047490614117123 | 0.171875 | 1.296875 | True | 912.551871414927 | 1191.8049984807167 | 279.2531270657898 | 33.406517375836906 | 29.020079707530932 | 1225.2115158565537 | 6.66036220091304e-05 | True
AFTER-A-fast_cold-1G-ff--40C-3.6V-C200-L0.5-e20-s40 | A | fast_cold | 1 | ff | -40 | 3.6 | 2e-13 | 1.0 | 5e-10 | 2e-11 | 40 | gear | 1e-05 | True | True | 3.6206229291383303 | False | 0.05765693815719497 |  |  |  | 0.0006651680416010755 | AFTER | build/highspeed-nrz-pvt/final-r4/cases/AFTER-A-fast_cold-1G-ff--40C-3.6V-C200-L0.5-e20-s40/result.json | build/highspeed-nrz-pvt/final-r4/cases/AFTER-A-fast_cold-1G-ff--40C-3.6V-C200-L0.5-e20-s40/analysis.json | 0 | 511 | 0.96243370426465 | 0.4234598819746679 | 0.328125 | 1.578125 | True | 665.1680416010756 | 860.7923207140735 | 195.62427911299798 | 31.421343328546897 | 27.056087132414287 | 892.2136640426205 | 6.713388392871043e-05 | True
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
AFTER-B-dc-1G-ff--40C-3.6V-C200-L0.5-e20-s40-bit0 | B | dc | 1 | ff | -40 | 3.6 | 2e-13 | 1.0 | 5e-10 | 2e-11 | 40 | gear | 1e-05 | True | True | 3.599999999999291 | False | 6.08682881875211e-10 | 0 | 2.634274559293574e-05 | 5.370982371742951 | 0.00048557195843940793 | AFTER | build/highspeed-nrz-pvt/final-r4/cases/AFTER-B-dc-1G-ff--40C-3.6V-C200-L0.5-e20-s40-bit0/result.json | build/highspeed-nrz-pvt/final-r4/cases/AFTER-B-dc-1G-ff--40C-3.6V-C200-L0.5-e20-s40-bit0/analysis.json
AFTER-B-dc-1G-ff--40C-3.6V-C200-L0.5-e20-s40-bit1 | B | dc | 1 | ff | -40 | 3.6 | 2e-13 | 1.0 | 5e-10 | 2e-11 | 40 | gear | 1e-05 | True | True | 3.5999838813595737 | False | 6.0643490229495e-10 | 1 | 0.0001076727195734122 | 7.6727195734121985 | 0.0006241655350403008 | AFTER | build/highspeed-nrz-pvt/final-r4/cases/AFTER-B-dc-1G-ff--40C-3.6V-C200-L0.5-e20-s40-bit1/result.json | build/highspeed-nrz-pvt/final-r4/cases/AFTER-B-dc-1G-ff--40C-3.6V-C200-L0.5-e20-s40-bit1/analysis.json
AFTER-B-dc-1G-ss-125C-3V-C200-L0.5-e20-s40-bit0 | B | dc | 1 | ss | 125 | 3.0 | 2e-13 | 1.0 | 5e-10 | 2e-11 | 40 | gear | 1e-05 | True | True | 2.99999999999781 | False | 4.5065107201480714e-10 | 0 | 2.365575280493707e-05 | -5.3769887802517236 | 0.0004225083066893744 | AFTER | build/highspeed-nrz-pvt/final-r4/cases/AFTER-B-dc-1G-ss-125C-3V-C200-L0.5-e20-s40-bit0/result.json | build/highspeed-nrz-pvt/final-r4/cases/AFTER-B-dc-1G-ss-125C-3V-C200-L0.5-e20-s40-bit0/analysis.json
AFTER-B-dc-1G-ss-125C-3V-C200-L0.5-e20-s40-bit1 | B | dc | 1 | ss | 125 | 3.0 | 2e-13 | 1.0 | 5e-10 | 2e-11 | 40 | gear | 1e-05 | True | True | 3.2999143024330264 | False | 4.381148777099497e-10 | 1 | 9.208049281707616e-05 | -7.91950718292385 | 0.0005378921146638924 | AFTER | build/highspeed-nrz-pvt/final-r4/cases/AFTER-B-dc-1G-ss-125C-3V-C200-L0.5-e20-s40-bit1/result.json | build/highspeed-nrz-pvt/final-r4/cases/AFTER-B-dc-1G-ss-125C-3V-C200-L0.5-e20-s40-bit1/analysis.json
AFTER-B-dc-1G-typical-27C-3.3V-C200-L0.5-e20-s40-bit0 | B | dc | 1 | typical | 27 | 3.3 | 2e-13 | 1.0 | 5e-10 | 2e-11 | 40 | gear | 1e-05 | True | True | 3.299999999999333 | False | 5.00031127614875e-10 | 0 | 2.498631125459123e-05 | -0.054754981635080684 | 0.0004536189128424097 | AFTER | build/highspeed-nrz-pvt/final-r4/cases/AFTER-B-dc-1G-typical-27C-3.3V-C200-L0.5-e20-s40-bit0/result.json | build/highspeed-nrz-pvt/final-r4/cases/AFTER-B-dc-1G-typical-27C-3.3V-C200-L0.5-e20-s40-bit0/analysis.json
AFTER-B-dc-1G-typical-27C-3.3V-C200-L0.5-e20-s40-bit1 | B | dc | 1 | typical | 27 | 3.3 | 2e-13 | 1.0 | 5e-10 | 2e-11 | 40 | gear | 1e-05 | True | True | 3.299984993711084 | False | 4.975388989691965e-10 | 1 | 9.970739895334323e-05 | -0.29260104665677084 | 0.0005801787384384983 | AFTER | build/highspeed-nrz-pvt/final-r4/cases/AFTER-B-dc-1G-typical-27C-3.3V-C200-L0.5-e20-s40-bit1/result.json | build/highspeed-nrz-pvt/final-r4/cases/AFTER-B-dc-1G-typical-27C-3.3V-C200-L0.5-e20-s40-bit1/analysis.json
AFTER-B-fast_cold-0.1G-ff--40C-3.6V-C200-L0.5-e20-s40 | B | fast_cold | 0.1 | ff | -40 | 3.6 | 2e-13 | 1.0 | 5e-10 | 2e-11 | 40 | gear | 1e-05 | True | True | 3.6189417704655846 | False | 0.01908664385020087 |  |  |  | 0.000578113837234809 | AFTER | build/highspeed-nrz-pvt/final-r4/cases/AFTER-B-fast_cold-0.1G-ff--40C-3.6V-C200-L0.5-e20-s40/result.json | build/highspeed-nrz-pvt/final-r4/cases/AFTER-B-fast_cold-0.1G-ff--40C-3.6V-C200-L0.5-e20-s40/analysis.json | 0 | 511 | 1.0784218974674655 | 0.47789821807604616 | 0.1015625 | 1.0546875 | True | 5781.138372348091 | 5783.728113951265 | 2.5897416031746237 | 35.66546788032272 | 30.683315872694887 | 5819.393581831588 | 6.730137696428403e-05 | True
AFTER-B-fast_cold-0.25G-ff--40C-3.6V-C200-L0.5-e20-s40 | B | fast_cold | 0.25 | ff | -40 | 3.6 | 2e-13 | 1.0 | 5e-10 | 2e-11 | 40 | gear | 1e-05 | True | True | 3.6189419236630864 | False | 0.01908698363913608 |  |  |  | 0.0006127758323390319 | AFTER | build/highspeed-nrz-pvt/final-r4/cases/AFTER-B-fast_cold-0.25G-ff--40C-3.6V-C200-L0.5-e20-s40/result.json | build/highspeed-nrz-pvt/final-r4/cases/AFTER-B-fast_cold-0.25G-ff--40C-3.6V-C200-L0.5-e20-s40/analysis.json | 0 | 511 | 1.0074192871914824 | 0.41469217652158885 | 0.234375 | 1.140625 | True | 2451.1033293561277 | 2453.7104740315363 | 2.6071446754084158 | 35.662760452116714 | 30.644425778683868 | 2489.3732344836526 | 6.762861654634829e-05 | True
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
BEFORE-B-dc-1G-ff--40C-3.6V-C200-L0.5-e20-s40-bit1 | B | dc | 1 | ff | -40 | 3.6 | 2e-13 | 1.0 | 5e-10 | 2e-11 | 40 | gear | 1e-05 | True | True | 3.599966151065846 | False | 6.064300173136417e-10 | 1 | 0.0001203076471462427 | 20.3076471462427 | 0.0007064216632118605 | BEFORE | build/highspeed-nrz-pvt/final-r4/cases/BEFORE-B-dc-1G-ff--40C-3.6V-C200-L0.5-e20-s40-bit1/result.json | build/highspeed-nrz-pvt/final-r4/cases/BEFORE-B-dc-1G-ff--40C-3.6V-C200-L0.5-e20-s40-bit1/analysis.json
BEFORE-B-dc-1G-ss-125C-3V-C200-L0.5-e20-s40-bit0 | B | dc | 1 | ss | 125 | 3.0 | 2e-13 | 1.0 | 5e-10 | 2e-11 | 40 | gear | 1e-05 | True | True | 2.999999999997809 | False | 4.506577333529549e-10 | 0 | 2.071780094382675e-05 | -17.128796224693005 | 0.0003639818821249741 | BEFORE | build/highspeed-nrz-pvt/final-r4/cases/BEFORE-B-dc-1G-ss-125C-3V-C200-L0.5-e20-s40-bit0/result.json | build/highspeed-nrz-pvt/final-r4/cases/BEFORE-B-dc-1G-ss-125C-3V-C200-L0.5-e20-s40-bit0/analysis.json
BEFORE-B-dc-1G-ss-125C-3V-C200-L0.5-e20-s40-bit1 | B | dc | 1 | ss | 125 | 3.0 | 2e-13 | 1.0 | 5e-10 | 2e-11 | 40 | gear | 1e-05 | True | True | 3.2999248066334435 | False | 4.3811088090706107e-10 | 1 | 8.058531297596592e-05 | -19.414687024034084 | 0.00046453430483211854 | BEFORE | build/highspeed-nrz-pvt/final-r4/cases/BEFORE-B-dc-1G-ss-125C-3V-C200-L0.5-e20-s40-bit1/result.json | build/highspeed-nrz-pvt/final-r4/cases/BEFORE-B-dc-1G-ss-125C-3V-C200-L0.5-e20-s40-bit1/analysis.json
BEFORE-B-dc-1G-typical-27C-3.3V-C200-L0.5-e20-s40-bit0 | B | dc | 1 | typical | 27 | 3.3 | 2e-13 | 1.0 | 5e-10 | 2e-11 | 40 | gear | 1e-05 | True | True | 3.299999999999333 | False | 5.00031127614875e-10 | 0 | 2.498632727168508e-05 | -0.054690913259679175 | 0.00045362546833595344 | BEFORE | build/highspeed-nrz-pvt/final-r4/cases/BEFORE-B-dc-1G-typical-27C-3.3V-C200-L0.5-e20-s40-bit0/result.json | build/highspeed-nrz-pvt/final-r4/cases/BEFORE-B-dc-1G-typical-27C-3.3V-C200-L0.5-e20-s40-bit0/analysis.json
BEFORE-B-dc-1G-typical-27C-3.3V-C200-L0.5-e20-s40-bit1 | B | dc | 1 | typical | 27 | 3.3 | 2e-13 | 1.0 | 5e-10 | 2e-11 | 40 | gear | 1e-05 | True | True | 3.2999718119360484 | False | 4.975388989691965e-10 | 1 | 9.970946877303077e-05 | -0.2905312269692323 | 0.000580188989883747 | BEFORE | build/highspeed-nrz-pvt/final-r4/cases/BEFORE-B-dc-1G-typical-27C-3.3V-C200-L0.5-e20-s40-bit1/result.json | build/highspeed-nrz-pvt/final-r4/cases/BEFORE-B-dc-1G-typical-27C-3.3V-C200-L0.5-e20-s40-bit1/analysis.json
BEFORE-B-fast_cold-0.1G-ff--40C-3.6V-C200-L0.5-e20-s40 | B | fast_cold | 0.1 | ff | -40 | 3.6 | 2e-13 | 1.0 | 5e-10 | 2e-11 | 40 | gear | 1e-05 | True | True | 3.763589842713653 | True | 0.16626878484000107 |  |  |  | 0.000638445378070369 | BEFORE | build/highspeed-nrz-pvt/final-r4/cases/BEFORE-B-fast_cold-0.1G-ff--40C-3.6V-C200-L0.5-e20-s40/result.json | build/highspeed-nrz-pvt/final-r4/cases/BEFORE-B-fast_cold-0.1G-ff--40C-3.6V-C200-L0.5-e20-s40/analysis.json | 0 | 511 | 1.2078385853011793 | 0.4373949217495864 | 0.0859375 | 1.0078125 | False | 6384.453780703691 | 6391.601585616502 | 7.147804912811566 | 15.57056691640341 | 3.9865773302610132 | 6407.172152532906 | 7.5137124421058e-05 | False
BEFORE-B-fast_cold-0.25G-ff--40C-3.6V-C200-L0.5-e20-s40 | B | fast_cold | 0.25 | ff | -40 | 3.6 | 2e-13 | 1.0 | 5e-10 | 2e-11 | 40 | gear | 1e-05 | True | True | 3.763590285809203 | True | 0.16626976034987662 |  |  |  | 0.0006537113688630537 | BEFORE | build/highspeed-nrz-pvt/final-r4/cases/BEFORE-B-fast_cold-0.25G-ff--40C-3.6V-C200-L0.5-e20-s40/result.json | build/highspeed-nrz-pvt/final-r4/cases/BEFORE-B-fast_cold-0.25G-ff--40C-3.6V-C200-L0.5-e20-s40/analysis.json | 0 | 511 | 1.1437217823310748 | 0.3810850903714634 | 0.171875 | 1.0390625 | True | 2614.845475452215 | 2621.994583289781 | 7.149107837565846 | 15.570575212916237 | 3.9825323748408947 | 2637.5651585026976 | 7.538040147154969e-05 | False
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
GEOM-B-slow_hot-0.5G-ss-125C-3V-C200-L0.5-e20-s40 | B | slow_hot | 0.5 | ss | 125 | 3.0 | 2e-13 | 1.0 | 5e-10 | 2e-11 | 40 | gear | 1e-05 | True | True | 3.34468179554139 | False | 0.03591935700175197 |  |  |  | 0.0005105103676317474 | GEOM | build/highspeed-nrz-pvt/final-r4/cases/GEOM-B-slow_hot-0.5G-ss-125C-3V-C200-L0.5-e20-s40/result.json | build/highspeed-nrz-pvt/final-r4/cases/GEOM-B-slow_hot-0.5G-ss-125C-3V-C200-L0.5-e20-s40/analysis.json | 0 | 511 | 0.5204102879651719 | 0.20440277884966956 | 0.28125 | 1.3515625 | True | 1021.0207352634949 | 1023.2952093584645 | 2.2744740949697584 | 18.530487932419778 | 15.625785966512536 | 1041.8256972908846 | 5.902052706000164e-05 | True
