Kevin-Kaiyo/open-microled-driver-asic/evidence/ab-improvement-20261111/a-component-comparison.csv

instance | drain | gate | source | body | before_model | after_model | before_W | after_W | before_L | after_L | changed
XN1 | N1 | DI | VSS | VSS | nfet_06v0 | nfet_03v3 | 2.5u | 2.5u | .7u | 0.28u | True
XP1 | N1 | DI | VDD | VDD | pfet_06v0 | pfet_03v3 | 3.93u | 3.93u | .55u | 0.28u | True
XN2 | CTRL | N1 | VSS | VSS | nfet_06v0 | nfet_03v3 | 10u | 10u | .7u | 0.28u | True
XP2 | CTRL | N1 | VDD | VDD | pfet_06v0 | pfet_03v3 | 15.72u | 15.72u | .55u | 0.28u | True
XNOUT | OUT | CTRL | VL | VSS | nfet_06v0 | nfet_03v3 | 10u | 10u | .7u | 0.28u | True
XPOUT | OUT | CTRL | VH | VH | pfet_06v0 | pfet_03v3 | 15.72u | 15.72u | .55u | 0.28u | True
XHPBIAS | HPB | HPB | VIN | VIN | pfet_06v0 | pfet_06v0 | 20u | 20u | 4u | 4u | False
XHPTAIL | HTAIL | HPB | VIN | VIN | pfet_06v0 | pfet_06v0 | 20u | 20u | 4u | 4u | False
XHP1 | HN1 | VH | HTAIL | VIN | pfet_06v0 | pfet_06v0 | 20u | 20u | 4u | 4u | False
XHP2 | HG | HSET | HTAIL | VIN | pfet_06v0 | pfet_06v0 | 20u | 20u | 4u | 4u | False
XHN1 | HN1 | HN1 | VSS | VSS | nfet_06v0 | nfet_06v0 | 10u | 10u | 4u | 4u | False
XHN2 | HG | HN1 | VSS | VSS | nfet_06v0 | nfet_06v0 | 10u | 10u | 4u | 4u | False
XHSHUNT | VH | HG | VSS | VSS | nfet_06v0 | nfet_06v0 | 20u | 20u | .7u | .7u | False
XLPBIAS | LPB | LPB | VIN | VIN | pfet_06v0 | pfet_06v0 | 20u | 20u | 4u | 4u | False
XLPTAIL | LTAIL | LPB | VIN | VIN | pfet_06v0 | pfet_06v0 | 20u | 20u | 4u | 4u | False
XLP1 | LN1 | VL | LTAIL | VIN | pfet_06v0 | pfet_06v0 | 20u | 20u | 4u | 4u | False
XLP2 | LG | LSET | LTAIL | VIN | pfet_06v0 | pfet_06v0 | 20u | 20u | 4u | 4u | False
XLN1 | LN1 | LN1 | VSS | VSS | nfet_06v0 | nfet_06v0 | 10u | 10u | 4u | 4u | False
XLN2 | LG | LN1 | VSS | VSS | nfet_06v0 | nfet_06v0 | 10u | 10u | 4u | 4u | False
XLSHUNT | VL | LG | VSS | VSS | nfet_06v0 | nfet_06v0 | 20u | 20u | .7u | .7u | False
