Kevin-Kaiyo/open-microled-driver-asic/evidence/ab-improvement-20261111/a-improvement-summary.csv

candidate | net_Gbps | steps_per_UI | all_screens_pass | errors | amplitude_uAeq | time_ps | time_UI | electrical_errors | electrical_amplitude_uA | electrical_time_ps | electrical_time_UI | electrical_receiver_screen_pass | positive_pJ_per_attempted_bit | net_pJ_per_attempted_bit | current_min_uA | current_max_uA | body_forward_V | terminal_pass | source_result | source_result_sha256 | waveform_raw_sha256 | waveform_gzip_sha256
a-base | 1.2 | 40 | True | 0 | 19.25056301345773 | 300.19715525753537 | 0.41652355291983023 | 0 | 27.42329588873092 | 320.0016586962791 | 0.44400230144108715 | True | 1.1540643836265196 | 1.0769082883470373 | 16.896959710845138 | 113.0204305153151 | 0.1510316780456022 | True | build/ab-improvement-20261111/a-base/cases/TT-net1.2-C200-S40/result.json | f1d85f9e68090c22f8874b390f4334a2e8ef013161d1b4b9a50b0574e1e523fe | d39e50236eb6fd46a6b8f8620f6fbae7aefa93bfd44ec740596434c74af72335 | f2321c4b80254c88b2aa246682a90f16249a82ed9eb867f863d2b1f3628719d7
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
