Kevin-Kaiyo/open-microled-driver-asic/evidence/analog-v3/dc.csv

corner | temp | logic | led | on | name | led_current_a | reference_current_a | sense_v | bias_v | refout_v | passed
typical | 0 | 2.97 | 4.5 | 0 | dc_000 | 1.653978412563539e-12 | 9.913739630772027e-05 | 0.4993023584353122 | 1.357910686337928 | 1.483523438603871 | True
typical | 0 | 2.97 | 4.5 | 1 | dc_001 | 9.949551924895252e-05 | 9.913739632032244e-05 | 0.4993023584353128 | 1.357910677115366 | 1.483523423773508 | True
typical | 0 | 2.97 | 5 | 0 | dc_002 | 2.036525531545763e-12 | 9.913739630772033e-05 | 0.4993023584353122 | 1.35791068633803 | 1.483523438604035 | True
typical | 0 | 2.97 | 5 | 1 | dc_003 | 9.993627621672011e-05 | 9.913739632032006e-05 | 0.4993023584353123 | 1.357910677116956 | 1.483523423776062 | True
typical | 0 | 2.97 | 5.5 | 0 | dc_004 | 2.462384116053151e-12 | 9.913739630772219e-05 | 0.4993023584353112 | 1.357910686336413 | 1.483523438601438 | True
typical | 0 | 2.97 | 5.5 | 1 | dc_005 | 0.0001003381103335582 | 9.913739632032137e-05 | 0.4993023584353131 | 1.357910677116447 | 1.483523423775246 | True
typical | 0 | 3.3 | 4.5 | 0 | dc_006 | 1.653978412563539e-12 | 9.924844963080708e-05 | 0.4993727372042421 | 1.358289647928982 | 1.417494668505076 | True
typical | 0 | 3.3 | 4.5 | 1 | dc_007 | 9.960639499925796e-05 | 9.92484496383789e-05 | 0.499372737204243 | 1.358289638691599 | 1.417494658253588 | True
typical | 0 | 3.3 | 5 | 0 | dc_008 | 2.036525531545763e-12 | 9.924844963080554e-05 | 0.4993727372042422 | 1.358289647931088 | 1.417494668507411 | True
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
fs | 85 | 3.63 | 5.5 | 1 | dc_269 | 0.0001005059555559012 | 9.932856509216125e-05 | 0.4992923343387348 | 1.269238841706122 | 1.313260968562567 | True
