Kevin-Kaiyo/open-microled-driver-asic/(list of files, cad)

Other CAD files:
docs/research/blender-layout-20261018/single-pixel-r5.blend
docs/research/blender-pwm-animation-20261018/pwm-layer-animation.blend
docs/research/highspeed-driver-routes-20261019/package-concept.blend
docs/research/highspeed-workbench-20261110/physical/highspeed-cores.blend
