Kevin-Kaiyo/open-microled-driver-asic/analog/models/vcsel_research_20261027/figure8a-iv-manual-points.csv

model_current_mA | model_voltage_V | sampled_pixel_column | blue_pixel_median_y | pixel_inferred_current_mA | pixel_inferred_voltage_V | uncertainty_V | uncertainty_current_mA | classification
0.4 | 1.5 | 1224 | 788.0 | 0.4 | 1.5161538461538462 | 0.02 | 0.05 | manual rounded measured-dot knot; nearby color-mask pixel support
1 | 1.6 | 1280 | 686.0 | 0.96 | 1.6076923076923078 | 0.02 | 0.05 | manual rounded measured-dot knot; nearby color-mask pixel support
2 | 1.734 | 1385 | 542.0 | 2.01 | 1.7369230769230768 | 0.02 | 0.05 | manual rounded measured-dot knot; nearby color-mask pixel support
3 | 1.834 | 1483 | 433.0 | 2.99 | 1.8347435897435898 | 0.02 | 0.05 | manual rounded measured-dot knot; nearby color-mask pixel support
4 | 1.923 | 1587 | 331.5 | 4.03 | 1.9258333333333333 | 0.02 | 0.05 | manual rounded measured-dot knot; nearby color-mask pixel support
5 | 2.004 | 1684 | 254.0 | 5.0 | 1.9953846153846153 | 0.02 | 0.05 | manual rounded measured-dot knot; nearby color-mask pixel support
6 | 2.074 | 1786 | 174.0 | 6.02 | 2.0671794871794873 | 0.02 | 0.05 | manual rounded measured-dot knot; nearby color-mask pixel support
7 | 2.136 | 1888 | 98.0 | 7.04 | 2.1353846153846154 | 0.02 | 0.05 | manual rounded measured-dot knot; nearby color-mask pixel support
8 | 2.195 | 1983 | 33.5 | 7.99 | 2.1932692307692307 | 0.02 | 0.05 | manual rounded measured-dot knot; nearby color-mask pixel support
