Kevin-Kaiyo/open-microled-driver-asic/analog/models/vcsel_research_20261027/figure8b-3mA-manual-points.csv

pixel_x | pixel_y | frequency_Hz | s21_dB | uncertainty_dB
461 | 1322 | 2996300863.131936 | 0.35874439461883406 | 0.6
624 | 1280 | 5006165228.1134405 | 1.3004484304932735 | 0.6
786 | 1244 | 7003699136.868065 | 2.10762331838565 | 0.6
867 | 1174 | 8002466091.245376 | 3.6771300448430493 | 0.6
908 | 1153 | 8508014796.547472 | 4.147982062780269 | 0.6
948 | 1173 | 9001233045.622688 | 3.6995515695067263 | 0.6
1029 | 1252 | 10000000000.0 | 1.9282511210762332 | 0.6
1110 | 1350 | 10998766954.377312 | -0.26905829596412556 | 0.6
1191 | 1464 | 11997533908.754623 | -2.825112107623318 | 0.6
1272 | 1575 | 12996300863.131935 | -5.313901345291479 | 0.6
1353 | 1674 | 13995067817.509249 | -7.533632286995515 | 0.6
1435 | 1755 | 15006165228.11344 | -9.349775784753364 | 0.6
1516 | 1816 | 16004932182.490751 | -10.717488789237668 | 0.6
1597 | 1864 | 17003699136.868065 | -11.79372197309417 | 0.6
1678 | 1924 | 18002466091.245377 | -13.139013452914797 | 0.6
1759 | 1982 | 19001233045.62269 | -14.439461883408072 | 0.6
1840 | 2049 | 20000000000.0 | -15.941704035874439 | 0.6
