Kevin-Kaiyo/open-microled-driver-asic/docs/research/driver-robustness-20261024/pwm-figures/pwm-reference-step.png

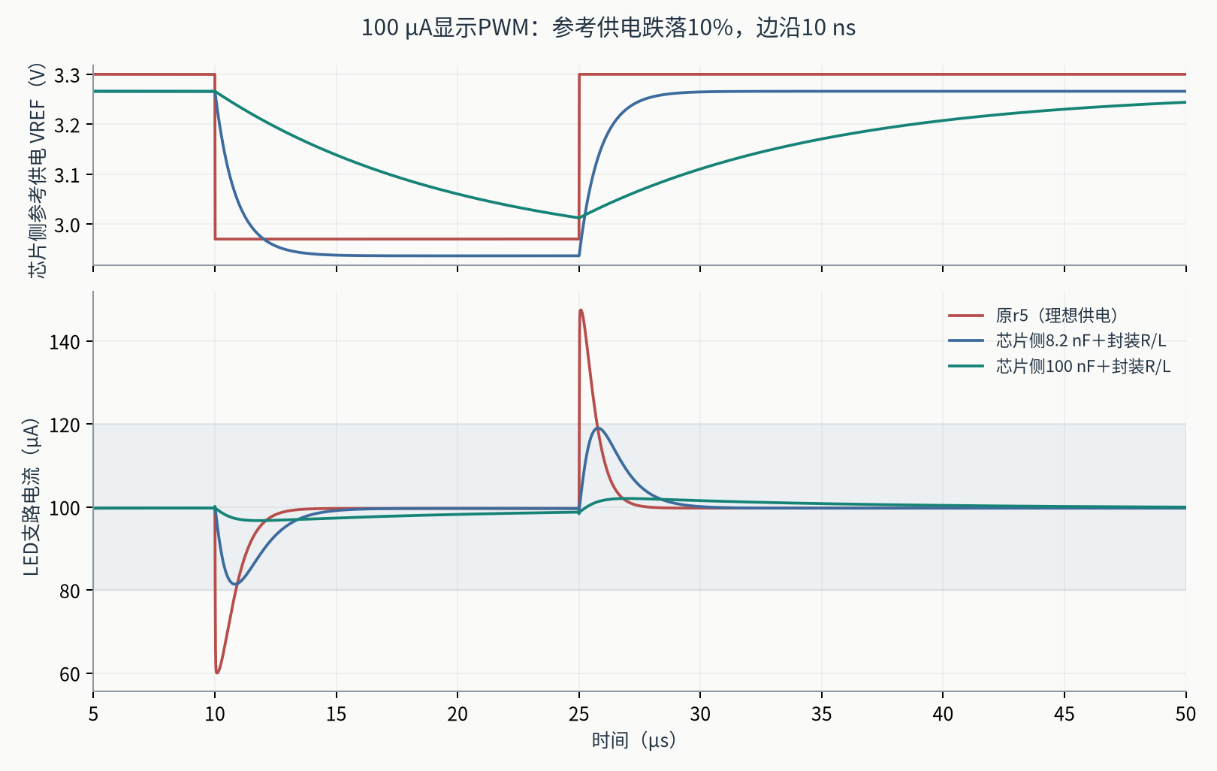
docs/research/driver-robustness-20261024/pwm-figures/pwm-reference-step.png
