Kevin-Kaiyo/open-microled-driver-asic/docs/research/pwm-reference-startup-20261024/figures/matched-board-step.png

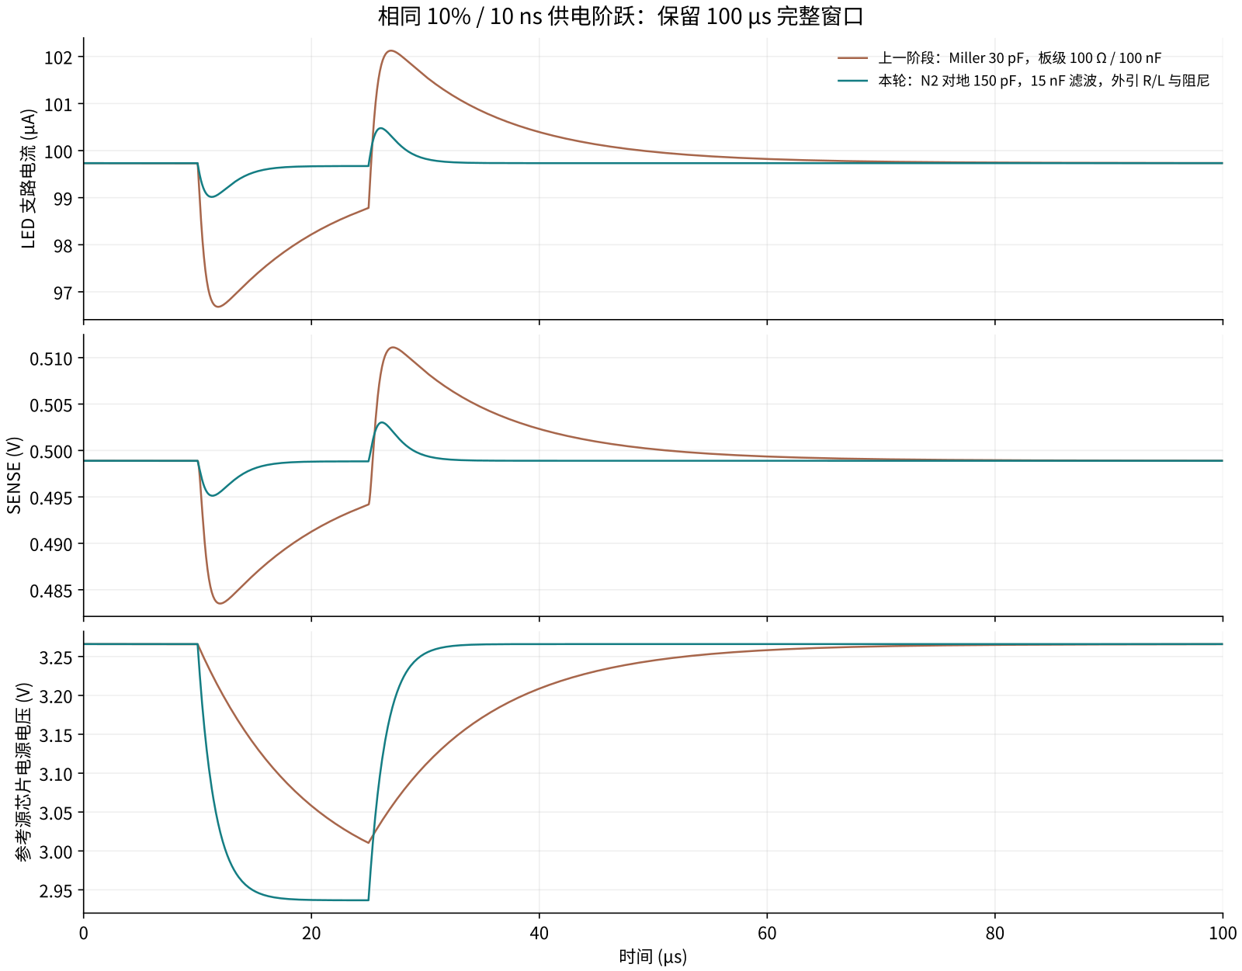
docs/research/pwm-reference-startup-20261024/figures/matched-board-step.png
