Kevin-Kaiyo/open-microled-driver-asic/docs/research/bench-validation-plan.md

# 从仿真走到实物：先验证负载，再验证芯片

日期：2026-10-05。**这是后续实物验证方案，尚未执行；没有假定已取得 LED、测试板、硅片或仪器。** 它不改变当前模型、GDS 和证据等级。目的是让下一笔投入能够回答一个明确问题。

## 1. 先取得一个有身份的真实负载

优先取得同一器件/结构的正向与低电流 I–V、reverse I–V、温度条件、C–V 或 impedance、pulse response，以及 L–I/光功率数据。记录制造/器件标识、mesa 与发光面积、颜色/波长、封装、连接方式、温度控制、测试电流、电压、仪器和校准方法。不能把不同结构的静态、动态与光学曲线拼成“同一器件的完整模型”。

公开 Lin 数据集当前只支持一条静态 I–V 及其已声明域；未知测量温度和未测低电流/reverse 区域要继续保留。新的测量应保存 raw 数据、重复扫描及不确定度，模型拟合留出独立点；拟合残差与测量不确定度分别报告。

| 问题 | 最小测量/记录 | 可以改变的决定 |
| --- | --- | --- |
| 5 V 是否够用 | 目标100 µA附近 I–V，温度与接触/串联压降 | LED rail、器件尺寸、sink headroom |
| 1 µs 是否有效 | 已校准的电流pulse与光学pulse，输入/输出delay与积分窗口 | clock、最低有效duty、PWM精度 |
| 低灰阶是否有光 | 同负载 L–I、低电流测量floor、背景扣除 | 光学灰阶声明、gamma/calibration需要 |
| 温度改变什么 | 同器件 I–V(T)、pulse(T)，测量重复性 | 工作包络、reference和补偿预算 |

## 2. 先做电测对照，再决定投片

在没有ASIC硅片时，可以用独立板级电流源建立测量方法，标记为 **board-level characterization**；本项目GDS的silicon结果需要实际芯片证据。实验对照固定约100 µA、相同LED／温度／供电和测量方式，先用已知信号检查仪器与积分方法，再比较模型预测和实测。

DC 测量确认 Ifull、IREF、VLED、Vbias 和sink余量；瞬态确认Q1、建立/关断、首帧与enable/reset延迟；光学测量另计背景、带宽、绝对/相对校准和积分时间。低漏电应同时报告测量下限，不能把读数零写成器件漏电为零。

## 3. 测量本身会改变电路

最低码理想电荷为 `100 µA × 1 µs = 100 pC`，±2%预算约2 pC。仪器offset、带宽、连接电容、时间窗和积分误差都可能占用这一预算，应先用已知信号验证方法。

在支路串入1 kΩ current-sense resistor时，100 µA带来0.1 V压降；10 kΩ带来1 V压降。真实静态LED在100 µA时Vf约3.768 V，5 V原本只剩约1.232 V给sink。因此sense resistor会改变headroom，必须在模型中加入并与无该电阻条件分开。

逻辑gate的负载也不能忽略：v0.3电荷等效输入约36.7 fF，而假设0.5 pF探针就约为其14倍。这里的0.5 pF只是负载算例，不是指定探针规格；正式测试按实际probe/adapter/线缆数据建模。高阻输入不代表低电容，也不代表不会影响边沿。

## 4. 真正硅片bring-up的进入条件

必须先取得provider对应工艺/PDK/rule版本与提交要求，完成匹配的pads/ESD、供电/封装、density/fill、antenna、可靠性和必要PEX。形成可审阅测试包，给每个pin标明电源域、默认状态、允许时序、测试负载与测量目的；公开monitor port当前不是已设计pad。

实物按限流供电、初始reset/disabled、reference与logic/LED建立顺序、DC、单pulse、完整frame、温度/重复样品逐步推进。实际排序和允许电压应由完成的器件/IO/电源保护设计规定，不能用当前理想源startup探针当成安全操作保证。

## 5. 进入4×4的判据

先确认选定真实LED的动态/温度模型足够支撑应用指标；单像素在实际reference、声明工作包络和测试负载下满足精度/功耗/最短pulse预算。再明确共享reference、偏置关断、同时点亮供电、独立帧更新和fault处理，建立新的阵列级门槛。

当前100 µA±5%与最低码电荷±2%是研究目标。是否适合用户的实际应用，仍需要光学/系统需求与真实测量；若用户只需要静态器件表征，最低1 µs光学pulse可能不应成为产品需求。

关联：[当前技术报告](research-report.md)、[电气v0.4条件](../specifications/electrical-v0.4.md)、[完整工程路线](../roadmap.md)。
