Kevin-Kaiyo/open-microled-driver-asic/docs/research/measured-led.md

# 一条真实 MicroLED I–V 曲线：来源、模型与使用边界

本轮补上了**一条有明确几何尺寸、可追溯且允许复用的数值 I–V 曲线**。选用 Lin 等人 2026 年发表的 20 µm 方形、diamond 基底上的黄色 InGaN MicroLED。它在 100 µA 时的线性插值电压是 **3.767910 V**，对应按 mesa 面积计算的平均电流密度 **25 A/cm²**。这是独立的真实数据研究工况，原先的合成 LED 基线保持不变。

这一步足以检验驱动器的静态电流和电压余量。源数据没有给出该 I–V 扫描的温度、重复次数、测量不确定度或偏置相关电容，因此还不能据此验证温漂、低灰阶动态或光学亮度。

## 1. 数据从哪里来

| 项目 | 可核查记录 |
|---|---|
| 原论文 | Lin et al., *Transfer-printed yellow and red InGaN micro-LEDs on diamond for ultra-low-power high-speed optical interconnects*, Nature Communications 17, 7674；2026-06-17；[DOI](https://doi.org/10.1038/s41467-026-74151-4) / [全文](https://pmc.ncbi.nlm.nih.gov/articles/PMC13433930/) |
| 数值来源 | 作者提供的 [Zenodo source dataset](https://doi.org/10.5281/zenodo.20034288)，record 20034288，2026-06-18；论文 Data availability 指向该记录 |
| 精确定位 | `source_data.zip` → `I-V.xlsx` → `Sheet1` → `A3:B102`；A1 标题为 `20μm yellow`，A2 为 `Current(mA)`，B2 为 `Voltage(V)`；对应论文 Fig. 2a 的 20 µm yellow 曲线 |
| 本项目保留 | [100 点 CSV](../../analog/models/measured-led/lin2026-yellow20-diamond-iv.csv)、[来源锁定](../../analog/models/measured-led/source-lock.json)、[模型卡](../../analog/models/measured-led/model-card.json)、[署名与许可](../../analog/models/measured-led/NOTICE.md) |
| 复用许可 | 数值 dataset 为 **CC BY 4.0**，由 [Zenodo API metadata](https://zenodo.org/api/records/20034288) 核实；论文自身为 **CC BY-NC-ND 4.0**，两者不可混为一谈 |

原始 archive 为 86,472,338 bytes，下载后同时检查 Zenodo 提供的 MD5 和本项目锁定的 SHA-256。原文件、下载元数据和自己生成的图留在 `build/led-fit/`，公开仓库保留选定曲线与紧凑证据。CSV 中保留原始 mA 电流与 Excel 行号，只新增 A 单位换算；没有从图片读数或补造缺失点。

这里称为“作者数值 source data”，而非仪器逐次采样原始日志：该工作簿没有说明每个点的平均、滤波或不确定度处理。原先优先查找的 Wolter 2021 [dataset DOI](https://doi.org/10.24355/dbbs.084-202103240746-0) 本轮访问遇到 Security Check，未绕过访问限制，也未把未取得的数据当作已经验证。

## 2. 已知器件与未报告条件

| 条件 | 本轮可采用的信息 | 对结论的限制 |
|---|---|---|
| 材料与结构 | InGaN/GaN MQW；20 µm 方形 mesa；flip-chip transfer-printed 到 diamond | 这是一种研究器件；没有采购型号或逐器件序列号 |
| 几何面积 | 20 × 20 = 400 µm² = 4 × 10⁻⁶ cm² | 电流密度按 mesa 面积平均，未验证局部电流分布 |
| 颜色 | 源文件标为 yellow | 发光谱随电流变化，不能把标签等同于固定波长 |
| 测量仪器 | 论文 Methods / Measurement method：Keithley 2614B source meter | 未报告本曲线的扫描方向、停留时间或 DC / pulse 模式 |
| 温度 | **未报告** | 不假定为 27 °C 或室温；不提取温度系数或物理 ideality factor |
| 数据覆盖 | 100 点；0.1 µA–32 mA；2.41622–6.40451 V | 只有一条公开曲线；实际器件个数、重复测量次数未知 |
| 其他物理量 | 没有本模型可用的 C–V、I–V(T) 或瞬态测量 | 光学、结电容、热、电荷存储及关断漏电仍未标定 |

论文中的高速光学链路和温升结果有其独立结构与测量条件。本项目没有用那些性能数值来替代当前驱动电路的动态验证，也没有把 archive 中的温升曲线当成 I–V 随温度变化的数据。

## 3. 先做两项能手算的检查

100 µA 位于两条实测点之间：88.55 µA / 3.73408 V 与 100.65 µA / 3.76983 V。使用电流轴的线性插值：

\[
V(100\,\mu A)=3.73408+
\frac{100-88.55}{100.65-88.55}(3.76983-3.73408)
=3.767909545\ V.
\]

面积换算为 \((20\times10^{-4}\,cm)^2=4\times10^{-6}\,cm^2\)，所以：

\[
J=\frac{100\times10^{-6}\,A}{4\times10^{-6}\,cm^2}=25\ A/cm^2.
\]

若 LED 电源为 5 V，留给整个驱动串联路径的电压仅约 **1.232 V**。原 2.8 V 合成负载留下 2.2 V；两者相差约 **0.968 V**。这是电压预算算术，不等于已经测得所有 MOS 都处于正确工作区；实际驱动电流与内部节点仍须由耦合电路验证。

## 4. 为什么采用静态分段线性模型

先尝试常见的经验形式：

\[
V=b+a\ln(I/100\,\mu A)+R(I-100\,\mu A),\qquad a>0,\ R\ge0.
\]

这个形式用于检查是否能用少数参数描述整条曲线，并未先验认定其参数是器件物理量。全范围拟合的 25 个留出点最大电压误差达到 **221.369 mV**，因此没有作为电路模型。缩小到约 10 µA–1 mA 后，无约束拟合给出的 R 为 **−43.360 Ω**；加上非负限制后 R 落在 0 Ω 边界。该结果说明这个局部三参数形式不足以可靠提取物理串联电阻，不能宣称真实器件电阻为负或为零。

最终使用源曲线的 **I(V) 分段线性重放**，保留全部 100 个测量节点。选模前按固定规则留出每四个点中的一个，端点保留在训练集合，结果为：

| 检查 | 训练 / 留出 | 留出 RMSE | 留出最大绝对误差 |
|---|---:|---:|---:|
| 全域分段线性插值 | 75 / 25 | 1.948 mV | 2.953 mV |
| 上述留出点中 10 µA–1 mA 的子集 | 留出 9 点 | 2.192 mV | 2.703 mV |
| 局部经验式，R ≥ 0 | 27 / 9 | 6.967 mV | 11.099 mV |
| 全域经验式，R ≥ 0 | 75 / 25 | 85.817 mV | 221.369 mV |

局部经验式实际覆盖 10.04–887.44 µA；表中 10 µA–1 mA 是筛选边界。分段线性方法直接在 V(I) 上做留出预测，其单调分段逆函数等价于电路中采用的 I(V)；最终电路表示使用所有 100 个源节点。

这里的 2.953 mV 是**同一条公开曲线的插值误差**。它没有量化源数据的测量误差，也没有证明换一个器件、温度或制作批次仍会有相同精度。完整结果与逐点留出预测见 [JSON](../../evidence/led-fit/lin2026-yellow20-fit.json) 和 [CSV](../../evidence/led-fit/lin2026-yellow20-holdout.csv)。

## 5. 电路接口与验证等级

```spice
.include analog/models/measured-led/lin2026-yellow20-dc.spice
XLED led_anode led_cathode lin2026_yellow20_dc
```

引脚顺序为 anode、cathode，正电流从阳极流向阴极。模型使用 ngspice behavioral source 的 `pwl`，其数学行为参考 [官方 ngspice manual](https://ngspice.sourceforge.io/docs/ngspice-47-manual.pdf)。

每个原始测量节点各运行一次独立 SPICE operating point，再加入 100 µA 插值点，共 **101 次**，全部通过。SPICE 电压与曲线的最大数值差约 1.78 × 10⁻¹⁵ V；这是**表示方式和数值实现的检查**，不是这样的物理测量精度。运行版本、输入 SHA-256、全部节点及差值保存在 evidence JSON，原始日志在 `build/led-fit/spice-static/`。

另做 **3 次独立边界 OP**，确认 ngspice-47 的 `pwl` 在首尾节点之外确实线性外推，并不夹紧到端点：−0.1 V 得到 −4.138696 nA，1.0 V 得到 41.386960 nA，6.8 V 得到 41.379017 mA。前两项使用未测的原点延拓段，后一项使用最后一段斜率；这些仅验证数学行为，不验证器件在域外的物理特性。该分母与上述 101 次域内检查分别记录，见 [边界证据](../../evidence/led-fit/lin2026-yellow20-boundaries.json)。

使用时必须保留这些边界：

- 只有 **0.1 µA–32 mA 的正向静态曲线**有数据依据。数据域下方加了 `(0 V, 0 A)` 的数值启动点；它与第一个源节点之间是未测线段。负偏置及高于最大测量点的外推同样没有物理验证。
- 本模型**没有温度缩放**。在耦合仿真中改变 `.temp`，会改变 MOS 模型；LED 仍是这条温度未报告的固定曲线。这样的结果应标为“MOS 温度变化、LED 曲线固定”的条件敏感性。
- 本模型没有电容或电荷存储。若接外加假设电容做 PWM 扫描，必须报告该电容是 sensitivity assumption，不能把结果称为已测 LED 动态、漏电或光学对比度。
- 不从分段斜率提取全域理想因子或物理 Rs。也不根据这一个研究样品决定量产结构、采购型号或封装兼容性。

### 静态耦合的当前完成结果

已把这条真实数值曲线接入 **W/L = 20/4 µm 的 mirror core 实际版图 RC 提取网表**，完成 148 个 DC operating points 与 10 个假设电容瞬态探针。以下数值来自 [当前耦合证据](../../evidence/characterization/measured-load-summary.json)，其 RC 源 SHA-256 为 `1de567fdc5697cd36f5879aa92c24b3b96d0b4f09f33b4a4720afb4aeeecd5b8`；先前 10/2 µm 探索结果留在原始运行目录，未混入本表。

| 检查 | 条件与结果 |
|---|---|
| DC 矩阵 | 5 个 MOS corners × VLED 4.5 / 5 / 5.5 V × Vlogic 2.97 / 3.3 / 3.63 V × 理想 IREF 99.5 / 100 / 100.5 µA，共 135 点 |
| 温度边界 | MOS 固定 27 °C；LED 是温度未报告的固定曲线，没有 LED 温度缩放 |
| 电流范围 | 98.175014–100.983768 µA；135/135 点位于目标 100 µA 的 ±5% 探索预算内 |
| 名义工作点 | typical、VLED=5 V、Vlogic=3.3 V、IREF=100 µA：99.788467 µA；LED 3.767285 V；cathode 1.232715 V |
| 名义电源功耗 | LED rail 498.942337 µW + logic/reference rail 330.000012 µW = 828.942349 µW；后者包含理想 IREF，不能称为纯逻辑功耗或已实现 reference 的实测功耗 |
| 低供电检查 | 另 13 个 typical 点：4.0 V 时 77.772418 µA，4.2 V 时 93.464616 µA，4.3 V 时 97.006693 µA；这些是离散检查点，不是所有 corners 的最低可用电源保证 |
| 测量域 | 148/148 个静态电流点位于源曲线正向数据域内 |

瞬态仍是 **0.2 / 2 / 20 pF 恒定假设电容加静态曲线的探针**。每个电容检查 duty=1 / 64 / 256，另对 20 pF、duty=1 做 2 ns 最大步长细化，共 10 次。该最短脉冲工况中约 **90.651% 时间、18.45% 有符号静态导电电荷**位于未测延拓区；即使其平均面积误差约 +0.136%，也没有完成真实 LED 动态验证。

域外统计沿保存的线性 V(t) 插入所有 PWL 节点交点后积分，电荷分母为 `∫I_static(VLED)dt`，与包含电容位移电流的电源电荷分开记录。报告同时保留四帧平均电流与同相位节点电压的重复性、端点电容电荷及重建残差；这些是数值诊断，没有设置隐含的周期稳定性通过阈值，也不证明所有内部电荷状态或真实器件已稳定。

## 6. 复现步骤与下一步门槛

已有项目 Python 环境及 ngspice 时，可以完全离线重算已公开的曲线：

```sh
.venv/bin/python scripts/led/fit_lin2026.py
```

若要从缓存 archive 重新提取原始单元格，加 `--extract-source`；若要重新下载并检查 archive，加 `--download`。脚本检查原 archive、workbook 和标准化 CSV 的锁定 hash，运行前冻结输入 hash，结束时确认输入没有变化。自绘曲线和留出残差图在 `build/led-fit/lin2026-yellow20-fit.png`，没有复用论文图像。

仅复现 3 个数学边界探针使用 `.venv/bin/python scripts/led/probe_boundaries.py`，不改变模型或重新拟合曲线。

下一步按可验证顺序推进：

1. **已完成：真实曲线与实际 20/4 µm RC 的静态耦合。** 上述 148 个 OP、135 点矩阵及两路静态电源功耗已记录；它们支持当前理想 reference 条件下的电流与电压余量判断。后续完整门槛仍需实际 reference、MOS 温度交叉条件与逐管端子应力检查，且须保留 LED 温度未知、曲线固定的限制；当前动态探针不升级为真实器件动态验证。
2. **动态结论的门槛：获得带偏置和频率条件的 C–V / impedance 或瞬态数据。** 需要把结、电极、封装与测试夹具寄生分开。取得前只做公开假设的电容敏感性，不选择一个“看起来合理”的 CJO 作为实测器件常数。
3. **温漂与安全电流门槛：同一器件 I–V(T) 和热边界。** 记录环境/基板/结温的区别、脉冲宽度与占空比、接触和散热条件，再检验温度函数；不能只靠波长或材料带隙推导工作电压温漂。
4. **光学与阵列门槛：L–I / EQE、光谱与器件间分布。** 至少关联同一几何/结构与工作电流，区分峰值、平均电流和实际光功率。在这一关之前，电流只能作为 electrical proxy，不能把单曲线拟合精度推广到 4 × 4 亮度一致性。

因此，本轮实质进展是把静态负载从纯假设推进到**公开测量曲线的独立重放**；完整真实器件模型仍需要动态、温度和光学数据。
