Kevin-Kaiyo/open-microled-driver-asic/docs/research/driver-robustness-20261024/experiment-design.md

# 供电、电阻与封装扰动：实验设计

日期：2026-10-24。定位：实验性研发方法验证与教学。任务依据为本轮用户明确要求；具体测试幅度由本项目选择，是工程敏感度实验，不是供应商保证范围。

## 要回答的问题

1. 现有高速驱动器距 3.63 V 项目筛查线仅 9–11 mV，加入供电变化、独立电阻角、封装 R/L 后是否仍通过？
2. 失败来自信号建立、偏置变化、器件端电压，还是公共返回阻抗？怎样用单因素对照区分？
3. PWM 恒流驱动和 NRZ 光通信分别需要什么验证，哪些结果不能相互替代？

## 只读基线与不变条件

- NRZ：2026-10-23 final-r4 实际版图及完整 RC。A 电压驱动、B 电流转向；同一公开黄色 MicroLED 静态模型、CLED=200 fF、20 ps DATA、原 PRBS 训练/验证与接收代理。温度不改变没有温度模型的 LED 曲线。
- 接收仍要求 511 位零错误、归一化垂直余量≥0.1、最小水平余量≥0.1 UI。培训/验证算法字节不变。取能统计所有电源和 DATA，动态电源必须用实际 v(t)i(t)，另存回灌与净值。
- PWM：r5 的 39 MOS 参考源/独立保护模拟宏，保留其原有合成 LED 模型及100 µA目标。它不采用 NRZ 的 LED 与接收条件；两应用间不直接比较“速率”或“每比特能量”。
- 旧报告、失败波形、模型和已发布证据保持可追溯。新生成物使用新的目录。

## 分解实验

先以 +50 mV 的逻辑电源变化重现 NRZ 端电压失败，区分 DATA 跟随供电和独立外部 DATA 两种接口。分别改变 MOS 角、温度、res_typical/res_ss/res_ff；同温度下交叉电阻角，避免把独立角变化与温度变化混淆。封装改变 R/L，保持内禀 CLED 不变；LED 串联回路与电源/地回路分别声明。

PWM 从已知参考供电跌落出发，分别测试设置电阻容差/温漂、供电扰动与串联封装回路。片外精密电阻容差不得改称 PDK 电阻工艺角。修改候选须同时检查启动、DC 压降和独立关断，不能只改善正常工作波形。

具体每个案例的值、模型/网表/算法哈希及输入身份保存于两个独立实验目录的 manifest/case 文件；只按实际完成案例报告覆盖，不把选定角或敏感度扫描称作完整统计签核。

## 修改策略与取舍

输入阻尼能影响动态馈通，不能降低持续抬高的电源。供电上界是系统要求；理想限压源只可作为诊断控制，不能冒充已设计的片内稳压器。若采用厚栅氧 MOS 候选，必须保留原 LED/RX，并重新验证器件几何、DC、速度、能耗和真实版图。器件选型的变化允许带来速率和面积代价，不以修改接收阈值获得通过。

公开 DRM 14.1.4.2 给出了薄栅氧栅极到其他端子的绝对直流上限 3.63 V。项目对全部 MOS 端对的瞬态统一筛查，比该条款的适用范围更宽；周期超限寿命、HCI、EM 和其他签核不得由一次波形通过推导。厚栅氧若采用，单独列出实际器件和约束依据，不把薄栅氧阈值机械套用，也不把6V器件名称当作完整可靠性许可。

## 实施与证据边界

原理图对应实际连接；版图图像来自真实 GDS。只有实际修改、重新 DRC/LVS/PEX 的候选可以标为新版图。片外滤波不会被描述成片内新 GDS。封装集总 R/L 是敏感度模型，不是封装三维场求解；零误码仅是声明码长下的仿真结果，不是实测 BER。

报告入口沿用现有静态 HTML 研究报告体系，新增独立章节并链接历史结果。最后执行数值/输入身份/覆盖审计、可视化检查；已验证阶段按用户选择同步现有公开 GitHub，原始证据另做版本化 Release 与 SHA-256 回读。

公开依据：[GF180MCU DRM 14.1](https://gf180mcu-pdk.readthedocs.io/en/latest/physical_verification/design_manual/drm_14_1.html)，读取于2026-10-24。
