Kevin-Kaiyo/open-microled-driver-asic/evidence/three-gbps-experiment-20261027/microled-interpretation.md

# MicroLED 3.2 Gb/s 诊断解释

完成 9 个原条件 TT/SS/FF 晶体管点，全部未通过原 v2 完整接收 screen；另有 3 个 TT 零电容对照、16 个 DC 检查、3 个细步长复核和 4 个 ngspice 理想 sink 负载对照。所有求解正常结束；接收失败保留原值，没有放宽门槛。

1. **负载储能有独立影响。** 理想电流 sink、同一静态 LED PWL 和封装、200 fF 下，NRZ/PAM4 的电气层分别出现 863/1199 个错误；只把外接电容改为 0，电气层均无错误且通过原幅度/时序门槛。这隔离了静态 rd 与外接 C 的耦合影响，但不能把理想 sink 结果等同于电压输出路线 A。
2. **驱动端与训练算法必须分开解释。** 保留真实晶体管与同一静态 LED，去掉外接 C 后，A/C 电气层仍有错误；B 电气层已经零错误，但原 v2 幅度优先选相的时序裕量仅约 17 ps。下面保留原判据；不能据 B 的这个选相点宣称其驱动本身绝对不可能通过。训练区联合幅度/时序可行性另列在 JSON 中，不修改接收机。

| 路线 | 零 C 电气错误 / 4096 | 最小裕量 µA | 时序 ps |
|---|---:|---:|---:|
| A | 597 | -41.491 | 0.000 |
| B | 0 | 34.471 | 17.087 |
| C | 114 | -6.379 | 0.000 |

3. **下游代理也有限制。** 直接输入理想的 20 ps 边沿、固定标称电平，最细 1.25 ps 网格下 NRZ 完整代理为 0 错误但只有 0.499 µA / 26.06 ps；PAM4 为 215 个错误、−1.555 µA / 0 ps。两者均达不到原 7.5 µA / 100 ps 门槛。这里没有证明所有整形波形或所有接收结构都不可能通过。

三个机制不能按上述控制结果相加。滤波、非线性负载、驱动脉冲与训练选择存在相互作用；有的阶段错误数下降也不意味着整个链路已通过。应在电流峰值/平均值、体结/端压、同一发光器件和同一接收条件下验证改动，暂时不能选出可行赢家。

## 接收训练可行性核查

所有 12 个晶体管完整代理点，在冻结 1601 个训练延迟候选中，最大“最小判决裕量”均为负值，且最少训练错误也大于 0。因此保持本组波形、门槛与延迟网格时，换成联合幅度/时序选相算法仍不能通过。这不是对任意连续相位、均衡器或不同接收机的不可行证明。

B 零 C 的电气层，在所有幅度至少 7.5 µA 的训练延迟中，最大训练时序裕量为 92.343 ps；仅 RX 层为 42.672 ps，均没有同时达到 100 ps 的候选。原幅度优先选相的约 17 ps 确实保守，但冻结网格下联合选相仍未找到合格点。

## 数值与电压边界

- 三条 TT 原条件点的 symbol/40→symbol/80 复核全部满足既有数值门槛，错误数均保持 A=844、B=1440、C=1399。
- 16 个 DC 检查显示外接 200 fF 与 0 fF 的相应 DC 电流完全一致；原校准参数未重新优化。
- 端间最大电压 screen 不是 body-junction 或可靠性签核：TT C 的最大体结正向电压约 0.858 V，零 C 的 A 约 0.731 V。没有新设或放宽体结门槛，也不声称这些波形是安全工作点。
- 失败点的 pJ/net-bit 只表示七个输入端口的正向能量；不能据此宣称合格 3.2 Gb/s 链路的能效或跨 VCSEL/MicroLED 排名。
- 训练审计脚本初版因 RX-only 也存在幅度可行候选而触发保护断言；补入对应的精确因果滤波后复核成功。初版源码、失败原因和修复边界保留在 build/.../audit-failures/，未影响原始仿真或接收结果。

主数据见 microled-summary.json，数值核查见 microled-validation.json，全部阶段训练网格核查见 microled-training-feasibility.json。原始波形、日志与逐阶段判决在 build/three-gbps-experiment-20261027/microled/run-r1/。

重现此解释与训练核查：

```sh
build/layout/venv/bin/python scripts/three_gbps_experiment/microled_feasibility.py
```

summary SHA-256: `ad7ec973e87d8642ee6d9cd25c54dd4d5a80f2c670d67e152a4f06f77fa62de6`；本核查脚本 SHA-256: `71afcdbbaa9a5fbd8a60de178b25c99feba6ce49b1d87eeab90fae62e01c6a13`。
