Kevin-Kaiyo/open-microled-driver-asic/docs/research/microled-dynamic-validation-20261108/index.html

OPEN MICROLED DRIVER ASIC · 2026-11-08 · 动态负载验证

# 20 µm MicroLED 动态负载：校准边界、敏感性与净 3.2 Gb/s 的 A/B/C 验证

2026-11-08 · 中文研究报告 · 原理图级晶体管仿真、公开数据拟合与接收代理分析

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

这些通过或失败只属于明确的 C/τ 假设和电流域接收代理。幅频拟合仍只能解释已测整链幅度，尚不能作为真实器件瞬态预测；器件物理动态校准未闭合。暂不预选路线。

本轮继承器件与 Driver 共设计研究，将其中的验证方案推进到实际数据处理和晶体管实验。项目定位仍是实验性研发方法验证与教学。文献数据、条件化模型、仿真接收结果与真实光学链路是不同证据层级。

阅读目录

- 1. 固定什么，改变什么？
- 2. 电路连接：导电电流、电容电流和光响应要分清
- 3. 校准了什么？还不能从幅频反推出什么？
  - 3.1 静态与 DC 回归
  - 3.2 公开动态数据的独立拟合和留出检验
- 4. 同一接收器下的 A/B/C 结果
  - 4.1 先复核旧基线，再看修改负载后的变化
  - 4.2 电容与光响应时间的完整敏感性矩阵
  - 4.3 相同坐标眼图与分层诊断
- 5. 能耗：统计范围和失败点的含义
- 6. 为什么失败？角落、数值分辨率和模型域
- 7. 下一步的实验与设计门槛
- 8. 证据、来源和复现

## 1. 固定什么，改变什么？

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

现有 A/B/C 的设置均沿用同一冻结输入包，不在每个电容或角落重新校准电流。给 C 更长符号 UI 是两位一符号的必然结果；它没有获得更低的接收幅度门槛或额外验证训练。

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

## 2. 电路连接：导电电流、电容电流和光响应要分清

负载、电流参考面与接收模型

图 1｜本轮实际 testbench 的负载连接及后处理参考面。BIV/二极管符号表示文献 I–V 的行为负载；VSENSE 只测导电支路。光响应是假设的因果状态模型，未由整链幅频唯一校准。

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

实际器件展开沿用已核查的原理图：A 输出核心、A 辅助轨、B 核心、公共参考、C 总览、C 译码与C 单位电流。本轮不改变这些源网表，新增的是负载假设扫描和模型检验。

## 3. 校准了什么？还不能从幅频反推出什么？

### 3.1 静态与 DC 回归

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

16 点的最大绝对目标误差为 0.126733%。这是冻结晶体管模型对目标电流的仿真偏差，不包含真实样品测量、失配或生产公差，也没有为本轮重新调整电流参数。

改变常数并联电容不改变稳态电容电流。两个电容组的 DC 一致性控制单独保存，不能用动态幅频拟合重新调整目标电流。

### 3.2 公开动态数据的独立拟合和留出检验

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

这些是条件化幅频拟合，不是器件动态参数校准完成。高频残差、频率外推、偏置留出与参数触边见完整拟合验证。不把拟合零点解释为 LED 物理机制，也不把最小相位当成测量结果。

模型族及阶数使用完整源曲线选择；以下留出仅在既定模型族下重新拟合或预测，未进行嵌套选模或独立器件盲测，因此属于条件化内部检验。≤2.5 GHz 只是截取的频域范围，缺少仪器噪声数据时不能称已验证的高信噪比区间。

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

另以假定 50 Ω 激励源和 3 GHz 一阶检测器测试 C/τ 简化组合，属于对源测量链的兼容性检验。这一假定检测器与下文 A/B/C 固定 1 GHz RX 属不同参考面。简单组合的残差不能证明真实电容或寿命不合格，只说明这些参数与测量链尚未联合识别。 图 2｜公开整链幅频与独立数学拟合；测量链、归一化和高频噪声仍在数据内。

图 2｜公开整链幅频与独立数学拟合；测量链、归一化和高频噪声仍在数据内。

即使一个稳定的最小相位数学模型能拟合幅度，也不能据此证明其相位、复合寿命、电容或检测器分配正确。H(s) 与 H(s)·exp(−sTd) 幅度相同；纯延迟可能被现有训练窗口吸收，但未知的频率相关相位、群延迟和大信号状态仍会改变眼图。不能用幅频唯一推断瞬态接收。

因此，新模型卡分别记录 静态数据校准状态、整链幅频拟合状态、动态物理参数识别状态。整链拟合留在频域证据层；下面的晶体管实验使用单独编号的敏感性模型，不把整链 S21 再串到 CLED 和 1 GHz RX 后面。

## 4. 同一接收器下的 A/B/C 结果

### 4.1 先复核旧基线，再看修改负载后的变化

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

原生求解复现回执独立核对样本数、七端口能量、器件端压和旧接收判决；新增导出电压用于诊断，不改变电路参数。

### 4.2 电容与光响应时间的完整敏感性矩阵

图 3｜三路线使用相同色标与 RX；这是负载假设扫描，不是实测器件性能。

图 3｜三路线使用相同色标与 RX；这是负载假设扫描，不是实测器件性能。

每格为 观察错误数 / 最小有符号幅度 µAeq / 最小单侧时间 ps。幅度需≥7.5 µAeq、时间需≥100 ps，并满足其余接收与电气筛查。

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

完整记录与精度见RX 矩阵 CSV。* 0 fF 或 0 ps 为理想限制控制，不能据此宣称器件可制造。

这里的 µAeq 不是实测接收光功率。改变光响应时间不会反过来改变本轮晶体管电气取能，所以同一个电容/电路下，四种光响应假设共享同一电气能量。这是当前分块模型的适用边界，不能冒充已完成电–光–热双向耦合。

### 4.3 相同坐标眼图与分层诊断

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

完整矩阵中0 fF/0 ps控制仍未恢复所有联合门槛，排除了“只减小并联电容就足够”的解释；但它保留真实Driver、封装和固定RX，不能进一步断言所有电路或接收方法都不可行。

固定接收规则本身的控制实验。 另外给出具有20 ps线性边沿的理想导电电流，全帧和接收规则完全相同。它不含真实 Driver，也没有可比较的电路取能。

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

这些是特定波形和既定幅度优先训练规则的结果，不是任意波形的可行性上界。零观察错误仍可能不满足100 ps时间门槛；τ更短也未保证所有指标单调改善。因此，不能把每个失败都归因于 Driver 或 LED。

绕过某一级滤波只用于定位限制，不能把绕过后的结果当成完整链路通过。也不能把 C=0 fF 或 τ=0 ps 的结果当成可制造器件。

## 5. 能耗：统计范围和失败点的含义

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

图 5｜七输入端口正向取能分解；DATA 合并 D0/D1/DISABLE，返回能量另外列出。

图 5｜七输入端口正向取能分解；DATA 合并 D0/D1/DISABLE，返回能量另外列出。

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

该数值不包括上游电源/精密基准芯片内部、串行器/时钟、实体光接收器与编码/DSP 的全部功耗。电容净储能和建立过程也需要单独检查。接收失败点的低 pJ/bit 是尝试发送的取能，不能解释成有效交付效率更优。

## 6. 为什么失败？角落、数值分辨率和模型域

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

这里 τ=75 ps 只是列示相同假设，未根据哪个结果更好而逐角选择。其他光响应和电气失败见完整矩阵。SS/FF 的 LED 光学温漂仍未建模。

端对电压通过不等于体结/可靠性通过。 下面单独列出同一TT帧的最大体结正向偏置及器件。较小电容可能暴露新的切换过冲；没有匹配工艺的可靠性规则，不能把此类点当作产品候选。

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

需要区分三类失败：一是电气电流未在给定 UI 内进入目标判决区；二是电气有变化，但后续光响应/RX 的码间干扰使判决失败；三是接收代理可能有开口，但器件端压、体结、DC 目标或模型适用域检查失败。它们对应不同的下一步修改。

数值复核分别报告状态积分、旧基线复现、DC电容控制和 S40/S80 最大步长减半。它们验证数值路径，不替代新实测参数。详见 RX 验证和电气回执。

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

## 7. 下一步的实验与设计门槛

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

本轮的价值是把“文献说有 GHz”与“当前驱动器在这个 UI 内实际交付什么”用明确的参考面和可重跑证据连接起来。项目还没有完成实物光学链路、阵列或流片签核。

## 8. 证据、来源和复现

复现说明、工具/源码哈希和备份范围见reproduce.md。模型卡、频域验证、电气矩阵与接收矩阵均可检查。

- 静态来源：模型卡、源数据通知。
- 动态来源：原始定位与许可台账、数据提取章节。
- 原论文：Transfer-printed yellow and red InGaN micro-LEDs on diamond… (https://pmc.ncbi.nlm.nih.gov/articles/PMC13433930/)；本轮公开文件只复用已明确许可的数值数据及原创图，不重新发布受限论文图像。
- 本轮原始输出在 build/microled-dynamic-v1/；本轮模型和 compact evidence 在 analog/models/microled_dynamic_v1/ 与 evidence/microled-dynamic-v1/。源版本、文件 SHA、数值验证、失败和备份范围分别记录。
