Kevin-Kaiyo/open-microled-driver-asic/analog/models/measured-led/lin2026-yellow20-diamond-iv.csv

source_excel_row | source_current_mA | current_A | voltage_V
3 | 0.0001 | 1.0000000000000001e-07 | 2.41622
4 | 0.00011366000000000001 | 1.1366000000000001e-07 | 2.4289299999999998
5 | 0.00012918599999999999 | 1.29186e-07 | 2.44164
6 | 0.00014683299999999999 | 1.46833e-07 | 2.4544000000000001
7 | 0.00016689 | 1.6689000000000001e-07 | 2.4674499999999999
8 | 0.00018968699999999999 | 1.89687e-07 | 2.48095
9 | 0.000215598 | 2.1559800000000002e-07 | 2.4942799999999998
10 | 0.000245049 | 2.4504900000000001e-07 | 2.5083299999999999
11 | 0.00027852299999999998 | 2.7852299999999996e-07 | 2.52291
12 | 0.000316569 | 3.1656900000000001e-07 | 2.5375399999999999
13 | 0.00035981199999999999 | 3.5981199999999999e-07 | 2.55246
14 | 0.00040896200000000002 | 4.0896200000000003e-07 | 2.5678700000000001
15 | 0.00046482700000000001 | 4.6482700000000004e-07 | 2.5831499999999998
16 | 0.00052832200000000001 | 5.2832200000000006e-07 | 2.59883
17 | 0.00060048999999999996 | 6.0048999999999995e-07 | 2.6146699999999998
18 | 0.000682517 | 6.8251699999999997e-07 | 2.6314600000000001
19 | 0.00077574899999999995 | 7.7574899999999991e-07 | 2.64873
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
