Kevin-Kaiyo/open-microled-driver-asic/evidence/characterization/actual-w20-l4-mc-conditional_high.csv

seed | library | temperature_c | logic_v | led_supply_v | local_mismatch | global_variation | reference | calibration_error | tc_ppm | line_ppm_v | pwm_on | iout | iref | bias | headroom | led_k | power_w | out_vth | ref_vth | x0_dvth | x0_mulu0 | x1_dvth | x1_mulu0 | x2_dvth | x2_mulu0 | x3_dvth | x3_mulu0 | x4_dvth | x4_mulu0 | x5_dvth | x5_mulu0 | mirror_ratio | reference_error_pct | absolute_error_pct | absolute_current_budget_pass
20261004 | ff | 0 | 3.63 | 5.5 | 1 | 0 | bounded | 0.005 | -25 | 3000 | True | 0.0001025478225891146 | 0.0001007184481849608 | 1.210518150391573 | 2.419481849608427 | 2.708981871813317 | 0.000929621005839032 | 0.5938200738718579 | 0.5953389660177406 | -0.001964534281406865 | 1.0 | -0.003184419296273099 | 1.001000935035619 | 9.050473501905178e-05 | 1.0 | 8.659020094562709e-05 | 1.0 | 0.001578596271378047 | 1.0 | -0.009716322146445345 | 1.0 | 1.0181632504980052 | 0.7184481849608071 | 2.54782258911459 | True
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
