Kevin-Kaiyo/open-microled-driver-asic/evidence/characterization/actual-w20-l4-mc-global_and_local.csv

seed | library | temperature_c | logic_v | led_supply_v | local_mismatch | global_variation | reference | calibration_error | tc_ppm | line_ppm_v | pwm_on | iout | iref | bias | headroom | led_k | power_w | out_vth | ref_vth | x0_dvth | x0_mulu0 | x1_dvth | x1_mulu0 | x2_dvth | x2_mulu0 | x3_dvth | x3_mulu0 | x4_dvth | x4_mulu0 | x5_dvth | x5_mulu0 | mirror_ratio | reference_error_pct | absolute_error_pct | absolute_current_budget_pass
20261004 | statistical | 27 | 3.3 | 5 | 1 | 1 | ideal | 0 | 0 | 0 | True | 0.0001002685136544591 | 9.999999999999999e-05 | 1.409661993077575 | 1.890338006922425 | 2.199779451895948 | 0.0008313425791604595 | 0.7309645887100302 | 0.7296486534474781 | 0.001046153961375969 | 1.0 | -0.004630799815881151 | 1.004992445791786 | -1.53959231950508e-05 | 1.0 | -0.01581789904111882 | 1.0 | -0.001373745219305774 | 1.0 | 0.006311388049938009 | 1.0 | 1.0026851365445912 | -1.1102230246251565e-14 | 0.2685136544591016 | True
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
