Kevin-Kaiyo/open-microled-driver-asic/evidence/characterization/actual-w20-l4-mc-local_only.csv

seed | library | temperature_c | logic_v | led_supply_v | local_mismatch | global_variation | reference | calibration_error | tc_ppm | line_ppm_v | pwm_on | iout | iref | bias | headroom | led_k | power_w | out_vth | ref_vth | x0_dvth | x0_mulu0 | x1_dvth | x1_mulu0 | x2_dvth | x2_mulu0 | x3_dvth | x3_mulu0 | x4_dvth | x4_mulu0 | x5_dvth | x5_mulu0 | mirror_ratio | reference_error_pct | absolute_error_pct | absolute_current_budget_pass
20261004 | typical | 27 | 3.3 | 5 | 1 | 0 | ideal | 0 | 0 | 0 | True | 0.000101114654770388 | 9.999999999999999e-05 | 1.376626018586207 | 1.923373981413793 | 2.199085089379208 | 0.0008355732858839218 | 0.6868784668744634 | 0.6884026413718689 | -0.001964534281406865 | 1.0 | -0.003184419296273099 | 1.001000935035619 | 9.050473501905178e-05 | 1.0 | 8.659020094562709e-05 | 1.0 | 0.001578596271378047 | 1.0 | -0.009716322146445345 | 1.0 | 1.0111465477038801 | -1.1102230246251565e-14 | 1.1146547703879905 | True
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
