Kevin-Kaiyo/open-microled-driver-asic/evidence/characterization/actual-w20-l4-reference-pvt.csv

seed | library | temperature_c | logic_v | led_supply_v | local_mismatch | global_variation | reference | calibration_error | tc_ppm | line_ppm_v | pwm_on | iout | iref | bias | headroom | led_k | power_w | out_vth | ref_vth | x0_dvth | x0_mulu0 | x1_dvth | x1_mulu0 | x2_dvth | x2_mulu0 | x3_dvth | x3_mulu0 | x4_dvth | x4_mulu0 | x5_dvth | x5_mulu0 | mirror_ratio | reference_error_pct | absolute_error_pct | absolute_current_budget_pass
20261004 | typical | 0 | 2.97 | 4.5 | 0 | 0 | bounded | -0.005 | -25 | -3000 | True | 9.993583722385159e-05 | 9.963727606019054e-05 | 1.362239398094599 | 1.607760601905401 | 1.71093439424276 | 0.0007456339871460714 | 0.7232988349771268 | 0.7233404768154186 | -0.0 | 1.0 | -0.0 | 1.0 | 0.0 | 1.0 | 0.0 | 1.0 | 0.0 | 1.0 | -0.0 | 1.0 | 1.0029964805890588 | -0.3627239398094617 | -0.06416277614841315 | True
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
