Kevin-Kaiyo/open-microled-driver-asic/docs/research/control-experiment/frame-current.png

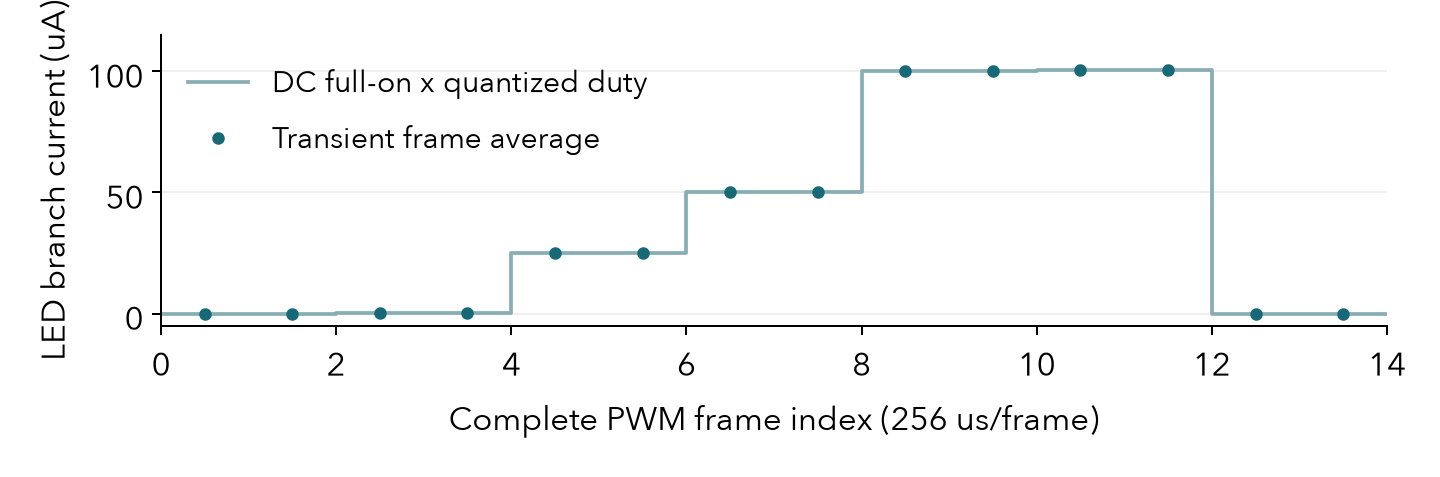
docs/research/control-experiment/frame-current.png
