Kevin-Kaiyo/open-microled-driver-asic/docs/research/fair-driver-comparison-20261025/figures/common-testbench.png

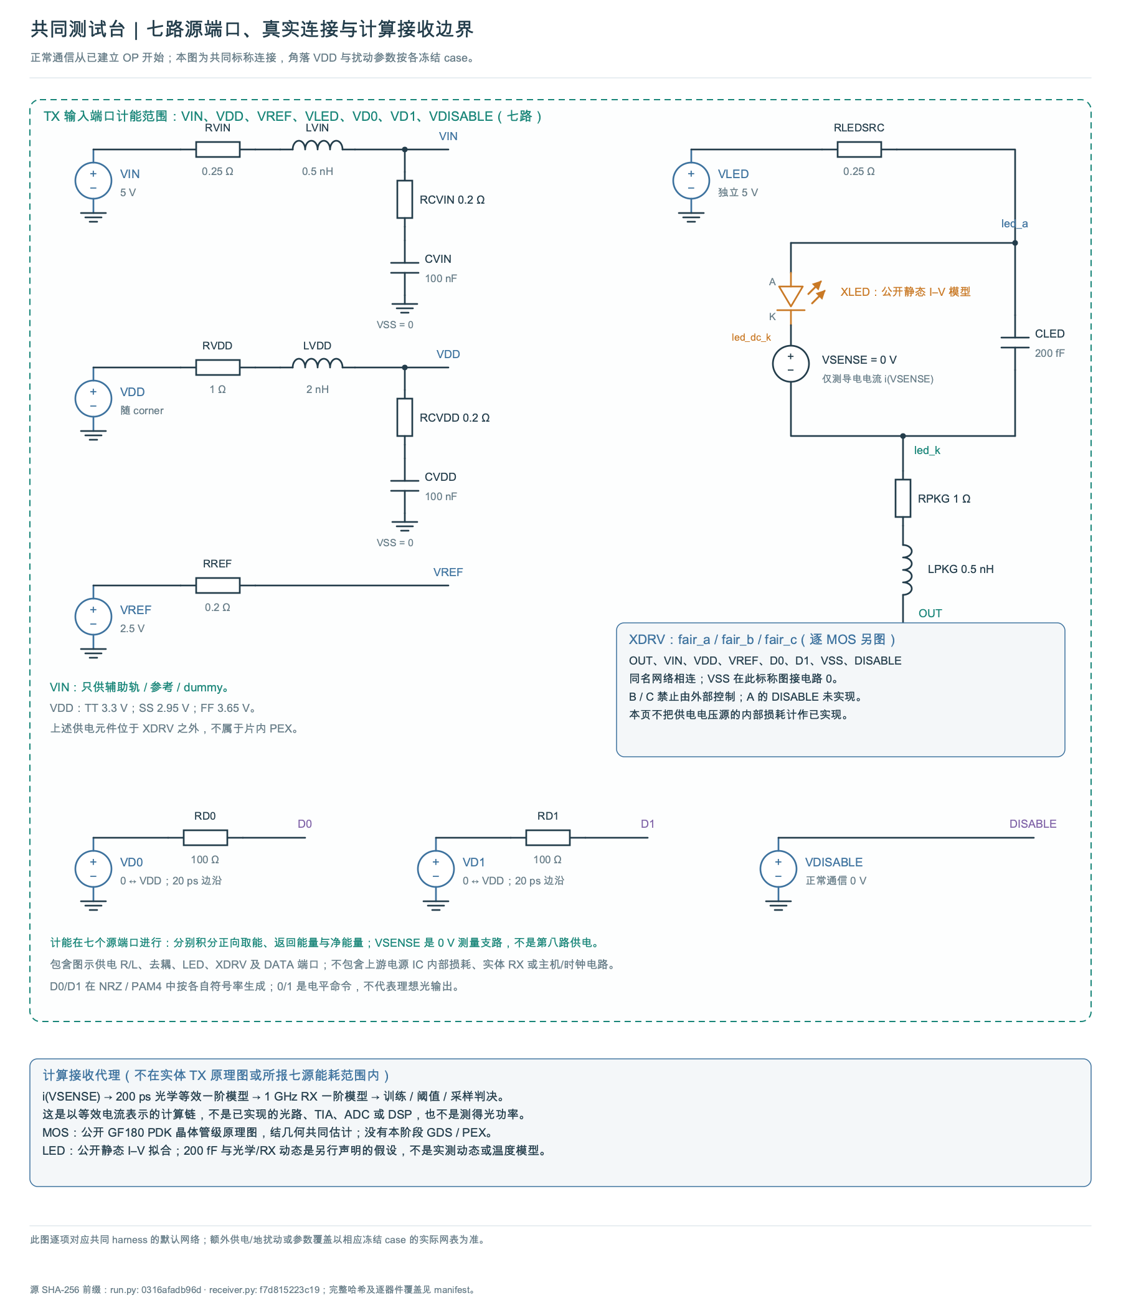
docs/research/fair-driver-comparison-20261025/figures/common-testbench.png
