Kevin-Kaiyo/open-microled-driver-asic/docs/research/microled-dynamic-validation-20261108/figures/model-circuit.png

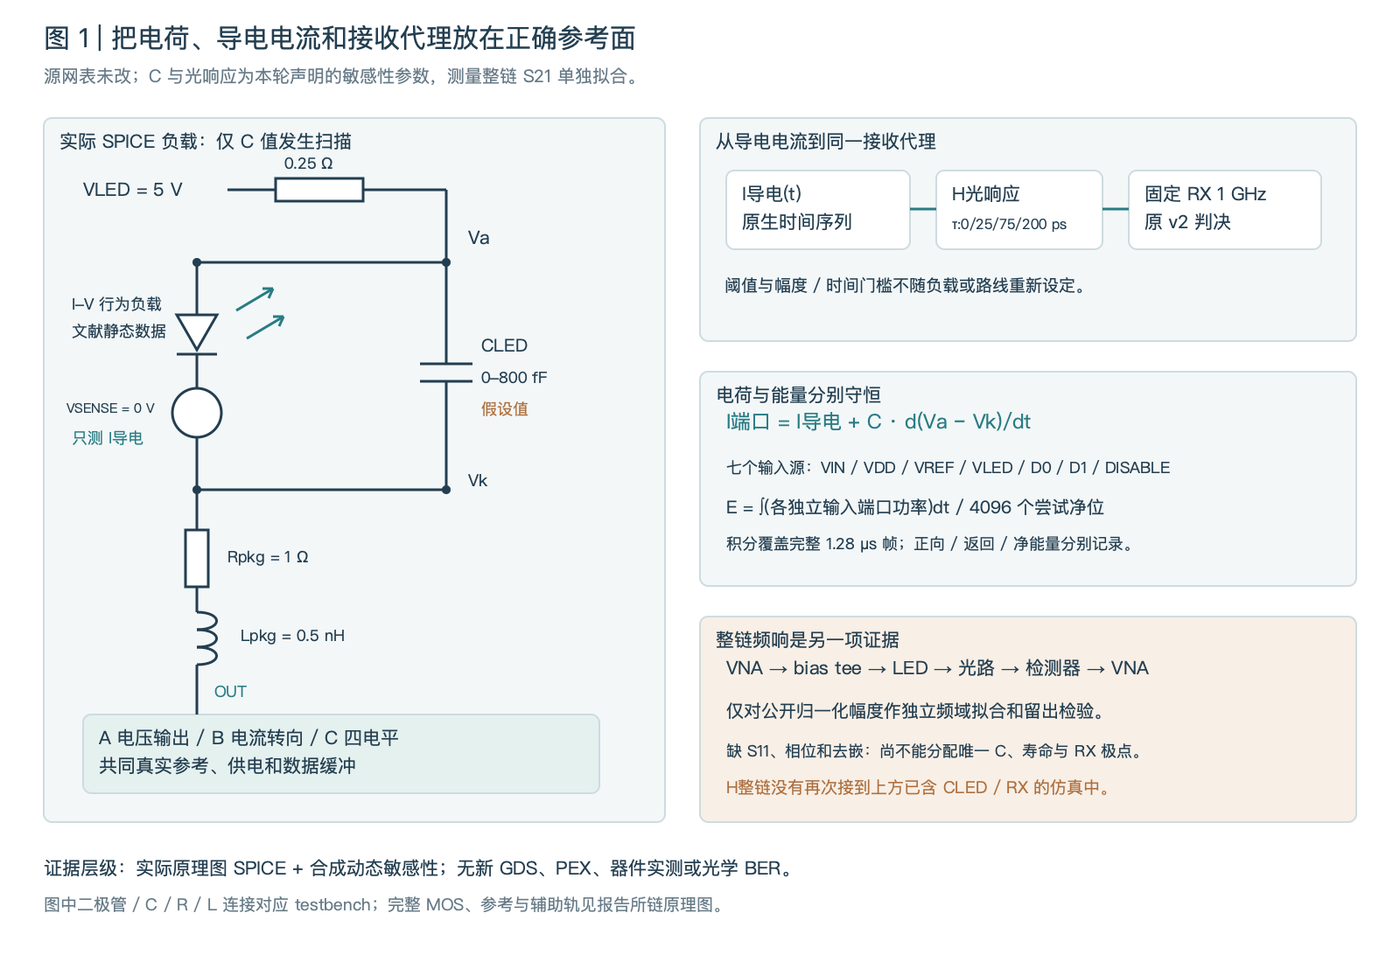
docs/research/microled-dynamic-validation-20261108/figures/model-circuit.png
