Kevin-Kaiyo/open-microled-driver-asic/evidence/blender-pwm-animation/viewer-verified.png

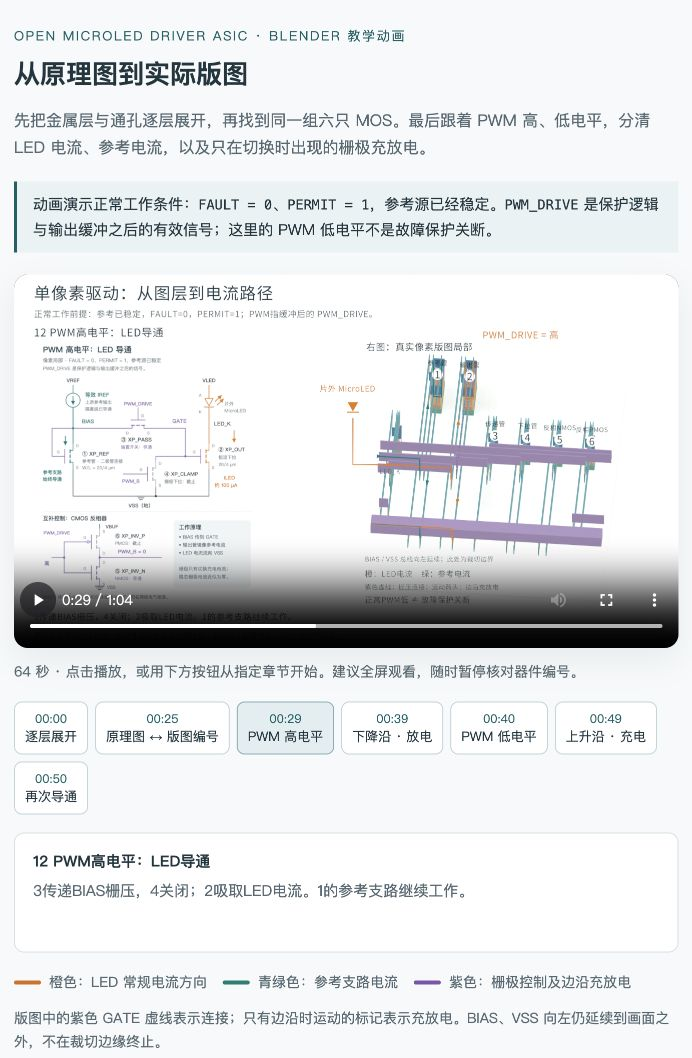
evidence/blender-pwm-animation/viewer-verified.png
