Kevin-Kaiyo/open-microled-driver-asic/evidence/layout-v3/startup_test_macro_rc.spice

* NGSPICE file created from startup_test_macro.ext - technology: gf180mcuD

.subckt startup_test_macro VSS VREF VSAFE VBUF LED_A RAW_PWM FAULT PERMIT VSET SENSE
+ PB N2 CTRL FAULT_HB LED_K REFOUT BIAS GATE PWM_B SAFE_OUT PWM_DRIVE
X0 VSS.t33 a_128036_20068.t2 PWM_DRIVE.t0 VSS.t32 nfet_05v0 ad=0.3608p pd=2.52u as=0.2132p ps=1.34u w=0.82u l=0.6u
X1 VSS.t24 R_N1.t1 R_N1.t2 VSS.t23 nfet_06v0 ad=22p pd=0.10088m as=22p ps=0.10088m w=50u l=10u
X2 VSS.t6 SAFE_OUT.t2 a_128036_20068.t1 VSS.t5 nfet_05v0 ad=0.2911p pd=1.53u as=0.3608p ps=2.52u w=0.82u l=0.6u
X3 VSS.t12 FAULT.t3 BIAS.t2 VSS.t11 nfet_06v0 ad=0.88p pd=4.88u as=0.88p ps=4.88u w=2u l=1u
X4 VSAFE.t3 RAW_PWM.t1 F_NAND_N.t1 VSAFE.t2 pfet_06v0 ad=1.76p pd=8.88u as=1.76p ps=8.88u w=4u l=1u
X5 VSS.t29 F_FAULT_B.t2 F_STACK2.t1 VSS.t28 nfet_06v0 ad=2.64p pd=12.88u as=2.64p ps=12.88u w=6u l=1u
X6 R_TAIL.t0 SENSE.t1 N2.t1 VREF.t6 pfet_06v0 ad=44p pd=0.20088m as=44p ps=0.20088m w=100u l=10u
X7 BIAS.t5 I_FAULT_B.t2 REFOUT.t1 VSS.t25 nfet_06v0 ad=8.8p pd=40.88u as=8.8p ps=40.88u w=20u l=1u
X8 VSAFE.t10 F_FAULT_B.t3 F_NAND_N.t3 VSAFE.t9 pfet_06v0 ad=1.76p pd=8.88u as=1.76p ps=8.88u w=4u l=1u
X9 VSS.t20 BIAS.t3 BIAS.t4 VSS.t19 nfet_06v0 ad=8.8p pd=40.88u as=8.8p ps=40.88u w=20u l=4u
X10 VSS.t31 F_NAND_N.t5 SAFE_OUT.t0 VSS.t30 nfet_06v0 ad=1.76p pd=8.88u as=1.76p ps=8.88u w=4u l=1u
X11 PWM_DRIVE.t3 a_128036_20068.t5 VBUF.t7 VBUF.t6 pfet_05v0 ad=0.3782p pd=1.84u as=0.4941p ps=2.03u w=1.22u l=0.5u
X12 VSS.t14 FAULT.t0 FAULT_HB.t0 VSS.t13 nfet_06v0 ad=0.88p pd=4.88u as=0.88p ps=4.88u w=2u l=1u
X13 GATE.t1 PWM_DRIVE.t6 BIAS.t0 VSS.t2 nfet_06v0 ad=0.88p pd=4.88u as=0.88p ps=4.88u w=2u l=1u
X14 VBUF.t1 PWM_DRIVE.t4 PWM_B.t0 VBUF.t0 pfet_06v0 ad=1.76p pd=8.88u as=1.76p ps=8.88u w=4u l=1u
X15 VSS.t18 FAULT.t5 I_FAULT_B.t1 VSS.t17 nfet_06v0 ad=0.88p pd=4.88u as=0.88p ps=4.88u w=2u l=1u
X16 VREF.t5 CTRL.t4 SENSE.t0 VREF.t4 pfet_06v0 ad=44p pd=0.20088m as=44p ps=0.20088m w=100u l=10u
X17 VSAFE.t5 FAULT.t4 I_FAULT_B.t0 VSAFE.t4 pfet_06v0 ad=1.76p pd=8.88u as=1.76p ps=8.88u w=4u l=1u
X18 R_TAIL.t1 VSET.t0 R_N1.t0 VREF.t7 pfet_06v0 ad=44p pd=0.20088m as=44p ps=0.20088m w=100u l=10u
X19 VSS.t22 N2.t2 CTRL.t2 VSS.t21 nfet_06v0 ad=8.8p pd=40.88u as=8.8p ps=40.88u w=20u l=1u
X20 REFOUT.t0 FAULT.t6 BIAS.t1 VSAFE.t8 pfet_06v0 ad=8.8p pd=40.88u as=8.8p ps=40.88u w=20u l=1u
X21 VREF.t11 PB.t0 PB.t1 VREF.t10 pfet_06v0 ad=8.8p pd=40.88u as=8.8p ps=40.88u w=20u l=4u
X22 F_STACK1.t1 RAW_PWM.t0 F_NAND_N.t2 VSS.t8 nfet_06v0 ad=2.64p pd=12.88u as=2.64p ps=12.88u w=6u l=1u
X23 VBUF.t3 SAFE_OUT.t3 a_128036_20068.t0 VBUF.t2 pfet_05v0 ad=0.4941p pd=2.03u as=0.5368p ps=3.32u w=1.22u l=0.5u
X24 VBUF.t5 a_128036_20068.t4 PWM_DRIVE.t2 VBUF.t4 pfet_05v0 ad=0.5368p pd=3.32u as=0.3782p ps=1.84u w=1.22u l=0.5u
X25 VSS.t10 GATE.t2 LED_K.t1 VSS.t9 nfet_06v0 ad=8.8p pd=40.88u as=8.8p ps=40.88u w=20u l=4u
X26 VSS.t1 PWM_B.t2 GATE.t0 VSS.t0 nfet_06v0 ad=0.88p pd=4.88u as=0.88p ps=4.88u w=2u l=1u
X27 VREF.t9 PB.t2 R_TAIL.t2 VREF.t8 pfet_06v0 ad=8.8p pd=40.88u as=8.8p ps=40.88u w=20u l=4u
X28 VREF.t1 CTRL.t3 REFOUT.t2 VREF.t0 pfet_06v0 ad=44p pd=0.20088m as=44p ps=0.20088m w=100u l=10u
X29 VSS.t16 FAULT.t2 F_FAULT_B.t1 VSS.t15 nfet_06v0 ad=0.88p pd=4.88u as=0.88p ps=4.88u w=2u l=1u
X30 PWM_DRIVE.t1 a_128036_20068.t3 VSS.t35 VSS.t34 nfet_05v0 ad=0.2132p pd=1.34u as=0.2911p ps=1.53u w=0.82u l=0.6u
X31 VREF.t3 CTRL.t0 CTRL.t1 VREF.t2 pfet_06v0 ad=44p pd=0.20088m as=44p ps=0.20088m w=100u l=10u
X32 VSAFE.t7 FAULT.t1 F_FAULT_B.t0 VSAFE.t6 pfet_06v0 ad=1.76p pd=8.88u as=1.76p ps=8.88u w=4u l=1u
X33 VSAFE.t1 PERMIT.t1 F_NAND_N.t0 VSAFE.t0 pfet_06v0 ad=1.76p pd=8.88u as=1.76p ps=8.88u w=4u l=1u
X34 F_STACK2.t0 PERMIT.t0 F_STACK1.t0 VSS.t7 nfet_06v0 ad=2.64p pd=12.88u as=2.64p ps=12.88u w=6u l=1u
X35 VSAFE.t12 F_NAND_N.t4 SAFE_OUT.t1 VSAFE.t11 pfet_06v0 ad=3.52p pd=16.88u as=3.52p ps=16.88u w=8u l=1u
X36 VSS.t27 R_N1.t3 N2.t0 VSS.t26 nfet_06v0 ad=22p pd=0.10088m as=22p ps=0.10088m w=50u l=10u
X37 LED_A.t1 FAULT_HB.t1 LED_K.t0 LED_A.t0 pfet_06v0 ad=0.88p pd=4.88u as=0.88p ps=4.88u w=2u l=1u
X38 VSS.t4 PWM_DRIVE.t5 PWM_B.t1 VSS.t3 nfet_06v0 ad=0.88p pd=4.88u as=0.88p ps=4.88u w=2u l=1u
R0 PWM_B PWM_B.n1 87.3005
R1 PWM_B.n1 PWM_B.t2 32.3975
R2 PWM_B.n0 PWM_B.t0 23.1465
R3 PWM_B.n0 PWM_B.t1 21.7355
R4 PWM_B.n1 PWM_B.n0 2.5865
R5 PWM_DRIVE PWM_DRIVE.n5 84.6005
R6 PWM_DRIVE.n3 PWM_DRIVE.t4 38.1225
R7 PWM_DRIVE.n5 PWM_DRIVE.t6 31.0475
R8 PWM_DRIVE.n4 PWM_DRIVE.t5 31.0475
R9 PWM_DRIVE.n3 PWM_DRIVE.n2 22.3678
R10 PWM_DRIVE.n2 PWM_DRIVE.n0 6.929
R11 PWM_DRIVE.n5 PWM_DRIVE.n4 5.4005
R12 PWM_DRIVE.n2 PWM_DRIVE.n1 2.81668
R13 PWM_DRIVE.n4 PWM_DRIVE.n3 2.7005
R14 PWM_DRIVE.n1 PWM_DRIVE.t3 2.06607
R15 PWM_DRIVE.n0 PWM_DRIVE.t0 1.99806
R16 PWM_DRIVE.n0 PWM_DRIVE.t1 1.99806
R17 PWM_DRIVE.n1 PWM_DRIVE.t2 1.4923
R18 FAULT_HB FAULT_HB.n0 73.6865
R19 FAULT_HB.n0 FAULT_HB.t1 38.5865
R20 FAULT_HB.n0 FAULT_HB.t0 25.1105
R21 SAFE_OUT SAFE_OUT.n2 68.2865
R22 SAFE_OUT.n1 SAFE_OUT.n0 52.3262
R23 SAFE_OUT.n2 SAFE_OUT.t0 19.8635
R24 SAFE_OUT.n1 SAFE_OUT.t1 19.1999
R25 SAFE_OUT.n0 SAFE_OUT.t3 17.119
R26 SAFE_OUT.n0 SAFE_OUT.t2 12.7147
R27 SAFE_OUT.n2 SAFE_OUT.n1 2.7005
R28 PERMIT.n0 PERMIT.t0 62.0725
R29 PERMIT PERMIT.n0 54.9005
R30 PERMIT.n0 PERMIT.t1 46.8975
R31 RAW_PWM.n0 RAW_PWM.t0 63.4225
R32 RAW_PWM RAW_PWM.n0 52.2005
R33 RAW_PWM.n0 RAW_PWM.t1 48.2475
R34 LED_K LED_K.n0 76.3865
R35 LED_K.n0 LED_K.t1 37.5734
R36 LED_K.n0 LED_K.t0 24.2515
R37 GATE GATE.n1 81.9005
R38 GATE.n1 GATE.t2 47.5895
R39 GATE.n0 GATE.t0 24.8825
R40 GATE.n0 GATE.t1 22.4105
R41 GATE.n1 GATE.n0 2.8145
R42 FAULT.n3 FAULT.t6 114.297
R43 FAULT.n0 FAULT.t0 64.7975
R44 FAULT.n4 FAULT.t4 47.5725
R45 FAULT.n0 FAULT.t1 47.5725
R46 FAULT.n2 FAULT.t3 40.4975
R47 FAULT.n5 FAULT.t5 40.4975
R48 FAULT.n1 FAULT.t2 40.4975
R49 FAULT FAULT.n5 33.3005
R50 FAULT.n4 FAULT.n3 5.4005
R51 FAULT.n2 FAULT.n1 2.7005
R52 FAULT.n1 FAULT.n0 2.7005
R53 FAULT.n5 FAULT.n4 2.7005
R54 FAULT.n3 FAULT.n2 2.7005
R55 BIAS.n0 BIAS.t3 48.2645
R56 BIAS BIAS.n4 38.8145
R57 BIAS.n2 BIAS.n1 34.8755
R58 BIAS.n1 BIAS.t4 31.0484
R59 BIAS.n4 BIAS.t5 31.0484
R60 BIAS.n3 BIAS.t1 31.0313
R61 BIAS.n0 BIAS.t0 28.3715
R62 BIAS.n2 BIAS.t2 23.0855
R63 BIAS.n3 BIAS.n2 2.7005
R64 BIAS.n4 BIAS.n3 2.4725
R65 BIAS.n1 BIAS.n0 0.3395
R66 REFOUT.n0 REFOUT.t0 34.6343
R67 REFOUT.n0 REFOUT.t1 31.7234
R68 REFOUT.n1 REFOUT.t2 31.5341
R69 REFOUT REFOUT.n1 29.2115
R70 REFOUT.n1 REFOUT.n0 9.3755
R71 CTRL.n0 CTRL.t3 62.5889
R72 CTRL.n1 CTRL.t0 59.2889
R73 CTRL.n0 CTRL.t4 59.2889
R74 CTRL.n3 CTRL.t2 33.7484
R75 CTRL.n2 CTRL.t1 33.5591
R76 CTRL CTRL.n3 20.5865
R77 CTRL.n1 CTRL.n0 3.3005
R78 CTRL.n3 CTRL.n2 2.0255
R79 CTRL.n2 CTRL.n1 0.7895
R80 N2.n0 N2.t2 115.011
R81 N2.n0 N2.t0 34.2837
R82 N2.n1 N2.t1 34.2341
R83 N2 N2.n1 10.0115
R84 N2.n1 N2.n0 6.6005
R85 SENSE.n0 SENSE.t1 61.3139
R86 SENSE.n0 SENSE.t0 50.6951
R87 SENSE SENSE.n0 10.8005
R88 VSET VSET.t0 69.4888
R89 PB.n0 PB.t2 55.0145
R90 PB.n0 PB.t0 52.3145
R91 PB.n1 PB.t1 35.0813
R92 PB PB.n1 1.7615
R93 PB.n1 PB.n0 0.3395
R94 VBUF.n2 VBUF.t4 676.269
R95 VBUF.t6 VBUF.t2 505.793
R96 VBUF.t4 VBUF.t6 432.433
R97 VBUF.n4 VBUF.t0 143.601
R98 VBUF VBUF.n4 92.1755
R99 VBUF.n3 VBUF.n2 34.1945
R100 VBUF.n3 VBUF.t1 30.5715
R101 VBUF.n1 VBUF.t5 6.80877
R102 VBUF.n1 VBUF.n0 5.65222
R103 VBUF.n0 VBUF.t3 2.61116
R104 VBUF.n0 VBUF.t7 2.03739
R105 VBUF.n4 VBUF.n3 0.6395
R106 VBUF.n2 VBUF.n1 0.089
R107 LED_A.n0 LED_A.t0 192.633
R108 LED_A LED_A.n0 75.9755
R109 LED_A.n0 LED_A.t1 31.6405
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
R256 VSS.n54 VSS.n10 5.47319
R257 VSS.n64 VSS.n63 5.4005
R258 VSS.n65 VSS.n5 4.89781
R259 VSS.n64 VSS.n3 4.7615
R260 VSS.n51 VSS.n50 4.7615
R261 VSS.n53 VSS.n52 4.6115
R262 VSS.n15 VSS.t35 2.72794
R263 VSS.n15 VSS.t6 2.72794
R264 VSS.n44 VSS.n40 2.7005
R265 VSS.n29 VSS.n28 2.7005
R266 VSS.n45 VSS.n44 2.7005
R267 VSS.n43 VSS.n9 2.65957
R268 VSS.n47 VSS.n46 2.65957
R269 VSS.n27 VSS.n25 2.64852
R270 VSS.n30 VSS.n12 2.64852
R271 VSS.n62 VSS.n60 2.64852
R272 VSS.n23 VSS.n14 2.64852
R273 VSS.n38 VSS.n6 2.0615
R274 VSS.n49 VSS.n37 2.0615
R275 VSS.n22 VSS.n13 2.0615
R276 VSS.n74 VSS.n73 1.9865
R277 VSS.n75 VSS.n74 1.9145
R278 VSS.n79 VSS.n0 1.9145
R279 VSS.n29 VSS.n11 1.8365
R280 VSS.n36 VSS.n35 1.6865
R281 VSS.n62 VSS.n61 1.45586
R282 VSS.n24 VSS.n23 1.45586
R283 VSS.n27 VSS.n26 1.45586
R284 VSS.n31 VSS.n30 1.45586
R285 VSS.n75 VSS.n0 1.3865
R286 VSS.n35 VSS.n11 1.0145
R287 VSS.n53 VSS.n36 1.0145
R288 VSS.n46 VSS.n8 0.685319
R289 VSS.n43 VSS.n42 0.685319
R290 VSS.n73 VSS.n71 0.6395
R291 VSS.n39 VSS.n38 0.6395
R292 VSS.n45 VSS.n37 0.6395
R293 VSS.n50 VSS.n49 0.6395
R294 VSS.n52 VSS.n51 0.6395
R295 VSS.n28 VSS.n13 0.6395
R296 VSS.n70 VSS.n3 0.6395
R297 VSS.n22 VSS.n21 0.6395
R298 VSS.n63 VSS.n6 0.6395
R299 VSS.n20 VSS.n19 0.35075
R300 VSS.n34 VSS.n33 0.229745
R301 VSS.n55 VSS.n54 0.229745
R302 VSS.n66 VSS.n65 0.229735
R303 VSS.n77 VSS.n76 0.0954664
R304 a_128036_20068.n1 a_128036_20068.t5 17.8125
R305 a_128036_20068.n0 a_128036_20068.t4 17.8125
R306 a_128036_20068.n1 a_128036_20068.t3 11.8022
R307 a_128036_20068.n0 a_128036_20068.t2 11.8022
R308 a_128036_20068.n2 a_128036_20068.n0 9.53106
R309 a_128036_20068.n3 a_128036_20068.t1 8.88697
R310 a_128036_20068.t0 a_128036_20068.n3 4.21752
R311 a_128036_20068.n3 a_128036_20068.n2 3.64621
R312 a_128036_20068.n2 a_128036_20068.n1 1.01439
R313 F_STACK2 F_STACK2.n0 62.8895
R314 F_STACK2.n0 F_STACK2.t1 16.4961
R315 F_STACK2.n0 F_STACK2.t0 14.0241
R316 F_STACK1 F_STACK1.n0 60.1895
R317 F_STACK1.n0 F_STACK1.t0 17.1711
R318 F_STACK1.n0 F_STACK1.t1 14.6991
R319 F_NAND_N F_NAND_N.n4 51.8615
R320 F_NAND_N.n0 F_NAND_N.t4 51.5975
R321 F_NAND_N.n0 F_NAND_N.t5 34.7475
R322 F_NAND_N.n4 F_NAND_N.t1 15.7215
R323 F_NAND_N.n3 F_NAND_N.t0 15.7215
R324 F_NAND_N.n2 F_NAND_N.t3 15.7215
R325 F_NAND_N.n1 F_NAND_N.t2 15.3741
R326 F_NAND_N.n1 F_NAND_N.n0 8.2145
R327 F_NAND_N.n2 F_NAND_N.n1 2.7005
R328 F_NAND_N.n3 F_NAND_N.n2 2.7005
R329 F_NAND_N.n4 F_NAND_N.n3 2.7005
R330 F_FAULT_B.n0 F_FAULT_B.t2 50.5975
R331 F_FAULT_B F_FAULT_B.n2 46.4615
R332 F_FAULT_B.n0 F_FAULT_B.t3 35.4225
R333 F_FAULT_B.n2 F_FAULT_B.t1 17.6855
R334 F_FAULT_B.n1 F_FAULT_B.t0 16.3965
R335 F_FAULT_B.n1 F_FAULT_B.n0 8.2145
R336 F_FAULT_B.n2 F_FAULT_B.n1 2.7005
R337 I_FAULT_B.n0 I_FAULT_B.t2 105.636
R338 I_FAULT_B I_FAULT_B.n1 32.9615
R339 I_FAULT_B.n1 I_FAULT_B.t1 18.3605
R340 I_FAULT_B.n0 I_FAULT_B.t0 17.0715
R341 I_FAULT_B.n1 I_FAULT_B.n0 2.7005
R342 R_N1.n0 R_N1.t3 43.2139
R343 R_N1.n0 R_N1.t1 39.9139
R344 R_N1.n1 R_N1.t2 26.8587
R345 R_N1.n2 R_N1.t0 26.8091
R346 R_N1.n2 R_N1.n1 6.6005
R347 R_N1 R_N1.n2 6.4865
R348 R_N1.n1 R_N1.n0 0.7895
R349 R_TAIL.n0 R_TAIL.t0 30.7841
R350 R_TAIL.n1 R_TAIL.t2 27.6563
R351 R_TAIL.n0 R_TAIL.t1 27.4841
R352 R_TAIL R_TAIL.n1 4.2365
R353 R_TAIL.n1 R_TAIL.n0 3.8285
C0 CTRL SAFE_OUT 0.40013f
C1 SENSE PWM_DRIVE 0.16537f
C2 N2 FAULT_HB 0.21825f
C3 VSET PWM_B 0.08572f
C4 VBUF LED_K 0.25295f
C5 PB GATE 0.23377f
C6 LED_A RAW_PWM 8.26114f
C7 VSET FAULT 0.49652f
C8 F_STACK2 PWM_B 0.20019f
C9 VSAFE PERMIT 5.01788f
C10 N2 REFOUT 0.2179f
C11 SENSE BIAS 0.16537f
C12 VREF SAFE_OUT 0.9946f
C13 R_TAIL FAULT_HB 0.12379f
C14 F_NAND_N LED_K 0.14448f
C15 F_FAULT_B RAW_PWM 0.15242f
C16 R_N1 SAFE_OUT 0.21835f
C17 F_STACK1 GATE 0.21557f
C18 F_STACK2 FAULT 0.41347f
C19 I_FAULT_B PERMIT 0.15242f
C20 R_TAIL REFOUT 0.22637f
C21 N2 CTRL 12.6415f
C22 LED_K PWM_B 0.14448f
C23 RAW_PWM PWM_DRIVE 0.15242f
C24 PERMIT FAULT_HB 0.15242f
C25 VSAFE SENSE 1.03977f
C26 VREF N2 11.9517f
C27 VBUF PB 0.25295f
C28 LED_A VSET 0.16871f
C29 FAULT LED_K 0.48365f
C30 REFOUT PERMIT 0.15242f
C31 BIAS RAW_PWM 0.15242f
C32 F_STACK1 VBUF 0.22641f
C33 F_STACK2 LED_A 0.15938f
C34 R_TAIL CTRL 0.40013f
C35 I_FAULT_B SENSE 0.16443f
C36 R_N1 N2 3.14032f
C37 F_FAULT_B VSET 0.08403f
C38 F_NAND_N PB 0.23064f
C39 F_FAULT_B F_STACK2 1.05097f
C40 F_NAND_N F_STACK1 8.65789f
C41 R_TAIL VREF 23.3595f
C42 R_TAIL R_N1 8.3405f
C43 SENSE FAULT_HB 0.16537f
C44 PB PWM_B 0.23377f
C45 CTRL PERMIT 0.15242f
C46 VSET PWM_DRIVE 0.08572f
C47 N2 SAFE_OUT 0.2179f
C48 VSET BIAS 0.08572f
C49 VSAFE RAW_PWM 5.33395f
C50 F_STACK1 PWM_B 0.19143f
C51 F_STACK2 PWM_DRIVE 0.24859f
C52 VREF PERMIT 1.02927f
C53 SENSE REFOUT 0.16537f
C54 VBUF GATE 0.25295f
C55 PB FAULT 0.49627f
C56 LED_A LED_K 1.01746f
C57 R_N1 PERMIT 0.15242f
C58 F_FAULT_B LED_K 0.14448f
C59 F_NAND_N GATE 0.21557f
C60 F_STACK2 BIAS 0.4452f
C61 F_STACK1 FAULT 0.39304f
C62 I_FAULT_B RAW_PWM 0.15242f
C63 R_TAIL SAFE_OUT 0.21885f
C64 SENSE CTRL 5.75698f
C65 PERMIT SAFE_OUT 0.15242f
C66 RAW_PWM FAULT_HB 0.15242f
C67 LED_K PWM_DRIVE 0.14448f
C68 GATE PWM_B 10.1155f
C69 LED_A PB 0.16871f
C70 VSAFE VSET 1.03977f
C71 VREF SENSE 15.9288f
C72 REFOUT RAW_PWM 0.15242f
C73 BIAS LED_K 0.14857f
C74 FAULT GATE 0.44353f
C75 R_TAIL N2 0.2179f
C76 F_FAULT_B PB 0.23064f
C77 R_N1 SENSE 0.16443f
C78 F_NAND_N VBUF 0.22641f
C79 F_STACK1 LED_A 0.15355f
C80 F_STACK2 VSAFE 1.04173f
C81 I_FAULT_B VSET 0.08403f
C82 F_FAULT_B F_STACK1 0.26057f
C83 I_FAULT_B F_STACK2 0.20019f
C84 CTRL RAW_PWM 0.15242f
C85 PB PWM_DRIVE 0.23377f
C86 VBUF PWM_B 1.31443f
C87 N2 PERMIT 0.15242f
C88 VSET FAULT_HB 0.08572f
C89 SENSE SAFE_OUT 0.16537f
C90 VBUF FAULT 0.25295f
C91 LED_A GATE 0.15355f
C92 VSAFE LED_K 1.03977f
C93 VSET REFOUT 0.08572f
C94 PB BIAS 0.23377f
C95 F_NAND_N PWM_B 0.19143f
C96 VREF RAW_PWM 1.02927f
C97 F_STACK1 PWM_DRIVE 0.23692f
C98 F_STACK2 FAULT_HB 0.12963f
C99 F_NAND_N FAULT 0.39304f
C100 F_STACK2 REFOUT 0.22783f
C101 I_FAULT_B LED_K 0.14448f
C102 R_TAIL PERMIT 0.15242f
C103 F_STACK1 BIAS 0.42769f
C104 R_N1 RAW_PWM 0.15242f
C105 F_FAULT_B GATE 0.21557f
C106 SENSE N2 5.7721f
C107 VSET CTRL 0.08572f
C108 RAW_PWM SAFE_OUT 0.15242f
C109 FAULT PWM_B 0.44353f
C110 GATE PWM_DRIVE 1.78529f
C111 LED_K FAULT_HB 10.4762f
C112 VREF VSET 5.03569f
C113 F_STACK2 CTRL 0.41472f
C114 LED_A VBUF 8.34543f
C115 VSAFE PB 1.03977f
C116 REFOUT LED_K 8.24068f
C117 BIAS GATE 8.75568f
C118 F_FAULT_B VBUF 0.22641f
C119 F_NAND_N LED_A 0.15355f
C120 I_FAULT_B PB 0.23064f
C121 F_STACK1 VSAFE 1.0038f
C122 F_STACK2 VREF 1.02206f
C123 R_TAIL SENSE 5.63257f
C124 R_N1 VSET 5.53842f
C125 I_FAULT_B F_STACK1 0.19143f
C126 R_N1 F_STACK2 0.34054f
C127 F_FAULT_B F_NAND_N 9.36386f
C128 N2 RAW_PWM 0.15242f
C129 LED_A PWM_B 0.15355f
C130 VSET SAFE_OUT 0.08572f
C131 PB FAULT_HB 0.23377f
C132 VBUF PWM_DRIVE 3.87825f
C133 SENSE PERMIT 0.15275f
C134 CTRL LED_K 0.40126f
C135 PB REFOUT 0.23377f
C136 F_FAULT_B PWM_B 0.19143f
C137 VBUF BIAS 0.25295f
C138 VSAFE GATE 1.03864f
C139 LED_A FAULT 0.16981f
C140 VREF LED_K 0.99898f
C141 F_NAND_N PWM_DRIVE 0.23692f
C142 F_STACK2 SAFE_OUT 0.21251f
C143 F_STACK1 FAULT_HB 0.12379f
C144 I_FAULT_B GATE 0.21557f
C145 R_N1 LED_K 0.14448f
C146 F_FAULT_B FAULT 2.62732f
C147 R_TAIL RAW_PWM 0.15242f
C148 F_NAND_N BIAS 0.42769f
C149 F_STACK1 REFOUT 0.21907f
C150 PWM_DRIVE PWM_B 3.34435f
C151 PB CTRL 0.23457f
C152 VSET N2 0.08572f
C153 RAW_PWM PERMIT 0.15275f
C154 LED_K SAFE_OUT 0.14448f
C155 GATE FAULT_HB 0.12379f
C156 BIAS PWM_B 0.44283f
C157 FAULT PWM_DRIVE 0.44353f
C158 VSAFE VBUF 9.19186f
C159 F_STACK1 CTRL 0.40013f
C160 F_STACK2 N2 0.22571f
C161 VREF PB 12.1059f
C162 BIAS FAULT 6.34323f
C163 REFOUT GATE 0.22687f
C164 F_FAULT_B LED_A 0.15355f
C165 R_TAIL VSET 5.55291f
C166 F_NAND_N VSAFE 4.89449f
C167 I_FAULT_B VBUF 0.22641f
C168 F_STACK1 VREF 0.98704f
C169 R_N1 PB 0.23064f
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
C544 SAFE_OUT.t1 VSS 1.40636f
C545 SAFE_OUT.n1 VSS 6.39195f
C546 SAFE_OUT.t0 VSS 0.90431f
C547 SAFE_OUT.n2 VSS 9.27438f
C548 FAULT_HB.t0 VSS 3.96302f
C549 FAULT_HB.n0 VSS 18.005f
C550 PWM_DRIVE.t0 VSS 0.07142f
C551 PWM_DRIVE.t1 VSS 0.07142f
C552 PWM_DRIVE.n0 VSS 0.01762f
C553 PWM_DRIVE.t2 VSS 0.08022f
C554 PWM_DRIVE.t3 VSS 0.08462f
C555 PWM_DRIVE.n1 VSS 0.02877f
C556 PWM_DRIVE.n2 VSS 1.07039f
C557 PWM_DRIVE.n3 VSS 3.55508f
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
