Kevin-Kaiyo/open-microled-driver-asic/analog/models/measured-led/lin2026-yellow20-dc.spice

* Static measured I-V curve only; source dataset CC BY 4.0.
* Lin et al. 2026; Zenodo 10.5281/zenodo.20034288; I-V.xlsx Sheet1 A3:B102.
* 20 um square-mesa yellow InGaN on diamond; source temperature unspecified.
* Validated input domain: 0.1 uA .. 32 mA / 2.41622 V .. 6.40451 V.
* No capacitance, optical output, self-heating, leakage or temperature scaling.
* Below first point a line to (0 V,0 A) is a startup extension, not measured data.
* Above last point linear extrapolation is numerical only; reverse response unvalidated.
.subckt lin2026_yellow20_dc anode cathode
BLED anode cathode I = pwl(v(anode,cathode),0,0,
+ 2.41622,1.0000000000000001e-07,2.4289299999999998,1.1366000000000001e-07,2.44164,1.29186e-07,
+ 2.4544000000000001,1.46833e-07,2.4674499999999999,1.6689000000000001e-07,2.48095,1.89687e-07,
+ 2.4942799999999998,2.1559800000000002e-07,2.5083299999999999,2.4504900000000001e-07,2.52291,2.7852299999999996e-07,
+ 2.5375399999999999,3.1656900000000001e-07,2.55246,3.5981199999999999e-07,2.5678700000000001,4.0896200000000003e-07,
+ 2.5831499999999998,4.6482700000000004e-07,2.59883,5.2832200000000006e-07,2.6146699999999998,6.0048999999999995e-07,
+ 2.6314600000000001,6.8251699999999997e-07,2.64873,7.7574899999999991e-07,2.6655199999999999,8.8171600000000008e-07,
+ 2.68391,9.9999999999999995e-07,2.70208,1.1399999999999999e-06,2.7208999999999999,1.2899999999999999e-06,
+ 2.7403,1.4699999999999999e-06,2.76057,1.6700000000000001e-06,2.7814299999999998,1.9e-06,
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
+ 5.6205299999999996,0.01484241,5.7246300000000003,0.01686988,5.8373900000000001,0.01917431,
+ 5.9603799999999998,0.021793510000000002,6.0950100000000003,0.024770499999999997,6.2423400000000004,0.028154150000000003,
+ 6.4045100000000001,0.032000000000000001
+ )
.ends lin2026_yellow20_dc
