Kevin-Kaiyo/open-microled-driver-asic/scripts/characterization/candidates/pixel_driver_rc_actual_w20_l4.spice

* NGSPICE file created from pixel_driver_layout.ext - technology: gf180mcuD

.subckt pixel_driver_layout VSS bias gate pwm pwm_b led_k vlogic
X0 VSS.t1 pwm_b.t2 gate.t0 VSS.t0 nfet_06v0 ad=0.88p pd=4.88u as=0.88p ps=4.88u w=2u l=1u
X1 vlogic.t1 pwm.t0 pwm_b.t1 vlogic.t0 pfet_06v0 ad=1.76p pd=8.88u as=1.76p ps=8.88u w=4u l=1u
X2 VSS.t6 gate.t2 led_k.t0 VSS.t5 nfet_06v0 ad=8.8p pd=40.88u as=8.8p ps=40.88u w=20u l=4u
X3 gate.t1 pwm.t2 bias.t0 VSS.t2 nfet_06v0 ad=0.88p pd=4.88u as=0.88p ps=4.88u w=2u l=1u
X4 VSS.t8 bias.t1 bias.t2 VSS.t7 nfet_06v0 ad=8.8p pd=40.88u as=8.8p ps=40.88u w=20u l=4u
X5 VSS.t4 pwm.t1 pwm_b.t0 VSS.t3 nfet_06v0 ad=0.88p pd=4.88u as=0.88p ps=4.88u w=2u l=1u
R0 pwm_b.n1 pwm_b.t2 24.7475
R1 pwm_b.n0 pwm_b.t1 15.0465
R2 pwm_b.n0 pwm_b.t0 14.0855
R3 pwm_b pwm_b.n1 8.2505
R4 pwm_b.n1 pwm_b.n0 2.1365
R5 pwm.n0 pwm.t0 34.5225
R6 pwm.n1 pwm.t2 25.1975
R7 pwm.n0 pwm.t1 25.1975
R8 pwm pwm.n1 6.0005
R9 pwm.n1 pwm.n0 4.5005
R10 led_k led_k.t0 16.2344
R11 gate.n1 gate.t2 31.3895
R12 gate.n0 gate.t0 17.0075
R13 gate.n0 gate.t1 14.9855
R14 gate gate.n1 3.7505
R15 gate.n1 gate.n0 2.3645
R16 bias.n0 bias.t1 31.8395
R17 bias.n0 bias.t0 19.8215
R18 bias.n1 bias.t2 14.6234
R19 bias bias.n1 1.1615
R20 bias.n1 bias.n0 0.3395
R21 vlogic.n0 vlogic.t0 124.925
R22 vlogic.n0 vlogic.t1 12.5355
R23 vlogic vlogic.n0 12.2255
R24 VSS.n6 VSS.n5 1041.96
R25 VSS.n9 VSS.n8 1041.25
R26 VSS.n10 VSS.n1 911.523
R27 VSS.n17 VSS.n16 784.506
R28 VSS.n16 VSS.t5 257.717
R29 VSS.n1 VSS.t5 257.717
R30 VSS.n6 VSS.t0 127.995
R31 VSS.n8 VSS.t0 127.995
R32 VSS.t2 VSS.n9 127.995
R33 VSS.n10 VSS.t2 127.995
R34 VSS.n17 VSS.t7 127.562
R35 VSS.n5 VSS.t3 64.2915
R36 VSS.n18 VSS.n17 17.8182
R37 VSS.n4 VSS.t4 16.5245
R38 VSS.n3 VSS.t1 15.8855
R39 VSS.n15 VSS.n14 15.1089
R40 VSS.n13 VSS.t6 15.0734
R41 VSS.n0 VSS.t8 15.0734
R42 VSS.n5 VSS.n4 14.6013
R43 VSS.n7 VSS.n2 13.8691
R44 VSS.n12 VSS.n11 13.8691
R45 VSS.n15 VSS.n1 5.47319
R46 VSS.n11 VSS.n9 2.64852
R47 VSS.n7 VSS.n6 2.64852
R48 VSS.n12 VSS.n2 2.2505
R49 VSS.n4 VSS.n3 1.6115
R50 VSS.n11 VSS.n10 1.45586
R51 VSS.n8 VSS.n7 1.45586
R52 VSS.n13 VSS.n12 1.3865
R53 VSS.n14 VSS.n0 1.2365
R54 VSS.n14 VSS.n13 1.0145
R55 VSS.n18 VSS.n0 1.0145
R56 VSS VSS.n18 0.8255
R57 VSS.n3 VSS.n2 0.6395
R58 VSS.n16 VSS.n15 0.229745
C0 bias led_k 0.20686f
C1 vlogic pwm 1.069f
C2 vlogic led_k 1.84813f
C3 bias gate 2.0854f
C4 vlogic gate 0.2517f
C5 pwm pwm_b 2.94805f
C6 vlogic bias 0.25761f
C7 led_k pwm_b 1.94809f
C8 led_k pwm 0.16852f
C9 gate pwm_b 0.70206f
C10 gate pwm 2.5557f
C11 bias pwm_b 0.20701f
C12 vlogic pwm_b 0.82537f
C13 bias pwm 0.7809f
C14 gate led_k 1.22948f
C15 pwm_b VSS 5.70199f
C16 pwm VSS 5.68941f
C17 led_k VSS 7.4712f
C18 gate VSS 7.42638f
C19 bias VSS 10.21233f
C20 vlogic VSS 9.62835f
C21 VSS.t8 VSS 0.71966f
C22 VSS.t4 VSS 0.18957f
C23 VSS.t1 VSS 0.16993f
C24 VSS.t6 VSS 1.52339f
C25 vlogic.t1 VSS 0.48472f
C26 vlogic.t0 VSS 0.51218f
C27 vlogic.n0 VSS 2.52527f
C28 bias.t0 VSS 0.48053f
C29 bias.n0 VSS 1.24502f
C30 bias.t2 VSS 1.07835f
C31 bias.n1 VSS 0.15836f
C32 gate.t0 VSS 0.50513f
C33 gate.t1 VSS 0.36407f
C34 gate.n0 VSS 1.72149f
C35 gate.n1 VSS 1.23422f
C36 led_k.t0 VSS 3.48254f
C37 pwm.n0 VSS 2.87283f
C38 pwm.n1 VSS 2.25762f
C39 pwm_b.t1 VSS 0.88003f
C40 pwm_b.t0 VSS 0.48006f
C41 pwm_b.n0 VSS 1.9673f
C42 pwm_b.n1 VSS 2.0654f
.ends
