Kevin-Kaiyo/open-microled-driver-asic/evidence/physical/sdf/analog-rc/duty_001/sdf/testbench.spice

GF180MCU one-pixel feed-forward RTL/SPICE simulation
.include design.ngspice
.param sw_stat_global=0 sw_stat_mismatch=0
.lib sm141064.ngspice typical
.param LED_IS=2.272535114155243e-20
.include "../../../../../../analog/models/microled.spice"
.include "/Users/kimmy/Projects/open-microled-driver-asic/build/physical-flow/sdf-coupled-v0.2/pixel_driver_rc.spice"
.temp 27
VDD vdd 0 5.0
VLOGIC vlogic 0 3.3
IREF vlogic bias DC 100u
VSENSE vdd led_a 0
VPWM pwm 0 PWL(
+ 0 0
+ 2.502644e-06 0
+ 2.512644e-06 3.3
+ 3.50236e-06 3.3
+ 3.51236e-06 0
+ 0.000258502644 0
+ 0.000258512644 3.3
+ 0.00025950236 3.3
+ 0.00025951236 0
+ 0.000514502644 0
+ 0.000514512644 3.3
+ 0.00051550236 3.3
+ 0.00051551236 0
+ 0.000770502644 0
+ 0.000770512644 3.3
+ 0.00077150236 3.3
+ 0.00077151236 0
+ 0.001026502644 0
+ 0.001026512644 3.3
+ 0.00102750236 3.3
+ 0.00102751236 0
+ 0.001282502644 0
+ 0.001282512644 3.3
+ 0.00128350236 3.3
+ 0.00128351236 0
+ 0.001538502644 0
+ 0.001538512644 3.3
+ 0.0015405 3.3
+ )
XLED led_a led_k microled
XPIXEL 0 bias gate pwm pwm_b led_k vlogic pixel_driver_layout
.options reltol=1e-5 abstol=1e-12 vntol=1e-7
.control
set noaskquit
set numdgt=15
set wr_vecnames
set wr_singlescale
save v(pwm) v(pwm_b) v(bias) v(gate) v(led_k) i(VSENSE)
tran 100n 0.0015405 0 5e-08
wrdata waveform.dat v(pwm) v(pwm_b) v(bias) v(gate) v(led_k) i(VSENSE)
quit
.endc
.end
