Kevin-Kaiyo/open-microled-driver-asic/(list of files, drawings)

Other design files:
docs/research/blender-pwm-animation-20261018/figures/schematic-check.json
evidence/pwm-reference-v2/20261024/pcb_dc_extref_ff_+1.json
evidence/pwm-reference-v2/20261024/pcb_dc_extref_ff_-1.json
evidence/pwm-reference-v2/20261024/pcb_dc_extref_ss_+1.json
evidence/pwm-reference-v2/20261024/pcb_dc_extref_ss_-1.json
evidence/pwm-reference-v2/20261024/pcb_dc_extref_typical_+1.json
evidence/pwm-reference-v2/20261024/pcb_dc_extref_typical_-1.json
evidence/pwm-reference-v2/20261024/pcb_dc_ff_0_mmmm.json
evidence/pwm-reference-v2/20261024/pcb_dc_ff_0_mmmp.json
evidence/pwm-reference-v2/20261024/pcb_dc_ff_0_mmpm.json
evidence/pwm-reference-v2/20261024/pcb_dc_ff_0_mmpp.json
evidence/pwm-reference-v2/20261024/pcb_dc_ff_0_mpmm.json
evidence/pwm-reference-v2/20261024/pcb_dc_ff_0_mpmp.json
evidence/pwm-reference-v2/20261024/pcb_dc_ff_0_mppm.json
evidence/pwm-reference-v2/20261024/pcb_dc_ff_0_mppp.json
evidence/pwm-reference-v2/20261024/pcb_dc_ff_0_pmmm.json
evidence/pwm-reference-v2/20261024/pcb_dc_ff_0_pmmp.json
evidence/pwm-reference-v2/20261024/pcb_dc_ff_0_pmpm.json
evidence/pwm-reference-v2/20261024/pcb_dc_ff_0_pmpp.json
evidence/pwm-reference-v2/20261024/pcb_dc_ff_0_ppmm.json
evidence/pwm-reference-v2/20261024/pcb_dc_ff_0_ppmp.json
evidence/pwm-reference-v2/20261024/pcb_dc_ff_0_pppm.json
evidence/pwm-reference-v2/20261024/pcb_dc_ff_0_pppp.json
evidence/pwm-reference-v2/20261024/pcb_dc_ff_27_mmmm.json
evidence/pwm-reference-v2/20261024/pcb_dc_ff_27_mmmp.json
evidence/pwm-reference-v2/20261024/pcb_dc_ff_27_mmpm.json
evidence/pwm-reference-v2/20261024/pcb_dc_ff_27_mmpp.json
evidence/pwm-reference-v2/20261024/pcb_dc_ff_27_mpmm.json
evidence/pwm-reference-v2/20261024/pcb_dc_ff_27_mpmp.json
evidence/pwm-reference-v2/20261024/pcb_dc_ff_27_mppm.json
evidence/pwm-reference-v2/20261024/pcb_dc_ff_27_mppp.json
evidence/pwm-reference-v2/20261024/pcb_dc_ff_27_pmmm.json
evidence/pwm-reference-v2/20261024/pcb_dc_ff_27_pmmp.json
evidence/pwm-reference-v2/20261024/pcb_dc_ff_27_pmpm.json
evidence/pwm-reference-v2/20261024/pcb_dc_ff_27_pmpp.json
evidence/pwm-reference-v2/20261024/pcb_dc_ff_27_ppmm.json
evidence/pwm-reference-v2/20261024/pcb_dc_ff_27_ppmp.json
evidence/pwm-reference-v2/20261024/pcb_dc_ff_27_pppm.json
evidence/pwm-reference-v2/20261024/pcb_dc_ff_27_pppp.json
evidence/pwm-reference-v2/20261024/pcb_dc_ff_85_mmmm.json
evidence/pwm-reference-v2/20261024/pcb_dc_ff_85_mmmp.json
evidence/pwm-reference-v2/20261024/pcb_dc_ff_85_mmpm.json
evidence/pwm-reference-v2/20261024/pcb_dc_ff_85_mmpp.json
evidence/pwm-reference-v2/20261024/pcb_dc_ff_85_mpmm.json
evidence/pwm-reference-v2/20261024/pcb_dc_ff_85_mpmp.json
evidence/pwm-reference-v2/20261024/pcb_dc_ff_85_mppm.json
evidence/pwm-reference-v2/20261024/pcb_dc_ff_85_mppp.json
evidence/pwm-reference-v2/20261024/pcb_dc_ff_85_pmmm.json
evidence/pwm-reference-v2/20261024/pcb_dc_ff_85_pmmp.json
evidence/pwm-reference-v2/20261024/pcb_dc_ff_85_pmpm.json
evidence/pwm-reference-v2/20261024/pcb_dc_ff_85_pmpp.json
evidence/pwm-reference-v2/20261024/pcb_dc_ff_85_ppmm.json
evidence/pwm-reference-v2/20261024/pcb_dc_ff_85_ppmp.json
evidence/pwm-reference-v2/20261024/pcb_dc_ff_85_pppm.json
evidence/pwm-reference-v2/20261024/pcb_dc_ff_85_pppp.json
evidence/pwm-reference-v2/20261024/pcb_dc_ss_0_mmmm.json
evidence/pwm-reference-v2/20261024/pcb_dc_ss_0_mmmp.json
evidence/pwm-reference-v2/20261024/pcb_dc_ss_0_mmpm.json
evidence/pwm-reference-v2/20261024/pcb_dc_ss_0_mmpp.json
evidence/pwm-reference-v2/20261024/pcb_dc_ss_0_mpmm.json
evidence/pwm-reference-v2/20261024/pcb_dc_ss_0_mpmp.json
evidence/pwm-reference-v2/20261024/pcb_dc_ss_0_mppm.json
evidence/pwm-reference-v2/20261024/pcb_dc_ss_0_mppp.json
evidence/pwm-reference-v2/20261024/pcb_dc_ss_0_pmmm.json
evidence/pwm-reference-v2/20261024/pcb_dc_ss_0_pmmp.json
evidence/pwm-reference-v2/20261024/pcb_dc_ss_0_pmpm.json
evidence/pwm-reference-v2/20261024/pcb_dc_ss_0_pmpp.json
evidence/pwm-reference-v2/20261024/pcb_dc_ss_0_ppmm.json
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
