Kevin-Kaiyo/open-microled-driver-asic/evidence/control-v3/pixel_control_v3.nl.v

module pixel_control_v3 (clk,
    enable,
    fault,
    permit,
    protected_monitor,
    raw_pwm,
    recover_request,
    rst,
    duty);
 input clk;
 input enable;
 input fault;
 output permit;
 output protected_monitor;
 output raw_pwm;
 input recover_request;
 input rst;
 input [8:0] duty;

 wire _000_;
 wire _001_;
 wire _002_;
 wire _003_;
 wire _004_;
 wire _005_;
 wire _006_;
 wire _007_;
 wire _008_;
 wire _009_;
 wire _010_;
 wire _011_;
 wire _012_;
 wire _013_;
 wire _014_;
 wire _015_;
 wire _016_;
 wire _017_;
 wire _018_;
 wire _019_;
 wire _020_;
 wire _021_;
 wire _022_;
 wire _023_;
 wire _024_;
 wire _025_;
 wire _026_;
 wire _027_;
 wire _028_;
 wire _029_;
 wire _030_;
 wire _031_;
 wire _032_;
 wire _033_;
 wire _034_;
 wire _035_;
 wire _036_;
 wire _037_;
 wire _038_;
 wire _039_;
 wire _040_;
 wire _041_;
 wire _042_;
 wire _043_;
 wire _044_;
 wire _045_;
 wire _046_;
 wire _047_;
 wire _048_;
 wire _049_;
 wire _050_;
 wire _051_;
 wire _052_;
 wire _053_;
 wire _054_;
 wire _055_;
 wire _056_;
 wire _057_;
 wire _058_;
 wire _059_;
 wire _060_;
 wire _061_;
 wire _062_;
 wire _063_;
 wire _064_;
 wire _065_;
 wire _066_;
 wire _067_;
 wire _068_;
 wire _069_;
 wire _070_;
 wire _071_;
 wire _072_;
 wire _073_;
 wire _074_;
 wire _075_;
 wire _076_;
 wire net1;
 wire net2;
 wire net3;
 wire net4;
 wire net5;
 wire net6;
 wire net7;
 wire net8;
 wire net9;
 wire net10;
 wire net11;
 wire net14;
 wire net15;
 wire \pwm_core.active_duty[0] ;
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
 gf180mcu_fd_sc_mcu7t5v0__clkbuf_2 clkload1 (.I(clknet_2_1__leaf_clk));
 gf180mcu_fd_sc_mcu7t5v0__clkbuf_2 clkload2 (.I(clknet_2_2__leaf_clk));
 gf180mcu_fd_sc_mcu7t5v0__buf_2 fanout19 (.I(_049_),
    .Z(net19));
 gf180mcu_fd_sc_mcu7t5v0__buf_2 fanout20 (.I(net13),
    .Z(net20));
 gf180mcu_fd_sc_mcu7t5v0__buf_2 input1 (.I(duty[0]),
    .Z(net1));
 gf180mcu_fd_sc_mcu7t5v0__buf_2 input10 (.I(enable),
    .Z(net10));
 gf180mcu_fd_sc_mcu7t5v0__buf_2 input11 (.I(fault),
    .Z(net11));
 gf180mcu_fd_sc_mcu7t5v0__buf_2 input12 (.I(recover_request),
    .Z(net12));
 gf180mcu_fd_sc_mcu7t5v0__buf_2 input13 (.I(rst),
    .Z(net13));
 gf180mcu_fd_sc_mcu7t5v0__buf_2 input2 (.I(duty[1]),
    .Z(net2));
 gf180mcu_fd_sc_mcu7t5v0__buf_2 input3 (.I(duty[2]),
    .Z(net3));
 gf180mcu_fd_sc_mcu7t5v0__buf_2 input4 (.I(duty[3]),
    .Z(net4));
 gf180mcu_fd_sc_mcu7t5v0__buf_2 input5 (.I(duty[4]),
    .Z(net5));
 gf180mcu_fd_sc_mcu7t5v0__buf_2 input6 (.I(duty[5]),
    .Z(net6));
 gf180mcu_fd_sc_mcu7t5v0__buf_2 input7 (.I(duty[6]),
    .Z(net7));
 gf180mcu_fd_sc_mcu7t5v0__buf_2 input8 (.I(duty[7]),
    .Z(net8));
 gf180mcu_fd_sc_mcu7t5v0__buf_2 input9 (.I(duty[8]),
    .Z(net9));
 gf180mcu_fd_sc_mcu7t5v0__buf_2 max_cap18 (.I(_050_),
    .Z(net18));
 gf180mcu_fd_sc_mcu7t5v0__buf_2 output14 (.I(net14),
    .Z(permit));
 gf180mcu_fd_sc_mcu7t5v0__buf_2 output15 (.I(net15),
    .Z(protected_monitor));
 gf180mcu_fd_sc_mcu7t5v0__buf_2 output16 (.I(net16),
    .Z(raw_pwm));
 gf180mcu_fd_sc_mcu7t5v0__clkbuf_1 wire17 (.I(_075_),
    .Z(net17));
endmodule
