Kevin-Kaiyo/open-microled-driver-asic/evidence/control-v3/pixel_control_v3.pnl.v

module pixel_control_v3 (clk,
    enable,
    fault,
    permit,
    protected_monitor,
    raw_pwm,
    recover_request,
    rst,
    VDD,
    VSS,
    duty);
 input clk;
 input enable;
 input fault;
 output permit;
 output protected_monitor;
 output raw_pwm;
 input recover_request;
 input rst;
 inout VDD;
 inout VSS;
 input [8:0] duty;

 wire _000_;
 wire _001_;
 wire _002_;
 wire _003_;
 wire _004_;
 wire _005_;
 wire _006_;
 wire _007_;
 wire _008_;
 wire _009_;
 wire _010_;
 wire _011_;
 wire _012_;
 wire _013_;
 wire _014_;
 wire _015_;
 wire _016_;
 wire _017_;
 wire _018_;
 wire _019_;
 wire _020_;
 wire _021_;
 wire _022_;
 wire _023_;
 wire _024_;
 wire _025_;
 wire _026_;
 wire _027_;
 wire _028_;
 wire _029_;
 wire _030_;
 wire _031_;
 wire _032_;
 wire _033_;
 wire _034_;
 wire _035_;
 wire _036_;
 wire _037_;
 wire _038_;
 wire _039_;
 wire _040_;
 wire _041_;
 wire _042_;
 wire _043_;
 wire _044_;
 wire _045_;
 wire _046_;
 wire _047_;
 wire _048_;
 wire _049_;
 wire _050_;
 wire _051_;
 wire _052_;
 wire _053_;
 wire _054_;
 wire _055_;
 wire _056_;
 wire _057_;
 wire _058_;
 wire _059_;
 wire _060_;
 wire _061_;
 wire _062_;
 wire _063_;
 wire _064_;
 wire _065_;
 wire _066_;
 wire _067_;
 wire _068_;
 wire _069_;
 wire _070_;
 wire _071_;
 wire _072_;
 wire _073_;
 wire _074_;
 wire _075_;
 wire _076_;
 wire net1;
 wire net2;
 wire net3;
 wire net4;
 wire net5;
 wire net6;
 wire net7;
 wire net8;
 wire net9;
 wire net10;
 wire net11;
 wire net14;
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
    .Z(net18),
    .VDD(VDD),
    .VNW(VDD),
    .VPW(VSS),
    .VSS(VSS));
 gf180mcu_fd_sc_mcu7t5v0__buf_2 output14 (.I(net14),
    .Z(permit),
    .VDD(VDD),
    .VNW(VDD),
    .VPW(VSS),
    .VSS(VSS));
 gf180mcu_fd_sc_mcu7t5v0__buf_2 output15 (.I(net15),
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
