Kevin-Kaiyo/open-microled-driver-asic/(commit log)

2026-10-03 Establish reproducible one-pixel RTL and GF180 transistor simulation
    [edge-duty064.csv, metrics.csv, waveform-duty064.csv]
2026-10-03 Add single-pixel physical evidence and teaching materials
2026-10-03 Advance one-pixel v0.2 with measured LED and physical PWM evidence
    Resize the current mirror and rerun analog layout, RC extraction and coupled checks. Add traceable static LED data, reference and mismatch studies, registered PWM synthesis, routed digital timing and SDF replay, and the updated 11-page teaching research report.
    [actual-w20-l4-mc-conditional_high.csv, actual-w20-l4-mc-conditional_low.csv, actual-w20-l4-mc-global_and_local.csv, actual-w20-l4-mc-local_only.csv, actual-w20-l4-mc-reference_nominal_and_global_local.csv, actual-w20-l4-reference-pvt.csv, candidate-w20-l4-mc-conditional_high.csv, candidate-w20-l4-mc-conditional_low.csv]
2026-10-04 Integrate one-pixel macros and validate transistor output interface
    [ac.csv, dc.csv, input-charge.csv, nominal-pulse.csv, slew-budget.csv, transients.csv]
2026-10-04 Extract joint pixel parasitics and deepen validation and teaching report
    [boundary-dc.csv, boundary-transients.csv, budget.csv, main-dc.csv, main-transients.csv, nominal-lowest-pulse.csv, probe-dc.csv, probe-transients.csv]
2026-10-07 Implement traceable frame control and one-pixel electrical replay
    [frame-metrics.csv]
2026-10-24 Validate PWM and NRZ supply, resistor and package robustness
2026-10-24 Validate PWM reference startup and real-reference NRZ B macro
2026-10-24 Verify reference-stage Release recovery and preserve backup receipts
2026-10-25 Review display and optical drivers without preselecting a winning architecture
2026-10-25 Compare matched A/B/C MicroLED drivers with traceable transistor evidence
2026-10-25 Record verified fair-driver release and fresh-checkout DC recovery
2026-10-27 Define single-lane over-3Gbps target and document VCSEL driver research
2026-10-27 Diagnose 3.2Gbps MicroLED limits and validate conditional VCSEL driver
2026-10-29 Label r8 circuit notes as historical and retract AC margin interpretation
2026-10-29 Document MicroLED device bandwidth tradeoffs and 3.2 Gb/s co-design plan
2026-10-29 Record verified MicroLED device-study delivery
2026-10-29 Include measured-study LED-only energy figures with their accounting limits
2026-10-29 Refresh final device-study remote readback receipt
2026-11-10 Map blue emitter evidence and verify driver speed envelopes
2026-11-10 Record verified blue emitter stage release and raw data readback
2026-11-10 Validate A/B and VCSEL driver improvements with causal experiments
2026-11-10 Record verified driver improvement release and remote readback
2026-11-11 Validate new MicroLED and VCSEL driver methods and product roadmap
2026-11-11 Record verified second-edition driver release and remote readback
